nsaspook/wbz451matter/BOM/02-00307-R7_BOM.xls

Sheet: BOM Report
Bill of Materials |  | WBZ451 CURIOSITY BOARD
Document Number: | 02-00307 |  |  |  |  | M
PCB Number: | 04-11423
Part Number: | EV96B94A
Revision: | 7.0
Engineer: | RINU CLEETUS
Drawn By: | BALAJI NARAYANA
Creation Date: | 9/27/2022
Creation Time: | 3:30 PM
Quantity | Designator | Description_ | Manufacturer 1 | Manufacturer Part Number 1 | Supplier 1 | Supplier Part Number 1 | Supplier Unit Price 1 | Price / 1 Board | Populated | Quantity | Quantity Override | Status | MCHP-ID | BOM Notes
27 | C1, C2, C3, C4, C12, C13, C16, C17, C19, C20, C21, C22, C23, C24, C25, C27, C38, C39, C40, C52, C54, C57, C62, C72, C73, C74, C77 | CAP CER 0.1µF 16V 10% X5R SMD 0201 | Murata Electronics North America | GRM033R61C104KE84D | Digi-Key | 490-9985-2-ND |  | $0.0000 | YES | 27 | 1 | MCL Design | CAP1559
0 | C5, C8, C28, C35, C50 | CAP CER 0.1uF 10V 10% X5R SMD 0402 | KEMET | C0402C104K8PACTU | Digi-Key | 399-3027-1-ND |  | $0.0000 | DNP | 0 | 1 | MCL Design | CAP0279
18 | C6, C10, C29, C30, C41, C42, C43, C44, C48, C49, C55, C58, C59, C61, C66, C67, C68, C75 | CAP CER 0.1uF 10V 10% X5R SMD 0402 | KEMET | C0402C104K8PACTU | Digi-Key | 399-3027-1-ND |  | $0.0000 | Yes | 18 | 1 | MCL Design | CAP0279
9 | C7, C14, C15, C26, C34, C37, C46, C53, C79 | CAP CER 4.7uF 10V 10% X5R SMD 0402 | TDK Corporation | C1005X5R1A475K050BC | Digi-Key | 445-13820-1-ND |  | $0.0000 | YES | 9 | 1 | MCL Design | CAP1684
2 | C9, C11 | CAP CER 18pF 50V 2% NP0 SMD 0402 | Murata | GRM1555C1H180GA01D | Digi-Key | 490-6204-6-ND |  | $0.0000 | YES | 2 | 1 | MCL Design | CAP1237
1 | C18 | CAP CER 10000pF 16V 10% X7R SMD 0402 | KEMET | C0402C103K4RACTU | Digi-Key | 399-1038-1-ND |  | $0.0000 | YES | 1 | 1 | MCL Design | CAP0278
2 | C31, C56 | CAP CER 10uF 25V 20% X5R SMD 0603 | TDK Corporation | C1608X5R1E106M080AC | Farnell | 2521968 |  | $0.0000 | YES | 2 | 1 | MCL Design | CAP1650
2 | C32, C33 | CAP CER 4.7uF 16V 10% X5R SMD 0603 | TDK Corporation | C1608X5R1C475K080AC | Digi-Key | 445-7478-1-ND |  | $0.0000 | YES | 2 | 1 | MCL Design | CAP1288
2 | C36, C65 | CAP CER 1000pF 50V 10% X7R SMD 0402 | Murata | GRM155R71H102KA01D | Digi-Key | 490-1303-2-ND |  | $0.0000 | Yes | 2 | 1 | MCL Design | CAP1035
0 | C45, C47, C51, C71 | CAP CER 0.01uF 50V 10% X7R SMD 0402 | TDK Corporation | CGA2B3X7R1H103K050BB | Digi-Key | 445-6893-1-ND |  | $0.0000 | DNP | 0 | 1 | MCL Design | CAP2026
3 | C60, C69, C70 | CAP CER 10000pF 50V 10% X7R SMD 0402 AEC-Q200 | Murata Electronics North America | GCM155R71H103KA55D | Digi-Key | 490-4762-1-ND |  | $0.0000 | YES | 3 | 1 | MCL Design | CAP2026
1 | C63 | CAP CER 10pF 25V 0.5pF C0G SMD 0201 | TDK Corporation | C0603C0G1E100D030BA | Digi-Key | 445-4651-2-ND |  | $0.0000 | YES | 1 | 1 | MCL Design | CAP1453
0 | C64 | CAP CER 10uF 10V X5R SMD 0402 | Samsung Electro-Mechanics | CL05A106MP8NUB8 | Digi-Key | 1276-6830-1-ND |  | $0.0000 | DNP | 0 | 1 | MCL Design | CAP2083
1 | C76 | CAP CER 22uF 16V 10% X5R SMD 0805 | TDK | C2012X5R1C226K125AC | Digi-Key | 445-6797-2-ND |  | $0.0000 | Yes | 1 | 1 | MCL Design | CAP0627
0 | C78 | CAP CER 0.1µF 16V 10% X5R SMD 0201 | Murata Electronics North America | GRM033R61C104KE84D | Digi-Key | 490-9985-2-ND |  | $0.0000 | DNP | 0 | 1 | MCL Design | CAP1559
1 | D1 | DIO LED GREEN 2V 30mA 35mcd Clear SMD 0603 | Lite-On Inc | LTST-C191KGKT | Digi-Key | 160-1446-1-ND |  | $0.0000 | YES | 1 | 1 | MCL Design | DIODE1155
1 | D2 | DIO LED YELLOW 2.1V 20mA 6mcd Clear SMD 0603 | Lite-On | LTST-C190YKT | Digi-Key | 160-1184-2-ND |  | $0.0000 | YES | 1 | 1 | MCL Design | LED1002
1 | D5 | DIO LED BLUE 2.85V 5mA 49.5mcd Diffuse SMD 470nm | OSRAM Opto Semiconductors Inc. | LB QH9G-N1OO-35-1 | Digi-Key | 475-3112-1-ND |  | $0.0000 | YES | 1 | 1 | MCL Design | DIODE1359
1 | D6 | DIO LED TRI 2.2V Red, 3.3V Green, 3.3V Blue 6-SMD | Lite-On Inc. | LTST-G563EGBW | Digi-Key | 160-2228-2-ND |  | $0.0000 | YES | 1 | 1 | MCL Design | LED1106
2 | FB1, FB2 | FERRITE 2A 600R SMD 0805 | TDK Corporation | MPZ2012S601AT000 | Digi-Key | 445-2206-1-ND |  | $0.0000 | YES | 2 | 1 | MCL Design | IND1162
1 | FB3 | FERRITE 2A 220R SMD 0805 | Murata Electronics North America | BLM21PG221SN1D | Digi-Key | 490-1054-1-ND |  | $0.0000 | YES | 1 | 1 | MCL Design | IND1092
0 | J2 | CON HDR-1.27 Male 1x2 Gold TH VERT | Digikey | 952-3598-ND | Digikey | 952-3598-ND |  | $0.0000 | DNP | 0 | 1 | MCL Design | CON1390
1 | J3 | CON HDR-2 Male 1x2 SHROUD 3.3MH TH R/A | JST Sales America Inc. | S2B-PH-K-S(LF)(SN) | Digi-Key | 455-1719-ND |  | $0.0000 | YES | 1 | 1 | MCL Design | CON1718
2 | J4 | SOCKET mikroBUS HOST DIP 16 TH | Sullins Connector Solutions | PPTC081LFBN-RC | Digi-Key | S7006-ND |  | $0.0000 | YES | 1 | 2 | MCL Design | SKT1042
2 | J5, J6 | CON HDR-2.54 Male 1x2 Gold 5.84MH TH VERT | FCI | 77311-118-02LF | Digi-Key | 609-4434-ND |  | $0.0000 | Yes | 2 | 1 | MCL Design | CON1108
1 | J7 | CON USB2.0 MICRO-B FEMALE TH/SMD R/A | FCI | 10118194-0001LF | Digi-Key | 609-4618-1-ND |  | $0.0000 | YES | 1 | 1 | MCL Design | CON1383
0 | J9 | CON STRIP Stacker Male 1x9 TH VERT | Samtec | DWM-09-59-S-S-415 | Samtec | DWM-09-59-S-S-415 |  | $0.0000 | DNP | 0 | 1 | MCL Design | CON0512
1 | J36 | CON HDR-1.27 Male 2x5 Gold 3.05MH TH VERT | Amphenol FCI | 20021111-00010T4LF | Digi-Key | 609-3712-ND |  | $0.0000 | YES | 1 | 1 | MCL Design | CON1497
1 | JP1 | MECH HW JUMPER 2.54mm 1x2 Handle Gold | TE Connectivity | 881545-2 | Digi-Key | A26242-ND |  | $0.0000 | MECH | 1 | 1 | MCL Design | HW1100
1 | LABEL1 | LABEL PCBA 18x6mm Datamatrix Assy# / Rev / Serial / Date | ACT Logimark AS | 505462 | ACT Logimark AS | 505462 |  | $0.0000 | YES | 1 | 1 | MCL Design | 08-10015
1 | LD1 | LED GREEN/RED BICOLOR 0606 | Lite-On Inc | LTST-C195KGJRKT | Digi-Key | 160-1452-1-ND |  | $0.0000 | YES | 1 | 1 | MCL Design | LED1047
2 | PAD1, PAD2 | MECH HW RUBBER PAD Cylindrical flat top D8H2.8 Black | 3M | SJ5076BLACK | Farnell | 1165061 |  | $0.0000 | MECH | 2 | 1 | MCL Design | MECH0087
1 | Q1 | TRANS FET P-CH IRLML6402 -20V -3.7A 1.3W SOT-23-3 | International Rectifier | IRLML6402TRPBF | Digi-Key | IRLML6402PBFTR-ND |  | $0.0000 | YES | 1 | 1 | MCL Design | TRA0048
2 | Q2, Q8 | MCHP ANALOG MOSFET N-CH TN2106 60V 280mA 360mW 2.5R SOT23-3 | Microchip Technology | TN2106K1-G | Microchip Technology | TN2106K1-G |  | $0.0000 | YES | 2 | 1 | MCL Design | MIC7420
0 | Q3 | MCHP ANALOG MOSFET N-CH TN2106 60V 280mA 360mW 2.5R SOT23-3 | Microchip Technology | TN2106K1-G | Microchip Technology | TN2106K1-G |  | $0.0000 | DNP | 0 | 1 | MCL Design | MIC7420
3 | Q4, Q5, Q6 | TRANS BJT NPN DUAL BC847BS,115 45V 100mA 300mW SOT-363 | Nexperia USA Inc. | BC847BS,115 | Digi-Key | 1727-2923-1-ND |  | $0.0000 | YES | 3 | 1 | MCL Design | TRA1377
0 | Q7 | TRANS FET P-CH IRLML6402 -20V -3.7A 1.3W SOT-23-3 | International Rectifier | IRLML6402TRPBF | Digi-Key | IRLML6402PBFTR-ND |  | $0.0000 | DNP | 0 | 1 | MCL Design | TRA0048
6 | R1, R2, R3, R4, R53, R62 | RES TKF 22R 1% 1/20W SMD 0402 | Panasonic Electronic Components | ERJ-2RKF22R0X | Digi-Key | P22.0LCT-ND |  | $0.0000 | YES | 6 | 1 | MCL Design | RES1474
33 | R5, R6, R10, R13, R14, R15, R17, R22, R26, R31, R56, R69, R91, R92, R93, R94, R95, R97, R99, R100, R101, R102, R103, R106, R111, R112, R114, R120, R121, R122, R123, R124, R125 | RES TKF 0R 1/16W SMD 0402 | Yageo | RC0402JR-070RL | Digi-Key | 311-0.0JRCT-ND |  | $0.0000 | Yes | 33 | 1 | MCL Design | RSMT1040
2 | R7, R8 | RES TKF 1.2k 5% 1/16W SMD 0402 | ROHM | MCR01MZPJ122 | Digi-Key | RHM1.2KJCT-ND |  | $0.0000 | Yes | 2 | 1 | MCL Design | RSMT0733
10 | R9, R18, R19, R30, R38, R71, R90, R98, R108, R110 | RES TKF 100k 5% 1/16W SMD 0402 | Yageo | RC0402JR-07100KL | Digi-Key | 311-100KJRCT-ND |  | $0.0000 | YES | 10 | 1 | MCL Design | RES2196
11 | R11, R12, R16, R46, R48, R50, R57, R96, R104, R105, R107 | RES TKF 33R 1% 1/16W SMD 0402 | Rohm Semiconductor | MCR01MRTF33R0 | Digi-Key | RHM33.0CDCT-ND |  | $0.0000 | YES | 11 | 1 | MCL Design | RES1478
4 | R20, R27, R42, R87 | RES TKF 1k 5% 1/16W SMD 0402 | Yageo | RC0402JR-071KL | Digi-Key | 311-1.0KJRTR-ND |  | $0.0000 | YES | 4 | 1 | MCL Design | RES2238
6 | R21, R41, R54, R58, R63, R64 | RES TKF 330R 1% 1/16W SMD 0402 | Yageo | RC0402FR-07330RL | Digi-Key | 311-330LRTR-ND |  | $0.0000 | YES | 6 | 1 | MCL Design | RSMT1100
4 | R23, R24, R39, R89 | RES TKF 4.7k 1% 1/16W SMD 0402 | Yageo | RC0402FR-074K7L | Digi-Key | 311-4.7KLRTR-ND |  | $0.0000 | YES | 4 | 1 | MCL Design | RES1813
0 | R25, R32 | RES TKF 0R 1/16W SMD 0402 | Yageo | RC0402JR-070RL | Digi-Key | 311-0.0JRCT-ND |  | $0.0000 | DNP | 0 | 1 | MCL Design | RSMT1040
12 | R28, R29, R35, R68, R76, R78, R84, R115, R116, R117, R118, R119 | RES TKF 10k 5% 1/16W SMD 0402 | Vishay | CRCW040210K0JNED | Digi-Key | 541-10KJCT-ND |  | $0.0000 | Yes | 12 | 1 | MCL Design | RSMT0439
1 | R33 | RES TKF 31.6k 1% 1/10W SMD 0402 | Panasonic | ERJ-2RKF3162X | Digi-Key | P31.6KLCT-ND |  | $0.0000 | Yes | 1 | 1 | MCL Design | RSMT1018
4 | R34, R60, R72, R74 | RES TKF 47k 5% 1/16W SMD 0402 | Yageo | RC0402JR-0747KL | Digi-Key | 311-47KJRCT-ND |  | $0.0000 | Yes | 4 | 1 | MCL Design | RSMT1039
0 | R36 | RES TKF 1R 1% 1/16W SMD 0402 | Yageo Yageo | RC0402FR-071RL | Digi-Key | 311-1.00LRCT-ND |  | $0.0000 | DNP | 0 | 1 | MCL Design | RES1659
1 | R37 | RES TKF 100R 1% 1/10W SMD 0603 | ROHM | MCR03EZPFX1000 | Digi-Key | RHM100HCT-ND |  | $0.0000 | Yes | 1 | 1 | MCL Design | RSMT0696
0 | R40 | RES TKF 22R 1% 1/20W SMD 0402 | Panasonic Electronic Components | ERJ-2RKF22R0X | Digi-Key | P22.0LCT-ND |  | $0.0000 | DNP | 0 | 1 | MCL Design | RES1474
3 | R43, R44, R45 | RES TKF 22k 5% 1/10W SMD 0402 | Panasonic | ERJ-2GEJ223X | Digi-Key | P22KJCT-ND |  | $0.0000 | Yes | 3 | 1 | MCL Design | RSMT0736
6 | R47, R49, R51, R52, R59, R65 | RES TKF 3.3k 1% 1/10W SMD 0402 | Panasonic - ECG | ERJ-2RKF3301X | Digi-Key | P3.30KLTR-ND |  | $0.0000 | YES | 6 | 1 | MCL Design | RES2130
0 | R55, R86 | RES TKF 10k 5% 1/20W SMD 0201 | Yageo | RC0201JR-0710KL | Digi-Key | 311-10KNCT-ND |  | $0.0000 | DNP | 0 | 1 | MCL Design | RES1767
0 | R61, R66 | RES TKF 4.7k 1% 1/16W SMD 0402 | Yageo | RC0402FR-074K7L | Digi-Key | 311-4.7KLRTR-ND |  | $0.0000 | DNP | 0 | 1 | MCL Design | RES1813
0 | R67 | RES TKF 31.6k 1% 1/10W SMD 0402 | Panasonic | ERJ-2RKF3162X | Digi-Key | P31.6KLCT-ND |  | $0.0000 | DNP | 0 | 1 | MCL Design | RSMT1018
0 | R70, R73 | RES TKF 47k 5% 1/16W SMD 0402 | Yageo | RC0402JR-0747KL | Digi-Key | 311-47KJRCT-ND |  | $0.0000 | DNP | 0 | 1 | MCL Design | RSMT1039
1 | R75 | RES TKF 12k 1% 1/16W SMD 0402 | Rohm Semiconductor | MCR01MZPF1202 | Digi-Key | RHM12.0KLCT-ND |  | $0.0000 | YES | 1 | 1 | MCL Design | RES1021
0 | R77 | RES TKF 10k 5% 1/16W SMD 0402 | Vishay | CRCW040210K0JNED | Digi-Key | 541-10KJCT-ND |  | $0.0000 | DNP | 0 | 1 | MCL Design | RSMT0439
1 | R79 | RES TKF 442k 1% 1/16W SMD 0402 | Samsung Electro-Mechanics America, Inc | RC1005F4423CS | Digi-Key | 1276-4257-2-ND |  | $0.0000 | YES | 1 | 1 | MCL Design | RES1506
1 | R80 | RES TKF 95.3k 1% 1/16W SMD 0402 | Rohm Semiconductor | MCR01MRTF9532 | Digi-Key | RHM95.3KCDCT-ND |  | $0.0000 | YES | 1 | 1 | MCL Design | RES1481
1 | R81 | RES TKF 24.3k 1% 1/16W SMD 0402 | Samsung | RC1005F2432CS | Digi-Key | 1276-4149-1-ND |  | $0.0000 | YES | 1 | 1 | MCL Design | RES1483
2 | R82, R85 | RES TKF 5.62k 1% 1/16W SMD 0402 | Vishay Dale | CRCW04025K62FKED | Digi-Key | 541-5.62KLTR-ND |  | $0.0000 | YES | 2 | 1 | MCL Design | RES1505
1 | R83 | RES TKF 270R 5% 1/10W SMD 0402 | Panasonic | ERJ-2GEJ271X | Digi-Key | P270JTR-ND |  | $0.0000 | YES | 1 | 1 | MCL Design | RES1027
1 | R88 | RES TKF 100R 1% 1/16W SMD 0402 | Yageo | RC0402FR-07100RL | Digi-Key | 311-100LRCT-ND |  | $0.0000 | YES | 1 | 1 | MCL Design | RES1587
0 | R109 | RES TKF 10k 5% 1/10W SMD 0402 | Panasonic | ERJ-2GEJ103X | Digi-Key | P10KJCT-ND |  | $0.0000 | DNP | 0 | 1 | MCL Design | RSMT0735
0 | R113 | RES TKF 100k 1% 1/20W SMD 0201 | Panasonic Electronic Components | ERJ-1GEF1003C | Digi-Key | P100KABCT-ND |  | $0.0000 | DNP | 0 | 1 | MCL Design | RES1582
1 | R126 | RES TKF 0R 1/8W SMD 0805 | Panasonic | ERJ-6GEY0R00V | Digi-Key | P0.0ACT-ND |  | $0.0000 | Yes | 1 | 1 | MCL Design | RES1218
2 | SW1, SW2 | SWITCH TACTILE SPST-NO 32V 0.05A KMR221GLFS | C&K | KMR221GLFS | Digi-Key | 401-1427-1-ND |  | $0.0000 | YES | 2 | 1 | MCL Design | SWITCH1176
7 | U1, U2, U4, U5, U14, U15, U16 | IC VOLTAGE TRANSLATOR BI-DIR 1 CIRCUIT 74LVC1T45FW4-7 X2-DFN1010-6 | Diodes Incorporated | 74LVC1T45FW4-7 | Digi-Key | 74LVC1T45FW4-7DICT-ND |  | $0.0000 | YES | 7 | 1 | MCL Design | IC1665
1 | U3 | MCHP ANALOG TEMPERATURE SENSOR -40C to +150C MCP9700AT-E/TT SOT-23-3 | Microchip | MCP9700AT-E/TT | Microchip | MCP9700AT-E/TT |  | $0.0000 | Yes | 1 | 1 | MCL Design | MIC3211
1 | U6 | MOD BLE/ZIGBEE WBZ451PE-I | Microchip Technology | WBZ451PE-I | Microchip Technology | WBZ451PE-I |  | $0.0000 | YES | 1 | 1 | MCL Design | MIC9365
1 | U7 | MCHP SERIAL FLASH SST26VF064B-104I/MF WDFN-8 | Microchip Technology | SST26VF064B-104I/MF | Digi-Key | SST26VF064B-104I/MF-ND |  | $0.0000 | YES | 1 | 1 | MCL Design | MIC8025
1 | U8 | MCHP MEMORY SERIAL EEPROM 256k I2C 24LC256T-E/ST TSSOP-8 | Microchip Technology | 24LC256T-E/ST | Microchip Technology | 24LC256T-E/ST |  | $0.0000 | Yes | 1 | 1 | MCL Design | MIC1360
0 | U9 | MCHP MEMORY SERIAL EEPROM CRYPTO AUTH I2C ATECC608A-MAHDA-T UDFN-8 | Microchip Technology | ATECC608A-MAHDA-T | Digi-Key | ATECC608A-MAHDA-TCT-ND |  | $0.0000 | DNP | 0 | 1 | MCL Design | MIC8128
1 | U10 | MCHP ANALOG LDO 3V MCP1727T-3002E/MF DFN-8 | Microchip | MCP1727T-3002E/MF | Microchip | MCP1727T-3002E/MF |  | $0.0000 | Yes | 1 | 1 | MCL Design | MIC2626
1 | U11 | IC FILTER EMI2124MTTAG COMMON MODE ESD WDFN-8 | ON Semiconductor | EMI2124MTTAG | Digi-Key | EMI2124MTTAGOSCT-ND |  | $0.0000 | YES | 1 | 1 | MCL Design | IC1879
1 | U12 | MCHP ANALOG BATTERY CHARGER MCP73871-2CCI/ML QFN-20 | Microchip | MCP73871-2CCI/ML | Microchip | MCP73871-2CCI/ML |  | $0.0000 | YES | 1 | 1 | MCL Design | MIC3190
1 | U13 | MCHP ANALOG LDO 3.3V MCP1727-3302E/MF | Microchip Technology | MCP1727-3302E/MF | Microchip Technology | MCP1727-3302E/MF |  | $0.0000 | YES | 1 | 1 | MCL Design | MIC6086
1 | U17 | MCHP INTERFACE USB 2.0 HUB CTRLR USB2512B-I/M2 SQFN-36 | Microchip Technology | USB2512B-I/M2 | Microchip Technology | USB2512B-I/M2 |  | $0.0000 | YES | 1 | 1 | MCL Design | MIC8828
1 | U18 | MCHP INTERFACE USB UART MCP2200-I/MQ QFN-20 | Microchip Technology | MCP2200-I/MQ | Digi-Key | MCP2200-I/MQ-ND |  | $0.0000 | YES | 1 | 1 | MCL Design | MIC6326
1 | U19 | MCHP ANALOG POWER SWITCH 5.5V 3A MIC2042-1YTS TSSOP-14 | Microchip Technology | MIC2042-1YTS | Microchip Technology | MIC2042-1YTS |  | $0.0000 | YES | 1 | 1 | MCL Design | MIC6637
1 | U20 | MCHP MCU 32-BIT 300MHz 2MB 384K x 8 ATSAME70N21B-CNT TFBGA-100 | Microchip Technology | ATSAME70N21B-CNT | Microchip Technology | ATSAME70N21B-CNT |  | $0.0000 | YES | 1 | 1 | MCL Design | MIC8829
1 | X1 | RESONATOR 12MHz 0.07% SMD CSTNE 3-SMD | Murata Electronics | CSTNE12M0GH5L000R0 | Digi-Key | 490-17947-1-ND |  | $0.0000 | YES | 1 | 1 | MCL Design | OSC1232
1 | Y1 | CRYSTAL 32.768kHz 12.5pF SMD ABS07 | Seiko | SC32S-12.5PF20PPM | Digi-Key | 728-1073-1-ND |  | $0.0000 | YES | 1 | 1 | MCL Design | OSC1038
1 | Y2 | MCHP CMOS OSCILLATOR 12MHz DSC6011HI1B-012.0000 SMD VFLGA-4 | Microchip Technology | DSC6011HI1B-012.0000 | Microchip Technology | DSC6011HI1B-012.0000 |  | $0.0000 | YES | 1 | 1 | MCL Design | MIC8831
1 | Y3 | MCHP CMOS OSCILLATOR 24MHz DSC6011HI1B-024.0000 SMD VFLGA-4 | Microchip Technology | DSC6011HI1B-024.0000 | Microchip Technology | DSC6011HI1B-024.0000 |  | $0.0000 | YES | 1 | 1 | MCL Design | MIC8830
Microchip Parts listed below
 |  |  |  |  |  |  |  | $0.0000
 |  |  |  |  |  |  |  | $0.0000
 |  |  |  |  |  |  |  | $0.0000
 |  |  |  |  |  |  |  | $0.0000
Mechanical Parts to be added in the package
 |  |  |  |  |  |  |  | $0.0000
PCB
1 | PCB1 | Printed Circuit Board |  | 04-11423-R4.0 |  |  |  | $0.0000 | PCB | 1 | 1 |  | 04-11423
 |  |  |  |  |  |  |  | $0.0000
Do Not Populate Parts listed below
 |  |  |  |  |  |  |  | $0.0000
Approved | Notes | Description

Sheet: Project Information
Project Full Path | D:\WSGA Global\PCB Layout\Chimera\Chimera_WBZ451_EVB\R7.0\DESIGN FILES\WBZ451 Curiosity Board-R7.PrjPcb
Project Filename | WBZ451 Curiosity Board-R7.PrjPcb
Variant Name | Production Variant
PCB Assy Number | 00307
PCB Number | 11423
Data-Source Filename | WBZ451 Curiosity Board-R7.PrjPcb
Data-Source Full Path | D:\WSGA Global\PCB Layout\Chimera\Chimera_WBZ451_EVB\R7.0\DESIGN FILES\WBZ451 Curiosity Board-R7.PrjPcb
Title | WBZ451 CURIOSITY BOARD
Total Quantity | 229
Report Time | 3:30 PM
Report Date | 9/27/2022
Report Date & Tine | 9/27/2022 3:30 PM
Output Name | Bill of Materials
Output Type | BomReport
Output Generator Name | BOM
Output Generator Description | Bill of Materials
PCB Label Number | <Parameter ProjectBoardLabel not found>
Part Number | EV96B94A
SCH Revision | 7.0
ART Revision | 4.0
ASM Revision | 6.0
FAB Revision | 4.0

Sheet: MCL Report
DesignItemId | Quantity | Designator | Populated | Fitted | Description_ | Value | Status | Library Name | PartType | Footprint | MCL Library Ref | MCL Footprint Ref | CurrentDate | Manufacturer 1 | Manufacturer 2 | Manufacturer 3 | Manufacturer 4 | Manufacturer 5 | Manufacturer 6 | Manufacturer 7 | Manufacturer 8 | Manufacturer 9 | #Column Name Error:' Manufacturer 10 | Manufacturer Part Number 1 | Manufacturer Part Number 2 | Manufacturer Part Number 3 | Manufacturer Part Number 4 | Manufacturer Part Number 5 | Manufacturer Part Number 6 | Manufacturer Part Number 7 | Manufacturer Part Number 8 | Manufacturer Part Number 9 | #Column Name Error:' Manufacturer Part Number 10 | Supplier 1 | Supplier 2 | Supplier 3 | Supplier 4 | Supplier 5 | Supplier 6 | Supplier 7 | Supplier 8 | Supplier 9 | #Column Name Error:' Supplier 10 | Supplier Part Number 1 | Supplier Part Number 2 | Supplier Part Number 3 | Supplier Part Number 4 | Supplier Part Number 5 | Supplier Part Number 6 | Supplier Part Number 7 | Supplier Part Number 8 | Supplier Part Number 9 | #Column Name Error:' Supplier Part Number 10 | Supplier Unit Price 1 | Supplier Unit Price 2 | Supplier Unit Price 3 | Supplier Unit Price 4 | Supplier Unit Price 5 | Supplier Unit Price 6
CAP1559 | 27 | C1, C2, C3, C4, C12, C13, C16, C17, C19, C20, C21, C22, C23, C24, C25, C27, C38, C39, C40, C52, C54, C57, C62, C72, C73, C74, C77 | YES | Fitted | CAP CER 0.1µF 16V 10% X5R SMD 0201 | 0.1uF | MCL Design | MCHP-CDB.DbLib | Capacitor NP | CAP_C_0201 |  |  | 9/27/2022 | Murata Electronics North America |  |  |  |  |  |  |  |  |  | GRM033R61C104KE84D |  |  |  |  |  |  |  |  |  | Digi-Key |  |  |  |  |  |  |  |  |  | 490-9985-2-ND
CAP0279 | 0 | C5, C8, C28, C35, C50 | DNP | Not Fitted | CAP CER 0.1uF 10V 10% X5R SMD 0402 | 0.1uF | MCL Design | MCHP-CDB.DbLib | Capacitor NP | CAP_C_0402 |  |  | 9/27/2022 | KEMET | Murata | KEMET |  |  |  |  |  |  |  | C0402C104K8PACTU | GRM155R61A104KA01D | C0402C104K8PAC |  |  |  |  |  |  |  | Digi-Key | Digi-Key | KEMET |  |  |  |  |  |  |  | 399-3027-1-ND | 490-1318-2-ND | C0402C104K8PAC
CAP0279 | 18 | C6, C10, C29, C30, C41, C42, C43, C44, C48, C49, C55, C58, C59, C61, C66, C67, C68, C75 | Yes | Fitted | CAP CER 0.1uF 10V 10% X5R SMD 0402 | 0.1uF | MCL Design | MCHP-CDB.DbLib | Capacitor NP | CAP_C_0402 |  |  | 9/27/2022 | KEMET | Murata | KEMET |  |  |  |  |  |  |  | C0402C104K8PACTU | GRM155R61A104KA01D | C0402C104K8PAC |  |  |  |  |  |  |  | Digi-Key | Digi-Key | KEMET |  |  |  |  |  |  |  | 399-3027-1-ND | 490-1318-2-ND | C0402C104K8PAC
CAP1684 | 9 | C7, C14, C15, C26, C34, C37, C46, C53, C79 | YES | Fitted | CAP CER 4.7uF 10V 10% X5R SMD 0402 | 4.7uF | MCL Design | MCHP-CDB.DbLib | Capacitor NP | CAP_C_0402 |  |  | 9/27/2022 | TDK Corporation |  |  |  |  |  |  |  |  |  | C1005X5R1A475K050BC |  |  |  |  |  |  |  |  |  | Digi-Key |  |  |  |  |  |  |  |  |  | 445-13820-1-ND
CAP1237 | 2 | C9, C11 | YES | Fitted | CAP CER 18pF 50V 2% NP0 SMD 0402 | 18pF | MCL Design | MCHP-CDB.DbLib | Capacitor NP | CAP_C_0402 |  |  | 9/27/2022 | Murata |  |  |  |  |  |  |  |  |  | GRM1555C1H180GA01D |  |  |  |  |  |  |  |  |  | Digi-Key |  |  |  |  |  |  |  |  |  | 490-6204-6-ND
CAP0278 | 1 | C18 | YES | Fitted | CAP CER 10000pF 16V 10% X7R SMD 0402 | 10000pF | MCL Design | MCHP-CDB.DbLib | Capacitor NP | CAP_C_0402 |  |  | 9/27/2022 | KEMET | KEMET |  |  |  |  |  |  |  |  | C0402C103K4RACTU | C0402C103K4RAC |  |  |  |  |  |  |  |  | Digi-Key | KEMET |  |  |  |  |  |  |  |  | 399-1038-1-ND | C0402C103K4RAC
CAP1650 | 2 | C31, C56 | YES | Fitted | CAP CER 10uF 25V 20% X5R SMD 0603 | 10uF | MCL Design | MCHP-CDB.DbLib | Capacitor NP | CAP_C_0603 |  |  | 9/27/2022 | TDK Corporation |  |  |  |  |  |  |  |  |  | C1608X5R1E106M080AC |  |  |  |  |  |  |  |  |  | Farnell |  |  |  |  |  |  |  |  |  | 2521968
CAP1288 | 2 | C32, C33 | YES | Fitted | CAP CER 4.7uF 16V 10% X5R SMD 0603 | 4.7uF | MCL Design | MCHP-CDB.DbLib | Capacitor NP | CAP_C_0603 |  |  | 9/27/2022 | TDK Corporation |  |  |  |  |  |  |  |  |  | C1608X5R1C475K080AC |  |  |  |  |  |  |  |  |  | Digi-Key |  |  |  |  |  |  |  |  |  | 445-7478-1-ND
CAP1035 | 2 | C36, C65 | Yes | Fitted | CAP CER 1000pF 50V 10% X7R SMD 0402 | 1000pF | MCL Design | MCHP-CDB.DbLib | Capacitor NP | CAP_C_0402 |  |  | 9/27/2022 | Murata |  |  |  |  |  |  |  |  |  | GRM155R71H102KA01D |  |  |  |  |  |  |  |  |  | Digi-Key |  |  |  |  |  |  |  |  |  | 490-1303-2-ND
CAP2026 | 0 | C45, C47, C51, C71 | DNP | Not Fitted | CAP CER 0.01uF 50V 10% X7R SMD 0402 | 0.01uF | MCL Design | MCHP-CDB.DbLib | Capacitor NP | CAP_C_0402 |  |  | 9/27/2022 | TDK Corporation |  |  |  |  |  |  |  |  |  | CGA2B3X7R1H103K050BB |  |  |  |  |  |  |  |  |  | Digi-Key |  |  |  |  |  |  |  |  |  | 445-6893-1-ND
CAP2026 | 3 | C60, C69, C70 | YES | Fitted | CAP CER 10000pF 50V 10% X7R SMD 0402 AEC-Q200 | 10000pF | MCL Design | MCHP-CDB.DbLib | Capacitor NP | CAP_C_0402 |  |  | 9/27/2022 | Murata Electronics North America | TDK Corporation |  |  |  |  |  |  |  |  | GCM155R71H103KA55D | CGA2B3X7R1H103K050BB |  |  |  |  |  |  |  |  | Digi-Key | Digi-Key |  |  |  |  |  |  |  |  | 490-4762-1-ND | 445-6893-1-ND
CAP1453 | 1 | C63 | YES | Fitted | CAP CER 10pF 25V 0.5pF C0G SMD 0201 | 10pF | MCL Design | MCHP-CDB.DbLib | Capacitor NP | CAP_C_0201 |  |  | 9/27/2022 | TDK Corporation |  |  |  |  |  |  |  |  |  | C0603C0G1E100D030BA |  |  |  |  |  |  |  |  |  | Digi-Key |  |  |  |  |  |  |  |  |  | 445-4651-2-ND
CAP2083 | 0 | C64 | DNP | Not Fitted | CAP CER 10uF 10V X5R SMD 0402 | 10uF | MCL Design | MCHP-CDB.DbLib | Capacitor NP | CAP_C_0402 |  |  | 9/27/2022 | Samsung Electro-Mechanics |  |  |  |  |  |  |  |  |  | CL05A106MP8NUB8 |  |  |  |  |  |  |  |  |  | Digi-Key |  |  |  |  |  |  |  |  |  | 1276-6830-1-ND
CAP0627 | 1 | C76 | Yes | Fitted | CAP CER 22uF 16V 10% X5R SMD 0805 | 22uF | MCL Design | MCHP-CDB.DbLib | Capacitor NP | CAP_C_0805 |  |  | 9/27/2022 | TDK |  |  |  |  |  |  |  |  |  | C2012X5R1C226K125AC |  |  |  |  |  |  |  |  |  | Digi-Key |  |  |  |  |  |  |  |  |  | 445-6797-2-ND
CAP1559 | 0 | C78 | DNP | Not Fitted | CAP CER 0.1µF 16V 10% X5R SMD 0201 | 0.1uF | MCL Design | MCHP-CDB.DbLib | Capacitor NP | CAP_C_0201 |  |  | 9/27/2022 | Murata Electronics North America |  |  |  |  |  |  |  |  |  | GRM033R61C104KE84D |  |  |  |  |  |  |  |  |  | Digi-Key |  |  |  |  |  |  |  |  |  | 490-9985-2-ND
DIODE1155 | 1 | D1 | YES | Fitted | DIO LED GREEN 2V 30mA 35mcd Clear SMD 0603 | GREEN | MCL Design | MCHP-CDB.DbLib | LED_green | LED_0603_GREEN |  |  | 9/27/2022 | Lite-On Inc | Ledtech |  |  |  |  |  |  |  |  | LTST-C191KGKT | LT8A23-54-SB96-T5 |  |  |  |  |  |  |  |  | Digi-Key | Raynen |  |  |  |  |  |  |  |  | 160-1446-1-ND | LEDD00036B01
LED1002 | 1 | D2 | YES | Fitted | DIO LED YELLOW 2.1V 20mA 6mcd Clear SMD 0603 | YELLOW | MCL Design | MCHP-CDB.DbLib | LED_yellow | LED_0603_Yellow |  |  | 9/27/2022 | Lite-On |  |  |  |  |  |  |  |  |  | LTST-C190YKT |  |  |  |  |  |  |  |  |  | Digi-Key |  |  |  |  |  |  |  |  |  | 160-1184-2-ND
DIODE1359 | 1 | D5 | YES | Fitted | DIO LED BLUE 2.85V 5mA 49.5mcd Diffuse SMD 470nm | Blue | MCL Design | MCHP-CDB.DbLib | LED_blue | LED_0402_Blue |  |  | 9/27/2022 | OSRAM Opto Semiconductors Inc. |  |  |  |  |  |  |  |  |  | LB QH9G-N1OO-35-1 |  |  |  |  |  |  |  |  |  | Digi-Key |  |  |  |  |  |  |  |  |  | 475-3112-1-ND
LED1106 | 1 | D6 | YES | Fitted | DIO LED TRI 2.2V Red, 3.3V Green, 3.3V Blue 6-SMD | LTST-G563EGBW | MCL Design | MCHP-CDB.DbLib | LED_TRI_LTST-G563EGBW | LED_Lite-On Inc_LTST-G563EGBW |  |  | 9/27/2022 | Lite-On Inc. |  |  |  |  |  |  |  |  |  | LTST-G563EGBW |  |  |  |  |  |  |  |  |  | Digi-Key |  |  |  |  |  |  |  |  |  | 160-2228-2-ND
IND1162 | 2 | FB1, FB2 | YES | Fitted | FERRITE 2A 600R SMD 0805 | 600R | MCL Design | MCHP-CDB.DbLib | Ferrite Bead | IND_C_0805 |  |  | 9/27/2022 | TDK Corporation |  |  |  |  |  |  |  |  |  | MPZ2012S601AT000 |  |  |  |  |  |  |  |  |  | Digi-Key |  |  |  |  |  |  |  |  |  | 445-2206-1-ND
IND1092 | 1 | FB3 | YES | Fitted | FERRITE 2A 220R SMD 0805 | 220R | MCL Design | MCHP-CDB.DbLib | Ferrite Bead | IND_C_0805 |  |  | 9/27/2022 | Murata Electronics North America |  |  |  |  |  |  |  |  |  | BLM21PG221SN1D |  |  |  |  |  |  |  |  |  | Digi-Key |  |  |  |  |  |  |  |  |  | 490-1054-1-ND
CON1390 | 0 | J2 | DNP | Not Fitted | CON HDR-1.27 Male 1x2 Gold TH VERT | HDR-1.27 Male 1x2 | MCL Design | MCHP-CDB.DbLib | Header 1x2 | HDR_M_1.27_1x2_TH_GRPB021VWVN-RC |  |  | 9/27/2022 | Digikey |  |  |  |  |  |  |  |  |  | 952-3598-ND |  |  |  |  |  |  |  |  |  | Digikey |  |  |  |  |  |  |  |  |  | 952-3598-ND
CON1718 | 1 | J3 | YES | Fitted | CON HDR-2 Male 1x2 SHROUD 3.3MH TH R/A | HDR-2 Male 1x2 | MCL Design | MCHP-CDB.DbLib | Header 1x2 | HDR_M_2_1X2_THT_RA_S2B-PH-K-S |  |  | 9/27/2022 | JST Sales America Inc. |  |  |  |  |  |  |  |  |  | S2B-PH-K-S(LF)(SN) |  |  |  |  |  |  |  |  |  | Digi-Key |  |  |  |  |  |  |  |  |  | 455-1719-ND
SKT1042 | 1 | J4 | YES | Fitted | SOCKET mikroBUS HOST DIP 16 TH | mikroBUS HOST | MCL Design | MCHP-CDB.DbLib | SOCKET mikroBUS HOST | SOCKET_mikroBUS_F_2.54_2x8_V_25.4x21 |  |  | 9/27/2022 | Sullins Connector Solutions | Nextron |  |  |  |  |  |  |  |  | PPTC081LFBN-RC | R-212-0810-0071-000 |  |  |  |  |  |  |  |  | Digi-Key | Raynen |  |  |  |  |  |  |  |  | S7006-ND | Nextron R-212-0810-0071-000
CON1108 | 2 | J5, J6 | Yes | Fitted | CON HDR-2.54 Male 1x2 Gold 5.84MH TH VERT | HDR-2.54 Male 1x2 | MCL Design | MCHP-CDB.DbLib | Header 1x2 | HDR_M_2.54_1x2 |  |  | 9/27/2022 | FCI | FCI | FCI | Samtec | Sullins | SPC Technology | Samtec | Nextron | Samtec |  | 77311-118-02LF | 68001-202HLF | 68000-202HLF | TSW-102-07-G-S | PBC02SAAN | SPC20481 | TSW-102-07-F-S | R-211-0211-0021-000 | TSW-102-07-S-S |  | Digi-Key | Digi-Key | Digi-Key | Digi-Key | Digi-Key | Newark | Newark | Raynen | Samtec |  | 609-4434-ND | 609-3469-ND | 609-3502-ND | SAM1029-02-ND | S1011E-02-ND | 93K5734 | 79P3146 | R-211-0211-0021-000 | TSW-102-07-S-S
CON1383 | 1 | J7 | YES | Fitted | CON USB2.0 MICRO-B FEMALE TH/SMD R/A | USB2.0 MICRO-B FEMALE | MCL Design | MCHP-CDB.DbLib | CON USB2.0 Mini_Micro | CON_USB_Micro-AB_SMD_TH_RA_FCI_10118194-0001LF |  |  | 9/27/2022 | FCI | YangMing |  |  |  |  |  |  |  |  | 10118194-0001LF | YM-02-363-N05F |  |  |  |  |  |  |  |  | Digi-Key | Raynen |  |  |  |  |  |  |  |  | 609-4618-1-ND | YangMing YM-02-363-N05F
CON0512 | 0 | J9 | DNP | Not Fitted | CON STRIP Stacker Male 1x9 TH VERT | Test Point Array 1x9 | MCL Design | MCHP-CDB.DbLib | Header 1x9 | HDR_M_1.27_1x9 |  |  | 9/27/2022 | Samtec |  |  |  |  |  |  |  |  |  | DWM-09-59-S-S-415 |  |  |  |  |  |  |  |  |  | Samtec |  |  |  |  |  |  |  |  |  | DWM-09-59-S-S-415
CON1497 | 1 | J36 | YES | Fitted | CON HDR-1.27 Male 2x5 Gold 3.05MH TH VERT | HDR-1.27 Male 2x5 | MCL Design | MCHP-CDB.DbLib | Header 2x5 | HDR_M_1.27_2x5_TH_V_FCI_20021111-00010T4LF |  |  | 9/27/2022 | Amphenol FCI |  |  |  |  |  |  |  |  |  | 20021111-00010T4LF |  |  |  |  |  |  |  |  |  | Digi-Key |  |  |  |  |  |  |  |  |  | 609-3712-ND
HW1100 | 1 | JP1 | MECH | Fitted | MECH HW JUMPER 2.54mm 1x2 Handle Gold | Shunt 2.54mm 1x2 Handle | MCL Design | MCHP-CDB.DbLib | Jumper Mechanical | Jumper_W_Handle_Mechanical |  |  | 9/27/2022 | TE Connectivity | WCON |  |  |  |  |  |  |  |  | 881545-2 | 3730-1301OS0B01 |  |  |  |  |  |  |  |  | Digi-Key | Raynen |  |  |  |  |  |  |  |  | A26242-ND | CONN00060D01M
08-10015 | 1 | LABEL1 | YES | Fitted | LABEL PCBA 18x6mm Datamatrix Assy# / Rev / Serial / Date | PCBA LABEL 18X6mm | MCL Design | MCHP-CDB.DbLib | 08-10015 | 08-10015 |  |  | 9/27/2022 | ACT Logimark AS | MicrochipTechnology Inc | Sunrise Paper (M) Sdn Bhd |  |  |  |  |  |  |  | 505462 | 01000-004967 | 037268-5 |  |  |  |  |  |  |  | ACT Logimark AS | MicrochipTechnology Inc | Sunrise Paper (M) Sdn Bhd |  |  |  |  |  |  |  | 505462 | 01000-004967 | 037268-5
LED1047 | 1 | LD1 | YES | Fitted | LED GREEN/RED BICOLOR 0606 | RED, GREEN | MCL Design | MCHP-CDB.DbLib | LED DUAL R_G 0606 | LED_0606_Green-Red_Bicolor |  |  | 9/27/2022 | Lite-On Inc |  |  |  |  |  |  |  |  |  | LTST-C195KGJRKT |  |  |  |  |  |  |  |  |  | Digi-Key |  |  |  |  |  |  |  |  |  | 160-1452-1-ND
MECH0087 | 2 | PAD1, PAD2 | MECH | Fitted | MECH HW RUBBER PAD Cylindrical flat top D8H2.8 Black | RUBBER PAD D8H2.8 | MCL Design | MCHP-CDB.DbLib | Rubber Pad Cylindrical Taper | BUMP_3M_SJ5076_CYLINDRICAL_BLACK_D8H2.8 |  |  | 9/27/2022 | 3M |  |  |  |  |  |  |  |  |  | SJ5076BLACK |  |  |  |  |  |  |  |  |  | Farnell | Newark |  |  |  |  |  |  |  |  | 1165061 | 23M7324
TRA0048 | 1 | Q1 | YES | Fitted | TRANS FET P-CH IRLML6402 -20V -3.7A 1.3W SOT-23-3 | IRLML6402 | MCL Design | MCHP-CDB.DbLib | Transistor MOS-P GSD | SOT-23-3 |  |  | 9/27/2022 | International Rectifier | International Rectifier |  |  |  |  |  |  |  |  | IRLML6402TRPBF | IRLML6402TR |  |  |  |  |  |  |  |  | Digi-Key | Digi-Key |  |  |  |  |  |  |  |  | IRLML6402PBFTR-ND | IRLML6402TR-ND
MIC7420 | 2 | Q2, Q8 | YES | Fitted | MCHP ANALOG MOSFET N-CH TN2106 60V 280mA 360mW 2.5R SOT23-3 | TN2106 | MCL Design | MCHP-CDB.DbLib | Transistor MOS-N GSD | SOT-23-3 |  |  | 9/27/2022 | Microchip Technology |  |  |  |  |  |  |  |  |  | TN2106K1-G |  |  |  |  |  |  |  |  |  | Microchip Technology |  |  |  |  |  |  |  |  |  | TN2106K1-G
MIC7420 | 0 | Q3 | DNP | Not Fitted | MCHP ANALOG MOSFET N-CH TN2106 60V 280mA 360mW 2.5R SOT23-3 | TN2106 | MCL Design | MCHP-CDB.DbLib | Transistor MOS-N GSD | SOT-23-3 |  |  | 9/27/2022 | Microchip Technology |  |  |  |  |  |  |  |  |  | TN2106K1-G |  |  |  |  |  |  |  |  |  | Microchip Technology |  |  |  |  |  |  |  |  |  | TN2106K1-G
TRA1377 | 3 | Q4, Q5, Q6 | YES | Fitted | TRANS BJT NPN DUAL BC847BS,115 45V 100mA 300mW SOT-363 | BC847BS,115 | MCL Design | MCHP-CDB.DbLib | Transistor Dual NPN | SOT-363 |  |  | 9/27/2022 | Nexperia USA Inc. |  |  |  |  |  |  |  |  |  | BC847BS,115 |  |  |  |  |  |  |  |  |  | Digi-Key |  |  |  |  |  |  |  |  |  | 1727-2923-1-ND
TRA0048 | 0 | Q7 | DNP | Not Fitted | TRANS FET P-CH IRLML6402 -20V -3.7A 1.3W SOT-23-3 | IRLML6402 | MCL Design | MCHP-CDB.DbLib | Transistor MOS-P GSD | SOT-23-3 |  |  | 9/27/2022 | International Rectifier | International Rectifier |  |  |  |  |  |  |  |  | IRLML6402TRPBF | IRLML6402TR |  |  |  |  |  |  |  |  | Digi-Key | Digi-Key |  |  |  |  |  |  |  |  | IRLML6402PBFTR-ND | IRLML6402TR-ND
RES1474 | 6 | R1, R2, R3, R4, R53, R62 | YES | Fitted | RES TKF 22R 1% 1/20W SMD 0402 | 22R | MCL Design | MCHP-CDB.DbLib | Resistor | RES_C_0402 |  |  | 9/27/2022 | Panasonic Electronic Components |  |  |  |  |  |  |  |  |  | ERJ-2RKF22R0X |  |  |  |  |  |  |  |  |  | Digi-Key |  |  |  |  |  |  |  |  |  | P22.0LCT-ND
RSMT1040 | 33 | R5, R6, R10, R13, R14, R15, R17, R22, R26, R31, R56, R69, R91, R92, R93, R94, R95, R97, R99, R100, R101, R102, R103, R106, R111, R112, R114, R120, R121, R122, R123, R124, R125 | Yes | Fitted | RES TKF 0R 1/16W SMD 0402 | 0R | MCL Design | MCHP-CDB.DbLib | Resistor | RES_C_0402 |  |  | 9/27/2022 | Yageo |  |  |  |  |  |  |  |  |  | RC0402JR-070RL |  |  |  |  |  |  |  |  |  | Digi-Key |  |  |  |  |  |  |  |  |  | 311-0.0JRCT-ND
RSMT0733 | 2 | R7, R8 | Yes | Fitted | RES TKF 1.2k 5% 1/16W SMD 0402 | 1.2k | MCL Design | MCHP-CDB.DbLib | Resistor | RES_C_0402 |  |  | 9/27/2022 | ROHM |  |  |  |  |  |  |  |  |  | MCR01MZPJ122 |  |  |  |  |  |  |  |  |  | Digi-Key |  |  |  |  |  |  |  |  |  | RHM1.2KJCT-ND
RES2196 | 10 | R9, R18, R19, R30, R38, R71, R90, R98, R108, R110 | YES | Fitted | RES TKF 100k 5% 1/16W SMD 0402 | 100k | MCL Design | MCHP-CDB.DbLib | Resistor | RES_C_0402 |  |  | 9/27/2022 | Yageo |  |  |  |  |  |  |  |  |  | RC0402JR-07100KL |  |  |  |  |  |  |  |  |  | Digi-Key |  |  |  |  |  |  |  |  |  | 311-100KJRCT-ND
RES1478 | 11 | R11, R12, R16, R46, R48, R50, R57, R96, R104, R105, R107 | YES | Fitted | RES TKF 33R 1% 1/16W SMD 0402 | 33R | MCL Design | MCHP-CDB.DbLib | Resistor | RES_C_0402 |  |  | 9/27/2022 | Rohm Semiconductor |  |  |  |  |  |  |  |  |  | MCR01MRTF33R0 |  |  |  |  |  |  |  |  |  | Digi-Key |  |  |  |  |  |  |  |  |  | RHM33.0CDCT-ND
RES2238 | 4 | R20, R27, R42, R87 | YES | Fitted | RES TKF 1k 5% 1/16W SMD 0402 | 1k | MCL Design | MCHP-CDB.DbLib | Resistor | RES_C_0402 |  |  | 9/27/2022 | Yageo |  |  |  |  |  |  |  |  |  | RC0402JR-071KL |  |  |  |  |  |  |  |  |  | Digi-Key |  |  |  |  |  |  |  |  |  | 311-1.0KJRTR-ND
RSMT1100 | 6 | R21, R41, R54, R58, R63, R64 | YES | Fitted | RES TKF 330R 1% 1/16W SMD 0402 | 330R | MCL Design | MCHP-CDB.DbLib | Resistor | RES_C_0402 |  |  | 9/27/2022 | Yageo | Yageo |  |  |  |  |  |  |  |  | RC0402FR-07330RL | RC0402FR-07330RL |  |  |  |  |  |  |  |  | Digi-Key | Digi-Key |  |  |  |  |  |  |  |  | 311-330LRTR-ND | 311-330LRCT-ND
RES1813 | 4 | R23, R24, R39, R89 | YES | Fitted | RES TKF 4.7k 1% 1/16W SMD 0402 | 4.7k | MCL Design | MCHP-CDB.DbLib | Resistor | RES_C_0402 |  |  | 9/27/2022 | Yageo |  |  |  |  |  |  |  |  |  | RC0402FR-074K7L |  |  |  |  |  |  |  |  |  | Digi-Key | Digi-Key |  |  |  |  |  |  |  |  | 311-4.7KLRTR-ND | 311-4.7KLRCT-ND
RSMT1040 | 0 | R25, R32 | DNP | Not Fitted | RES TKF 0R 1/16W SMD 0402 | 0R | MCL Design | MCHP-CDB.DbLib | Resistor | RES_C_0402 |  |  | 9/27/2022 | Yageo |  |  |  |  |  |  |  |  |  | RC0402JR-070RL |  |  |  |  |  |  |  |  |  | Digi-Key |  |  |  |  |  |  |  |  |  | 311-0.0JRCT-ND
RSMT0439 | 12 | R28, R29, R35, R68, R76, R78, R84, R115, R116, R117, R118, R119 | Yes | Fitted | RES TKF 10k 5% 1/16W SMD 0402 | 10k | MCL Design | MCHP-CDB.DbLib | Resistor | RES_C_0402 |  |  | 9/27/2022 | Vishay | Yageo |  |  |  |  |  |  |  |  | CRCW040210K0JNED | RC0402JR-0710KL |  |  |  |  |  |  |  |  | Digi-Key | Digi-Key |  |  |  |  |  |  |  |  | 541-10KJCT-ND | 311-10KJRCT-ND
RSMT1018 | 1 | R33 | Yes | Fitted | RES TKF 31.6k 1% 1/10W SMD 0402 | 31.6k | MCL Design | MCHP-CDB.DbLib | Resistor | RES_C_0402 |  |  | 9/27/2022 | Panasonic |  |  |  |  |  |  |  |  |  | ERJ-2RKF3162X |  |  |  |  |  |  |  |  |  | Digi-Key |  |  |  |  |  |  |  |  |  | P31.6KLCT-ND
RSMT1039 | 4 | R34, R60, R72, R74 | Yes | Fitted | RES TKF 47k 5% 1/16W SMD 0402 | 47k | MCL Design | MCHP-CDB.DbLib | Resistor | RES_C_0402 |  |  | 9/27/2022 | Yageo |  |  |  |  |  |  |  |  |  | RC0402JR-0747KL |  |  |  |  |  |  |  |  |  | Digi-Key |  |  |  |  |  |  |  |  |  | 311-47KJRCT-ND
RES1659 | 0 | R36 | DNP | Not Fitted | RES TKF 1R 1% 1/16W SMD 0402 | 1R | MCL Design | MCHP-CDB-Offline.DbLib | Resistor | RES_C_0402 |  |  | 9/27/2022 | Yageo Yageo |  |  |  |  |  |  |  |  |  | RC0402FR-071RL |  |  |  |  |  |  |  |  |  | Digi-Key |  |  |  |  |  |  |  |  |  | 311-1.00LRCT-ND
RSMT0696 | 1 | R37 | Yes | Fitted | RES TKF 100R 1% 1/10W SMD 0603 | 100R | MCL Design | MCHP-CDB.DbLib | Resistor | RES_C_0603 |  |  | 9/27/2022 | ROHM | Stackpole Electronics Inc |  |  |  |  |  |  |  |  | MCR03EZPFX1000 | RMCF0603FT100R |  |  |  |  |  |  |  |  | Digi-Key | Digi-Key |  |  |  |  |  |  |  |  | RHM100HCT-ND | RMCF1/16100FRCT-ND
RES1474 | 0 | R40 | DNP | Not Fitted | RES TKF 22R 1% 1/20W SMD 0402 | 22R | MCL Design | MCHP-CDB.DbLib | Resistor | RES_C_0402 |  |  | 9/27/2022 | Panasonic Electronic Components |  |  |  |  |  |  |  |  |  | ERJ-2RKF22R0X |  |  |  |  |  |  |  |  |  | Digi-Key |  |  |  |  |  |  |  |  |  | P22.0LCT-ND
RSMT0736 | 3 | R43, R44, R45 | Yes | Fitted | RES TKF 22k 5% 1/10W SMD 0402 | 22k | MCL Design | MCHP-CDB.DbLib | Resistor | RES_C_0402 |  |  | 9/27/2022 | Panasonic |  |  |  |  |  |  |  |  |  | ERJ-2GEJ223X |  |  |  |  |  |  |  |  |  | Digi-Key |  |  |  |  |  |  |  |  |  | P22KJCT-ND
RES2130 | 6 | R47, R49, R51, R52, R59, R65 | YES | Fitted | RES TKF 3.3k 1% 1/10W SMD 0402 | 3.3k | MCL Design | MCHP-CDB.DbLib | Resistor | RES_C_0402 |  |  | 9/27/2022 | Panasonic - ECG |  |  |  |  |  |  |  |  |  | ERJ-2RKF3301X |  |  |  |  |  |  |  |  |  | Digi-Key |  |  |  |  |  |  |  |  |  | P3.30KLTR-ND
RES1767 | 0 | R55, R86 | DNP | Not Fitted | RES TKF 10k 5% 1/20W SMD 0201 | 10k | MCL Design | MCHP-CDB.DbLib | Resistor | RES_C_0201 |  |  | 9/27/2022 | Yageo |  |  |  |  |  |  |  |  |  | RC0201JR-0710KL |  |  |  |  |  |  |  |  |  | Digi-Key |  |  |  |  |  |  |  |  |  | 311-10KNCT-ND
RES1813 | 0 | R61, R66 | DNP | Not Fitted | RES TKF 4.7k 1% 1/16W SMD 0402 | 4.7k | MCL Design | MCHP-CDB.DbLib | Resistor | RES_C_0402 |  |  | 9/27/2022 | Yageo |  |  |  |  |  |  |  |  |  | RC0402FR-074K7L |  |  |  |  |  |  |  |  |  | Digi-Key | Digi-Key |  |  |  |  |  |  |  |  | 311-4.7KLRTR-ND | 311-4.7KLRCT-ND
RSMT1018 | 0 | R67 | DNP | Not Fitted | RES TKF 31.6k 1% 1/10W SMD 0402 | 31.6k | MCL Design | MCHP-CDB.DbLib | Resistor | RES_C_0402 |  |  | 9/27/2022 | Panasonic |  |  |  |  |  |  |  |  |  | ERJ-2RKF3162X |  |  |  |  |  |  |  |  |  | Digi-Key |  |  |  |  |  |  |  |  |  | P31.6KLCT-ND
RSMT1039 | 0 | R70, R73 | DNP | Not Fitted | RES TKF 47k 5% 1/16W SMD 0402 | 47k | MCL Design | MCHP-CDB.DbLib | Resistor | RES_C_0402 |  |  | 9/27/2022 | Yageo |  |  |  |  |  |  |  |  |  | RC0402JR-0747KL |  |  |  |  |  |  |  |  |  | Digi-Key |  |  |  |  |  |  |  |  |  | 311-47KJRCT-ND
RES1021 | 1 | R75 | YES | Fitted | RES TKF 12k 1% 1/16W SMD 0402 | 12k | MCL Design | MCHP-CDB.DbLib | Resistor | RES_C_0402 |  |  | 9/27/2022 | Rohm Semiconductor |  |  |  |  |  |  |  |  |  | MCR01MZPF1202 |  |  |  |  |  |  |  |  |  | Digi-Key |  |  |  |  |  |  |  |  |  | RHM12.0KLCT-ND
RSMT0439 | 0 | R77 | DNP | Not Fitted | RES TKF 10k 5% 1/16W SMD 0402 | 10k | MCL Design | MCHP-CDB.DbLib | Resistor | RES_C_0402 |  |  | 9/27/2022 | Vishay | Yageo |  |  |  |  |  |  |  |  | CRCW040210K0JNED | RC0402JR-0710KL |  |  |  |  |  |  |  |  | Digi-Key | Digi-Key |  |  |  |  |  |  |  |  | 541-10KJCT-ND | 311-10KJRCT-ND
RES1506 | 1 | R79 | YES | Fitted | RES TKF 442k 1% 1/16W SMD 0402 | 442k | MCL Design | MCHP-CDB.DbLib | Resistor | RES_C_0402 |  |  | 9/27/2022 | Samsung Electro-Mechanics America, Inc |  |  |  |  |  |  |  |  |  | RC1005F4423CS |  |  |  |  |  |  |  |  |  | Digi-Key |  |  |  |  |  |  |  |  |  | 1276-4257-2-ND
RES1481 | 1 | R80 | YES | Fitted | RES TKF 95.3k 1% 1/16W SMD 0402 | 95.3k | MCL Design | MCHP-CDB.DbLib | Resistor | RES_C_0402 |  |  | 9/27/2022 | Rohm Semiconductor |  |  |  |  |  |  |  |  |  | MCR01MRTF9532 |  |  |  |  |  |  |  |  |  | Digi-Key |  |  |  |  |  |  |  |  |  | RHM95.3KCDCT-ND
RES1483 | 1 | R81 | YES | Fitted | RES TKF 24.3k 1% 1/16W SMD 0402 | 24.3k | MCL Design | MCHP-CDB.DbLib | Resistor | RES_C_0402 |  |  | 9/27/2022 | Samsung |  |  |  |  |  |  |  |  |  | RC1005F2432CS |  |  |  |  |  |  |  |  |  | Digi-Key |  |  |  |  |  |  |  |  |  | 1276-4149-1-ND
RES1505 | 2 | R82, R85 | YES | Fitted | RES TKF 5.62k 1% 1/16W SMD 0402 | 5.62k | MCL Design | MCHP-CDB.DbLib | Resistor | RES_C_0402 |  |  | 9/27/2022 | Vishay Dale |  |  |  |  |  |  |  |  |  | CRCW04025K62FKED |  |  |  |  |  |  |  |  |  | Digi-Key |  |  |  |  |  |  |  |  |  | 541-5.62KLTR-ND
RES1027 | 1 | R83 | YES | Fitted | RES TKF 270R 5% 1/10W SMD 0402 | 270R | MCL Design | MCHP-CDB.DbLib | Resistor | RES_C_0402 |  |  | 9/27/2022 | Panasonic |  |  |  |  |  |  |  |  |  | ERJ-2GEJ271X |  |  |  |  |  |  |  |  |  | Digi-Key |  |  |  |  |  |  |  |  |  | P270JTR-ND
RES1587 | 1 | R88 | YES | Fitted | RES TKF 100R 1% 1/16W SMD 0402 | 100R | MCL Design | MCHP-CDB.DbLib | Resistor | RES_C_0402 |  |  | 9/27/2022 | Yageo |  |  |  |  |  |  |  |  |  | RC0402FR-07100RL |  |  |  |  |  |  |  |  |  | Digi-Key |  |  |  |  |  |  |  |  |  | 311-100LRCT-ND
RSMT0735 | 0 | R109 | DNP | Not Fitted | RES TKF 10k 5% 1/10W SMD 0402 | 10k | MCL Design | MCHP-CDB.DbLib | Resistor | RES_C_0402 |  |  | 9/27/2022 | Panasonic |  |  |  |  |  |  |  |  |  | ERJ-2GEJ103X |  |  |  |  |  |  |  |  |  | Digi-Key |  |  |  |  |  |  |  |  |  | P10KJCT-ND
RES1582 | 0 | R113 | DNP | Not Fitted | RES TKF 100k 1% 1/20W SMD 0201 | 100k | MCL Design | MCHP-CDB.DbLib | Resistor | RES_C_0201 |  |  | 9/27/2022 | Panasonic Electronic Components |  |  |  |  |  |  |  |  |  | ERJ-1GEF1003C |  |  |  |  |  |  |  |  |  | Digi-Key |  |  |  |  |  |  |  |  |  | P100KABCT-ND
RES1218 | 1 | R126 | Yes | Fitted | RES TKF 0R 1/8W SMD 0805 | 0R | MCL Design | MCHP-CDB.DbLib | Resistor | RES_C_0805 |  |  | 9/27/2022 | Panasonic |  |  |  |  |  |  |  |  |  | ERJ-6GEY0R00V |  |  |  |  |  |  |  |  |  | Digi-Key |  |  |  |  |  |  |  |  |  | P0.0ACT-ND
SWITCH1176 | 2 | SW1, SW2 | YES | Fitted | SWITCH TACTILE SPST-NO 32V 0.05A KMR221GLFS | Top Actuated Surface Mount | MCL Design | MCHP-CDB.DbLib | Rating: DC 12V 50mA Max 0.1 ohm contact resistance | SW_TACT_KMR2_4.6x2.8 |  |  | 9/27/2022 | C&K |  |  |  |  |  |  |  |  |  | KMR221GLFS |  |  |  |  |  |  |  |  |  | Digi-Key |  |  |  |  |  |  |  |  |  | 401-1427-1-ND
IC1665 | 7 | U1, U2, U4, U5, U14, U15, U16 | YES | Fitted | IC VOLTAGE TRANSLATOR BI-DIR 1 CIRCUIT 74LVC1T45FW4-7 X2-DFN1010-6 | 74LVC1T45FW4-7 | MCL Design | MCHP-CDB.DbLib | 74LVC(H)1T45 SOT-23-6_SC-70-6_SOT-6_SOT-363_DSBGA | X2-DFN1010-6 |  |  | 9/27/2022 | Diodes Incorporated |  |  |  |  |  |  |  |  |  | 74LVC1T45FW4-7 |  |  |  |  |  |  |  |  |  | Digi-Key |  |  |  |  |  |  |  |  |  | 74LVC1T45FW4-7DICT-ND
MIC3211 | 1 | U3 | Yes | Fitted | MCHP ANALOG TEMPERATURE SENSOR -40C to +150C MCP9700AT-E/TT SOT-23-3 | MCP9700A | MCL Design | MCHP-CDB.DbLib | MCP9700(A)_1(A) TO-92-3_SOT-23-3 | SOT-23-3 |  |  | 9/27/2022 | Microchip |  |  |  |  |  |  |  |  |  | MCP9700AT-E/TT |  |  |  |  |  |  |  |  |  | Microchip |  |  |  |  |  |  |  |  |  | MCP9700AT-E/TT
MIC9365 | 1 | U6 | YES | Fitted | MOD BLE/ZIGBEE WBZ451PE-I | WBZ451PE-I | MCL Design | MCHP-CDB.DbLib | WBZ451PE-I | MOD_WBZ451PE-I |  |  | 9/27/2022 | Microchip Technology |  |  |  |  |  |  |  |  |  | WBZ451PE-I |  |  |  |  |  |  |  |  |  | Microchip Technology |  |  |  |  |  |  |  |  |  | WBZ451PE-I
MIC8025 | 1 | U7 | YES | Fitted | MCHP SERIAL FLASH SST26VF064B-104I/MF WDFN-8 | SST26VF064B-104I/MF | MCL Design | MCHP-CDB.DbLib | SST26VF064B-104IMF | WSON-8_6x5_EP3.4X4.0 |  |  | 9/27/2022 | Microchip Technology |  |  |  |  |  |  |  |  |  | SST26VF064B-104I/MF |  |  |  |  |  |  |  |  |  | Digi-Key |  |  |  |  |  |  |  |  |  | SST26VF064B-104I/MF-ND
MIC1360 | 1 | U8 | Yes | Fitted | MCHP MEMORY SERIAL EEPROM 256k I2C 24LC256T-E/ST TSSOP-8 | 24LC256 | MCL Design | MCHP-CDB.DbLib | 24XX01_02_04_08_16_32_64_128_256_512_1025 SOIC-8_SOIJ-8_TSSOP-8_PDIP-8_MSOP-8 | TSSOP-8 |  |  | 9/27/2022 | Microchip Technology |  |  |  |  |  |  |  |  |  | 24LC256T-E/ST |  |  |  |  |  |  |  |  |  | Microchip Technology |  |  |  |  |  |  |  |  |  | 24LC256T-E/ST
MIC8128 | 0 | U9 | DNP | Not Fitted | MCHP MEMORY SERIAL EEPROM CRYPTO AUTH I2C ATECC608A-MAHDA-T UDFN-8 | ATECC608A-MAHDA-T | MCL Design | MCHP-CDB.DbLib | ATECC608A-MAHDA-T UDFN-8 | 8-UDFN |  |  | 9/27/2022 | Microchip Technology |  |  |  |  |  |  |  |  |  | ATECC608A-MAHDA-T |  |  |  |  |  |  |  |  |  | Digi-Key |  |  |  |  |  |  |  |  |  | ATECC608A-MAHDA-TCT-ND
MIC2626 | 1 | U10 | Yes | Fitted | MCHP ANALOG LDO 3V MCP1727T-3002E/MF DFN-8 | MCP1727/3V | MCL Design | MCHP-CDB.DbLib | MCP172X FIX DFN-8 | DFN-8_3x3 |  |  | 9/27/2022 | Microchip | Microchip |  |  |  |  |  |  |  |  | MCP1727T-3002E/MF | MCP1727-3002E/MF |  |  |  |  |  |  |  |  | Microchip | Microchip |  |  |  |  |  |  |  |  | MCP1727T-3002E/MF | MCP1727-3002E/MF
IC1879 | 1 | U11 | YES | Fitted | IC FILTER EMI2124MTTAG COMMON MODE ESD WDFN-8 | EMI2124MTTAG | MCL Design | MCHP-CDB.DbLib | EMI2124 WDF-8 | WDFN-8_EP |  |  | 9/27/2022 | ON Semiconductor |  |  |  |  |  |  |  |  |  | EMI2124MTTAG |  |  |  |  |  |  |  |  |  | Digi-Key |  |  |  |  |  |  |  |  |  | EMI2124MTTAGOSCT-ND
MIC3190 | 1 | U12 | YES | Fitted | MCHP ANALOG BATTERY CHARGER MCP73871-2CCI/ML QFN-20 | MCP73871 | MCL Design | MCHP-CDB.DbLib | MCP73871 QFN-20 | QFN-20_4X4 |  |  | 9/27/2022 | Microchip |  |  |  |  |  |  |  |  |  | MCP73871-2CCI/ML |  |  |  |  |  |  |  |  |  | Microchip |  |  |  |  |  |  |  |  |  | MCP73871-2CCI/ML
MIC6086 | 1 | U13 | YES | Fitted | MCHP ANALOG LDO 3.3V MCP1727-3302E/MF | MCP1727 3.3V | MCL Design | MCHP-CDB.DbLib | MCP172X FIX DFN-8 | DFN-8_3X3 |  |  | 9/27/2022 | Microchip Technology |  |  |  |  |  |  |  |  |  | MCP1727-3302E/MF |  |  |  |  |  |  |  |  |  | Microchip Technology |  |  |  |  |  |  |  |  |  | MCP1727-3302E/MF
MIC8828 | 1 | U17 | YES | Fitted | MCHP INTERFACE USB 2.0 HUB CTRLR USB2512B-I/M2 SQFN-36 | USB2512B-I/M2 | MCL Design | MCHP-CDB.DbLib | USB2512B-I/M2 | QFN-36_6x6_EP3.7x3.7 |  |  | 9/27/2022 | Microchip Technology |  |  |  |  |  |  |  |  |  | USB2512B-I/M2 |  |  |  |  |  |  |  |  |  | Microchip Technology |  |  |  |  |  |  |  |  |  | USB2512B-I/M2
MIC6326 | 1 | U18 | YES | Fitted | MCHP INTERFACE USB UART MCP2200-I/MQ QFN-20 | MCP2200-I/MQ | MCL Design | MCHP-CDB.DbLib | MCP2200 QFN-20 | QFN-20_5X5 |  |  | 9/27/2022 | Microchip Technology |  |  |  |  |  |  |  |  |  | MCP2200-I/MQ |  |  |  |  |  |  |  |  |  | Digi-Key |  |  |  |  |  |  |  |  |  | MCP2200-I/MQ-ND
MIC6637 | 1 | U19 | YES | Fitted | MCHP ANALOG POWER SWITCH 5.5V 3A MIC2042-1YTS TSSOP-14 | MIC2042 | MCL Design | MCHP-CDB.DbLib | MIC2042 | TSSOP-14 |  |  | 9/27/2022 | Microchip Technology |  |  |  |  |  |  |  |  |  | MIC2042-1YTS |  |  |  |  |  |  |  |  |  | Microchip Technology |  |  |  |  |  |  |  |  |  | MIC2042-1YTS
MIC8829 | 1 | U20 | YES | Fitted | MCHP MCU 32-BIT 300MHz 2MB 384K x 8 ATSAME70N21B-CNT TFBGA-100 | ATSAME70N21B-CNT | MCL Design | MCHP-CDB.DbLib | ATSAME70-TFBGA100 | TFBGA-100_P0.8_9x9x1.1 |  |  | 9/27/2022 | Microchip Technology |  |  |  |  |  |  |  |  |  | ATSAME70N21B-CNT |  |  |  |  |  |  |  |  |  | Microchip Technology |  |  |  |  |  |  |  |  |  | ATSAME70N21B-CNT
OSC1232 | 1 | X1 | YES | Fitted | RESONATOR 12MHz 0.07% SMD CSTNE 3-SMD | 12MHz | MCL Design | MCHP-CDB.DbLib | Resonator 3 Pins | RESONATOR_CSTCE-G_L3.2W1.3H0.8 |  |  | 9/27/2022 | Murata Electronics |  |  |  |  |  |  |  |  |  | CSTNE12M0GH5L000R0 |  |  |  |  |  |  |  |  |  | Digi-Key |  |  |  |  |  |  |  |  |  | 490-17947-1-ND
OSC1038 | 1 | Y1 | YES | Fitted | CRYSTAL 32.768kHz 12.5pF SMD ABS07 | 32.768kHz | MCL Design | MCHP-CDB.DbLib | Crystal 2 Pins | CRYSTAL_ABS07 |  |  | 9/27/2022 | Seiko | Abracon | JWT |  |  |  |  |  |  |  | SC32S-12.5PF20PPM | ABS07-32.768KHZ-T | SMD3215-32.768KHZ-1-T;32.768KHz |  |  |  |  |  |  |  | Digi-Key | Digi-Key | Raynen |  |  |  |  |  |  |  | 728-1073-1-ND | 535-9542-1-ND | JWT SMD3215-32.768KHZ-1-T;32.768KHz
MIC8831 | 1 | Y2 | YES | Fitted | MCHP CMOS OSCILLATOR 12MHz DSC6011HI1B-012.0000 SMD VFLGA-4 | 12MHz | MCL Design | MCHP-CDB.DbLib | DSC60xx DFN-4_LGA-4 | OSCILLATOR_DSCxxxxHxxx_L1.6W1.2H0.84 |  |  | 9/27/2022 | Microchip Technology |  |  |  |  |  |  |  |  |  | DSC6011HI1B-012.0000 |  |  |  |  |  |  |  |  |  | Microchip Technology |  |  |  |  |  |  |  |  |  | DSC6011HI1B-012.0000
MIC8830 | 1 | Y3 | YES | Fitted | MCHP CMOS OSCILLATOR 24MHz DSC6011HI1B-024.0000 SMD VFLGA-4 | 24MHz | MCL Design | MCHP-CDB.DbLib | DSC60xx DFN-4_LGA-4 | OSCILLATOR_DSCxxxxHxxx_L1.6W1.2H0.84 |  |  | 9/27/2022 | Microchip Technology |  |  |  |  |  |  |  |  |  | DSC6011HI1B-024.0000 |  |  |  |  |  |  |  |  |  | Microchip Technology |  |  |  |  |  |  |  |  |  | DSC6011HI1B-024.0000
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
