nsaspook/wbz451matter/SST26VF064B-104I_MF/3D/SST26VF064B-104I_MF.stp

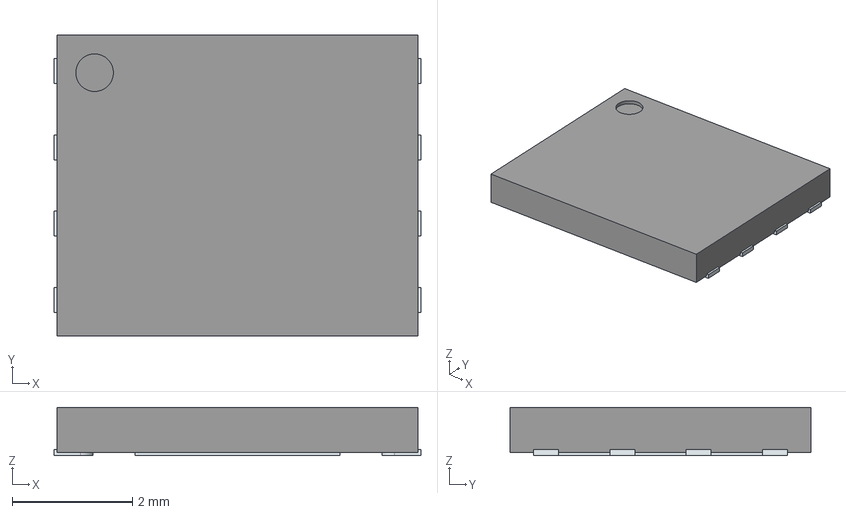
[picture p1: CAD file, 2024-05-31]
SST26VF064B-104I_MF/3D/SST26VF064B-104I_MF.stp
6.10 x 5.00 x 0.8 mm
ThermalPin
PinsArrayLR
