nsaspook/wbz451matter/(list of files, cad)

Other CAD files:
EHF-105-01-L-D-SM-LC/Allegro/ehf-105-01-xx-d-sm-lc.psm
EHF-105-01-L-D-SM-LC/DEHDL/ehf_105_01_l_d_sm_lc/chips/chips.prt
SST26VF064B-104I_MF/Allegro/son127p600x500x80-9n-d.psm
SST26VF064B-104I_MF/DEHDL/sst26vf064b_104i_mf/chips/chips.prt
