nsaspook/wbz451matter/Schematics/03-00307-R7.PDF

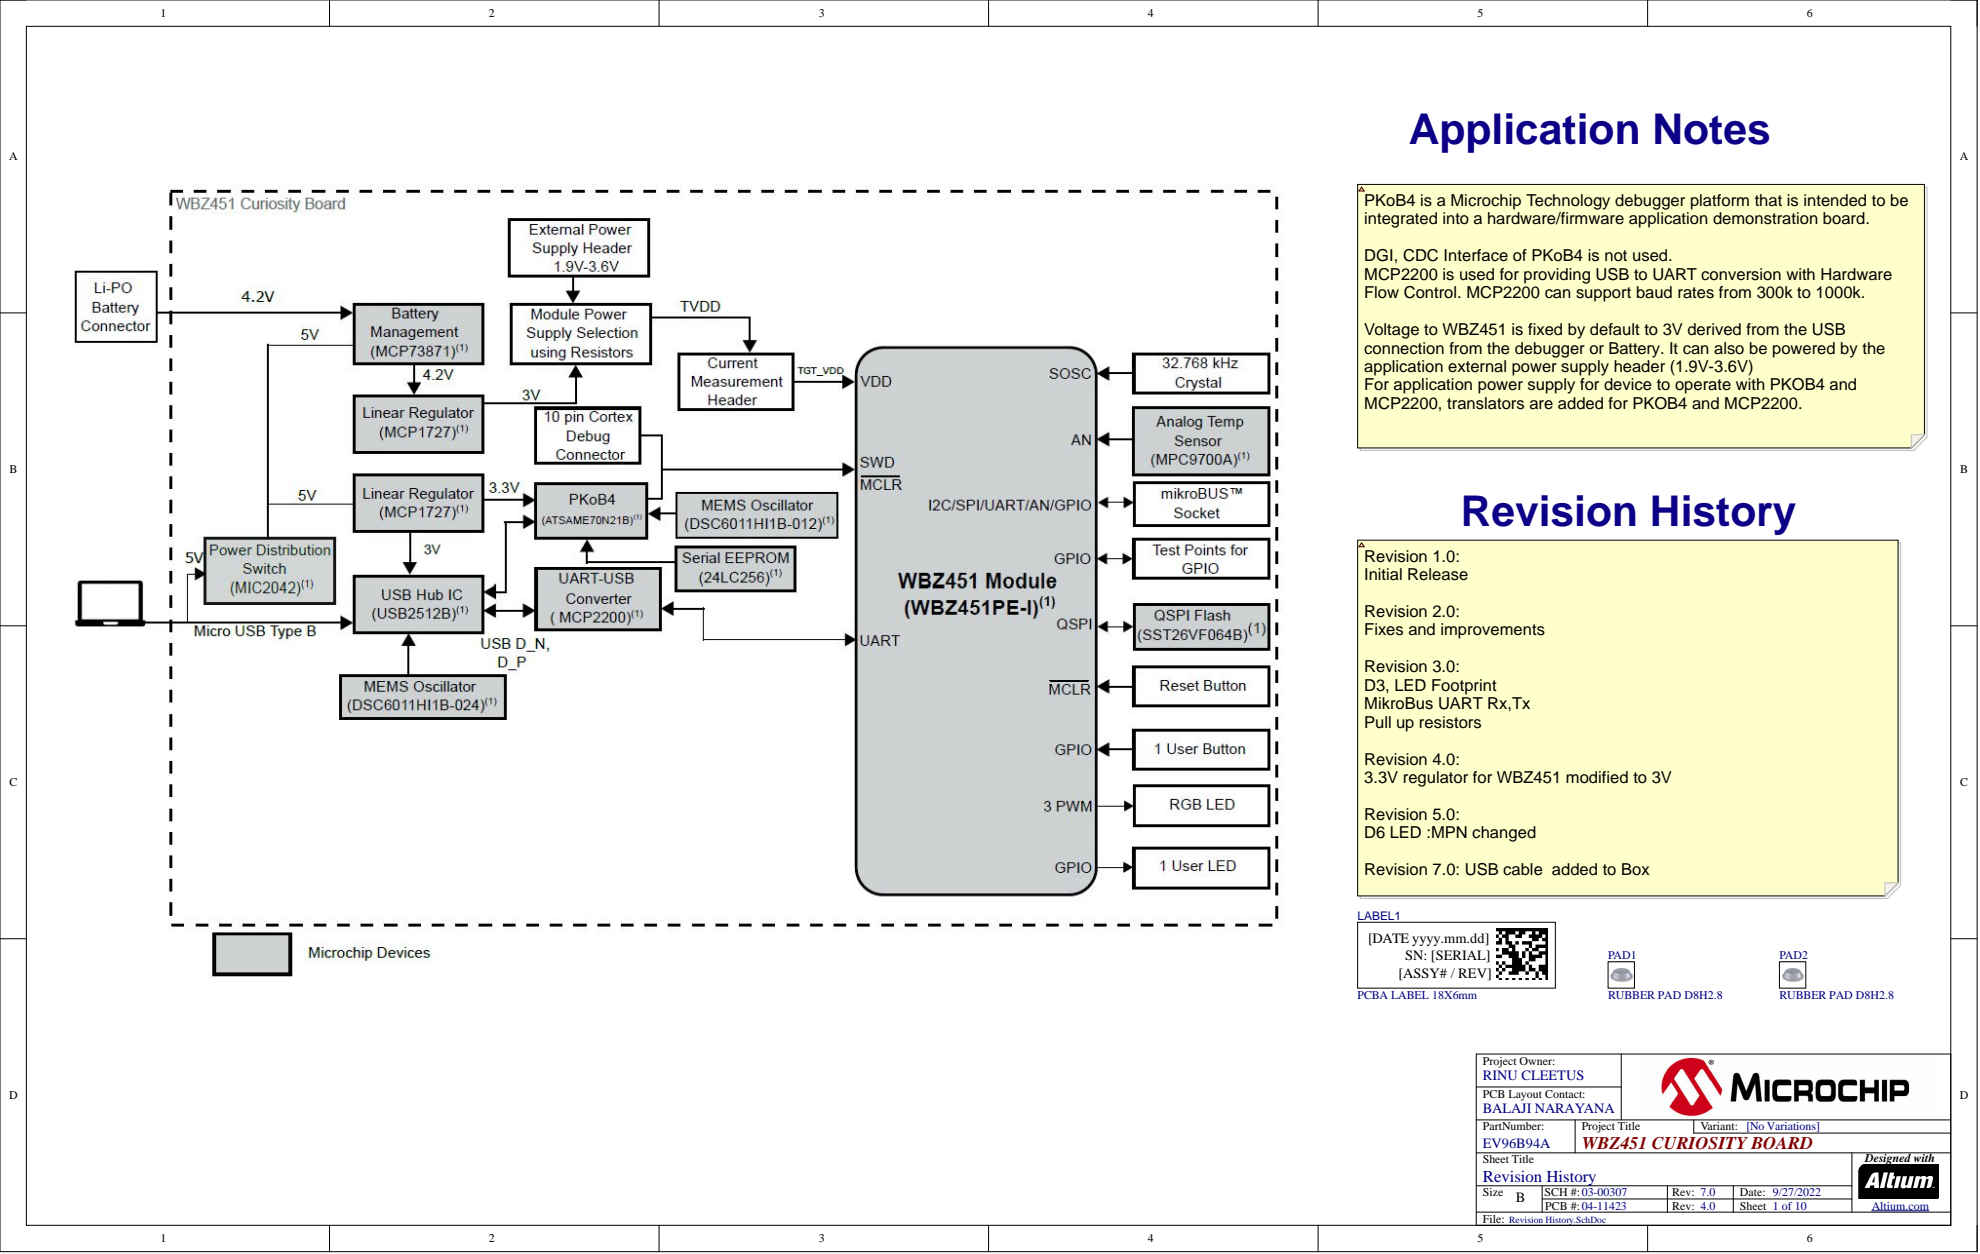
[picture p2: page 1]

PKoB4 is a Microchip
integrated into a hardware/firmware application demonstration board.

Technology debugger platform that is intended to be

DGI, CDC Interface of PKoB4 is not used.
MCP2200 is used for providing USB to UAR
Flow Control. MCP2200 can support baud rates from 300k to 1000k. Voltage to WBZ451 is fixed by default to 3V derived from the USB

connection from the debugger or Battery. It can also be powered by the
application external power supply header (1.9V-3.6V)
For application power supply for device to operate with PKOB4 and
MCP2200, translators are added for PKOB4 and MCP2200.

Revision 4.0:
3.3V regulator for WBZ451 modified to 3V

Revision 7.0: USB cable added to Box

LABEL
[DATE yyyy.mm.dd]
SN: [SERIAL]
[ASSY# / REV]

Sheet Title Revision History | Designed with Altium.com

Size B | SCH #: 03-00307 | Rev: 7.0 | Date: 9/27/2022

PCB #: 04-11423 | Rev: 4.0 | Sheet

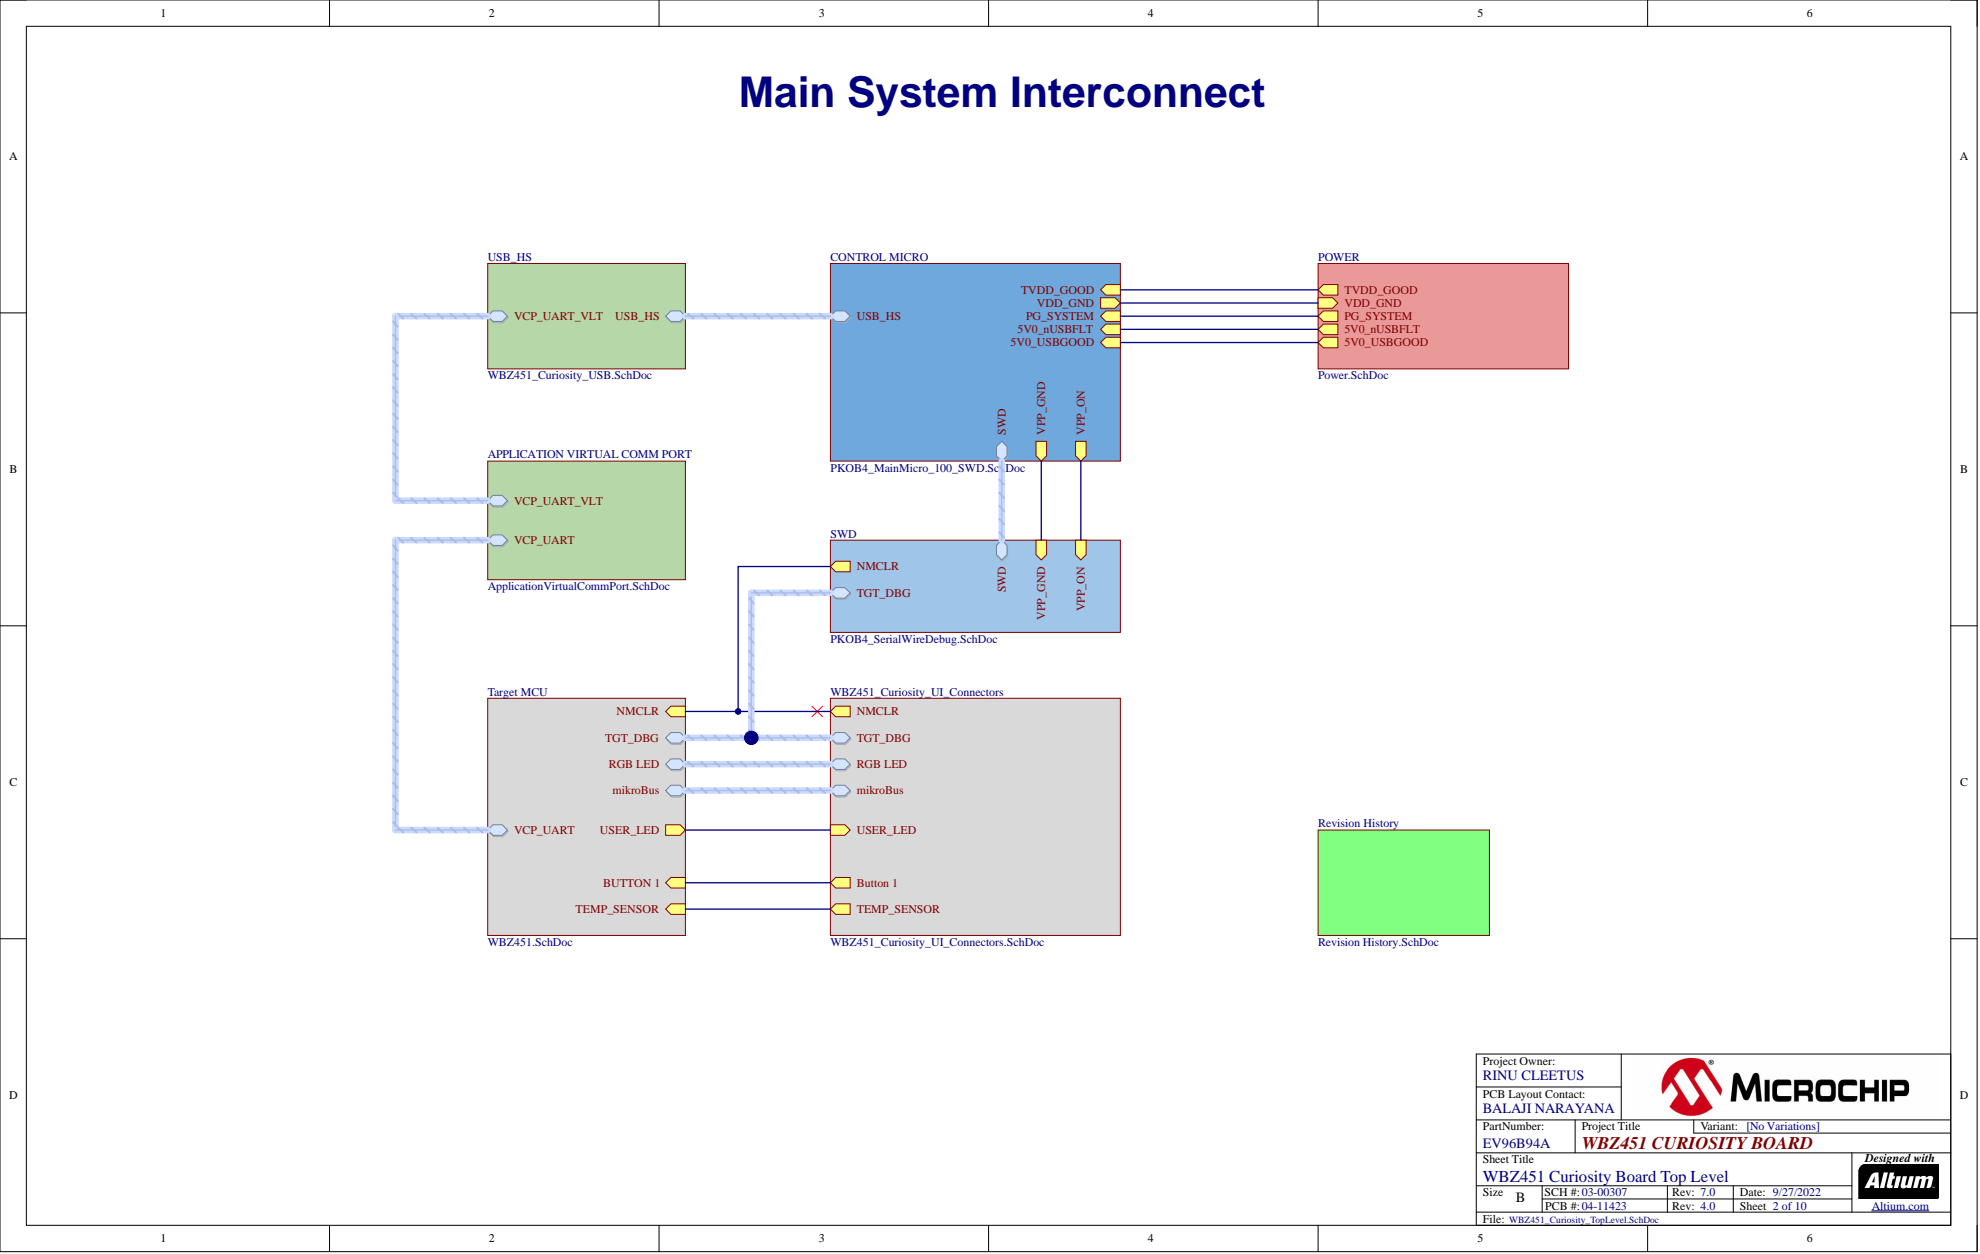
[picture p3: page 2]

APPLICATION VIRTUAL COMM PORT

WBZ451 Curiosity Board Top Level
Size B

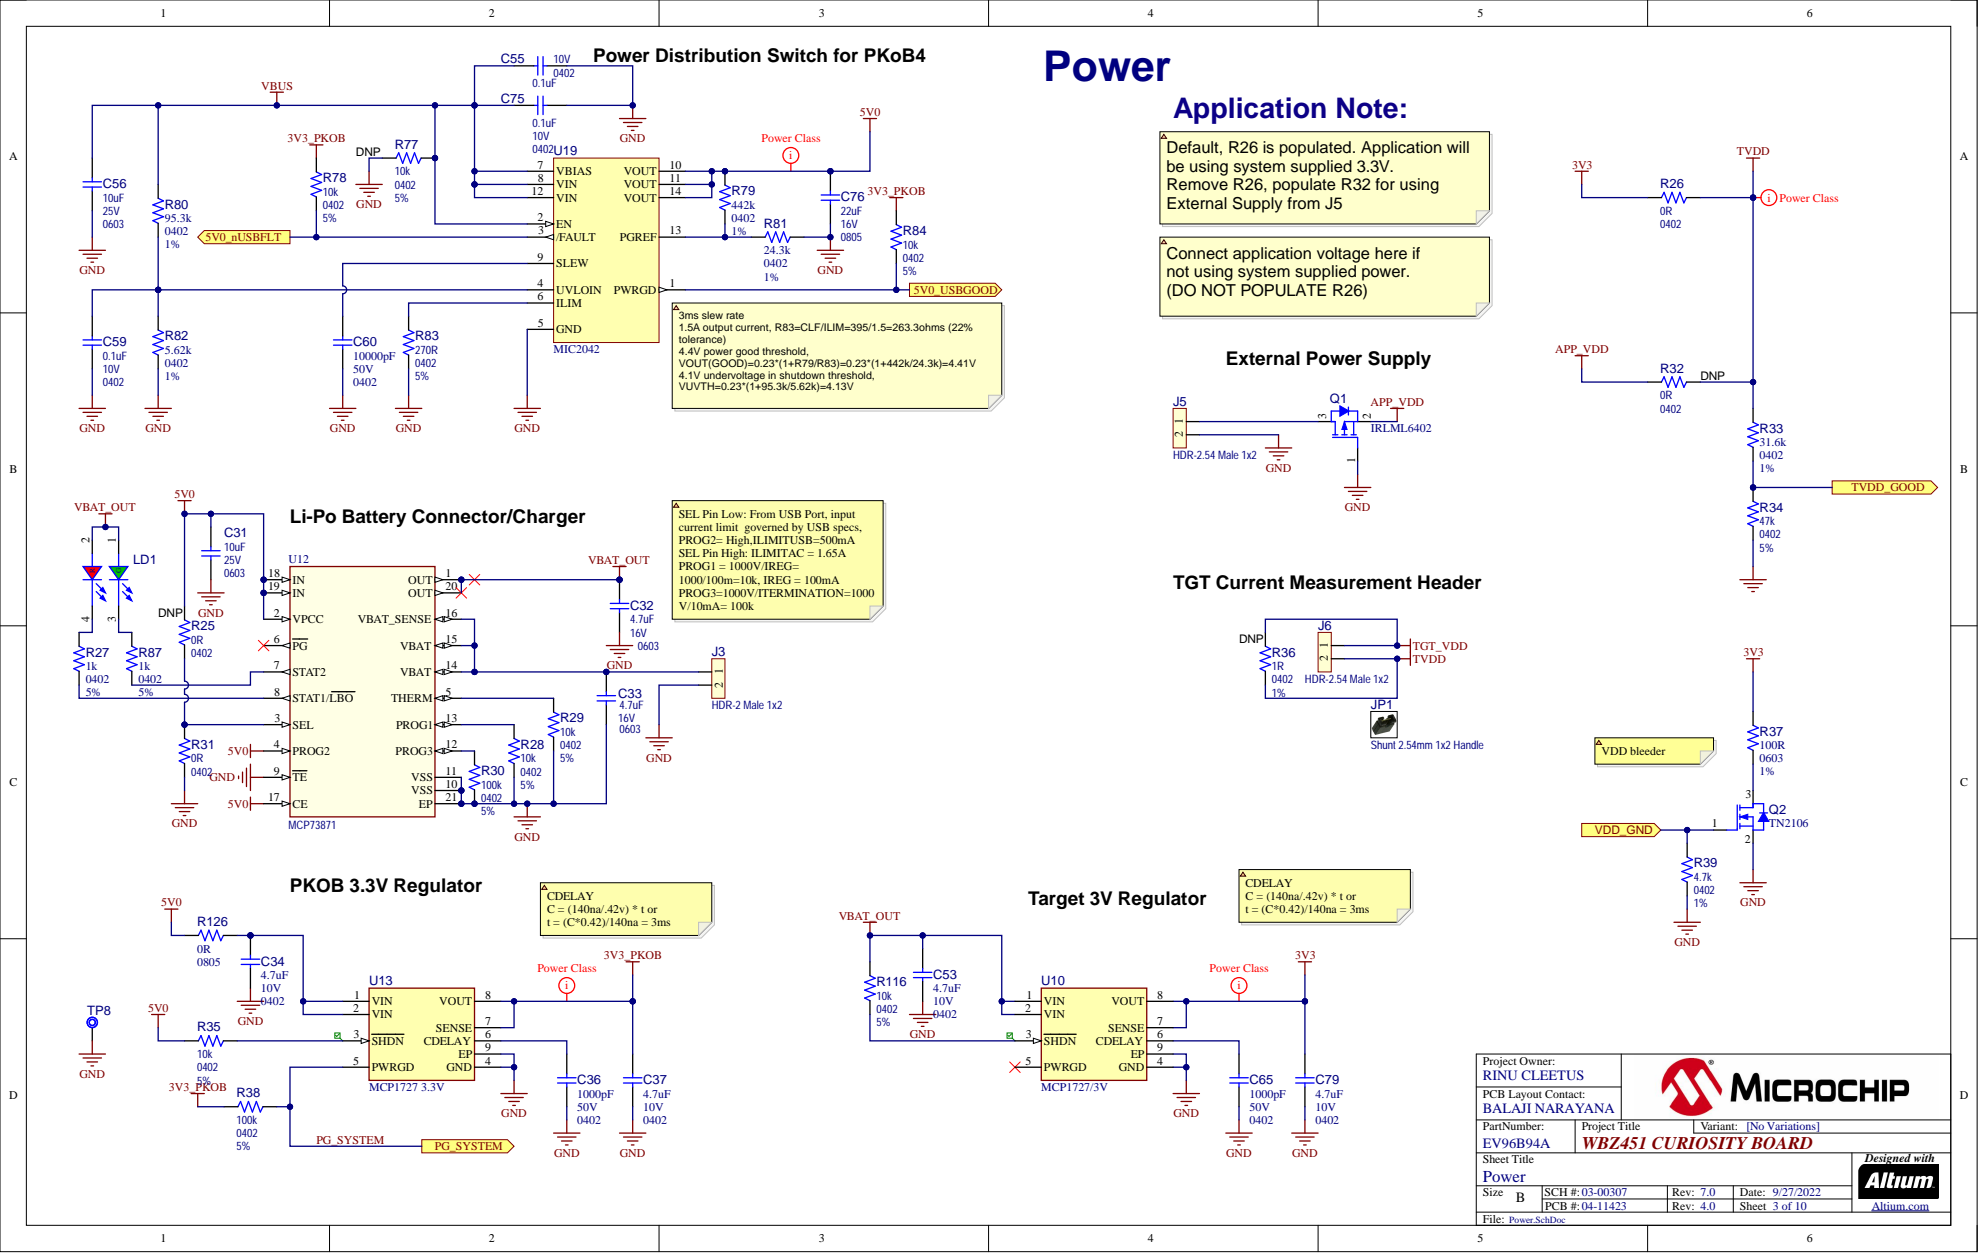
[picture p4: page 3]

Power Distribution Switch for PKoB4

Default, R26 is populated. Application will
be using system supplied 3.3V.
Remove R26, populate R32 for using
External Supply from J5

Connect application voltage here if
not using system supplied power.
(DO NOT POPULATE R26)

3ms slew rate
1.5A output current, R83=CLF/ILIM=395/1.5=263.3ohms (22%
tolerance)
4.4V power good threshold,
VOUT(GOOD)=0.23*(1+R79/R83)=0.23*(1+442k/24.3k)=4.41V
4.1V undervoltage in shutdown threshold,
VUVTH=0.23*(1+95.3k/5.62k)=4.13V

Li-Po Battery Connector/Charger

SEL Pin Low: From USB Port, input
current limit governed by USB specs,
PROG2= High,ILIMITUSB=500mA
SEL Pin High: ILIMITAC = 1.65A
PROG1 = 1000V/IREG=
1000/100m=10k, IREG = 100mA
PROG3=1000V/ITERMINATION=1000

TGT Current Measurement Header

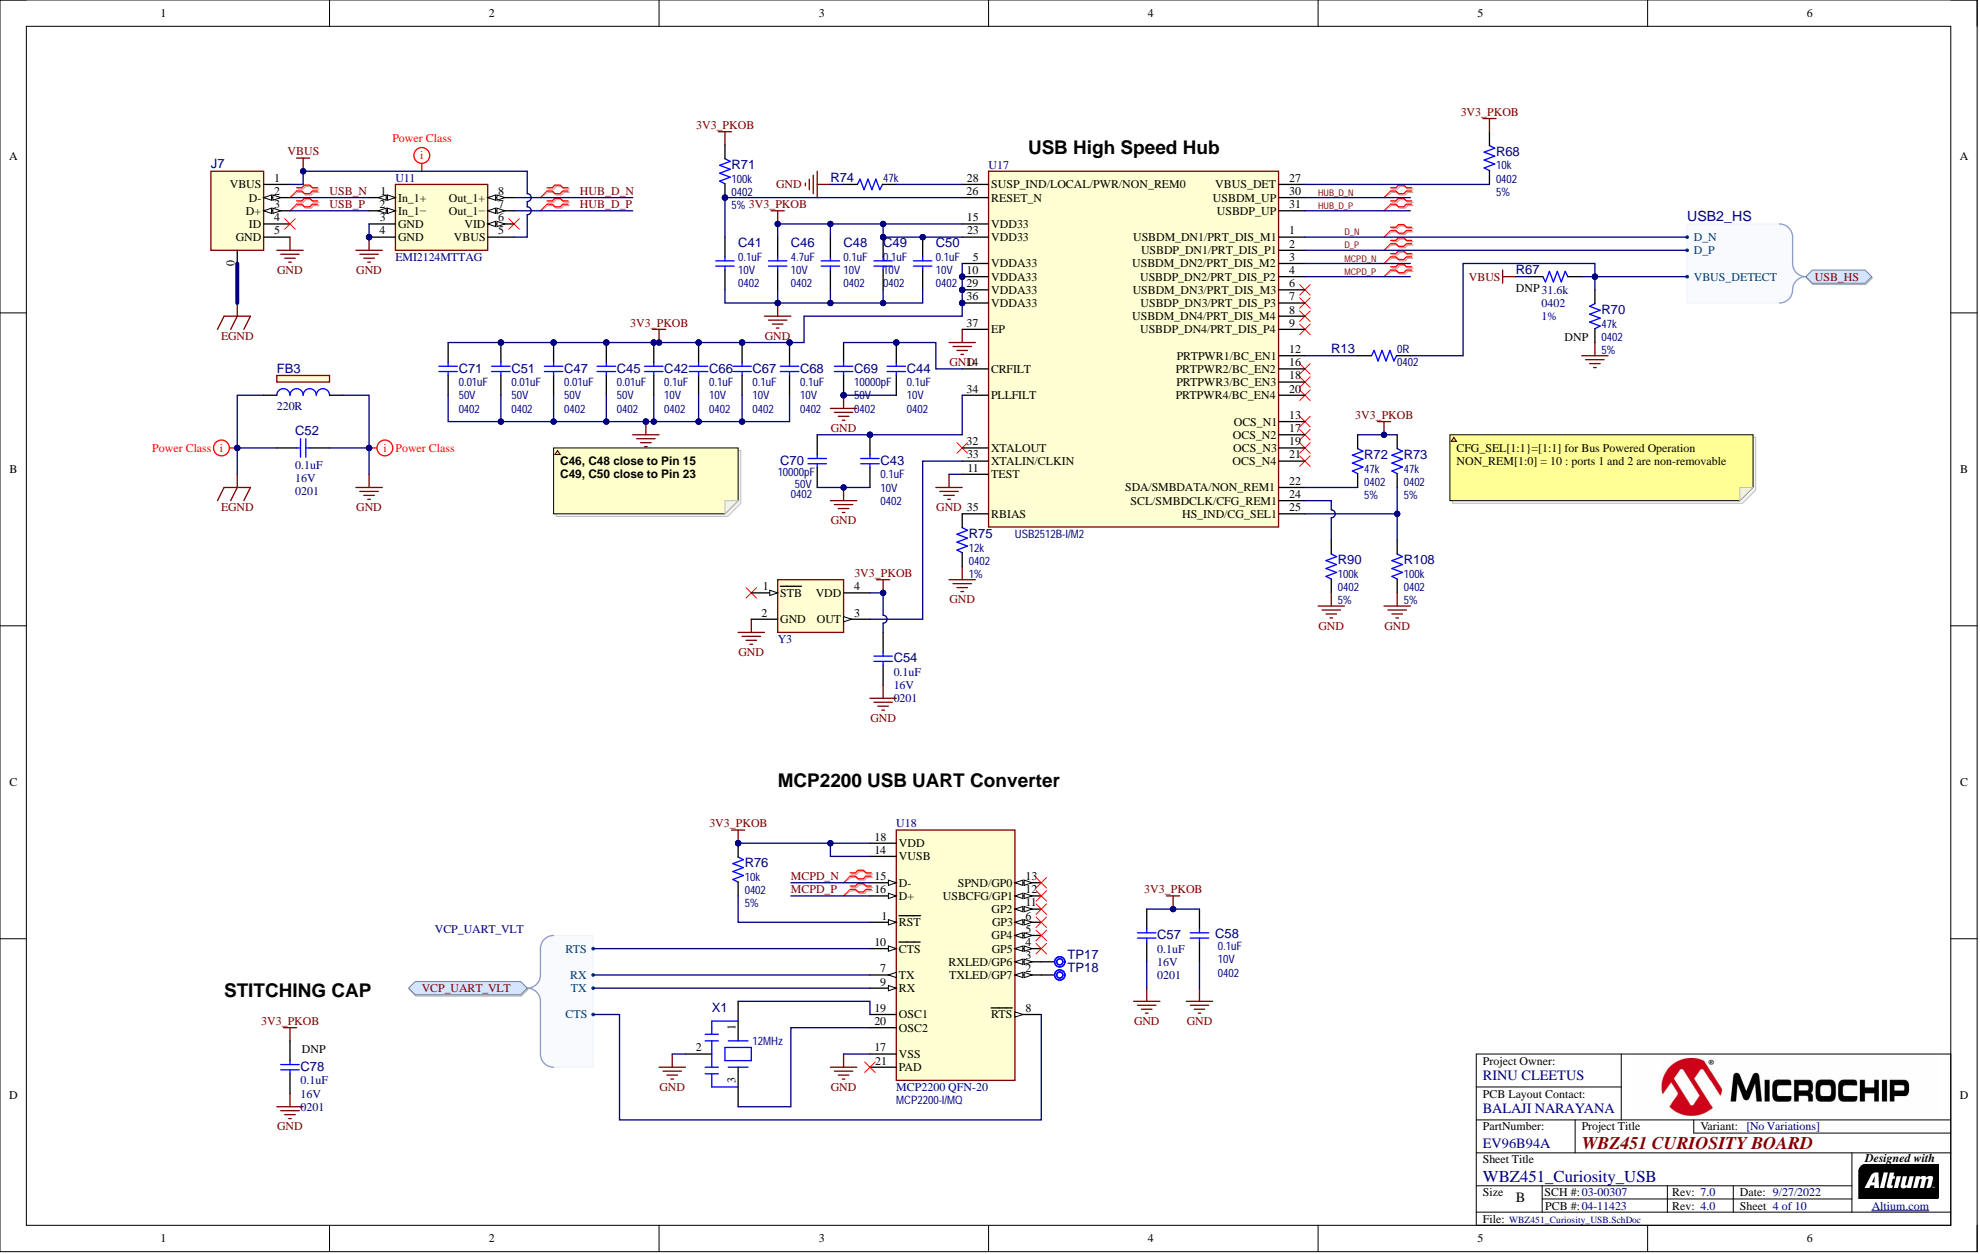
[picture p5: page 4]

USB High Speed Hub

CFG_SEL[1:1}=[1:1] for Bus Powered Operation
NON_REM[1:0] = 10 : ports 1 and 2 are non-removable

OSC1 19
OSC2 20

VSS 17

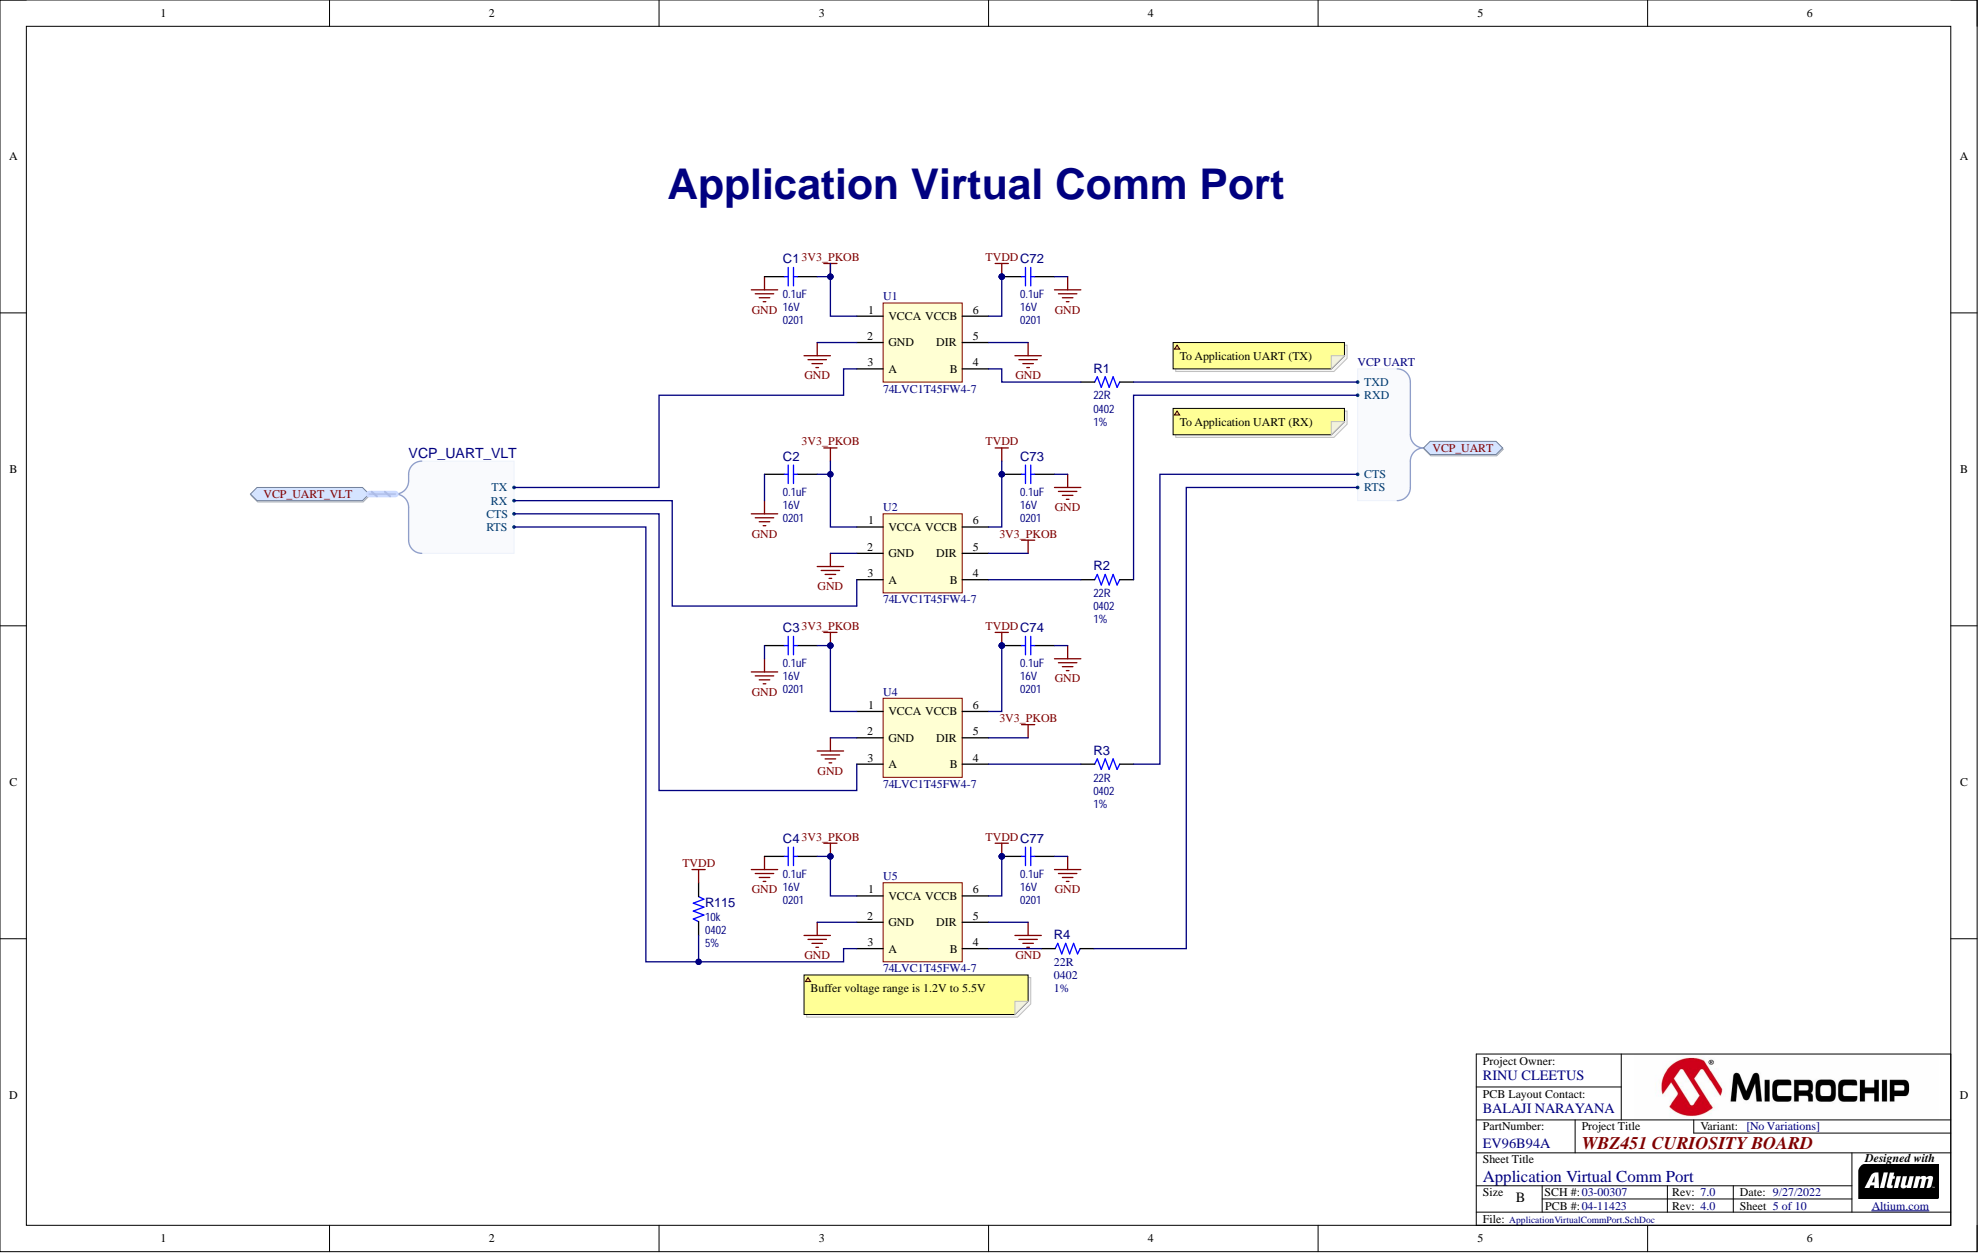
[picture p6: page 5]

Application Virtual Comm Port

To Application UART (TX)

To Application UART (RX)

Buffer voltage range is 1.2V to 5.5V

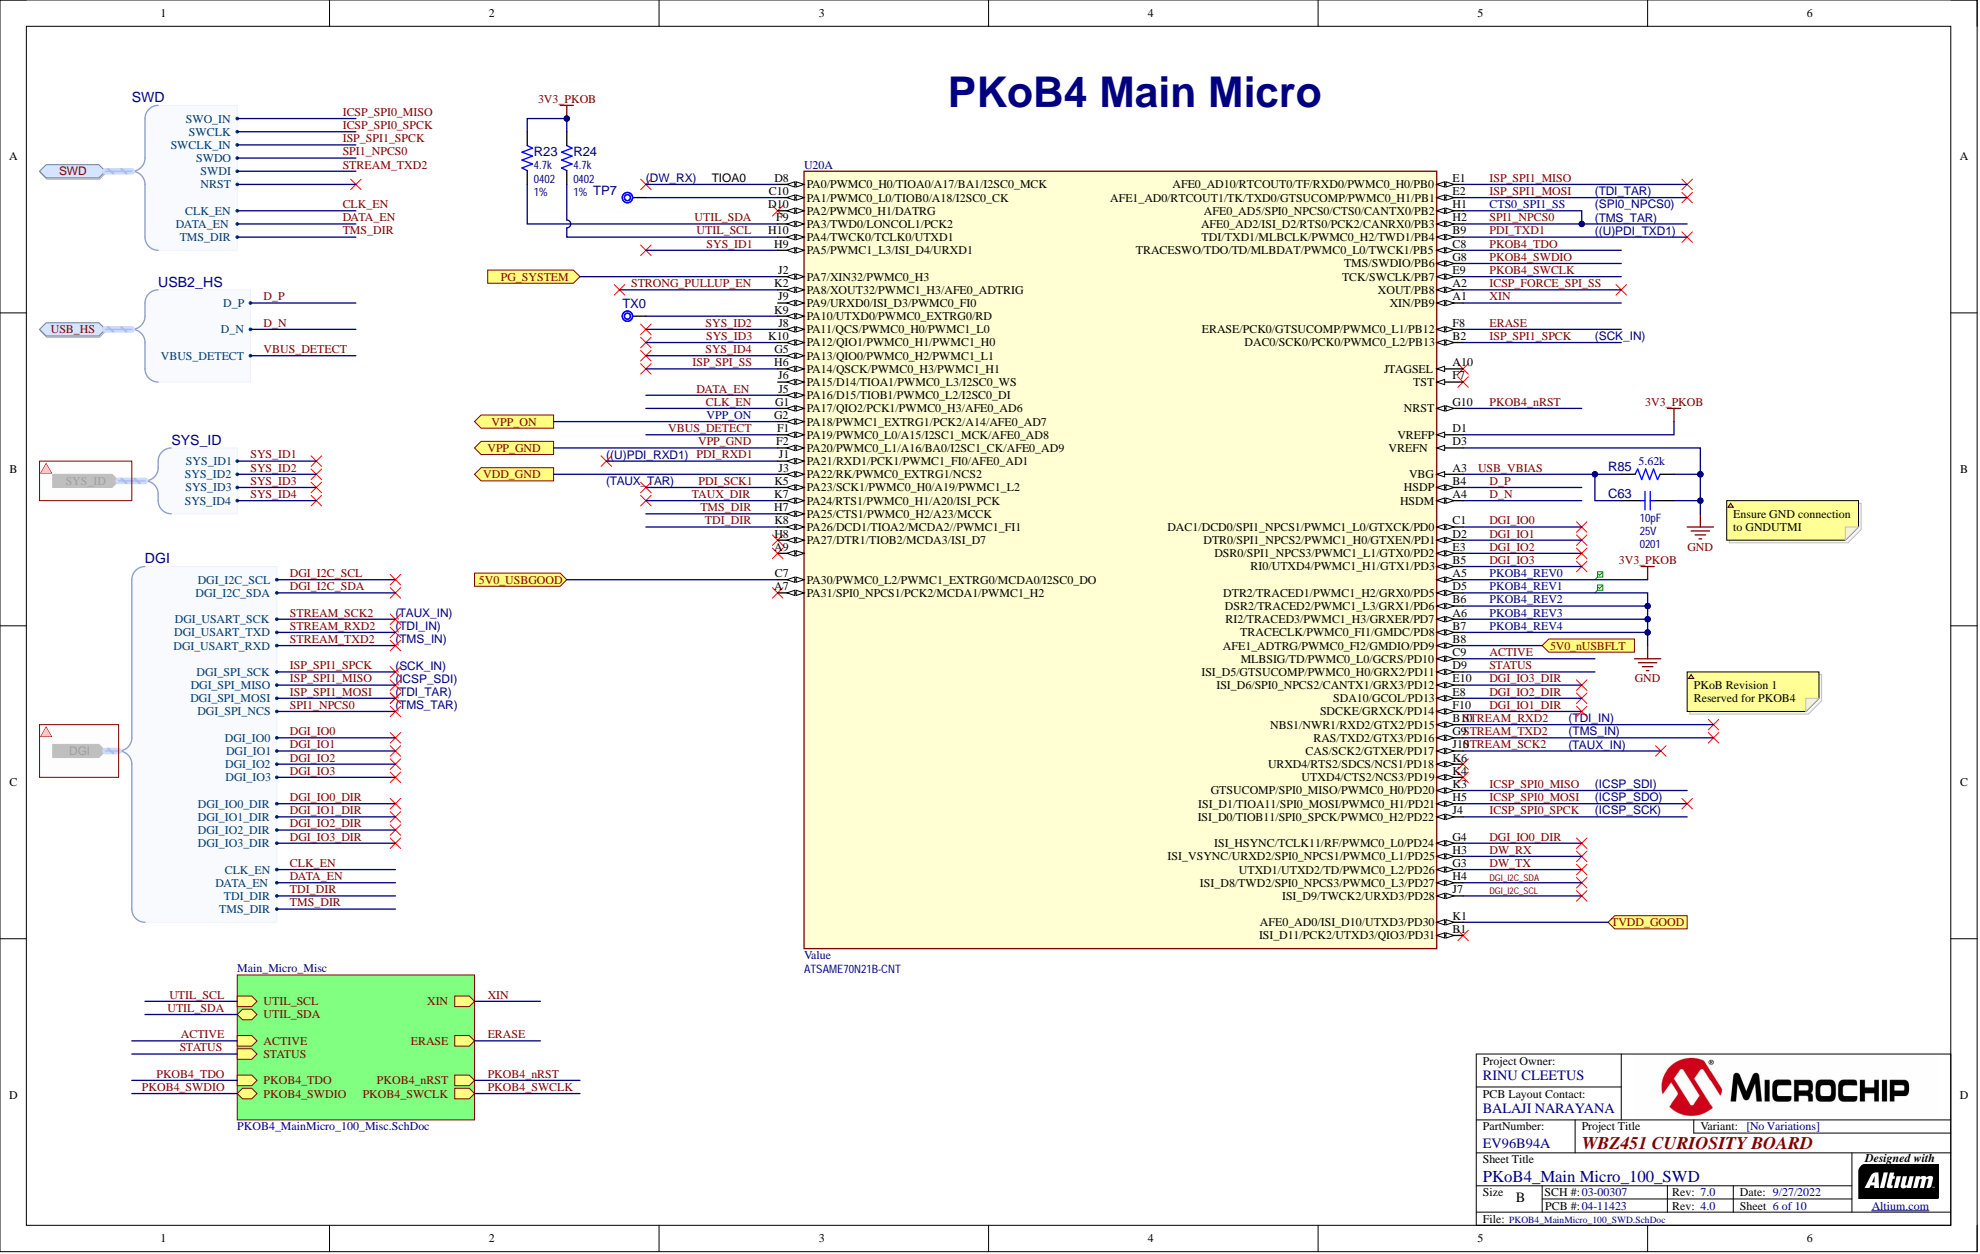
[picture p7: page 6]

5.62k R85 USB_VBIAS
D_P

PKOB4_REV2
PKOB4_REV3
PKOB4_REV4

PKoB4_Main Micro_100_SWD
Size B

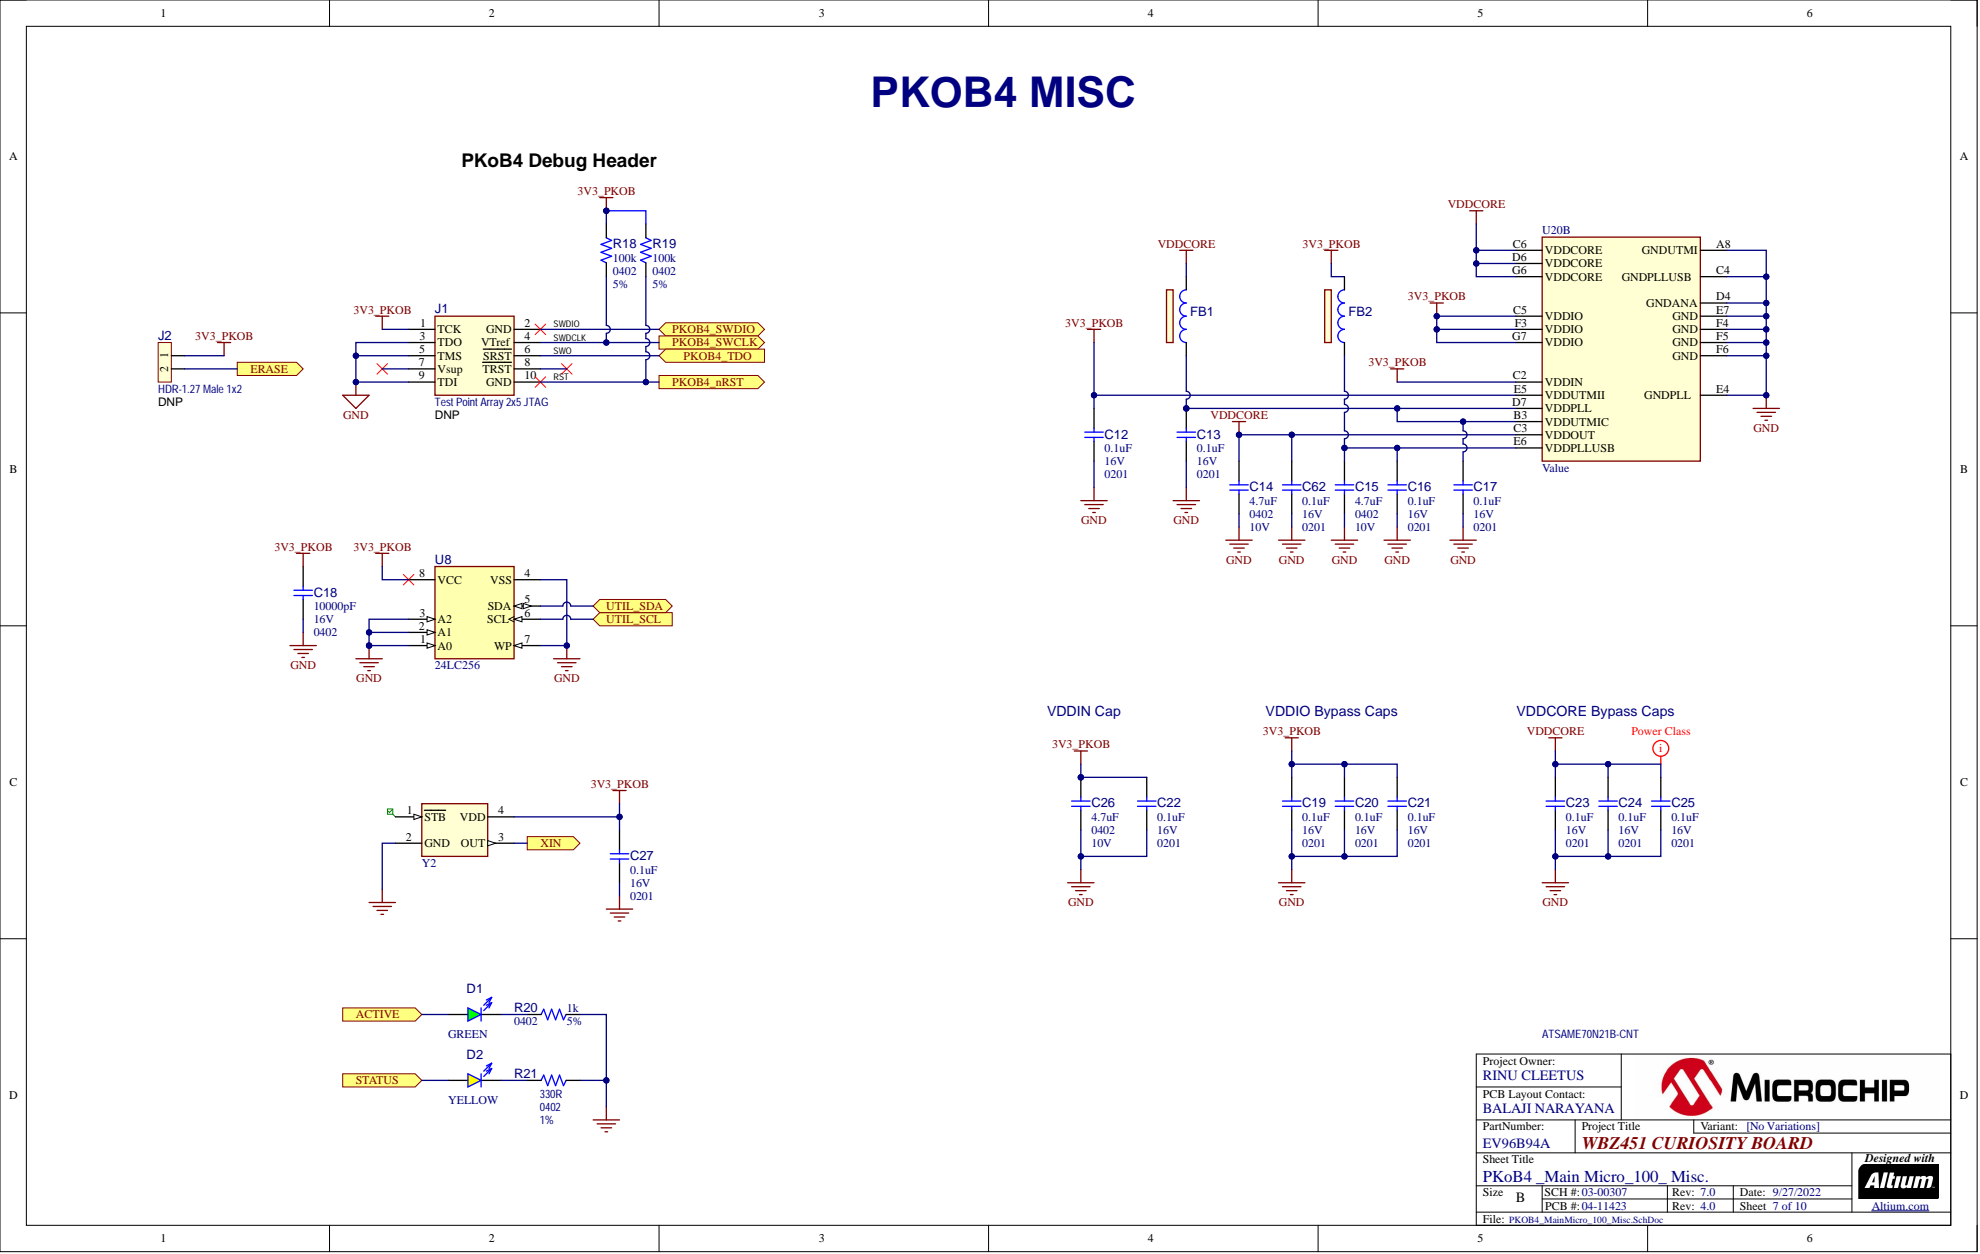
[picture p8: page 7]

Test Point Array 2x5 JTAG
DNP

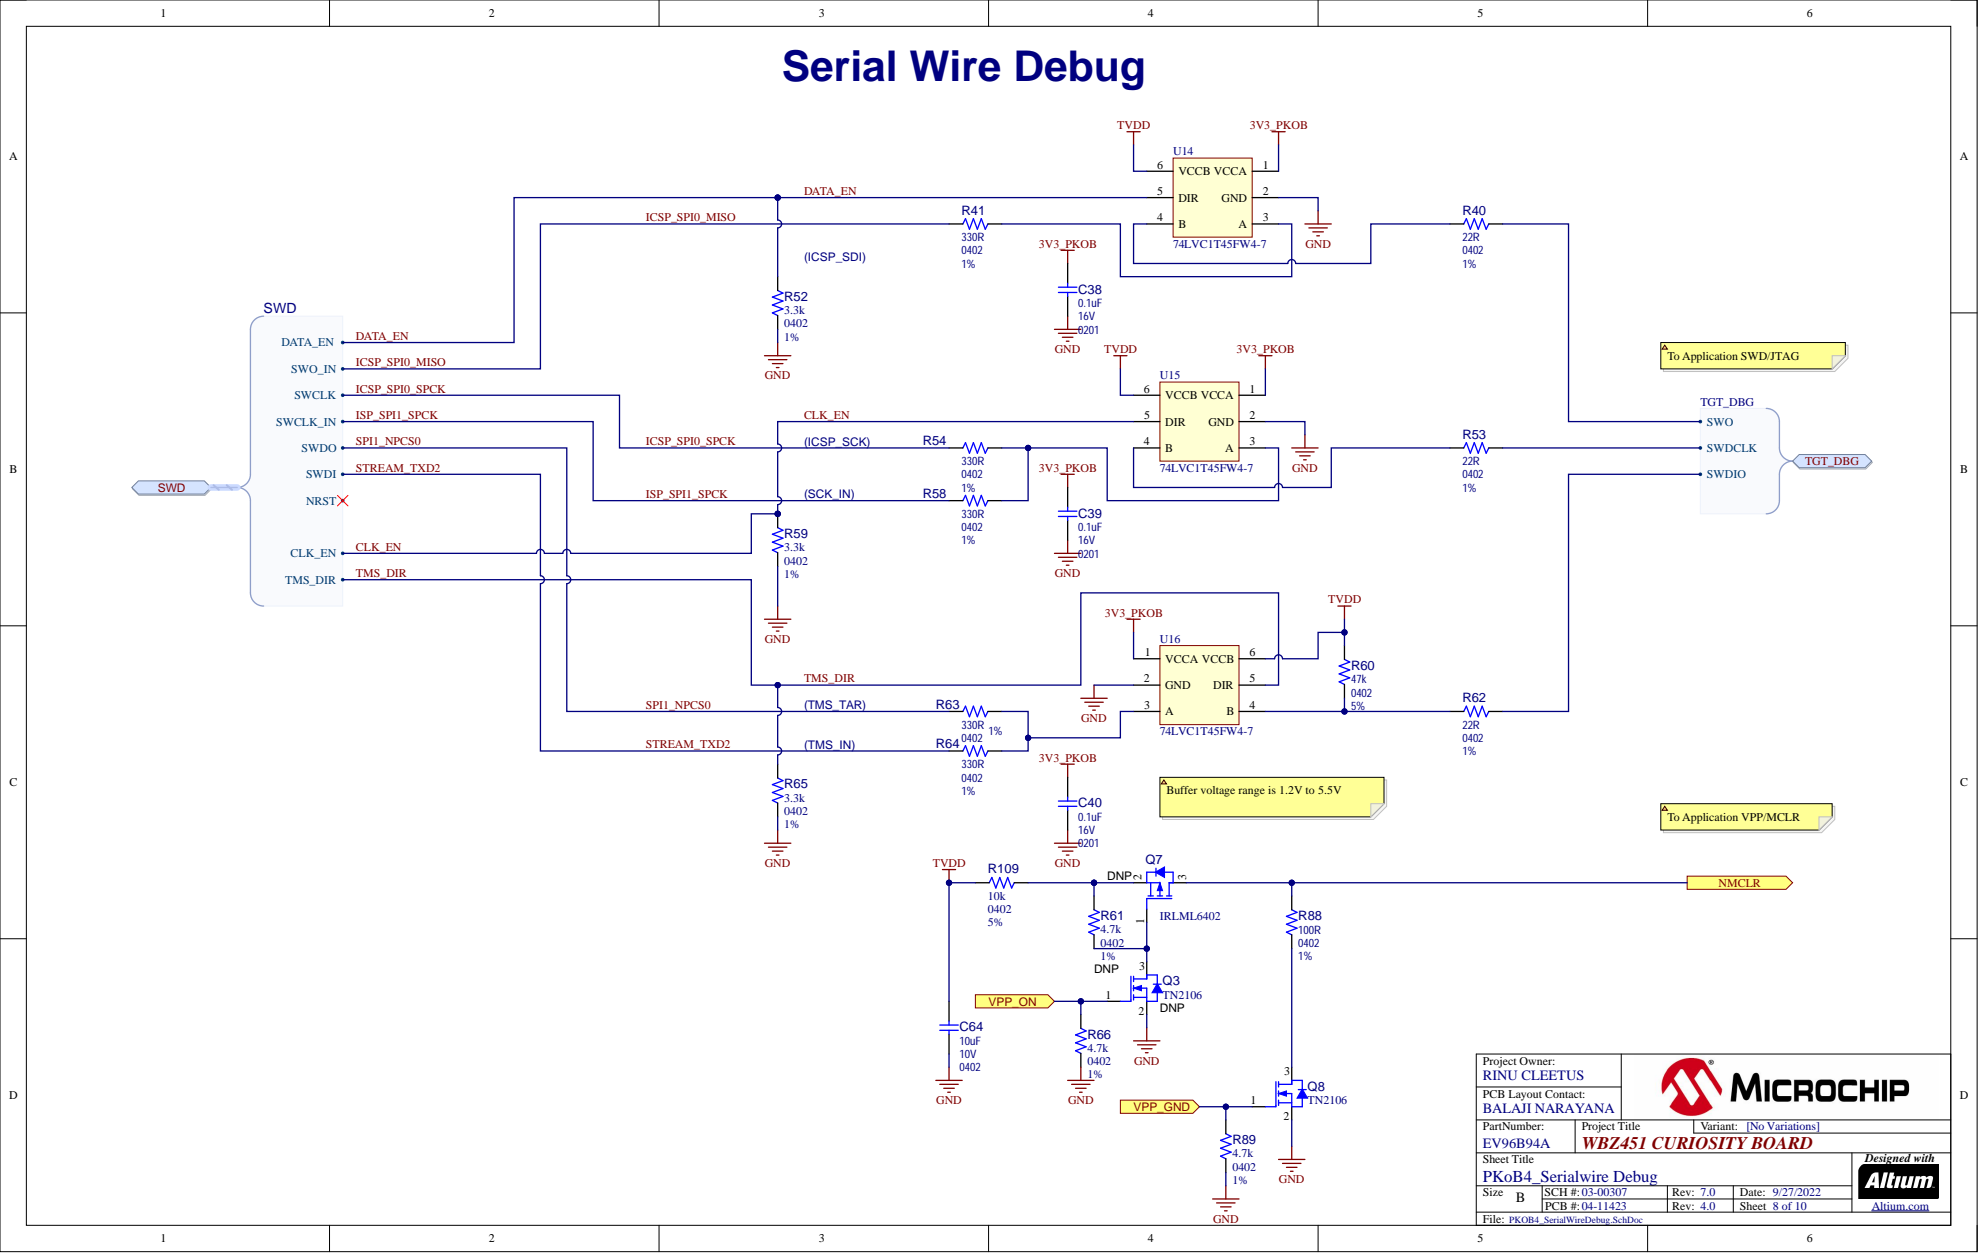
[picture p9: page 8]

To Application SWD/JTAG To Application VPP/MCLR

Buffer voltage range is 1.2V to 5.5V

PKoB4_Serialwire Debug
Size B

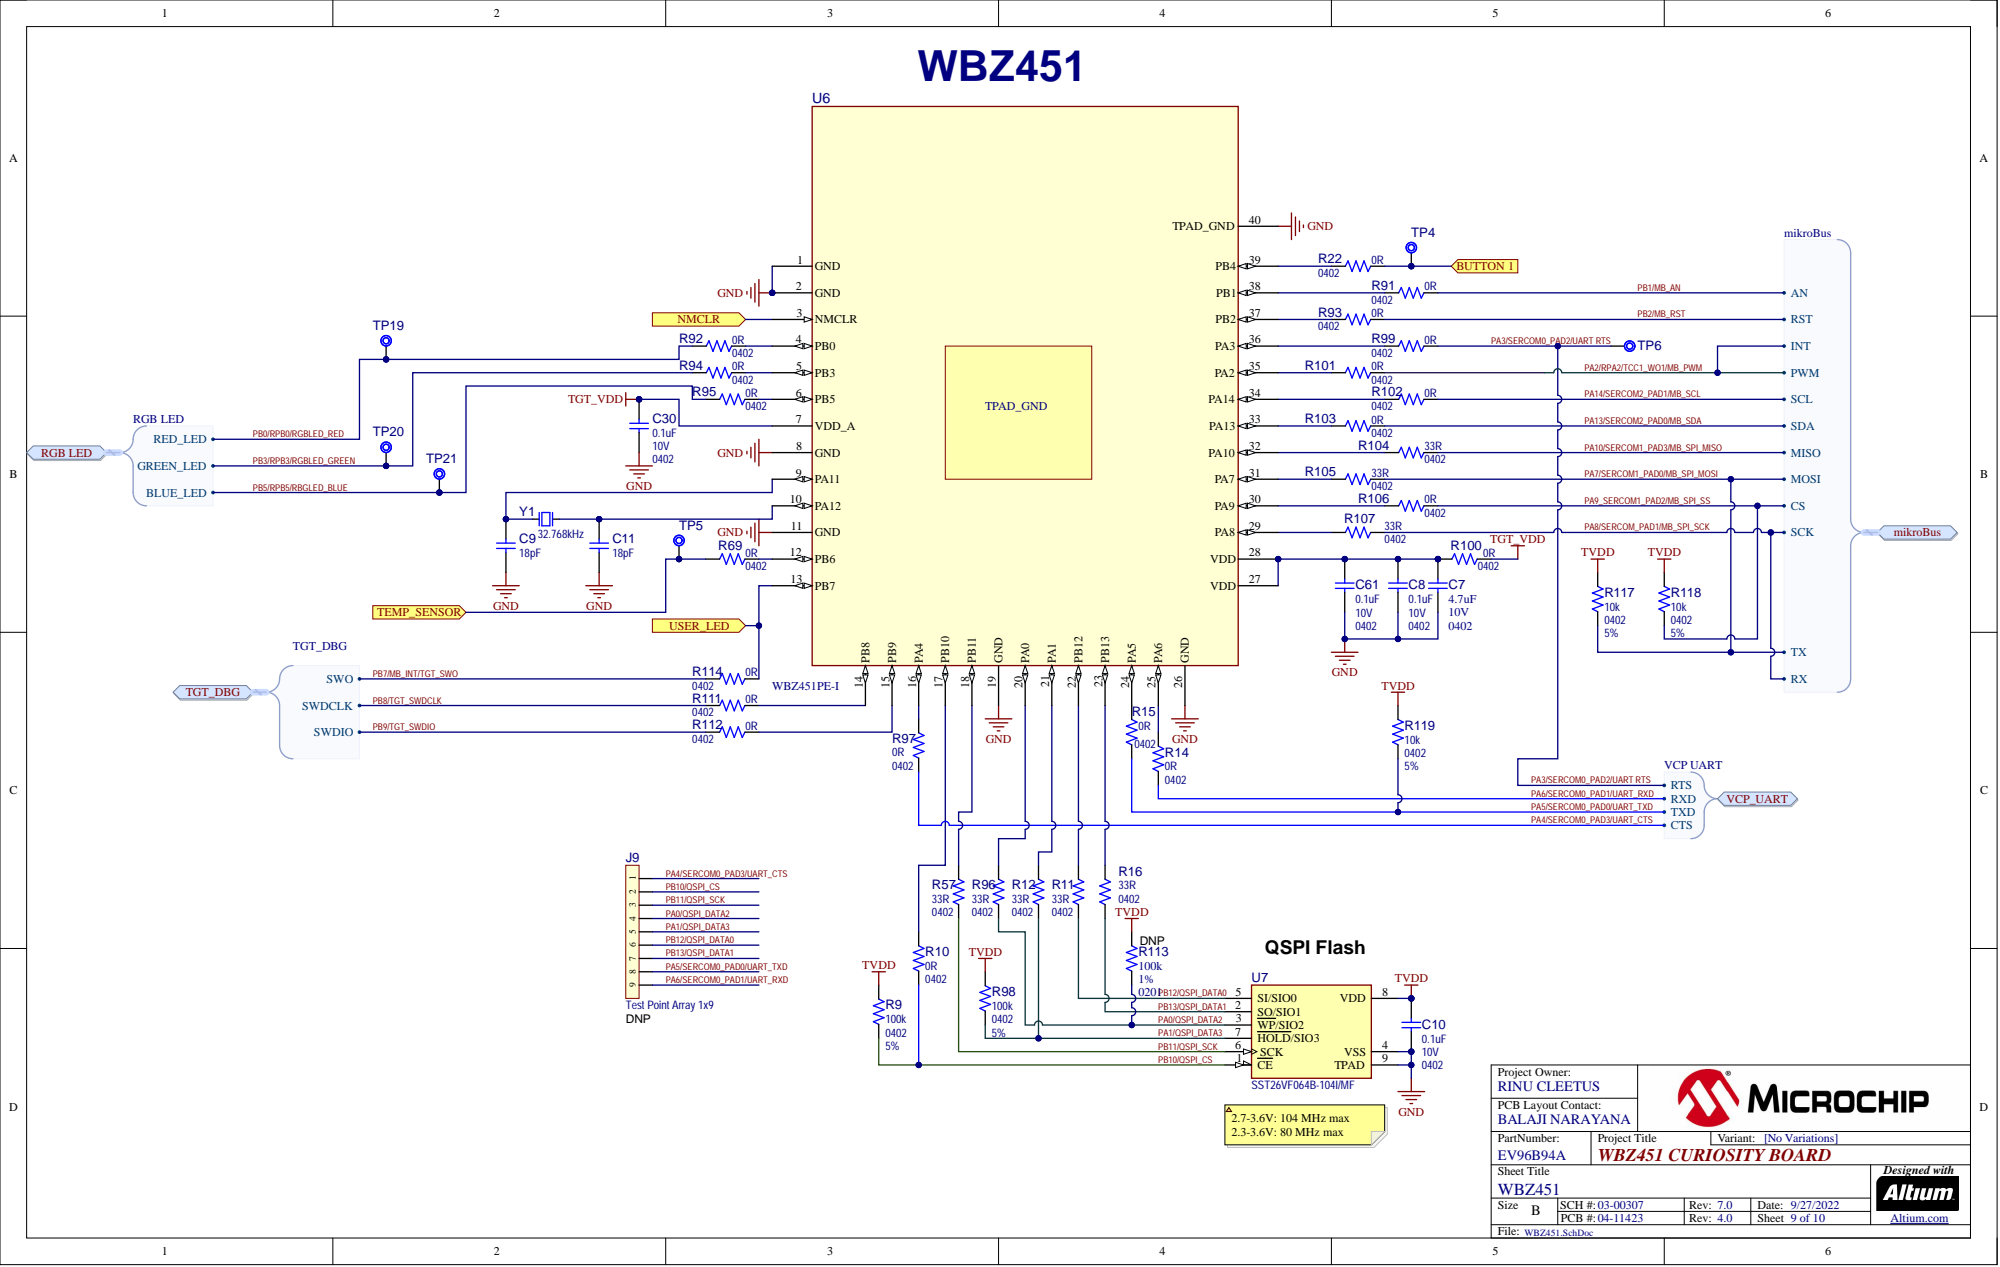
[picture p10: page 9]

GND 2 | 0402

NMCLR 3 | 0402 0R

GND | | PA12 10 | 0402 R106

GND 11 | R107 33R | PA8/SERCOM_PAD1/MB_SPI_SCK

PB6 12 | 0402 | TVDD TVDD R117 10k | R118 10k 0402

0R | 5% | PA3/SERCOM0_PAD2/UART RTS

PA6/SERCOM0_PAD1/UART_RXD

PB13/QSPI_DATA1 | | SO/SIO1 2
PA0/QSPI_DATA2 | | WP/SIO2 3

5% | PA1/QSPI_DATA3 | | HOLD/SIO3 7 SCK 6

5% | | PB11/QSPI_SCK

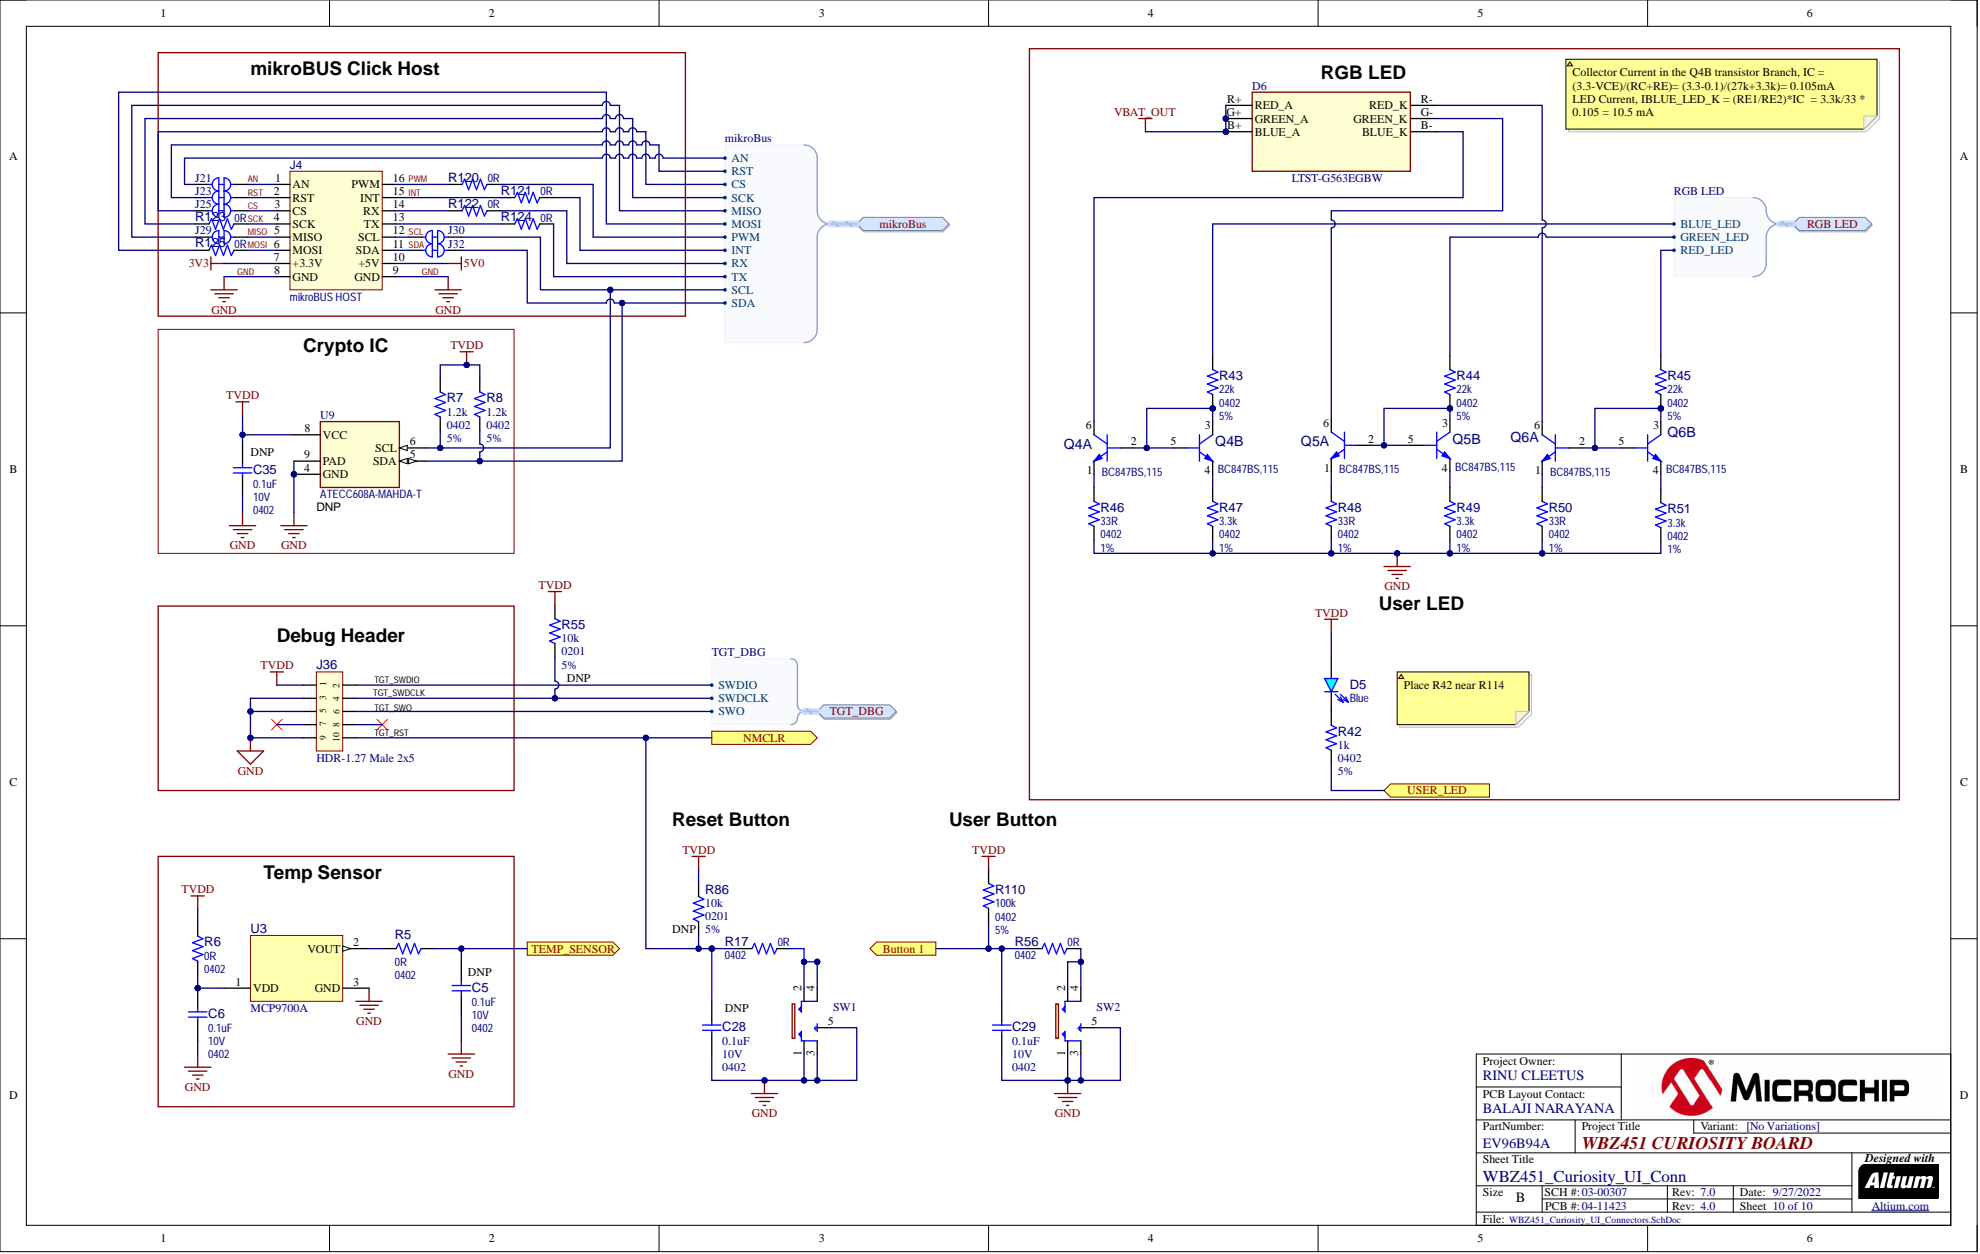
[picture p11: page 10]

Collector Current in the Q4B transistor Branch, IC =
(3.3-VCE)/(RC+RE)= (3.3-0.1)/(27k+3.3k)= 0.105mA
LED Current, IBLUE_LED_K = (RE1/RE2)*IC = 3.3k/33 *

R123 0R | SCK | SCK 4 TX | 13 | R124 0R

MISO 5
