nsaspook/wbz451matter/Gerber/04-11423-R4-D.PDF

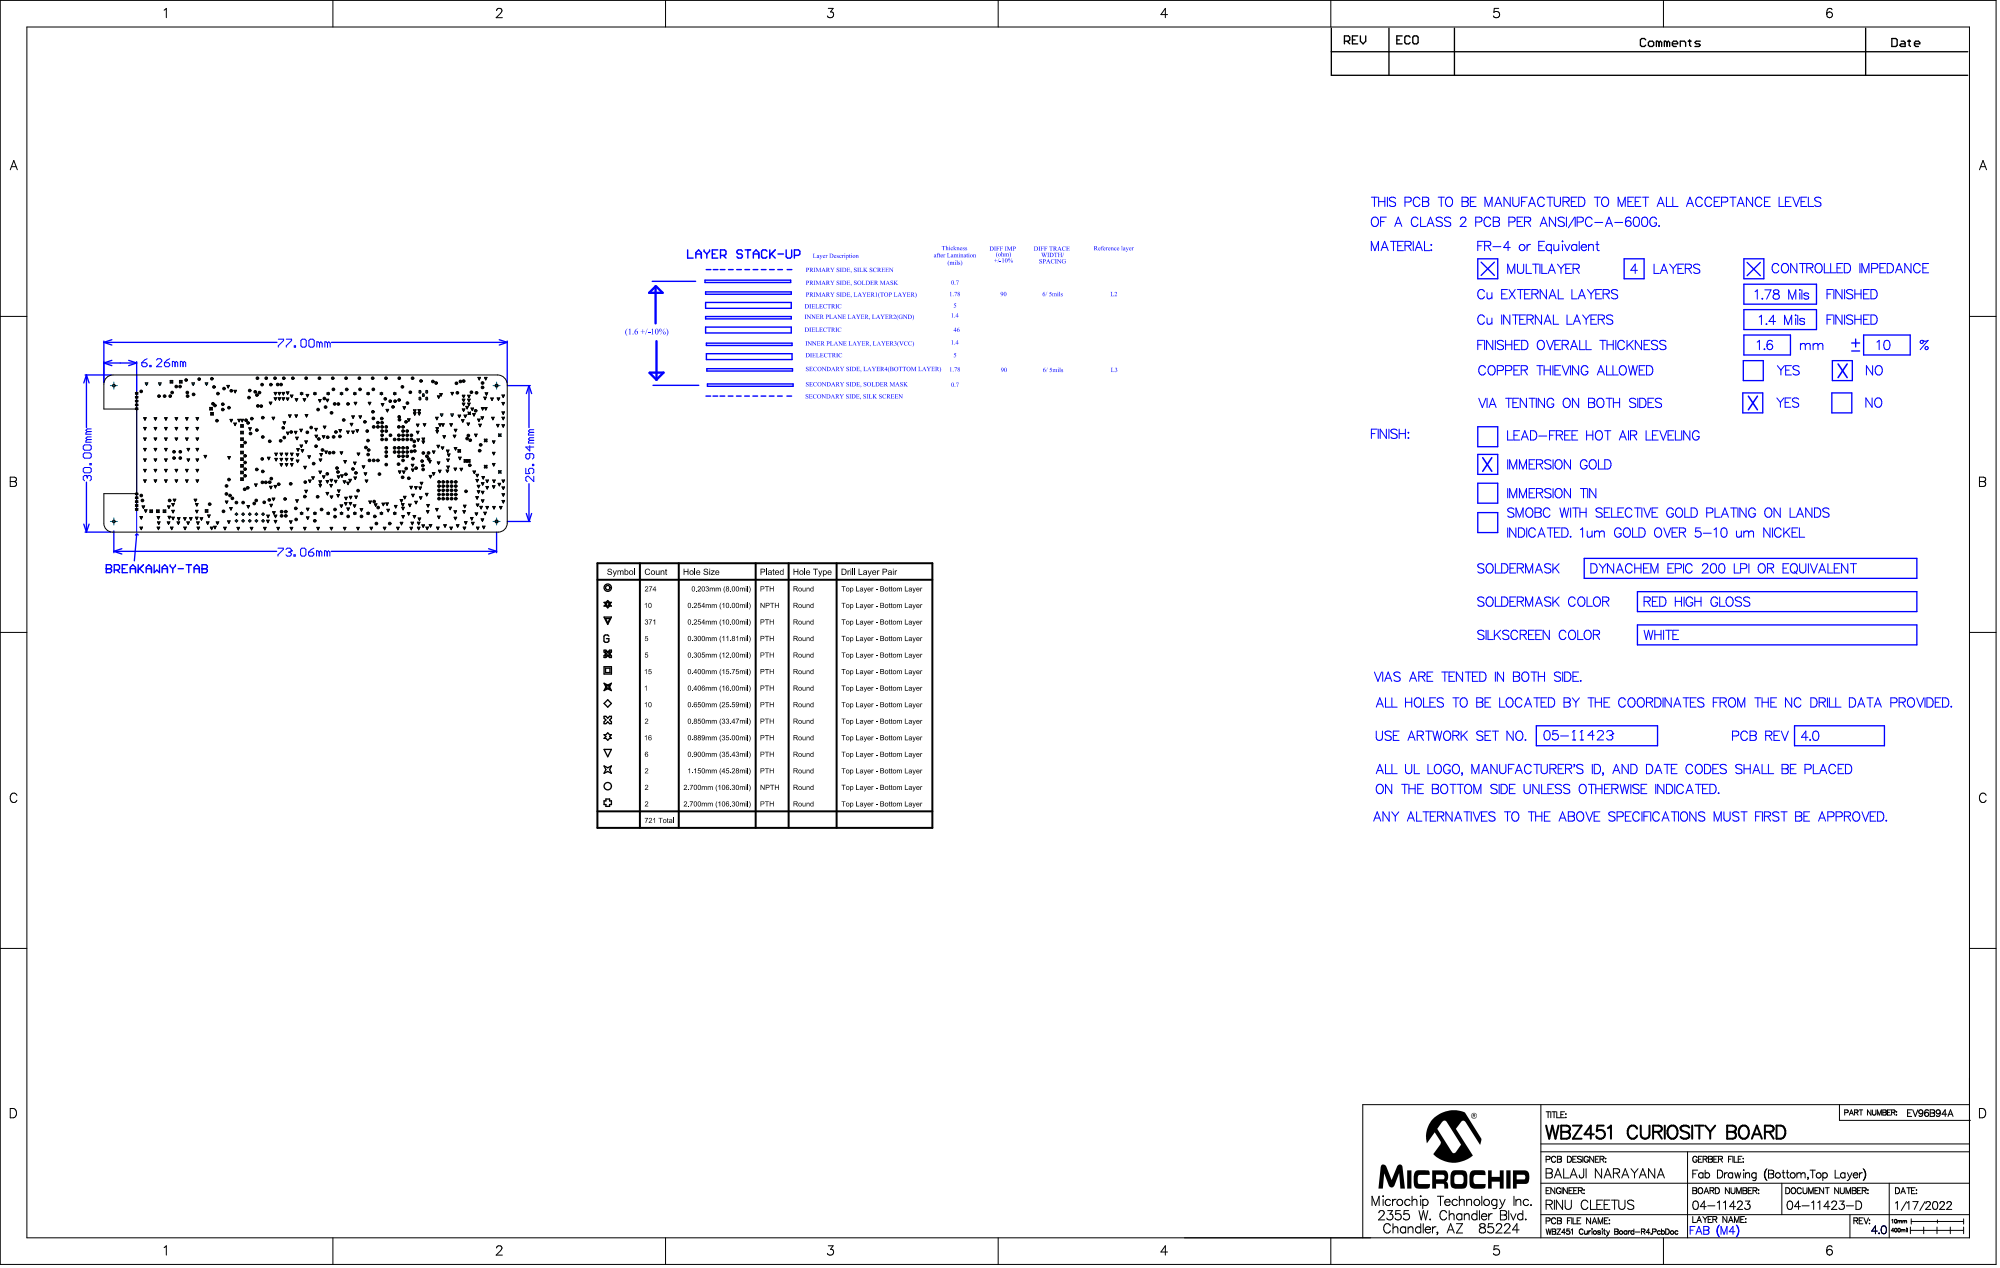
[picture p12: page 1]
