nsaspook/wbz451matter/Gerber/05-00307-R4.PDF

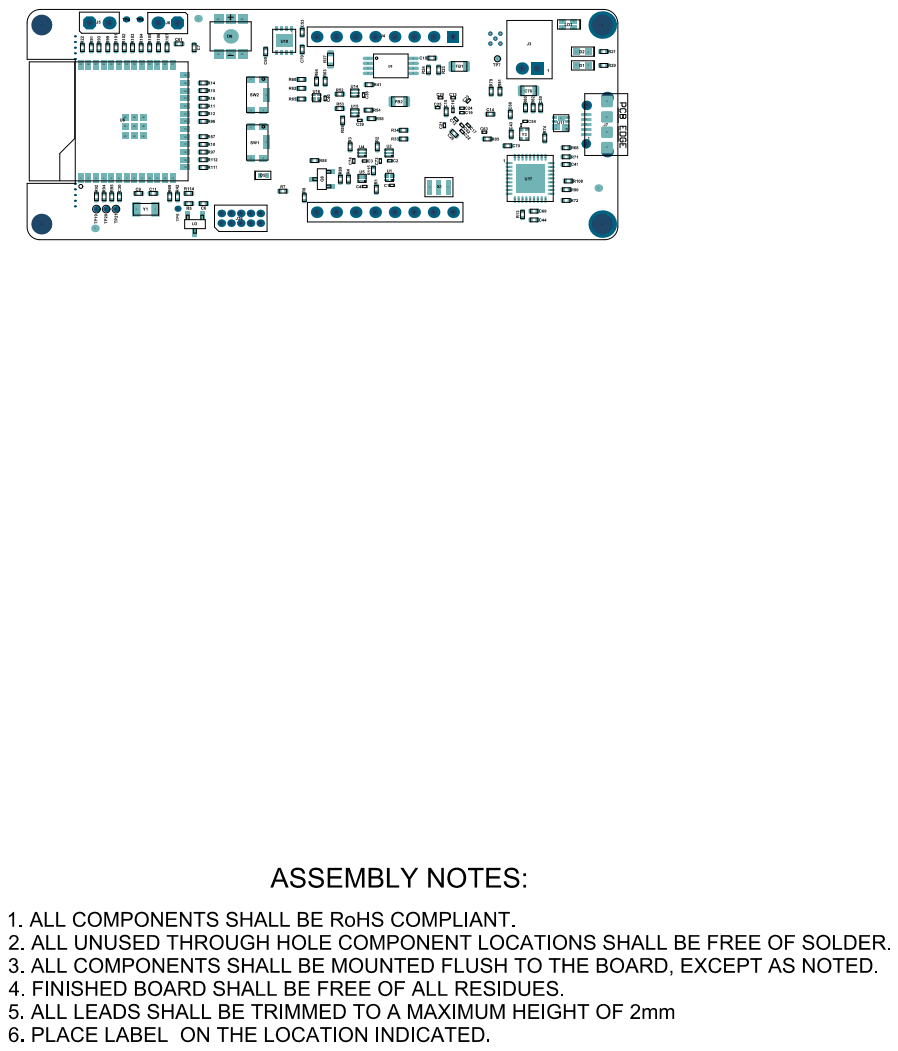
[picture p13: page 1]

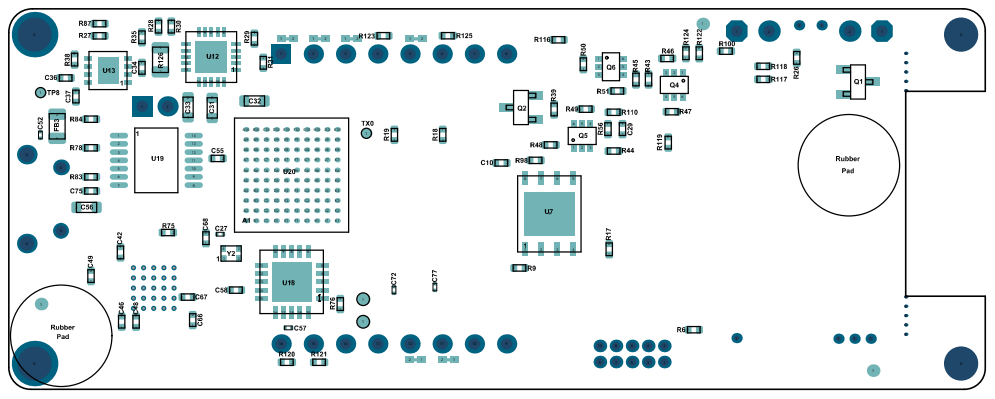
[picture p14: page 2]

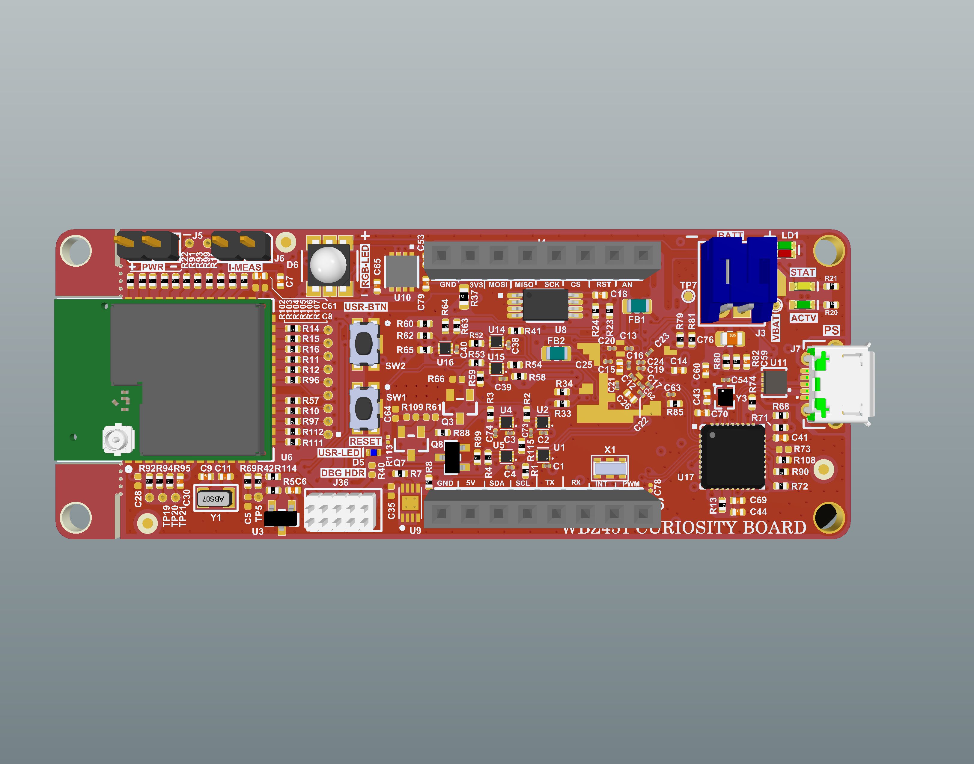
[picture p15: page 3]

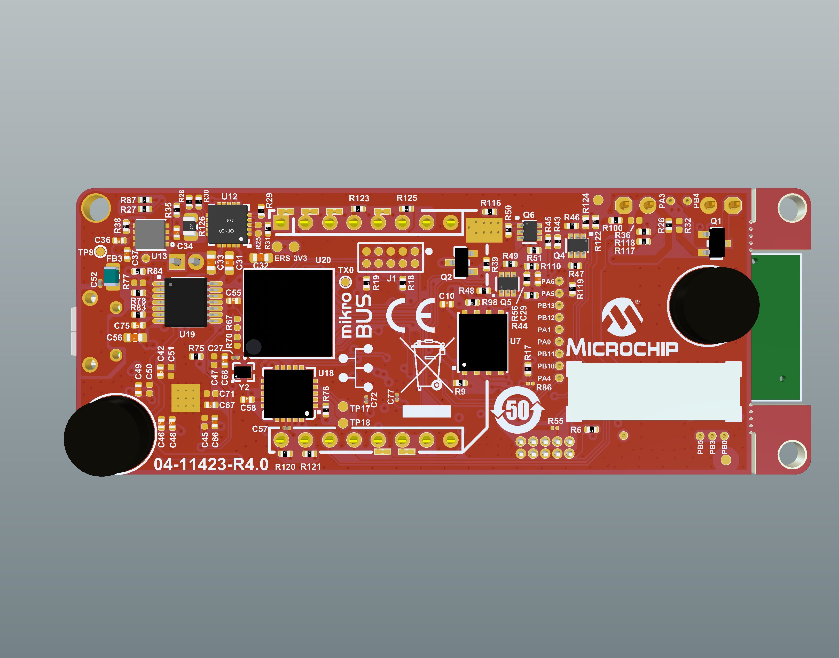
[picture p16: page 4]
