nsaspook/wbz451matter/wbz451pe.brd

## EAGLE design wbz451pe.brd (2024-05-31)

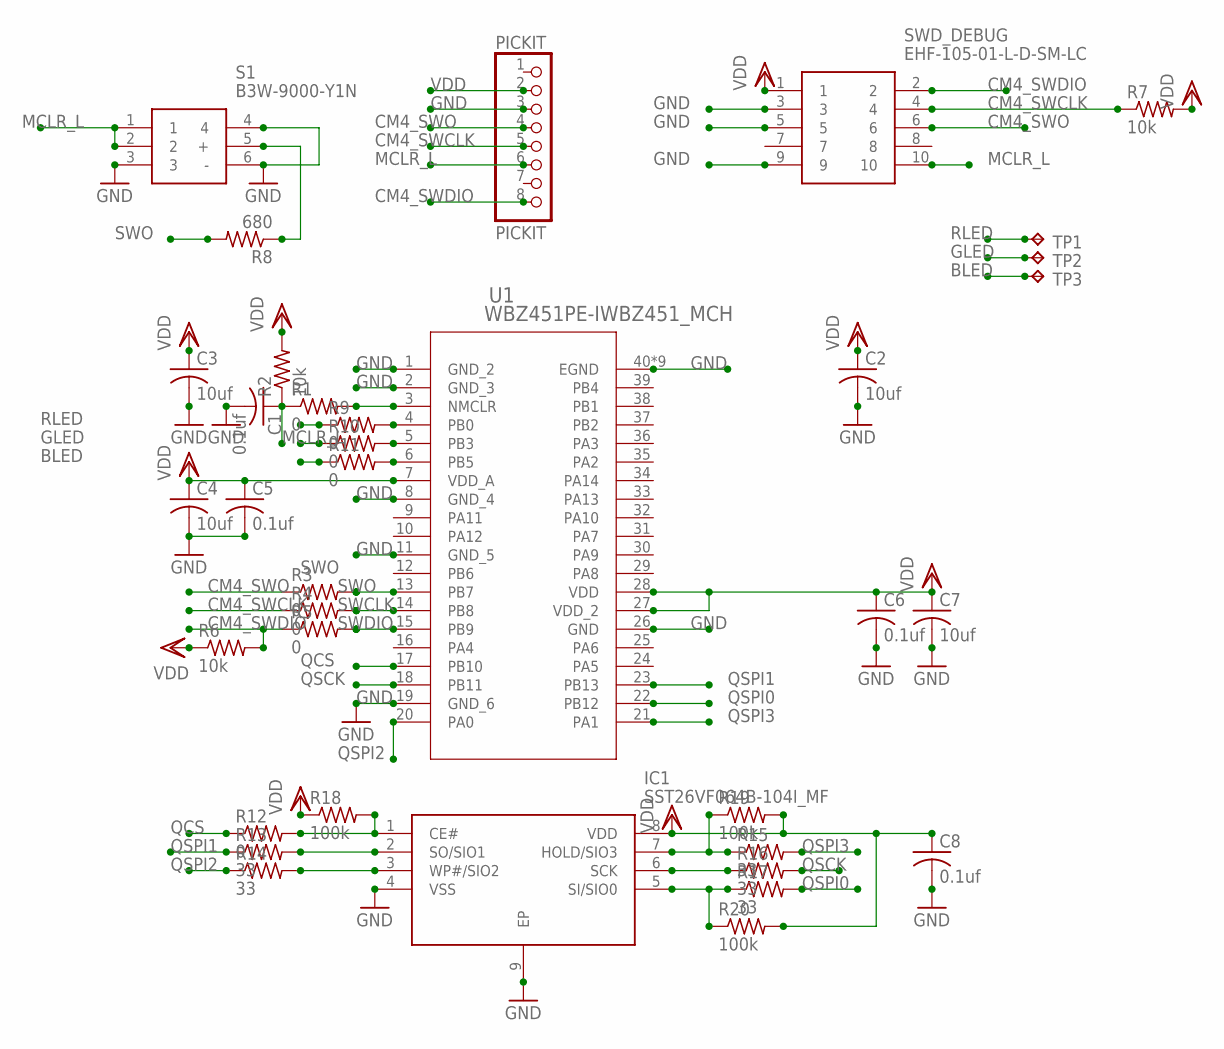
[picture p17: schematic wbz451pe.sch]

Parts:
C1, C5, C6, C8: 0.1uf; C0805
C2, C3, C4, C7: 10uf; C0805
IC1: SST26VF064B-104I_MF; SON127P600X500X80-9N
PICKIT: PICKIT; 1X08
R1, R3, R4, R5, R9, R10, R11: 0; M0805
R2, R6, R7: 10k; M0805
R8: 680; M0805
R12: 0; R0603
R13, R14, R15, R16, R17: 33; R0603
R18, R19, R20: 100k; R0603
S1: B3W-9000-Y1N; B3W-9_1-LED
SWD_DEBUG: EHF-105-01-L-D-SM-LC; EHF-105-01-XX-D-SM-LC
TP1, TP2, TP3: TPPAD1-13; P1-13
U1: WBZ451PE-IWBZ451_MCH; WBZ451_MCH

Connections:
BLED: R11.1, TP3.TP
CM4_SWCLK: PICKIT.5, R4.1, R7.1, SWD_DEBUG.4
CM4_SWDIO: PICKIT.8, R5.1, R6.2, SWD_DEBUG.2
CM4_SWO: PICKIT.4, R3.1, SWD_DEBUG.6
GLED: R10.1, TP2.TP
GND: C1.2, C2.2, C3.2, C4.2, C5.2, C6.2, C7.2, C8.2, IC1.4 (VSS), IC1.9 (EP), PICKIT.3, S1.3, S1.4, S1.6 (-), SWD_DEBUG.3, SWD_DEBUG.5, SWD_DEBUG.9, U1.1 (GND_2), U1.2 (GND_3), U1.8 (GND_4), U1.11 (GND_5), U1.19 (GND_6), U1.26 (GND), U1.40 (EGND), U1.41 (EGND), U1.42 (EGND), U1.43 (EGND), U1.44 (EGND), U1.45 (EGND), U1.46 (EGND), U1.47 (EGND), U1.48 (EGND)
MCLR_L: C1.1, PICKIT.6, R1.1, R2.1, S1.1, S1.2, SWD_DEBUG.10
unnamed: R1.2, U1.3 (NMCLR)
unnamed: R9.2, U1.4 (PB0)
unnamed: R8.1, S1.5 (+)
unnamed: R10.2, U1.5 (PB3)
unnamed: R11.2, U1.6 (PB5)
unnamed: IC1.1 (CE#), R12.2, R18.2
unnamed: IC1.2 (SO/SIO1), R13.2
unnamed: IC1.3 (WP#/SIO2), R14.2
unnamed: IC1.7 (HOLD/SIO3), R15.1, R19.1
unnamed: IC1.6 (SCK), R16.1
unnamed: IC1.5 (SI/SIO0), R17.1, R20.1
QCS: R12.1, U1.17 (PB10)
QSCK: R16.2, U1.18 (PB11)
QSPI0: R17.2, U1.22 (PB12)
QSPI1: R13.1, U1.23 (PB13)
QSPI2: R14.1, U1.20 (PA0)
QSPI3: R15.2, U1.21 (PA1)
RLED: R9.1, TP1.TP
SWCLK: R4.2, U1.14 (PB8)
SWDIO: R5.2, U1.15 (PB9)
SWO: R3.2, R8.2, U1.13 (PB7)
VDD: C2.1, C3.1, C4.1, C5.1, C6.1, C7.1, C8.1, IC1.8 (VDD), PICKIT.2, R2.2, R6.1, R7.2, R18.1, R19.2, R20.2, SWD_DEBUG.1, U1.7 (VDD_A), U1.27 (VDD_2), U1.28 (VDD)

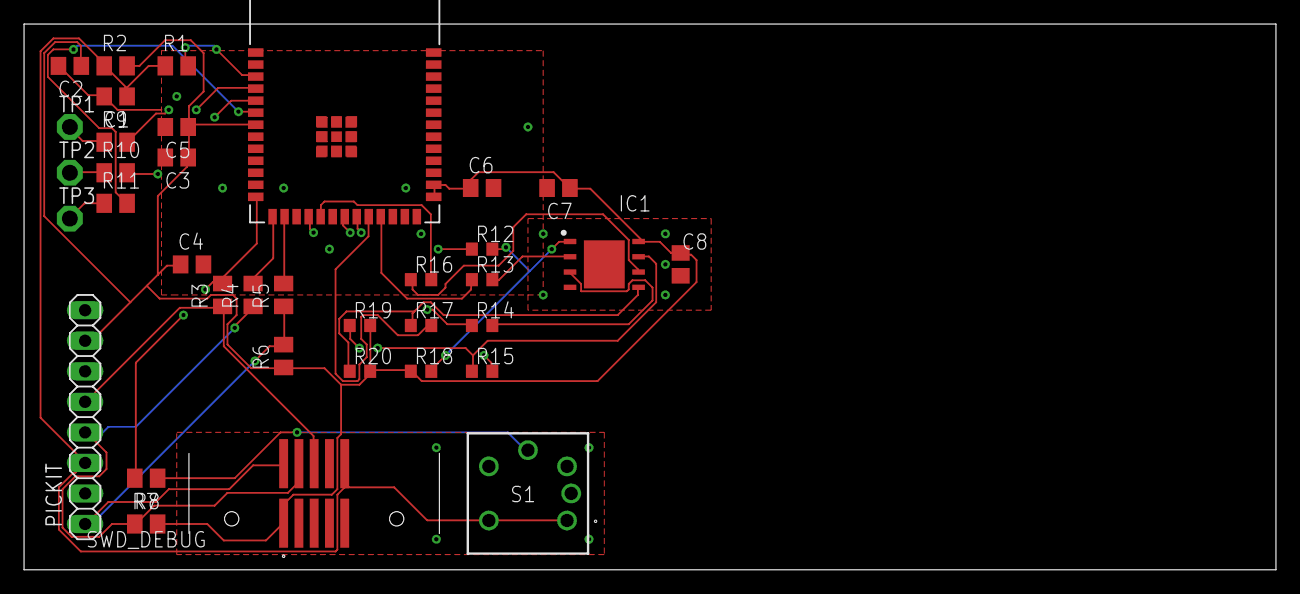
[picture p18: board wbz451pe.brd from above]

Board: 4 copper layers, 104.1 x 45.4 mm, 36 parts (0 on the bottom side), 29 nets.
