nsaspook/wbz451matter/src/packs/WBZ451_DFP/component/adchs.h

/*
 * Component description for ADCHS
 *
 * Copyright (c) 2023 Microchip Technology Inc. and its subsidiaries.
 *
 * Licensed under the Apache License, Version 2.0 (the "License");
 * you may not use this file except in compliance with the License.
 * You may obtain a copy of the License at
 *
 *   http://www.apache.org/licenses/LICENSE-2.0
 *
 * Unless required by applicable law or agreed to in writing, software
 * distributed under the License is distributed on an "AS IS" BASIS,
 * WITHOUT WARRANTIES OR CONDITIONS OF ANY KIND, either express or implied.
 * See the License for the specific language governing permissions and
 * limitations under the License.
 *
 */

/* file generated from device description file (ATDF) version 2023-10-17T09:04:59Z */
#ifndef _BZ45_ADCHS_COMPONENT_H_
#define _BZ45_ADCHS_COMPONENT_H_

/* ************************************************************************** */
/*   SOFTWARE API DEFINITION FOR ADCHS                                        */
/* ************************************************************************** */

/* -------- ADCHS_ADCCON1 : (ADCHS Offset: 0x00) (R/W 32)  -------- */
#define ADCHS_ADCCON1_RESETVALUE              _UINT32_(0x00)                                       /*  (ADCHS_ADCCON1)   Reset Value */

#define ADCHS_ADCCON1_DMABL_Pos               _UINT32_(0)                                          /* (ADCHS_ADCCON1) DMA to System RAM Buffer Length Size bits Position */
#define ADCHS_ADCCON1_DMABL_Msk               (_UINT32_(0x7) << ADCHS_ADCCON1_DMABL_Pos)           /* (ADCHS_ADCCON1) DMA to System RAM Buffer Length Size bits Mask */
#define ADCHS_ADCCON1_DMABL(value)            (ADCHS_ADCCON1_DMABL_Msk & (_UINT32_(value) << ADCHS_ADCCON1_DMABL_Pos)) /* Assigment of value for DMABL in the ADCHS_ADCCON1 register */
#define   ADCHS_ADCCON1_DMABL_128_DMABL_Val   _UINT32_(0x7)                                        /* (ADCHS_ADCCON1) Allocates 128 locations in system memory to each analog input  */
#define   ADCHS_ADCCON1_DMABL_64_DMABL_Val    _UINT32_(0x6)                                        /* (ADCHS_ADCCON1) Allocates 64 locations in system memory to each analog input  */
#define   ADCHS_ADCCON1_DMABL_32_DMABL_Val    _UINT32_(0x5)                                        /* (ADCHS_ADCCON1) Allocates 32 locations in system memory to each analog input  */
#define   ADCHS_ADCCON1_DMABL_16_DMABL_Val    _UINT32_(0x4)                                        /* (ADCHS_ADCCON1) Allocates 16 locations in system memory to each analog input  */
#define   ADCHS_ADCCON1_DMABL_8_DMABL_Val     _UINT32_(0x3)                                        /* (ADCHS_ADCCON1) Allocates 8 locations in system memory to each analog input  */
#define   ADCHS_ADCCON1_DMABL_4_DMABL_Val     _UINT32_(0x2)                                        /* (ADCHS_ADCCON1) Allocates 4 locations in system memory to each analog input  */
#define   ADCHS_ADCCON1_DMABL_2_DMABL_Val     _UINT32_(0x1)                                        /* (ADCHS_ADCCON1) Allocates 2 locations in system memory to each analog input  */
#define   ADCHS_ADCCON1_DMABL_1_DMABL_Val     _UINT32_(0x0)                                        /* (ADCHS_ADCCON1) Allocates 1 location in system memory to each analog input  */
#define ADCHS_ADCCON1_DMABL_128_DMABL         (ADCHS_ADCCON1_DMABL_128_DMABL_Val << ADCHS_ADCCON1_DMABL_Pos) /* (ADCHS_ADCCON1) Allocates 128 locations in system memory to each analog input Position  */
#define ADCHS_ADCCON1_DMABL_64_DMABL          (ADCHS_ADCCON1_DMABL_64_DMABL_Val << ADCHS_ADCCON1_DMABL_Pos) /* (ADCHS_ADCCON1) Allocates 64 locations in system memory to each analog input Position  */
#define ADCHS_ADCCON1_DMABL_32_DMABL          (ADCHS_ADCCON1_DMABL_32_DMABL_Val << ADCHS_ADCCON1_DMABL_Pos) /* (ADCHS_ADCCON1) Allocates 32 locations in system memory to each analog input Position  */
#define ADCHS_ADCCON1_DMABL_16_DMABL          (ADCHS_ADCCON1_DMABL_16_DMABL_Val << ADCHS_ADCCON1_DMABL_Pos) /* (ADCHS_ADCCON1) Allocates 16 locations in system memory to each analog input Position  */
#define ADCHS_ADCCON1_DMABL_8_DMABL           (ADCHS_ADCCON1_DMABL_8_DMABL_Val << ADCHS_ADCCON1_DMABL_Pos) /* (ADCHS_ADCCON1) Allocates 8 locations in system memory to each analog input Position  */
#define ADCHS_ADCCON1_DMABL_4_DMABL           (ADCHS_ADCCON1_DMABL_4_DMABL_Val << ADCHS_ADCCON1_DMABL_Pos) /* (ADCHS_ADCCON1) Allocates 4 locations in system memory to each analog input Position  */
#define ADCHS_ADCCON1_DMABL_2_DMABL           (ADCHS_ADCCON1_DMABL_2_DMABL_Val << ADCHS_ADCCON1_DMABL_Pos) /* (ADCHS_ADCCON1) Allocates 2 locations in system memory to each analog input Position  */
#define ADCHS_ADCCON1_DMABL_1_DMABL           (ADCHS_ADCCON1_DMABL_1_DMABL_Val << ADCHS_ADCCON1_DMABL_Pos) /* (ADCHS_ADCCON1) Allocates 1 location in system memory to each analog input Position  */
#define ADCHS_ADCCON1_STRGLVL_Pos             _UINT32_(3)                                          /* (ADCHS_ADCCON1) Scan Trigger High Level/Positive Edge Sensitivity bit Position */
#define ADCHS_ADCCON1_STRGLVL_Msk             (_UINT32_(0x1) << ADCHS_ADCCON1_STRGLVL_Pos)         /* (ADCHS_ADCCON1) Scan Trigger High Level/Positive Edge Sensitivity bit Mask */
#define ADCHS_ADCCON1_STRGLVL(value)          (ADCHS_ADCCON1_STRGLVL_Msk & (_UINT32_(value) << ADCHS_ADCCON1_STRGLVL_Pos)) /* Assigment of value for STRGLVL in the ADCHS_ADCCON1 register */
#define   ADCHS_ADCCON1_STRGLVL_SCTRIG_HIGH_Val _UINT32_(0x1)                                        /* (ADCHS_ADCCON1) Scan trigger is high level sensitive. Once STRIG mode is selected the scan trigger will continue for all selected analog inputs  */
#define   ADCHS_ADCCON1_STRGLVL_SCTRIG_POSEDGE_Val _UINT32_(0x0)                                        /* (ADCHS_ADCCON1) Scan trigger is positive edge sensitive. Once STRIG mode is selected only a single scan trigger will be generated which will complete the scan of all selected analog inputs. (TRGSRCx in the ADCTRGx register)  */
#define ADCHS_ADCCON1_STRGLVL_SCTRIG_HIGH     (ADCHS_ADCCON1_STRGLVL_SCTRIG_HIGH_Val << ADCHS_ADCCON1_STRGLVL_Pos) /* (ADCHS_ADCCON1) Scan trigger is high level sensitive. Once STRIG mode is selected the scan trigger will continue for all selected analog inputs Position  */
#define ADCHS_ADCCON1_STRGLVL_SCTRIG_POSEDGE  (ADCHS_ADCCON1_STRGLVL_SCTRIG_POSEDGE_Val << ADCHS_ADCCON1_STRGLVL_Pos) /* (ADCHS_ADCCON1) Scan trigger is positive edge sensitive. Once STRIG mode is selected only a single scan trigger will be generated which will complete the scan of all selected analog inputs. (TRGSRCx in the ADCTRGx register) Position  */
#define ADCHS_ADCCON1_IRQVS_Pos               _UINT32_(4)                                          /* (ADCHS_ADCCON1) Interrupt Vector Shift bits Position */
#define ADCHS_ADCCON1_IRQVS_Msk               (_UINT32_(0x7) << ADCHS_ADCCON1_IRQVS_Pos)           /* (ADCHS_ADCCON1) Interrupt Vector Shift bits Mask */
#define ADCHS_ADCCON1_IRQVS(value)            (ADCHS_ADCCON1_IRQVS_Msk & (_UINT32_(value) << ADCHS_ADCCON1_IRQVS_Pos)) /* Assigment of value for IRQVS in the ADCHS_ADCCON1 register */
#define   ADCHS_ADCCON1_IRQVS_SHL_7_Val       _UINT32_(0x7)                                        /* (ADCHS_ADCCON1) Shift x left 7 bit position  */
#define   ADCHS_ADCCON1_IRQVS_SHL_6_Val       _UINT32_(0x6)                                        /* (ADCHS_ADCCON1) Shift x left 6 bit position  */
#define   ADCHS_ADCCON1_IRQVS_SHL_5_Val       _UINT32_(0x5)                                        /* (ADCHS_ADCCON1) Shift x left 5 bit position  */
#define   ADCHS_ADCCON1_IRQVS_SHL_4_Val       _UINT32_(0x4)                                        /* (ADCHS_ADCCON1) Shift x left 4 bit position  */
#define   ADCHS_ADCCON1_IRQVS_SHL_3_Val       _UINT32_(0x3)                                        /* (ADCHS_ADCCON1) Shift x left 3 bit position  */
#define   ADCHS_ADCCON1_IRQVS_SHL_2_Val       _UINT32_(0x2)                                        /* (ADCHS_ADCCON1) Shift x left 2 bit position  */
#define   ADCHS_ADCCON1_IRQVS_SHL_1_Val       _UINT32_(0x1)                                        /* (ADCHS_ADCCON1) Shift x left 1 bit position  */
#define   ADCHS_ADCCON1_IRQVS_SHL_0_Val       _UINT32_(0x0)                                        /* (ADCHS_ADCCON1) Shift x left 0 bit position  */
#define ADCHS_ADCCON1_IRQVS_SHL_7             (ADCHS_ADCCON1_IRQVS_SHL_7_Val << ADCHS_ADCCON1_IRQVS_Pos) /* (ADCHS_ADCCON1) Shift x left 7 bit position Position  */
#define ADCHS_ADCCON1_IRQVS_SHL_6             (ADCHS_ADCCON1_IRQVS_SHL_6_Val << ADCHS_ADCCON1_IRQVS_Pos) /* (ADCHS_ADCCON1) Shift x left 6 bit position Position  */
#define ADCHS_ADCCON1_IRQVS_SHL_5             (ADCHS_ADCCON1_IRQVS_SHL_5_Val << ADCHS_ADCCON1_IRQVS_Pos) /* (ADCHS_ADCCON1) Shift x left 5 bit position Position  */
#define ADCHS_ADCCON1_IRQVS_SHL_4             (ADCHS_ADCCON1_IRQVS_SHL_4_Val << ADCHS_ADCCON1_IRQVS_Pos) /* (ADCHS_ADCCON1) Shift x left 4 bit position Position  */
#define ADCHS_ADCCON1_IRQVS_SHL_3             (ADCHS_ADCCON1_IRQVS_SHL_3_Val << ADCHS_ADCCON1_IRQVS_Pos) /* (ADCHS_ADCCON1) Shift x left 3 bit position Position  */
#define ADCHS_ADCCON1_IRQVS_SHL_2             (ADCHS_ADCCON1_IRQVS_SHL_2_Val << ADCHS_ADCCON1_IRQVS_Pos) /* (ADCHS_ADCCON1) Shift x left 2 bit position Position  */
#define ADCHS_ADCCON1_IRQVS_SHL_1             (ADCHS_ADCCON1_IRQVS_SHL_1_Val << ADCHS_ADCCON1_IRQVS_Pos) /* (ADCHS_ADCCON1) Shift x left 1 bit position Position  */
#define ADCHS_ADCCON1_IRQVS_SHL_0             (ADCHS_ADCCON1_IRQVS_SHL_0_Val << ADCHS_ADCCON1_IRQVS_Pos) /* (ADCHS_ADCCON1) Shift x left 0 bit position Position  */
#define ADCHS_ADCCON1_SCANEN_Pos              _UINT32_(8)                                          /* (ADCHS_ADCCON1)  Position */
#define ADCHS_ADCCON1_SCANEN_Msk              (_UINT32_(0x1) << ADCHS_ADCCON1_SCANEN_Pos)          /* (ADCHS_ADCCON1)  Mask */
#define ADCHS_ADCCON1_SCANEN(value)           (ADCHS_ADCCON1_SCANEN_Msk & (_UINT32_(value) << ADCHS_ADCCON1_SCANEN_Pos)) /* Assigment of value for SCANEN in the ADCHS_ADCCON1 register */
#define ADCHS_ADCCON1_FSYUPB_Pos              _UINT32_(9)                                          /* (ADCHS_ADCCON1)  Position */
#define ADCHS_ADCCON1_FSYUPB_Msk              (_UINT32_(0x1) << ADCHS_ADCCON1_FSYUPB_Pos)          /* (ADCHS_ADCCON1)  Mask */
#define ADCHS_ADCCON1_FSYUPB(value)           (ADCHS_ADCCON1_FSYUPB_Msk & (_UINT32_(value) << ADCHS_ADCCON1_FSYUPB_Pos)) /* Assigment of value for FSYUPB in the ADCHS_ADCCON1 register */
#define ADCHS_ADCCON1_FSYDMA_Pos              _UINT32_(10)                                         /* (ADCHS_ADCCON1)  Position */
#define ADCHS_ADCCON1_FSYDMA_Msk              (_UINT32_(0x1) << ADCHS_ADCCON1_FSYDMA_Pos)          /* (ADCHS_ADCCON1)  Mask */
#define ADCHS_ADCCON1_FSYDMA(value)           (ADCHS_ADCCON1_FSYDMA_Msk & (_UINT32_(value) << ADCHS_ADCCON1_FSYDMA_Pos)) /* Assigment of value for FSYDMA in the ADCHS_ADCCON1 register */
#define ADCHS_ADCCON1_SIDL_Pos                _UINT32_(13)                                         /* (ADCHS_ADCCON1) Stop in Idle Mode bit Position */
#define ADCHS_ADCCON1_SIDL_Msk                (_UINT32_(0x1) << ADCHS_ADCCON1_SIDL_Pos)            /* (ADCHS_ADCCON1) Stop in Idle Mode bit Mask */
#define ADCHS_ADCCON1_SIDL(value)             (ADCHS_ADCCON1_SIDL_Msk & (_UINT32_(value) << ADCHS_ADCCON1_SIDL_Pos)) /* Assigment of value for SIDL in the ADCHS_ADCCON1 register */
#define   ADCHS_ADCCON1_SIDL_DISCONTINUE_Val  _UINT32_(0x1)                                        /* (ADCHS_ADCCON1) Discontinue module operation when device enters Idle mode  */
#define   ADCHS_ADCCON1_SIDL_CONTINUE_Val     _UINT32_(0x0)                                        /* (ADCHS_ADCCON1) Continue module operation in Idle mode  */
#define ADCHS_ADCCON1_SIDL_DISCONTINUE        (ADCHS_ADCCON1_SIDL_DISCONTINUE_Val << ADCHS_ADCCON1_SIDL_Pos) /* (ADCHS_ADCCON1) Discontinue module operation when device enters Idle mode Position  */
#define ADCHS_ADCCON1_SIDL_CONTINUE           (ADCHS_ADCCON1_SIDL_CONTINUE_Val << ADCHS_ADCCON1_SIDL_Pos) /* (ADCHS_ADCCON1) Continue module operation in Idle mode Position  */
#define ADCHS_ADCCON1_FRZ_Pos                 _UINT32_(14)                                         /* (ADCHS_ADCCON1)  Position */
#define ADCHS_ADCCON1_FRZ_Msk                 (_UINT32_(0x1) << ADCHS_ADCCON1_FRZ_Pos)             /* (ADCHS_ADCCON1)  Mask */
#define ADCHS_ADCCON1_FRZ(value)              (ADCHS_ADCCON1_FRZ_Msk & (_UINT32_(value) << ADCHS_ADCCON1_FRZ_Pos)) /* Assigment of value for FRZ in the ADCHS_ADCCON1 register */
#define ADCHS_ADCCON1_ON_Pos                  _UINT32_(15)                                         /* (ADCHS_ADCCON1) ADC Module Enable bit Position */
#define ADCHS_ADCCON1_ON_Msk                  (_UINT32_(0x1) << ADCHS_ADCCON1_ON_Pos)              /* (ADCHS_ADCCON1) ADC Module Enable bit Mask */
#define ADCHS_ADCCON1_ON(value)               (ADCHS_ADCCON1_ON_Msk & (_UINT32_(value) << ADCHS_ADCCON1_ON_Pos)) /* Assigment of value for ON in the ADCHS_ADCCON1 register */
#define   ADCHS_ADCCON1_ON_ENABLED_Val        _UINT32_(0x1)                                        /* (ADCHS_ADCCON1) ADC module is enabled  */
#define   ADCHS_ADCCON1_ON_DISABLED_Val       _UINT32_(0x0)                                        /* (ADCHS_ADCCON1) ADC module is disabled  */
#define ADCHS_ADCCON1_ON_ENABLED              (ADCHS_ADCCON1_ON_ENABLED_Val << ADCHS_ADCCON1_ON_Pos) /* (ADCHS_ADCCON1) ADC module is enabled Position  */
#define ADCHS_ADCCON1_ON_DISABLED             (ADCHS_ADCCON1_ON_DISABLED_Val << ADCHS_ADCCON1_ON_Pos) /* (ADCHS_ADCCON1) ADC module is disabled Position  */
#define ADCHS_ADCCON1_STRGSRC_Pos             _UINT32_(16)                                         /* (ADCHS_ADCCON1) Scan Trigger Source Select bits Position */
#define ADCHS_ADCCON1_STRGSRC_Msk             (_UINT32_(0x1F) << ADCHS_ADCCON1_STRGSRC_Pos)        /* (ADCHS_ADCCON1) Scan Trigger Source Select bits Mask */
#define ADCHS_ADCCON1_STRGSRC(value)          (ADCHS_ADCCON1_STRGSRC_Msk & (_UINT32_(value) << ADCHS_ADCCON1_STRGSRC_Pos)) /* Assigment of value for STRGSRC in the ADCHS_ADCCON1 register */
#define   ADCHS_ADCCON1_STRGSRC_EXT_TRIG_VAL_Val _UINT32_(0x1F)                                       /* (ADCHS_ADCCON1) External trigger for validation  */
#define   ADCHS_ADCCON1_STRGSRC_EVSYS_47_Val  _UINT32_(0x10)                                       /* (ADCHS_ADCCON1) ADC_TRIG_16  */
#define   ADCHS_ADCCON1_STRGSRC_EVSYS_46_Val  _UINT32_(0xF)                                        /* (ADCHS_ADCCON1) ADC_TRIG_15  */
#define   ADCHS_ADCCON1_STRGSRC_EVSYS_45_Val  _UINT32_(0xE)                                        /* (ADCHS_ADCCON1) ADC_TRIG_14  */
#define   ADCHS_ADCCON1_STRGSRC_EVSYS_44_Val  _UINT32_(0xD)                                        /* (ADCHS_ADCCON1) ADC_TRIG_13  */
#define   ADCHS_ADCCON1_STRGSRC_EVSYS_43_Val  _UINT32_(0xC)                                        /* (ADCHS_ADCCON1) ADC_TRIG_12  */
#define   ADCHS_ADCCON1_STRGSRC_EVSYS_42_Val  _UINT32_(0xB)                                        /* (ADCHS_ADCCON1) ADC_TRIG_11  */
#define   ADCHS_ADCCON1_STRGSRC_EVSYS_41_Val  _UINT32_(0xA)                                        /* (ADCHS_ADCCON1) ADC_TRIG_10  */
#define   ADCHS_ADCCON1_STRGSRC_EVSYS_40_Val  _UINT32_(0x9)                                        /* (ADCHS_ADCCON1) ADC_TRIG_9  */
#define   ADCHS_ADCCON1_STRGSRC_EVSYS_39_Val  _UINT32_(0x8)                                        /* (ADCHS_ADCCON1) ADC_TRIG_8  */
#define   ADCHS_ADCCON1_STRGSRC_EVSYS_38_Val  _UINT32_(0x7)                                        /* (ADCHS_ADCCON1) ADC_TRIG_7  */
#define   ADCHS_ADCCON1_STRGSRC_EVSYS_37_Val  _UINT32_(0x6)                                        /* (ADCHS_ADCCON1) ADC_TRIG_6  */
#define   ADCHS_ADCCON1_STRGSRC_EVSYS_36_Val  _UINT32_(0x5)                                        /* (ADCHS_ADCCON1) ADC_TRIG_5  */
#define   ADCHS_ADCCON1_STRGSRC_INT0_Val      _UINT32_(0x4)                                        /* (ADCHS_ADCCON1) INT0  */
#define   ADCHS_ADCCON1_STRGSRC_RESERVED_Val  _UINT32_(0x3)                                        /* (ADCHS_ADCCON1) RESERVED  */
#define   ADCHS_ADCCON1_STRGSRC_SW_LVL_Val    _UINT32_(0x2)                                        /* (ADCHS_ADCCON1) Software level trigger  */
#define   ADCHS_ADCCON1_STRGSRC_SW_EDGE_Val   _UINT32_(0x1)                                        /* (ADCHS_ADCCON1) Software edge trigger  */
#define   ADCHS_ADCCON1_STRGSRC_NONE_Val      _UINT32_(0x0)                                        /* (ADCHS_ADCCON1) No Trigger  */
#define ADCHS_ADCCON1_STRGSRC_EXT_TRIG_VAL    (ADCHS_ADCCON1_STRGSRC_EXT_TRIG_VAL_Val << ADCHS_ADCCON1_STRGSRC_Pos) /* (ADCHS_ADCCON1) External trigger for validation Position  */
#define ADCHS_ADCCON1_STRGSRC_EVSYS_47        (ADCHS_ADCCON1_STRGSRC_EVSYS_47_Val << ADCHS_ADCCON1_STRGSRC_Pos) /* (ADCHS_ADCCON1) ADC_TRIG_16 Position  */
#define ADCHS_ADCCON1_STRGSRC_EVSYS_46        (ADCHS_ADCCON1_STRGSRC_EVSYS_46_Val << ADCHS_ADCCON1_STRGSRC_Pos) /* (ADCHS_ADCCON1) ADC_TRIG_15 Position  */
#define ADCHS_ADCCON1_STRGSRC_EVSYS_45        (ADCHS_ADCCON1_STRGSRC_EVSYS_45_Val << ADCHS_ADCCON1_STRGSRC_Pos) /* (ADCHS_ADCCON1) ADC_TRIG_14 Position  */
#define ADCHS_ADCCON1_STRGSRC_EVSYS_44        (ADCHS_ADCCON1_STRGSRC_EVSYS_44_Val << ADCHS_ADCCON1_STRGSRC_Pos) /* (ADCHS_ADCCON1) ADC_TRIG_13 Position  */
#define ADCHS_ADCCON1_STRGSRC_EVSYS_43        (ADCHS_ADCCON1_STRGSRC_EVSYS_43_Val << ADCHS_ADCCON1_STRGSRC_Pos) /* (ADCHS_ADCCON1) ADC_TRIG_12 Position  */
#define ADCHS_ADCCON1_STRGSRC_EVSYS_42        (ADCHS_ADCCON1_STRGSRC_EVSYS_42_Val << ADCHS_ADCCON1_STRGSRC_Pos) /* (ADCHS_ADCCON1) ADC_TRIG_11 Position  */
#define ADCHS_ADCCON1_STRGSRC_EVSYS_41        (ADCHS_ADCCON1_STRGSRC_EVSYS_41_Val << ADCHS_ADCCON1_STRGSRC_Pos) /* (ADCHS_ADCCON1) ADC_TRIG_10 Position  */
#define ADCHS_ADCCON1_STRGSRC_EVSYS_40        (ADCHS_ADCCON1_STRGSRC_EVSYS_40_Val << ADCHS_ADCCON1_STRGSRC_Pos) /* (ADCHS_ADCCON1) ADC_TRIG_9 Position  */
#define ADCHS_ADCCON1_STRGSRC_EVSYS_39        (ADCHS_ADCCON1_STRGSRC_EVSYS_39_Val << ADCHS_ADCCON1_STRGSRC_Pos) /* (ADCHS_ADCCON1) ADC_TRIG_8 Position  */
#define ADCHS_ADCCON1_STRGSRC_EVSYS_38        (ADCHS_ADCCON1_STRGSRC_EVSYS_38_Val << ADCHS_ADCCON1_STRGSRC_Pos) /* (ADCHS_ADCCON1) ADC_TRIG_7 Position  */
#define ADCHS_ADCCON1_STRGSRC_EVSYS_37        (ADCHS_ADCCON1_STRGSRC_EVSYS_37_Val << ADCHS_ADCCON1_STRGSRC_Pos) /* (ADCHS_ADCCON1) ADC_TRIG_6 Position  */
#define ADCHS_ADCCON1_STRGSRC_EVSYS_36        (ADCHS_ADCCON1_STRGSRC_EVSYS_36_Val << ADCHS_ADCCON1_STRGSRC_Pos) /* (ADCHS_ADCCON1) ADC_TRIG_5 Position  */
#define ADCHS_ADCCON1_STRGSRC_INT0            (ADCHS_ADCCON1_STRGSRC_INT0_Val << ADCHS_ADCCON1_STRGSRC_Pos) /* (ADCHS_ADCCON1) INT0 Position  */
#define ADCHS_ADCCON1_STRGSRC_RESERVED        (ADCHS_ADCCON1_STRGSRC_RESERVED_Val << ADCHS_ADCCON1_STRGSRC_Pos) /* (ADCHS_ADCCON1) RESERVED Position  */
#define ADCHS_ADCCON1_STRGSRC_SW_LVL          (ADCHS_ADCCON1_STRGSRC_SW_LVL_Val << ADCHS_ADCCON1_STRGSRC_Pos) /* (ADCHS_ADCCON1) Software level trigger Position  */
#define ADCHS_ADCCON1_STRGSRC_SW_EDGE         (ADCHS_ADCCON1_STRGSRC_SW_EDGE_Val << ADCHS_ADCCON1_STRGSRC_Pos) /* (ADCHS_ADCCON1) Software edge trigger Position  */
#define ADCHS_ADCCON1_STRGSRC_NONE            (ADCHS_ADCCON1_STRGSRC_NONE_Val << ADCHS_ADCCON1_STRGSRC_Pos) /* (ADCHS_ADCCON1) No Trigger Position  */
#define ADCHS_ADCCON1_SELRES_Pos              _UINT32_(21)                                         /* (ADCHS_ADCCON1) Shared ADC7 Resolution bits Position */
#define ADCHS_ADCCON1_SELRES_Msk              (_UINT32_(0x3) << ADCHS_ADCCON1_SELRES_Pos)          /* (ADCHS_ADCCON1) Shared ADC7 Resolution bits Mask */
#define ADCHS_ADCCON1_SELRES(value)           (ADCHS_ADCCON1_SELRES_Msk & (_UINT32_(value) << ADCHS_ADCCON1_SELRES_Pos)) /* Assigment of value for SELRES in the ADCHS_ADCCON1 register */
#define   ADCHS_ADCCON1_SELRES_12_BITS_Val    _UINT32_(0x3)                                        /* (ADCHS_ADCCON1) 12 bits (default)  */
#define   ADCHS_ADCCON1_SELRES_10_BITS_Val    _UINT32_(0x2)                                        /* (ADCHS_ADCCON1) 10 bits  */
#define   ADCHS_ADCCON1_SELRES_8_BITS_Val     _UINT32_(0x1)                                        /* (ADCHS_ADCCON1) 8 bits  */
#define   ADCHS_ADCCON1_SELRES_6_BITS_Val     _UINT32_(0x0)                                        /* (ADCHS_ADCCON1) 6 bits  */
#define ADCHS_ADCCON1_SELRES_12_BITS          (ADCHS_ADCCON1_SELRES_12_BITS_Val << ADCHS_ADCCON1_SELRES_Pos) /* (ADCHS_ADCCON1) 12 bits (default) Position  */
#define ADCHS_ADCCON1_SELRES_10_BITS          (ADCHS_ADCCON1_SELRES_10_BITS_Val << ADCHS_ADCCON1_SELRES_Pos) /* (ADCHS_ADCCON1) 10 bits Position  */
#define ADCHS_ADCCON1_SELRES_8_BITS           (ADCHS_ADCCON1_SELRES_8_BITS_Val << ADCHS_ADCCON1_SELRES_Pos) /* (ADCHS_ADCCON1) 8 bits Position  */
#define ADCHS_ADCCON1_SELRES_6_BITS           (ADCHS_ADCCON1_SELRES_6_BITS_Val << ADCHS_ADCCON1_SELRES_Pos) /* (ADCHS_ADCCON1) 6 bits Position  */
#define ADCHS_ADCCON1_FRACT_Pos               _UINT32_(23)                                         /* (ADCHS_ADCCON1) Fractional Data Output Format bit Position */
#define ADCHS_ADCCON1_FRACT_Msk               (_UINT32_(0x1) << ADCHS_ADCCON1_FRACT_Pos)           /* (ADCHS_ADCCON1) Fractional Data Output Format bit Mask */
#define ADCHS_ADCCON1_FRACT(value)            (ADCHS_ADCCON1_FRACT_Msk & (_UINT32_(value) << ADCHS_ADCCON1_FRACT_Pos)) /* Assigment of value for FRACT in the ADCHS_ADCCON1 register */
#define   ADCHS_ADCCON1_FRACT_FRAC_Val        _UINT32_(0x1)                                        /* (ADCHS_ADCCON1) Fractional  */
#define   ADCHS_ADCCON1_FRACT_INT_Val         _UINT32_(0x0)                                        /* (ADCHS_ADCCON1) Integer  */
#define ADCHS_ADCCON1_FRACT_FRAC              (ADCHS_ADCCON1_FRACT_FRAC_Val << ADCHS_ADCCON1_FRACT_Pos) /* (ADCHS_ADCCON1) Fractional Position  */
#define ADCHS_ADCCON1_FRACT_INT               (ADCHS_ADCCON1_FRACT_INT_Val << ADCHS_ADCCON1_FRACT_Pos) /* (ADCHS_ADCCON1) Integer Position  */
#define ADCHS_ADCCON1_Msk                     _UINT32_(0x00FFE77F)                                 /* (ADCHS_ADCCON1) Register Mask  */


/* -------- ADCHS_ADCCON1CLR : (ADCHS Offset: 0x04) (R/W 32) Bit clear register -------- */
#define ADCHS_ADCCON1CLR_RESETVALUE           _UINT32_(0x00)                                       /*  (ADCHS_ADCCON1CLR) Bit clear register  Reset Value */

#define ADCHS_ADCCON1CLR_Msk                  _UINT32_(0x00000000)                                 /* (ADCHS_ADCCON1CLR) Register Mask  */


/* -------- ADCHS_ADCCON1SET : (ADCHS Offset: 0x08) (R/W 32) Bit set register -------- */
#define ADCHS_ADCCON1SET_RESETVALUE           _UINT32_(0x00)                                       /*  (ADCHS_ADCCON1SET) Bit set register  Reset Value */

#define ADCHS_ADCCON1SET_Msk                  _UINT32_(0x00000000)                                 /* (ADCHS_ADCCON1SET) Register Mask  */


/* -------- ADCHS_ADCCON1INV : (ADCHS Offset: 0x0C) (R/W 32) Bit invert register -------- */
#define ADCHS_ADCCON1INV_RESETVALUE           _UINT32_(0x00)                                       /*  (ADCHS_ADCCON1INV) Bit invert register  Reset Value */

#define ADCHS_ADCCON1INV_Msk                  _UINT32_(0x00000000)                                 /* (ADCHS_ADCCON1INV) Register Mask  */


/* -------- ADCHS_ADCCON2 : (ADCHS Offset: 0x10) (R/W 32)  -------- */
#define ADCHS_ADCCON2_RESETVALUE              _UINT32_(0x00)                                       /*  (ADCHS_ADCCON2)   Reset Value */

#define ADCHS_ADCCON2_ADCDIV_Pos              _UINT32_(0)                                          /* (ADCHS_ADCCON2) Shared ADC Clock Divider bits Position */
#define ADCHS_ADCCON2_ADCDIV_Msk              (_UINT32_(0x7F) << ADCHS_ADCCON2_ADCDIV_Pos)         /* (ADCHS_ADCCON2) Shared ADC Clock Divider bits Mask */
#define ADCHS_ADCCON2_ADCDIV(value)           (ADCHS_ADCCON2_ADCDIV_Msk & (_UINT32_(value) << ADCHS_ADCCON2_ADCDIV_Pos)) /* Assigment of value for ADCDIV in the ADCHS_ADCCON2 register */
#define ADCHS_ADCCON2_ADCEIS_Pos              _UINT32_(8)                                          /* (ADCHS_ADCCON2) Shared ADC Early Interrupt Select bits Position */
#define ADCHS_ADCCON2_ADCEIS_Msk              (_UINT32_(0x7) << ADCHS_ADCCON2_ADCEIS_Pos)          /* (ADCHS_ADCCON2) Shared ADC Early Interrupt Select bits Mask */
#define ADCHS_ADCCON2_ADCEIS(value)           (ADCHS_ADCCON2_ADCEIS_Msk & (_UINT32_(value) << ADCHS_ADCCON2_ADCEIS_Pos)) /* Assigment of value for ADCEIS in the ADCHS_ADCCON2 register */
#define   ADCHS_ADCCON2_ADCEIS_8CLKS_EARLY_Val _UINT32_(0x7)                                        /* (ADCHS_ADCCON2) The data ready interrupt is generated 8 ADC clocks prior to end of conversion  */
#define   ADCHS_ADCCON2_ADCEIS_7CLKS_EARLY_Val _UINT32_(0x6)                                        /* (ADCHS_ADCCON2) The data ready interrupt is generated 7 ADC clocks prior to end of conversion  */
#define   ADCHS_ADCCON2_ADCEIS_6CLKS_EARLY_Val _UINT32_(0x5)                                        /* (ADCHS_ADCCON2) The data ready interrupt is generated 6 ADC clocks prior to end of conversion  */
#define   ADCHS_ADCCON2_ADCEIS_5CLKS_EARLY_Val _UINT32_(0x4)                                        /* (ADCHS_ADCCON2) The data ready interrupt is generated 5 ADC clocks prior to end of conversion  */
#define   ADCHS_ADCCON2_ADCEIS_4CLKS_EARLY_Val _UINT32_(0x3)                                        /* (ADCHS_ADCCON2) The data ready interrupt is generated 4 ADC clocks prior to end of conversion  */
#define   ADCHS_ADCCON2_ADCEIS_3CLKS_EARLY_Val _UINT32_(0x2)                                        /* (ADCHS_ADCCON2) The data ready interrupt is generated 3 ADC clocks prior to end of conversion  */
#define   ADCHS_ADCCON2_ADCEIS_2CLKS_EARLY_Val _UINT32_(0x1)                                        /* (ADCHS_ADCCON2) The data ready interrupt is generated 2 ADC module clocks prior to end of conversion  */
#define   ADCHS_ADCCON2_ADCEIS_1CLKS_EARLY_Val _UINT32_(0x0)                                        /* (ADCHS_ADCCON2) The data ready interrupt is generated 1 ADC module clock prior to end of conversion  */
#define ADCHS_ADCCON2_ADCEIS_8CLKS_EARLY      (ADCHS_ADCCON2_ADCEIS_8CLKS_EARLY_Val << ADCHS_ADCCON2_ADCEIS_Pos) /* (ADCHS_ADCCON2) The data ready interrupt is generated 8 ADC clocks prior to end of conversion Position  */
#define ADCHS_ADCCON2_ADCEIS_7CLKS_EARLY      (ADCHS_ADCCON2_ADCEIS_7CLKS_EARLY_Val << ADCHS_ADCCON2_ADCEIS_Pos) /* (ADCHS_ADCCON2) The data ready interrupt is generated 7 ADC clocks prior to end of conversion Position  */
#define ADCHS_ADCCON2_ADCEIS_6CLKS_EARLY      (ADCHS_ADCCON2_ADCEIS_6CLKS_EARLY_Val << ADCHS_ADCCON2_ADCEIS_Pos) /* (ADCHS_ADCCON2) The data ready interrupt is generated 6 ADC clocks prior to end of conversion Position  */
#define ADCHS_ADCCON2_ADCEIS_5CLKS_EARLY      (ADCHS_ADCCON2_ADCEIS_5CLKS_EARLY_Val << ADCHS_ADCCON2_ADCEIS_Pos) /* (ADCHS_ADCCON2) The data ready interrupt is generated 5 ADC clocks prior to end of conversion Position  */
#define ADCHS_ADCCON2_ADCEIS_4CLKS_EARLY      (ADCHS_ADCCON2_ADCEIS_4CLKS_EARLY_Val << ADCHS_ADCCON2_ADCEIS_Pos) /* (ADCHS_ADCCON2) The data ready interrupt is generated 4 ADC clocks prior to end of conversion Position  */
#define ADCHS_ADCCON2_ADCEIS_3CLKS_EARLY      (ADCHS_ADCCON2_ADCEIS_3CLKS_EARLY_Val << ADCHS_ADCCON2_ADCEIS_Pos) /* (ADCHS_ADCCON2) The data ready interrupt is generated 3 ADC clocks prior to end of conversion Position  */
#define ADCHS_ADCCON2_ADCEIS_2CLKS_EARLY      (ADCHS_ADCCON2_ADCEIS_2CLKS_EARLY_Val << ADCHS_ADCCON2_ADCEIS_Pos) /* (ADCHS_ADCCON2) The data ready interrupt is generated 2 ADC module clocks prior to end of conversion Position  */
#define ADCHS_ADCCON2_ADCEIS_1CLKS_EARLY      (ADCHS_ADCCON2_ADCEIS_1CLKS_EARLY_Val << ADCHS_ADCCON2_ADCEIS_Pos) /* (ADCHS_ADCCON2) The data ready interrupt is generated 1 ADC module clock prior to end of conversion Position  */
#define ADCHS_ADCCON2_ENXCNVRT_Pos            _UINT32_(11)                                         /* (ADCHS_ADCCON2)  Position */
#define ADCHS_ADCCON2_ENXCNVRT_Msk            (_UINT32_(0x1) << ADCHS_ADCCON2_ENXCNVRT_Pos)        /* (ADCHS_ADCCON2)  Mask */
#define ADCHS_ADCCON2_ENXCNVRT(value)         (ADCHS_ADCCON2_ENXCNVRT_Msk & (_UINT32_(value) << ADCHS_ADCCON2_ENXCNVRT_Pos)) /* Assigment of value for ENXCNVRT in the ADCHS_ADCCON2 register */
#define ADCHS_ADCCON2_EOSIEN_Pos              _UINT32_(13)                                         /* (ADCHS_ADCCON2) End of Scan Interrupt Enable bit Position */
#define ADCHS_ADCCON2_EOSIEN_Msk              (_UINT32_(0x1) << ADCHS_ADCCON2_EOSIEN_Pos)          /* (ADCHS_ADCCON2) End of Scan Interrupt Enable bit Mask */
#define ADCHS_ADCCON2_EOSIEN(value)           (ADCHS_ADCCON2_EOSIEN_Msk & (_UINT32_(value) << ADCHS_ADCCON2_EOSIEN_Pos)) /* Assigment of value for EOSIEN in the ADCHS_ADCCON2 register */
#define   ADCHS_ADCCON2_EOSIEN_EOSRDY_INT_Val _UINT32_(0x1)                                        /* (ADCHS_ADCCON2) Interrupt will be generated when EOSRDY bit is set  */
#define   ADCHS_ADCCON2_EOSIEN_NOEOSRDY_INT_Val _UINT32_(0x0)                                        /* (ADCHS_ADCCON2) No interrupt is generated when the EOSRDY bit is set  */
#define ADCHS_ADCCON2_EOSIEN_EOSRDY_INT       (ADCHS_ADCCON2_EOSIEN_EOSRDY_INT_Val << ADCHS_ADCCON2_EOSIEN_Pos) /* (ADCHS_ADCCON2) Interrupt will be generated when EOSRDY bit is set Position  */
#define ADCHS_ADCCON2_EOSIEN_NOEOSRDY_INT     (ADCHS_ADCCON2_EOSIEN_NOEOSRDY_INT_Val << ADCHS_ADCCON2_EOSIEN_Pos) /* (ADCHS_ADCCON2) No interrupt is generated when the EOSRDY bit is set Position  */
#define ADCHS_ADCCON2_REFFLTIEN_Pos           _UINT32_(14)                                         /* (ADCHS_ADCCON2) Band Gap/ Vref Voltage Fault Interrupt Enable bit Position */
#define ADCHS_ADCCON2_REFFLTIEN_Msk           (_UINT32_(0x1) << ADCHS_ADCCON2_REFFLTIEN_Pos)       /* (ADCHS_ADCCON2) Band Gap/ Vref Voltage Fault Interrupt Enable bit Mask */
#define ADCHS_ADCCON2_REFFLTIEN(value)        (ADCHS_ADCCON2_REFFLTIEN_Msk & (_UINT32_(value) << ADCHS_ADCCON2_REFFLTIEN_Pos)) /* Assigment of value for REFFLTIEN in the ADCHS_ADCCON2 register */
#define   ADCHS_ADCCON2_REFFLTIEN_REFFLT_INT_Val _UINT32_(0x1)                                        /* (ADCHS_ADCCON2) Interrupt will be generated when the REFFLT bit is set  */
#define   ADCHS_ADCCON2_REFFLTIEN_NOREFFLT_INT_Val _UINT32_(0x0)                                        /* (ADCHS_ADCCON2) No interrupt is generated when the REFFLT bit is set  */
#define ADCHS_ADCCON2_REFFLTIEN_REFFLT_INT    (ADCHS_ADCCON2_REFFLTIEN_REFFLT_INT_Val << ADCHS_ADCCON2_REFFLTIEN_Pos) /* (ADCHS_ADCCON2) Interrupt will be generated when the REFFLT bit is set Position  */
#define ADCHS_ADCCON2_REFFLTIEN_NOREFFLT_INT  (ADCHS_ADCCON2_REFFLTIEN_NOREFFLT_INT_Val << ADCHS_ADCCON2_REFFLTIEN_Pos) /* (ADCHS_ADCCON2) No interrupt is generated when the REFFLT bit is set Position  */
#define ADCHS_ADCCON2_BGVRIEN_Pos             _UINT32_(15)                                         /* (ADCHS_ADCCON2) Band Gap/ Vref Voltage Ready Interrupt Enable bit Position */
#define ADCHS_ADCCON2_BGVRIEN_Msk             (_UINT32_(0x1) << ADCHS_ADCCON2_BGVRIEN_Pos)         /* (ADCHS_ADCCON2) Band Gap/ Vref Voltage Ready Interrupt Enable bit Mask */
#define ADCHS_ADCCON2_BGVRIEN(value)          (ADCHS_ADCCON2_BGVRIEN_Msk & (_UINT32_(value) << ADCHS_ADCCON2_BGVRIEN_Pos)) /* Assigment of value for BGVRIEN in the ADCHS_ADCCON2 register */
#define   ADCHS_ADCCON2_BGVRIEN_BGVRDDY_INT_Val _UINT32_(0x1)                                        /* (ADCHS_ADCCON2) Interrupt will be generated when the BGVRDDY bit is set  */
#define   ADCHS_ADCCON2_BGVRIEN_NOBGVRDDY_INT_Val _UINT32_(0x0)                                        /* (ADCHS_ADCCON2) No interrupt is generated when the BGVRRDY bit is set  */
#define ADCHS_ADCCON2_BGVRIEN_BGVRDDY_INT     (ADCHS_ADCCON2_BGVRIEN_BGVRDDY_INT_Val << ADCHS_ADCCON2_BGVRIEN_Pos) /* (ADCHS_ADCCON2) Interrupt will be generated when the BGVRDDY bit is set Position  */
#define ADCHS_ADCCON2_BGVRIEN_NOBGVRDDY_INT   (ADCHS_ADCCON2_BGVRIEN_NOBGVRDDY_INT_Val << ADCHS_ADCCON2_BGVRIEN_Pos) /* (ADCHS_ADCCON2) No interrupt is generated when the BGVRRDY bit is set Position  */
#define ADCHS_ADCCON2_SAMC_Pos                _UINT32_(16)                                         /* (ADCHS_ADCCON2) Sample Time for the Shared ADC (ADC7) bits Position */
#define ADCHS_ADCCON2_SAMC_Msk                (_UINT32_(0x3FF) << ADCHS_ADCCON2_SAMC_Pos)          /* (ADCHS_ADCCON2) Sample Time for the Shared ADC (ADC7) bits Mask */
#define ADCHS_ADCCON2_SAMC(value)             (ADCHS_ADCCON2_SAMC_Msk & (_UINT32_(value) << ADCHS_ADCCON2_SAMC_Pos)) /* Assigment of value for SAMC in the ADCHS_ADCCON2 register */
#define ADCHS_ADCCON2_EOSRDY_Pos              _UINT32_(29)                                         /* (ADCHS_ADCCON2) End of Scan Interrupt Status bit Position */
#define ADCHS_ADCCON2_EOSRDY_Msk              (_UINT32_(0x1) << ADCHS_ADCCON2_EOSRDY_Pos)          /* (ADCHS_ADCCON2) End of Scan Interrupt Status bit Mask */
#define ADCHS_ADCCON2_EOSRDY(value)           (ADCHS_ADCCON2_EOSRDY_Msk & (_UINT32_(value) << ADCHS_ADCCON2_EOSRDY_Pos)) /* Assigment of value for EOSRDY in the ADCHS_ADCCON2 register */
#define   ADCHS_ADCCON2_EOSRDY_SCAN_COMPLETE_Val _UINT32_(0x1)                                        /* (ADCHS_ADCCON2) All analog inputs are considered for scanning through the scan trigger (all analog inputs specified in the ADCCSS1 and ADCCSS2 registers) have completed scanning  */
#define   ADCHS_ADCCON2_EOSRDY_SCAN_NOT_COMPLETE_Val _UINT32_(0x0)                                        /* (ADCHS_ADCCON2) Scanning has not completed  */
#define ADCHS_ADCCON2_EOSRDY_SCAN_COMPLETE    (ADCHS_ADCCON2_EOSRDY_SCAN_COMPLETE_Val << ADCHS_ADCCON2_EOSRDY_Pos) /* (ADCHS_ADCCON2) All analog inputs are considered for scanning through the scan trigger (all analog inputs specified in the ADCCSS1 and ADCCSS2 registers) have completed scanning Position  */
#define ADCHS_ADCCON2_EOSRDY_SCAN_NOT_COMPLETE (ADCHS_ADCCON2_EOSRDY_SCAN_NOT_COMPLETE_Val << ADCHS_ADCCON2_EOSRDY_Pos) /* (ADCHS_ADCCON2) Scanning has not completed Position  */
#define ADCHS_ADCCON2_REFFLT_Pos              _UINT32_(30)                                         /* (ADCHS_ADCCON2) Band Gap/ Vref / AVdd BOR Fault Status bit Position */
#define ADCHS_ADCCON2_REFFLT_Msk              (_UINT32_(0x1) << ADCHS_ADCCON2_REFFLT_Pos)          /* (ADCHS_ADCCON2) Band Gap/ Vref / AVdd BOR Fault Status bit Mask */
#define ADCHS_ADCCON2_REFFLT(value)           (ADCHS_ADCCON2_REFFLT_Msk & (_UINT32_(value) << ADCHS_ADCCON2_REFFLT_Pos)) /* Assigment of value for REFFLT in the ADCHS_ADCCON2 register */
#define   ADCHS_ADCCON2_REFFLT_BG_VREF_FLT_Val _UINT32_(0x1)                                        /* (ADCHS_ADCCON2) Fault in band gap or the Vref voltage while the ON bit (ADCCON1) was set. Most likely a band gap or Vref fault will be caused by a BOR of the analog Vdd supply.  */
#define   ADCHS_ADCCON2_REFFLT_BG_VREF_OK_Val _UINT32_(0x0)                                        /* (ADCHS_ADCCON2) Band gap and Vref voltage are working properly  */
#define ADCHS_ADCCON2_REFFLT_BG_VREF_FLT      (ADCHS_ADCCON2_REFFLT_BG_VREF_FLT_Val << ADCHS_ADCCON2_REFFLT_Pos) /* (ADCHS_ADCCON2) Fault in band gap or the Vref voltage while the ON bit (ADCCON1) was set. Most likely a band gap or Vref fault will be caused by a BOR of the analog Vdd supply. Position  */
#define ADCHS_ADCCON2_REFFLT_BG_VREF_OK       (ADCHS_ADCCON2_REFFLT_BG_VREF_OK_Val << ADCHS_ADCCON2_REFFLT_Pos) /* (ADCHS_ADCCON2) Band gap and Vref voltage are working properly Position  */
#define ADCHS_ADCCON2_BGVRRDY_Pos             _UINT32_(31)                                         /* (ADCHS_ADCCON2) Band Gap Voltage/ADC Reference Voltage Status bit Position */
#define ADCHS_ADCCON2_BGVRRDY_Msk             (_UINT32_(0x1) << ADCHS_ADCCON2_BGVRRDY_Pos)         /* (ADCHS_ADCCON2) Band Gap Voltage/ADC Reference Voltage Status bit Mask */
#define ADCHS_ADCCON2_BGVRRDY(value)          (ADCHS_ADCCON2_BGVRRDY_Msk & (_UINT32_(value) << ADCHS_ADCCON2_BGVRRDY_Pos)) /* Assigment of value for BGVRRDY in the ADCHS_ADCCON2 register */
#define   ADCHS_ADCCON2_BGVRRDY_VREF_RDY_Val  _UINT32_(0x1)                                        /* (ADCHS_ADCCON2) Both band gap voltage and ADC reference voltages (Vref) are ready  */
#define   ADCHS_ADCCON2_BGVRRDY_VREF_NOTRDY_Val _UINT32_(0x0)                                        /* (ADCHS_ADCCON2) Either or both band gap voltage and ADC reference voltages (Vref) are not ready  */
#define ADCHS_ADCCON2_BGVRRDY_VREF_RDY        (ADCHS_ADCCON2_BGVRRDY_VREF_RDY_Val << ADCHS_ADCCON2_BGVRRDY_Pos) /* (ADCHS_ADCCON2) Both band gap voltage and ADC reference voltages (Vref) are ready Position  */
#define ADCHS_ADCCON2_BGVRRDY_VREF_NOTRDY     (ADCHS_ADCCON2_BGVRRDY_VREF_NOTRDY_Val << ADCHS_ADCCON2_BGVRRDY_Pos) /* (ADCHS_ADCCON2) Either or both band gap voltage and ADC reference voltages (Vref) are not ready Position  */
#define ADCHS_ADCCON2_Msk                     _UINT32_(0xE3FFEF7F)                                 /* (ADCHS_ADCCON2) Register Mask  */


/* -------- ADCHS_ADCCON2CLR : (ADCHS Offset: 0x14) (R/W 32) Bit clear register -------- */
#define ADCHS_ADCCON2CLR_RESETVALUE           _UINT32_(0x00)                                       /*  (ADCHS_ADCCON2CLR) Bit clear register  Reset Value */

#define ADCHS_ADCCON2CLR_Msk                  _UINT32_(0x00000000)                                 /* (ADCHS_ADCCON2CLR) Register Mask  */


/* -------- ADCHS_ADCCON2SET : (ADCHS Offset: 0x18) (R/W 32) Bit set register -------- */
#define ADCHS_ADCCON2SET_RESETVALUE           _UINT32_(0x00)                                       /*  (ADCHS_ADCCON2SET) Bit set register  Reset Value */

#define ADCHS_ADCCON2SET_Msk                  _UINT32_(0x00000000)                                 /* (ADCHS_ADCCON2SET) Register Mask  */


/* -------- ADCHS_ADCCON2INV : (ADCHS Offset: 0x1C) (R/W 32) Bit invert register -------- */
#define ADCHS_ADCCON2INV_RESETVALUE           _UINT32_(0x00)                                       /*  (ADCHS_ADCCON2INV) Bit invert register  Reset Value */

#define ADCHS_ADCCON2INV_Msk                  _UINT32_(0x00000000)                                 /* (ADCHS_ADCCON2INV) Register Mask  */


/* -------- ADCHS_ADCCON3 : (ADCHS Offset: 0x20) (R/W 32)  -------- */
#define ADCHS_ADCCON3_RESETVALUE              _UINT32_(0x00)                                       /*  (ADCHS_ADCCON3)   Reset Value */

#define ADCHS_ADCCON3_ADINSEL_Pos             _UINT32_(0)                                          /* (ADCHS_ADCCON3) Analog Input Select bits Position */
#define ADCHS_ADCCON3_ADINSEL_Msk             (_UINT32_(0x3F) << ADCHS_ADCCON3_ADINSEL_Pos)        /* (ADCHS_ADCCON3) Analog Input Select bits Mask */
#define ADCHS_ADCCON3_ADINSEL(value)          (ADCHS_ADCCON3_ADINSEL_Msk & (_UINT32_(value) << ADCHS_ADCCON3_ADINSEL_Pos)) /* Assigment of value for ADINSEL in the ADCHS_ADCCON3 register */
#define   ADCHS_ADCCON3_ADINSEL_TMP_SENSE_Val _UINT32_(0xB)                                        /* (ADCHS_ADCCON3) CTMU Temperature Sensor (internal AN11)  */
#define   ADCHS_ADCCON3_ADINSEL_VBATDIV2_SENSE_Val _UINT32_(0xA)                                        /* (ADCHS_ADCCON3) VBAT/2 (internal AN10)  */
#define   ADCHS_ADCCON3_ADINSEL_1P2V_SENSE_Val _UINT32_(0x9)                                        /* (ADCHS_ADCCON3) IVref 1.2V (internal AN9)  */
#define   ADCHS_ADCCON3_ADINSEL_BGREF_Val     _UINT32_(0x8)                                        /* (ADCHS_ADCCON3) BandGap Reference (internal AN8)  */
#define   ADCHS_ADCCON3_ADINSEL_AN7_Val       _UINT32_(0x7)                                        /* (ADCHS_ADCCON3) AN7  */
#define   ADCHS_ADCCON3_ADINSEL_AN6_Val       _UINT32_(0x6)                                        /* (ADCHS_ADCCON3) AN6  */
#define   ADCHS_ADCCON3_ADINSEL_AN5_Val       _UINT32_(0x5)                                        /* (ADCHS_ADCCON3) AN5  */
#define   ADCHS_ADCCON3_ADINSEL_AN4_Val       _UINT32_(0x4)                                        /* (ADCHS_ADCCON3) AN4  */
#define   ADCHS_ADCCON3_ADINSEL_AN3_Val       _UINT32_(0x3)                                        /* (ADCHS_ADCCON3) AN3  */
#define   ADCHS_ADCCON3_ADINSEL_AN2_Val       _UINT32_(0x2)                                        /* (ADCHS_ADCCON3) AN2  */
#define   ADCHS_ADCCON3_ADINSEL_AN1_Val       _UINT32_(0x1)                                        /* (ADCHS_ADCCON3) AN1  */
#define   ADCHS_ADCCON3_ADINSEL_AN0_Val       _UINT32_(0x0)                                        /* (ADCHS_ADCCON3) AN0  */
#define ADCHS_ADCCON3_ADINSEL_TMP_SENSE       (ADCHS_ADCCON3_ADINSEL_TMP_SENSE_Val << ADCHS_ADCCON3_ADINSEL_Pos) /* (ADCHS_ADCCON3) CTMU Temperature Sensor (internal AN11) Position  */
#define ADCHS_ADCCON3_ADINSEL_VBATDIV2_SENSE  (ADCHS_ADCCON3_ADINSEL_VBATDIV2_SENSE_Val << ADCHS_ADCCON3_ADINSEL_Pos) /* (ADCHS_ADCCON3) VBAT/2 (internal AN10) Position  */
#define ADCHS_ADCCON3_ADINSEL_1P2V_SENSE      (ADCHS_ADCCON3_ADINSEL_1P2V_SENSE_Val << ADCHS_ADCCON3_ADINSEL_Pos) /* (ADCHS_ADCCON3) IVref 1.2V (internal AN9) Position  */
#define ADCHS_ADCCON3_ADINSEL_BGREF           (ADCHS_ADCCON3_ADINSEL_BGREF_Val << ADCHS_ADCCON3_ADINSEL_Pos) /* (ADCHS_ADCCON3) BandGap Reference (internal AN8) Position  */
#define ADCHS_ADCCON3_ADINSEL_AN7             (ADCHS_ADCCON3_ADINSEL_AN7_Val << ADCHS_ADCCON3_ADINSEL_Pos) /* (ADCHS_ADCCON3) AN7 Position  */
#define ADCHS_ADCCON3_ADINSEL_AN6             (ADCHS_ADCCON3_ADINSEL_AN6_Val << ADCHS_ADCCON3_ADINSEL_Pos) /* (ADCHS_ADCCON3) AN6 Position  */
#define ADCHS_ADCCON3_ADINSEL_AN5             (ADCHS_ADCCON3_ADINSEL_AN5_Val << ADCHS_ADCCON3_ADINSEL_Pos) /* (ADCHS_ADCCON3) AN5 Position  */
#define ADCHS_ADCCON3_ADINSEL_AN4             (ADCHS_ADCCON3_ADINSEL_AN4_Val << ADCHS_ADCCON3_ADINSEL_Pos) /* (ADCHS_ADCCON3) AN4 Position  */
#define ADCHS_ADCCON3_ADINSEL_AN3             (ADCHS_ADCCON3_ADINSEL_AN3_Val << ADCHS_ADCCON3_ADINSEL_Pos) /* (ADCHS_ADCCON3) AN3 Position  */
#define ADCHS_ADCCON3_ADINSEL_AN2             (ADCHS_ADCCON3_ADINSEL_AN2_Val << ADCHS_ADCCON3_ADINSEL_Pos) /* (ADCHS_ADCCON3) AN2 Position  */
#define ADCHS_ADCCON3_ADINSEL_AN1             (ADCHS_ADCCON3_ADINSEL_AN1_Val << ADCHS_ADCCON3_ADINSEL_Pos) /* (ADCHS_ADCCON3) AN1 Position  */
#define ADCHS_ADCCON3_ADINSEL_AN0             (ADCHS_ADCCON3_ADINSEL_AN0_Val << ADCHS_ADCCON3_ADINSEL_Pos) /* (ADCHS_ADCCON3) AN0 Position  */
#define ADCHS_ADCCON3_GSWTRG_Pos              _UINT32_(6)                                          /* (ADCHS_ADCCON3) Global Software Trigger bit Position */
#define ADCHS_ADCCON3_GSWTRG_Msk              (_UINT32_(0x1) << ADCHS_ADCCON3_GSWTRG_Pos)          /* (ADCHS_ADCCON3) Global Software Trigger bit Mask */
#define ADCHS_ADCCON3_GSWTRG(value)           (ADCHS_ADCCON3_GSWTRG_Msk & (_UINT32_(value) << ADCHS_ADCCON3_GSWTRG_Pos)) /* Assigment of value for GSWTRG in the ADCHS_ADCCON3 register */
#define   ADCHS_ADCCON3_GSWTRG_GSWTRG_Val     _UINT32_(0x1)                                        /* (ADCHS_ADCCON3) Trigger conversion for ADC inputs that have selected the GSWTRG bit as either through the associated TRGSRC bits in the ADCTRGx registers or through the STRGSRC<4:0> bits in the ADCCON1 register the trigger signal  */
#define   ADCHS_ADCCON3_GSWTRG_NO_GSWTRG_Val  _UINT32_(0x0)                                        /* (ADCHS_ADCCON3) Do not trigger an analog-to-digital conversion  */
#define ADCHS_ADCCON3_GSWTRG_GSWTRG           (ADCHS_ADCCON3_GSWTRG_GSWTRG_Val << ADCHS_ADCCON3_GSWTRG_Pos) /* (ADCHS_ADCCON3) Trigger conversion for ADC inputs that have selected the GSWTRG bit as either through the associated TRGSRC bits in the ADCTRGx registers or through the STRGSRC<4:0> bits in the ADCCON1 register the trigger signal Position  */
#define ADCHS_ADCCON3_GSWTRG_NO_GSWTRG        (ADCHS_ADCCON3_GSWTRG_NO_GSWTRG_Val << ADCHS_ADCCON3_GSWTRG_Pos) /* (ADCHS_ADCCON3) Do not trigger an analog-to-digital conversion Position  */
#define ADCHS_ADCCON3_GLSWTRG_Pos             _UINT32_(7)                                          /* (ADCHS_ADCCON3) Global Level Software Trigger bit Position */
#define ADCHS_ADCCON3_GLSWTRG_Msk             (_UINT32_(0x1) << ADCHS_ADCCON3_GLSWTRG_Pos)         /* (ADCHS_ADCCON3) Global Level Software Trigger bit Mask */
#define ADCHS_ADCCON3_GLSWTRG(value)          (ADCHS_ADCCON3_GLSWTRG_Msk & (_UINT32_(value) << ADCHS_ADCCON3_GLSWTRG_Pos)) /* Assigment of value for GLSWTRG in the ADCHS_ADCCON3 register */
#define   ADCHS_ADCCON3_GLSWTRG_GLSWTRG_Val   _UINT32_(0x1)                                        /* (ADCHS_ADCCON3) Trigger conversion for ADC inputs that have selected the GLSWTRG bit as the trigger signal  */
#define   ADCHS_ADCCON3_GLSWTRG_NO_GLSWTRG_Val _UINT32_(0x0)                                        /* (ADCHS_ADCCON3) Do not trigger an analog-to-digital conversion  */
#define ADCHS_ADCCON3_GLSWTRG_GLSWTRG         (ADCHS_ADCCON3_GLSWTRG_GLSWTRG_Val << ADCHS_ADCCON3_GLSWTRG_Pos) /* (ADCHS_ADCCON3) Trigger conversion for ADC inputs that have selected the GLSWTRG bit as the trigger signal Position  */
#define ADCHS_ADCCON3_GLSWTRG_NO_GLSWTRG      (ADCHS_ADCCON3_GLSWTRG_NO_GLSWTRG_Val << ADCHS_ADCCON3_GLSWTRG_Pos) /* (ADCHS_ADCCON3) Do not trigger an analog-to-digital conversion Position  */
#define ADCHS_ADCCON3_RQCNVRT_Pos             _UINT32_(8)                                          /* (ADCHS_ADCCON3) Individual ADC Input Conversion Request bit Position */
#define ADCHS_ADCCON3_RQCNVRT_Msk             (_UINT32_(0x1) << ADCHS_ADCCON3_RQCNVRT_Pos)         /* (ADCHS_ADCCON3) Individual ADC Input Conversion Request bit Mask */
#define ADCHS_ADCCON3_RQCNVRT(value)          (ADCHS_ADCCON3_RQCNVRT_Msk & (_UINT32_(value) << ADCHS_ADCCON3_RQCNVRT_Pos)) /* Assigment of value for RQCNVRT in the ADCHS_ADCCON3 register */
#define   ADCHS_ADCCON3_RQCNVRT_IND_TRIGGER_Val _UINT32_(0x1)                                        /* (ADCHS_ADCCON3) Trigger the conversion of the selected ADC input as specified by the ADINSEL bits  */
#define   ADCHS_ADCCON3_RQCNVRT_NO_TRIGGER_Val _UINT32_(0x0)                                        /* (ADCHS_ADCCON3) Do not trigger the conversion  */
#define ADCHS_ADCCON3_RQCNVRT_IND_TRIGGER     (ADCHS_ADCCON3_RQCNVRT_IND_TRIGGER_Val << ADCHS_ADCCON3_RQCNVRT_Pos) /* (ADCHS_ADCCON3) Trigger the conversion of the selected ADC input as specified by the ADINSEL bits Position  */
#define ADCHS_ADCCON3_RQCNVRT_NO_TRIGGER      (ADCHS_ADCCON3_RQCNVRT_NO_TRIGGER_Val << ADCHS_ADCCON3_RQCNVRT_Pos) /* (ADCHS_ADCCON3) Do not trigger the conversion Position  */
#define ADCHS_ADCCON3_SAMP_Pos                _UINT32_(9)                                          /* (ADCHS_ADCCON3) Shared ADC7 Analog Input Sampling Enable bit  Position */
#define ADCHS_ADCCON3_SAMP_Msk                (_UINT32_(0x1) << ADCHS_ADCCON3_SAMP_Pos)            /* (ADCHS_ADCCON3) Shared ADC7 Analog Input Sampling Enable bit  Mask */
#define ADCHS_ADCCON3_SAMP(value)             (ADCHS_ADCCON3_SAMP_Msk & (_UINT32_(value) << ADCHS_ADCCON3_SAMP_Pos)) /* Assigment of value for SAMP in the ADCHS_ADCCON3 register */
#define   ADCHS_ADCCON3_SAMP_SAMPLE_Val       _UINT32_(0x1)                                        /* (ADCHS_ADCCON3) The ADC S&H amplifier is sampling  */
#define   ADCHS_ADCCON3_SAMP_HOLD_Val         _UINT32_(0x0)                                        /* (ADCHS_ADCCON3) The ADC S&H amplifier is holding  */
#define ADCHS_ADCCON3_SAMP_SAMPLE             (ADCHS_ADCCON3_SAMP_SAMPLE_Val << ADCHS_ADCCON3_SAMP_Pos) /* (ADCHS_ADCCON3) The ADC S&H amplifier is sampling Position  */
#define ADCHS_ADCCON3_SAMP_HOLD               (ADCHS_ADCCON3_SAMP_HOLD_Val << ADCHS_ADCCON3_SAMP_Pos) /* (ADCHS_ADCCON3) The ADC S&H amplifier is holding Position  */
#define ADCHS_ADCCON3_UPDRDY_Pos              _UINT32_(10)                                         /* (ADCHS_ADCCON3) ADC Update Ready Status bit Position */
#define ADCHS_ADCCON3_UPDRDY_Msk              (_UINT32_(0x1) << ADCHS_ADCCON3_UPDRDY_Pos)          /* (ADCHS_ADCCON3) ADC Update Ready Status bit Mask */
#define ADCHS_ADCCON3_UPDRDY(value)           (ADCHS_ADCCON3_UPDRDY_Msk & (_UINT32_(value) << ADCHS_ADCCON3_UPDRDY_Pos)) /* Assigment of value for UPDRDY in the ADCHS_ADCCON3 register */
#define   ADCHS_ADCCON3_UPDRDY_UPDATE_RDY_Val _UINT32_(0x1)                                        /* (ADCHS_ADCCON3) ADC SFRs can be updated  */
#define   ADCHS_ADCCON3_UPDRDY_UPDATE_NOT_RDY_Val _UINT32_(0x0)                                        /* (ADCHS_ADCCON3) ADC SFRs cannot be updated  */
#define ADCHS_ADCCON3_UPDRDY_UPDATE_RDY       (ADCHS_ADCCON3_UPDRDY_UPDATE_RDY_Val << ADCHS_ADCCON3_UPDRDY_Pos) /* (ADCHS_ADCCON3) ADC SFRs can be updated Position  */
#define ADCHS_ADCCON3_UPDRDY_UPDATE_NOT_RDY   (ADCHS_ADCCON3_UPDRDY_UPDATE_NOT_RDY_Val << ADCHS_ADCCON3_UPDRDY_Pos) /* (ADCHS_ADCCON3) ADC SFRs cannot be updated Position  */
#define ADCHS_ADCCON3_UPDIEN_Pos              _UINT32_(11)                                         /* (ADCHS_ADCCON3) Update Ready Interrupt Enable bit Position */
#define ADCHS_ADCCON3_UPDIEN_Msk              (_UINT32_(0x1) << ADCHS_ADCCON3_UPDIEN_Pos)          /* (ADCHS_ADCCON3) Update Ready Interrupt Enable bit Mask */
#define ADCHS_ADCCON3_UPDIEN(value)           (ADCHS_ADCCON3_UPDIEN_Msk & (_UINT32_(value) << ADCHS_ADCCON3_UPDIEN_Pos)) /* Assigment of value for UPDIEN in the ADCHS_ADCCON3 register */
#define   ADCHS_ADCCON3_UPDIEN_INT_ON_UPDATE_RDY_Val _UINT32_(0x1)                                        /* (ADCHS_ADCCON3) Interrupt will be generated when the UPDRDY bit is set by hardware  */
#define   ADCHS_ADCCON3_UPDIEN_NO_INT_ON_UPDATE_RDY_Val _UINT32_(0x0)                                        /* (ADCHS_ADCCON3) No interrupt is generated  */
#define ADCHS_ADCCON3_UPDIEN_INT_ON_UPDATE_RDY (ADCHS_ADCCON3_UPDIEN_INT_ON_UPDATE_RDY_Val << ADCHS_ADCCON3_UPDIEN_Pos) /* (ADCHS_ADCCON3) Interrupt will be generated when the UPDRDY bit is set by hardware Position  */
#define ADCHS_ADCCON3_UPDIEN_NO_INT_ON_UPDATE_RDY (ADCHS_ADCCON3_UPDIEN_NO_INT_ON_UPDATE_RDY_Val << ADCHS_ADCCON3_UPDIEN_Pos) /* (ADCHS_ADCCON3) No interrupt is generated Position  */
#define ADCHS_ADCCON3_TRGSUSP_Pos             _UINT32_(12)                                         /* (ADCHS_ADCCON3) Trigger Suspend bit Position */
#define ADCHS_ADCCON3_TRGSUSP_Msk             (_UINT32_(0x1) << ADCHS_ADCCON3_TRGSUSP_Pos)         /* (ADCHS_ADCCON3) Trigger Suspend bit Mask */
#define ADCHS_ADCCON3_TRGSUSP(value)          (ADCHS_ADCCON3_TRGSUSP_Msk & (_UINT32_(value) << ADCHS_ADCCON3_TRGSUSP_Pos)) /* Assigment of value for TRGSUSP in the ADCHS_ADCCON3 register */
#define   ADCHS_ADCCON3_TRGSUSP_TRIG_BLOCKED_Val _UINT32_(0x1)                                        /* (ADCHS_ADCCON3) Triggers are blocked from starting a new analog-to-digital conversion  */
#define   ADCHS_ADCCON3_TRGSUSP_TRIG_NOT_BLOCKED_Val _UINT32_(0x0)                                        /* (ADCHS_ADCCON3) Triggers are not blocked  */
#define ADCHS_ADCCON3_TRGSUSP_TRIG_BLOCKED    (ADCHS_ADCCON3_TRGSUSP_TRIG_BLOCKED_Val << ADCHS_ADCCON3_TRGSUSP_Pos) /* (ADCHS_ADCCON3) Triggers are blocked from starting a new analog-to-digital conversion Position  */
#define ADCHS_ADCCON3_TRGSUSP_TRIG_NOT_BLOCKED (ADCHS_ADCCON3_TRGSUSP_TRIG_NOT_BLOCKED_Val << ADCHS_ADCCON3_TRGSUSP_Pos) /* (ADCHS_ADCCON3) Triggers are not blocked Position  */
#define ADCHS_ADCCON3_VREFSEL_Pos             _UINT32_(13)                                         /* (ADCHS_ADCCON3) Voltage Reference Input Selection bits Position */
#define ADCHS_ADCCON3_VREFSEL_Msk             (_UINT32_(0x7) << ADCHS_ADCCON3_VREFSEL_Pos)         /* (ADCHS_ADCCON3) Voltage Reference Input Selection bits Mask */
#define ADCHS_ADCCON3_VREFSEL(value)          (ADCHS_ADCCON3_VREFSEL_Msk & (_UINT32_(value) << ADCHS_ADCCON3_VREFSEL_Pos)) /* Assigment of value for VREFSEL in the ADCHS_ADCCON3 register */
#define   ADCHS_ADCCON3_VREFSEL_AVDD_AVSS_Val _UINT32_(0x0)                                        /* (ADCHS_ADCCON3) ADC VREFH is AVDD, ADC VREFL is AVSS  */
#define ADCHS_ADCCON3_VREFSEL_AVDD_AVSS       (ADCHS_ADCCON3_VREFSEL_AVDD_AVSS_Val << ADCHS_ADCCON3_VREFSEL_Pos) /* (ADCHS_ADCCON3) ADC VREFH is AVDD, ADC VREFL is AVSS Position  */
#define ADCHS_ADCCON3_DIGEN7_Pos              _UINT32_(23)                                         /* (ADCHS_ADCCON3) Shared ADC (ADC7) Digital Enable bit Position */
#define ADCHS_ADCCON3_DIGEN7_Msk              (_UINT32_(0x1) << ADCHS_ADCCON3_DIGEN7_Pos)          /* (ADCHS_ADCCON3) Shared ADC (ADC7) Digital Enable bit Mask */
#define ADCHS_ADCCON3_DIGEN7(value)           (ADCHS_ADCCON3_DIGEN7_Msk & (_UINT32_(value) << ADCHS_ADCCON3_DIGEN7_Pos)) /* Assigment of value for DIGEN7 in the ADCHS_ADCCON3 register */
#define ADCHS_ADCCON3_CONCLKDIV_Pos           _UINT32_(24)                                         /* (ADCHS_ADCCON3) Analog-to-Digital Control Clock Divider bits Position */
#define ADCHS_ADCCON3_CONCLKDIV_Msk           (_UINT32_(0x3F) << ADCHS_ADCCON3_CONCLKDIV_Pos)      /* (ADCHS_ADCCON3) Analog-to-Digital Control Clock Divider bits Mask */
#define ADCHS_ADCCON3_CONCLKDIV(value)        (ADCHS_ADCCON3_CONCLKDIV_Msk & (_UINT32_(value) << ADCHS_ADCCON3_CONCLKDIV_Pos)) /* Assigment of value for CONCLKDIV in the ADCHS_ADCCON3 register */
#define ADCHS_ADCCON3_ADCSEL_Pos              _UINT32_(30)                                         /* (ADCHS_ADCCON3) Analog-to-Digital Clock Source bits Position */
#define ADCHS_ADCCON3_ADCSEL_Msk              (_UINT32_(0x3) << ADCHS_ADCCON3_ADCSEL_Pos)          /* (ADCHS_ADCCON3) Analog-to-Digital Clock Source bits Mask */
#define ADCHS_ADCCON3_ADCSEL(value)           (ADCHS_ADCCON3_ADCSEL_Msk & (_UINT32_(value) << ADCHS_ADCCON3_ADCSEL_Pos)) /* Assigment of value for ADCSEL in the ADCHS_ADCCON3 register */
#define   ADCHS_ADCCON3_ADCSEL_SYSCLK_Val     _UINT32_(0x3)                                        /* (ADCHS_ADCCON3) SYSCLK  */
#define   ADCHS_ADCCON3_ADCSEL_REFCLK3_Val    _UINT32_(0x2)                                        /* (ADCHS_ADCCON3) REFCLK3  */
#define   ADCHS_ADCCON3_ADCSEL_FRC_Val        _UINT32_(0x1)                                        /* (ADCHS_ADCCON3) FRC  */
#define   ADCHS_ADCCON3_ADCSEL_PBCLK1_Val     _UINT32_(0x0)                                        /* (ADCHS_ADCCON3) PBCLK1  */
#define ADCHS_ADCCON3_ADCSEL_SYSCLK           (ADCHS_ADCCON3_ADCSEL_SYSCLK_Val << ADCHS_ADCCON3_ADCSEL_Pos) /* (ADCHS_ADCCON3) SYSCLK Position  */
#define ADCHS_ADCCON3_ADCSEL_REFCLK3          (ADCHS_ADCCON3_ADCSEL_REFCLK3_Val << ADCHS_ADCCON3_ADCSEL_Pos) /* (ADCHS_ADCCON3) REFCLK3 Position  */
#define ADCHS_ADCCON3_ADCSEL_FRC              (ADCHS_ADCCON3_ADCSEL_FRC_Val << ADCHS_ADCCON3_ADCSEL_Pos) /* (ADCHS_ADCCON3) FRC Position  */
#define ADCHS_ADCCON3_ADCSEL_PBCLK1           (ADCHS_ADCCON3_ADCSEL_PBCLK1_Val << ADCHS_ADCCON3_ADCSEL_Pos) /* (ADCHS_ADCCON3) PBCLK1 Position  */
#define ADCHS_ADCCON3_Msk                     _UINT32_(0xFF80FFFF)                                 /* (ADCHS_ADCCON3) Register Mask  */

#define ADCHS_ADCCON3_DIGEN_Pos               _UINT32_(23)                                         /* (ADCHS_ADCCON3 Position) Shared ADC (ADC7) Digital Enable bit */
#define ADCHS_ADCCON3_DIGEN_Msk               (_UINT32_(0x1) << ADCHS_ADCCON3_DIGEN_Pos)           /* (ADCHS_ADCCON3 Mask) DIGEN */
#define ADCHS_ADCCON3_DIGEN(value)            (ADCHS_ADCCON3_DIGEN_Msk & (_UINT32_(value) << ADCHS_ADCCON3_DIGEN_Pos)) 

/* -------- ADCHS_ADCCON3CLR : (ADCHS Offset: 0x24) (R/W 32) Bit clear register -------- */
#define ADCHS_ADCCON3CLR_RESETVALUE           _UINT32_(0x00)                                       /*  (ADCHS_ADCCON3CLR) Bit clear register  Reset Value */

#define ADCHS_ADCCON3CLR_Msk                  _UINT32_(0x00000000)                                 /* (ADCHS_ADCCON3CLR) Register Mask  */


/* -------- ADCHS_ADCCON3SET : (ADCHS Offset: 0x28) (R/W 32) Bit set register -------- */
#define ADCHS_ADCCON3SET_RESETVALUE           _UINT32_(0x00)                                       /*  (ADCHS_ADCCON3SET) Bit set register  Reset Value */

#define ADCHS_ADCCON3SET_Msk                  _UINT32_(0x00000000)                                 /* (ADCHS_ADCCON3SET) Register Mask  */


/* -------- ADCHS_ADCCON3INV : (ADCHS Offset: 0x2C) (R/W 32) Bit invert register -------- */
#define ADCHS_ADCCON3INV_RESETVALUE           _UINT32_(0x00)                                       /*  (ADCHS_ADCCON3INV) Bit invert register  Reset Value */

#define ADCHS_ADCCON3INV_Msk                  _UINT32_(0x00000000)                                 /* (ADCHS_ADCCON3INV) Register Mask  */


/* -------- ADCHS_ADCIMCON1 : (ADCHS Offset: 0x40) (R/W 32)  -------- */
#define ADCHS_ADCIMCON1_RESETVALUE            _UINT32_(0x00)                                       /*  (ADCHS_ADCIMCON1)   Reset Value */

#define ADCHS_ADCIMCON1_SIGN0_Pos             _UINT32_(0)                                          /* (ADCHS_ADCIMCON1) AN0 Signed Data Mode bit Position */
#define ADCHS_ADCIMCON1_SIGN0_Msk             (_UINT32_(0x1) << ADCHS_ADCIMCON1_SIGN0_Pos)         /* (ADCHS_ADCIMCON1) AN0 Signed Data Mode bit Mask */
#define ADCHS_ADCIMCON1_SIGN0(value)          (ADCHS_ADCIMCON1_SIGN0_Msk & (_UINT32_(value) << ADCHS_ADCIMCON1_SIGN0_Pos)) /* Assigment of value for SIGN0 in the ADCHS_ADCIMCON1 register */
#define   ADCHS_ADCIMCON1_SIGN0_SIGNED_Val    _UINT32_(0x1)                                        /* (ADCHS_ADCIMCON1) AN0 is using Signed Data mode  */
#define   ADCHS_ADCIMCON1_SIGN0_UNSIGNED_Val  _UINT32_(0x0)                                        /* (ADCHS_ADCIMCON1) AN0 is using Unsigned Data mode  */
#define ADCHS_ADCIMCON1_SIGN0_SIGNED          (ADCHS_ADCIMCON1_SIGN0_SIGNED_Val << ADCHS_ADCIMCON1_SIGN0_Pos) /* (ADCHS_ADCIMCON1) AN0 is using Signed Data mode Position  */
#define ADCHS_ADCIMCON1_SIGN0_UNSIGNED        (ADCHS_ADCIMCON1_SIGN0_UNSIGNED_Val << ADCHS_ADCIMCON1_SIGN0_Pos) /* (ADCHS_ADCIMCON1) AN0 is using Unsigned Data mode Position  */
#define ADCHS_ADCIMCON1_DIFF0_Pos             _UINT32_(1)                                          /* (ADCHS_ADCIMCON1) AN0 Mode bit Position */
#define ADCHS_ADCIMCON1_DIFF0_Msk             (_UINT32_(0x1) << ADCHS_ADCIMCON1_DIFF0_Pos)         /* (ADCHS_ADCIMCON1) AN0 Mode bit Mask */
#define ADCHS_ADCIMCON1_DIFF0(value)          (ADCHS_ADCIMCON1_DIFF0_Msk & (_UINT32_(value) << ADCHS_ADCIMCON1_DIFF0_Pos)) /* Assigment of value for DIFF0 in the ADCHS_ADCIMCON1 register */
#define   ADCHS_ADCIMCON1_DIFF0_DIFF_Val      _UINT32_(0x1)                                        /* (ADCHS_ADCIMCON1) Selects AN0 differential input pair as AN0+ and ANN0-  */
#define   ADCHS_ADCIMCON1_DIFF0_SINGLE_Val    _UINT32_(0x0)                                        /* (ADCHS_ADCIMCON1) AN0 is using Single-ended mode  */
#define ADCHS_ADCIMCON1_DIFF0_DIFF            (ADCHS_ADCIMCON1_DIFF0_DIFF_Val << ADCHS_ADCIMCON1_DIFF0_Pos) /* (ADCHS_ADCIMCON1) Selects AN0 differential input pair as AN0+ and ANN0- Position  */
#define ADCHS_ADCIMCON1_DIFF0_SINGLE          (ADCHS_ADCIMCON1_DIFF0_SINGLE_Val << ADCHS_ADCIMCON1_DIFF0_Pos) /* (ADCHS_ADCIMCON1) AN0 is using Single-ended mode Position  */
#define ADCHS_ADCIMCON1_SIGN1_Pos             _UINT32_(2)                                          /* (ADCHS_ADCIMCON1) AN1 Signed Data Mode bit Position */
#define ADCHS_ADCIMCON1_SIGN1_Msk             (_UINT32_(0x1) << ADCHS_ADCIMCON1_SIGN1_Pos)         /* (ADCHS_ADCIMCON1) AN1 Signed Data Mode bit Mask */
#define ADCHS_ADCIMCON1_SIGN1(value)          (ADCHS_ADCIMCON1_SIGN1_Msk & (_UINT32_(value) << ADCHS_ADCIMCON1_SIGN1_Pos)) /* Assigment of value for SIGN1 in the ADCHS_ADCIMCON1 register */
#define   ADCHS_ADCIMCON1_SIGN1_SIGNED_Val    _UINT32_(0x1)                                        /* (ADCHS_ADCIMCON1) AN1 is using Signed Data mode  */
#define   ADCHS_ADCIMCON1_SIGN1_UNSIGNED_Val  _UINT32_(0x0)                                        /* (ADCHS_ADCIMCON1) AN1 is using Unsigned Data mode  */
#define ADCHS_ADCIMCON1_SIGN1_SIGNED          (ADCHS_ADCIMCON1_SIGN1_SIGNED_Val << ADCHS_ADCIMCON1_SIGN1_Pos) /* (ADCHS_ADCIMCON1) AN1 is using Signed Data mode Position  */
#define ADCHS_ADCIMCON1_SIGN1_UNSIGNED        (ADCHS_ADCIMCON1_SIGN1_UNSIGNED_Val << ADCHS_ADCIMCON1_SIGN1_Pos) /* (ADCHS_ADCIMCON1) AN1 is using Unsigned Data mode Position  */
#define ADCHS_ADCIMCON1_DIFF1_Pos             _UINT32_(3)                                          /* (ADCHS_ADCIMCON1) AN1 Mode bit Position */
#define ADCHS_ADCIMCON1_DIFF1_Msk             (_UINT32_(0x1) << ADCHS_ADCIMCON1_DIFF1_Pos)         /* (ADCHS_ADCIMCON1) AN1 Mode bit Mask */
#define ADCHS_ADCIMCON1_DIFF1(value)          (ADCHS_ADCIMCON1_DIFF1_Msk & (_UINT32_(value) << ADCHS_ADCIMCON1_DIFF1_Pos)) /* Assigment of value for DIFF1 in the ADCHS_ADCIMCON1 register */
#define   ADCHS_ADCIMCON1_DIFF1_DIFF_Val      _UINT32_(0x1)                                        /* (ADCHS_ADCIMCON1) Selects AN1 differential input pair as AN1+ and ANN0-  */
#define   ADCHS_ADCIMCON1_DIFF1_SINGLE_Val    _UINT32_(0x0)                                        /* (ADCHS_ADCIMCON1) AN1 is using Single-ended mode  */
#define ADCHS_ADCIMCON1_DIFF1_DIFF            (ADCHS_ADCIMCON1_DIFF1_DIFF_Val << ADCHS_ADCIMCON1_DIFF1_Pos) /* (ADCHS_ADCIMCON1) Selects AN1 differential input pair as AN1+ and ANN0- Position  */
#define ADCHS_ADCIMCON1_DIFF1_SINGLE          (ADCHS_ADCIMCON1_DIFF1_SINGLE_Val << ADCHS_ADCIMCON1_DIFF1_Pos) /* (ADCHS_ADCIMCON1) AN1 is using Single-ended mode Position  */
#define ADCHS_ADCIMCON1_SIGN2_Pos             _UINT32_(4)                                          /* (ADCHS_ADCIMCON1) AN2 Signed Data Mode bit Position */
#define ADCHS_ADCIMCON1_SIGN2_Msk             (_UINT32_(0x1) << ADCHS_ADCIMCON1_SIGN2_Pos)         /* (ADCHS_ADCIMCON1) AN2 Signed Data Mode bit Mask */
#define ADCHS_ADCIMCON1_SIGN2(value)          (ADCHS_ADCIMCON1_SIGN2_Msk & (_UINT32_(value) << ADCHS_ADCIMCON1_SIGN2_Pos)) /* Assigment of value for SIGN2 in the ADCHS_ADCIMCON1 register */
#define   ADCHS_ADCIMCON1_SIGN2_SIGNED_Val    _UINT32_(0x1)                                        /* (ADCHS_ADCIMCON1) AN2 is using Signed Data mode  */
#define   ADCHS_ADCIMCON1_SIGN2_UNSIGNED_Val  _UINT32_(0x0)                                        /* (ADCHS_ADCIMCON1) AN2 is using Unsigned Data mode  */
#define ADCHS_ADCIMCON1_SIGN2_SIGNED          (ADCHS_ADCIMCON1_SIGN2_SIGNED_Val << ADCHS_ADCIMCON1_SIGN2_Pos) /* (ADCHS_ADCIMCON1) AN2 is using Signed Data mode Position  */
#define ADCHS_ADCIMCON1_SIGN2_UNSIGNED        (ADCHS_ADCIMCON1_SIGN2_UNSIGNED_Val << ADCHS_ADCIMCON1_SIGN2_Pos) /* (ADCHS_ADCIMCON1) AN2 is using Unsigned Data mode Position  */
#define ADCHS_ADCIMCON1_DIFF2_Pos             _UINT32_(5)                                          /* (ADCHS_ADCIMCON1) AN2 Mode bit Position */
#define ADCHS_ADCIMCON1_DIFF2_Msk             (_UINT32_(0x1) << ADCHS_ADCIMCON1_DIFF2_Pos)         /* (ADCHS_ADCIMCON1) AN2 Mode bit Mask */
#define ADCHS_ADCIMCON1_DIFF2(value)          (ADCHS_ADCIMCON1_DIFF2_Msk & (_UINT32_(value) << ADCHS_ADCIMCON1_DIFF2_Pos)) /* Assigment of value for DIFF2 in the ADCHS_ADCIMCON1 register */
#define   ADCHS_ADCIMCON1_DIFF2_DIFF_Val      _UINT32_(0x1)                                        /* (ADCHS_ADCIMCON1) Selects AN2 differential input pair as AN2+ and ANN0-  */
#define   ADCHS_ADCIMCON1_DIFF2_SINGLE_Val    _UINT32_(0x0)                                        /* (ADCHS_ADCIMCON1) AN2 is using Single-ended mode  */
#define ADCHS_ADCIMCON1_DIFF2_DIFF            (ADCHS_ADCIMCON1_DIFF2_DIFF_Val << ADCHS_ADCIMCON1_DIFF2_Pos) /* (ADCHS_ADCIMCON1) Selects AN2 differential input pair as AN2+ and ANN0- Position  */
#define ADCHS_ADCIMCON1_DIFF2_SINGLE          (ADCHS_ADCIMCON1_DIFF2_SINGLE_Val << ADCHS_ADCIMCON1_DIFF2_Pos) /* (ADCHS_ADCIMCON1) AN2 is using Single-ended mode Position  */
#define ADCHS_ADCIMCON1_SIGN3_Pos             _UINT32_(6)                                          /* (ADCHS_ADCIMCON1) AN3 Signed Data Mode bit Position */
#define ADCHS_ADCIMCON1_SIGN3_Msk             (_UINT32_(0x1) << ADCHS_ADCIMCON1_SIGN3_Pos)         /* (ADCHS_ADCIMCON1) AN3 Signed Data Mode bit Mask */
#define ADCHS_ADCIMCON1_SIGN3(value)          (ADCHS_ADCIMCON1_SIGN3_Msk & (_UINT32_(value) << ADCHS_ADCIMCON1_SIGN3_Pos)) /* Assigment of value for SIGN3 in the ADCHS_ADCIMCON1 register */
#define   ADCHS_ADCIMCON1_SIGN3_SIGNED_Val    _UINT32_(0x1)                                        /* (ADCHS_ADCIMCON1) AN3 is using Signed Data mode  */
#define   ADCHS_ADCIMCON1_SIGN3_UNSIGNED_Val  _UINT32_(0x0)                                        /* (ADCHS_ADCIMCON1) AN3 is using Unsigned Data mode  */
#define ADCHS_ADCIMCON1_SIGN3_SIGNED          (ADCHS_ADCIMCON1_SIGN3_SIGNED_Val << ADCHS_ADCIMCON1_SIGN3_Pos) /* (ADCHS_ADCIMCON1) AN3 is using Signed Data mode Position  */
#define ADCHS_ADCIMCON1_SIGN3_UNSIGNED        (ADCHS_ADCIMCON1_SIGN3_UNSIGNED_Val << ADCHS_ADCIMCON1_SIGN3_Pos) /* (ADCHS_ADCIMCON1) AN3 is using Unsigned Data mode Position  */
#define ADCHS_ADCIMCON1_DIFF3_Pos             _UINT32_(7)                                          /* (ADCHS_ADCIMCON1) AN3 Mode bit Position */
#define ADCHS_ADCIMCON1_DIFF3_Msk             (_UINT32_(0x1) << ADCHS_ADCIMCON1_DIFF3_Pos)         /* (ADCHS_ADCIMCON1) AN3 Mode bit Mask */
#define ADCHS_ADCIMCON1_DIFF3(value)          (ADCHS_ADCIMCON1_DIFF3_Msk & (_UINT32_(value) << ADCHS_ADCIMCON1_DIFF3_Pos)) /* Assigment of value for DIFF3 in the ADCHS_ADCIMCON1 register */
#define   ADCHS_ADCIMCON1_DIFF3_DIFF_Val      _UINT32_(0x1)                                        /* (ADCHS_ADCIMCON1) Selects AN3 differential input pair as AN3+ and ANN0-  */
#define   ADCHS_ADCIMCON1_DIFF3_SINGLE_Val    _UINT32_(0x0)                                        /* (ADCHS_ADCIMCON1) AN3 is using Single-ended mode  */
#define ADCHS_ADCIMCON1_DIFF3_DIFF            (ADCHS_ADCIMCON1_DIFF3_DIFF_Val << ADCHS_ADCIMCON1_DIFF3_Pos) /* (ADCHS_ADCIMCON1) Selects AN3 differential input pair as AN3+ and ANN0- Position  */
#define ADCHS_ADCIMCON1_DIFF3_SINGLE          (ADCHS_ADCIMCON1_DIFF3_SINGLE_Val << ADCHS_ADCIMCON1_DIFF3_Pos) /* (ADCHS_ADCIMCON1) AN3 is using Single-ended mode Position  */
#define ADCHS_ADCIMCON1_SIGN4_Pos             _UINT32_(8)                                          /* (ADCHS_ADCIMCON1) AN4 Signed Data Mode bit Position */
#define ADCHS_ADCIMCON1_SIGN4_Msk             (_UINT32_(0x1) << ADCHS_ADCIMCON1_SIGN4_Pos)         /* (ADCHS_ADCIMCON1) AN4 Signed Data Mode bit Mask */
#define ADCHS_ADCIMCON1_SIGN4(value)          (ADCHS_ADCIMCON1_SIGN4_Msk & (_UINT32_(value) << ADCHS_ADCIMCON1_SIGN4_Pos)) /* Assigment of value for SIGN4 in the ADCHS_ADCIMCON1 register */
#define   ADCHS_ADCIMCON1_SIGN4_SIGNED_Val    _UINT32_(0x1)                                        /* (ADCHS_ADCIMCON1) AN4 is using Signed Data mode  */
#define   ADCHS_ADCIMCON1_SIGN4_UNSIGNED_Val  _UINT32_(0x0)                                        /* (ADCHS_ADCIMCON1) AN4 is using Unsigned Data mode  */
#define ADCHS_ADCIMCON1_SIGN4_SIGNED          (ADCHS_ADCIMCON1_SIGN4_SIGNED_Val << ADCHS_ADCIMCON1_SIGN4_Pos) /* (ADCHS_ADCIMCON1) AN4 is using Signed Data mode Position  */
#define ADCHS_ADCIMCON1_SIGN4_UNSIGNED        (ADCHS_ADCIMCON1_SIGN4_UNSIGNED_Val << ADCHS_ADCIMCON1_SIGN4_Pos) /* (ADCHS_ADCIMCON1) AN4 is using Unsigned Data mode Position  */
#define ADCHS_ADCIMCON1_DIFF4_Pos             _UINT32_(9)                                          /* (ADCHS_ADCIMCON1) AN4 Mode bit Position */
#define ADCHS_ADCIMCON1_DIFF4_Msk             (_UINT32_(0x1) << ADCHS_ADCIMCON1_DIFF4_Pos)         /* (ADCHS_ADCIMCON1) AN4 Mode bit Mask */
#define ADCHS_ADCIMCON1_DIFF4(value)          (ADCHS_ADCIMCON1_DIFF4_Msk & (_UINT32_(value) << ADCHS_ADCIMCON1_DIFF4_Pos)) /* Assigment of value for DIFF4 in the ADCHS_ADCIMCON1 register */
#define   ADCHS_ADCIMCON1_DIFF4_DIFF_Val      _UINT32_(0x1)                                        /* (ADCHS_ADCIMCON1) Selects AN4 differential input pair as AN4+ and ANN0-  */
#define   ADCHS_ADCIMCON1_DIFF4_SINGLE_Val    _UINT32_(0x0)                                        /* (ADCHS_ADCIMCON1) AN4 is using Single-ended mode  */
#define ADCHS_ADCIMCON1_DIFF4_DIFF            (ADCHS_ADCIMCON1_DIFF4_DIFF_Val << ADCHS_ADCIMCON1_DIFF4_Pos) /* (ADCHS_ADCIMCON1) Selects AN4 differential input pair as AN4+ and ANN0- Position  */
#define ADCHS_ADCIMCON1_DIFF4_SINGLE          (ADCHS_ADCIMCON1_DIFF4_SINGLE_Val << ADCHS_ADCIMCON1_DIFF4_Pos) /* (ADCHS_ADCIMCON1) AN4 is using Single-ended mode Position  */
#define ADCHS_ADCIMCON1_SIGN5_Pos             _UINT32_(10)                                         /* (ADCHS_ADCIMCON1) AN5 Signed Data Mode bit Position */
#define ADCHS_ADCIMCON1_SIGN5_Msk             (_UINT32_(0x1) << ADCHS_ADCIMCON1_SIGN5_Pos)         /* (ADCHS_ADCIMCON1) AN5 Signed Data Mode bit Mask */
#define ADCHS_ADCIMCON1_SIGN5(value)          (ADCHS_ADCIMCON1_SIGN5_Msk & (_UINT32_(value) << ADCHS_ADCIMCON1_SIGN5_Pos)) /* Assigment of value for SIGN5 in the ADCHS_ADCIMCON1 register */
#define   ADCHS_ADCIMCON1_SIGN5_SIGNED_Val    _UINT32_(0x1)                                        /* (ADCHS_ADCIMCON1) AN5 is using Signed Data mode  */
#define   ADCHS_ADCIMCON1_SIGN5_UNSIGNED_Val  _UINT32_(0x0)                                        /* (ADCHS_ADCIMCON1) AN5 is using Unsigned Data mode  */
#define ADCHS_ADCIMCON1_SIGN5_SIGNED          (ADCHS_ADCIMCON1_SIGN5_SIGNED_Val << ADCHS_ADCIMCON1_SIGN5_Pos) /* (ADCHS_ADCIMCON1) AN5 is using Signed Data mode Position  */
#define ADCHS_ADCIMCON1_SIGN5_UNSIGNED        (ADCHS_ADCIMCON1_SIGN5_UNSIGNED_Val << ADCHS_ADCIMCON1_SIGN5_Pos) /* (ADCHS_ADCIMCON1) AN5 is using Unsigned Data mode Position  */
#define ADCHS_ADCIMCON1_DIFF5_Pos             _UINT32_(11)                                         /* (ADCHS_ADCIMCON1) AN5 Mode bit Position */
#define ADCHS_ADCIMCON1_DIFF5_Msk             (_UINT32_(0x1) << ADCHS_ADCIMCON1_DIFF5_Pos)         /* (ADCHS_ADCIMCON1) AN5 Mode bit Mask */
#define ADCHS_ADCIMCON1_DIFF5(value)          (ADCHS_ADCIMCON1_DIFF5_Msk & (_UINT32_(value) << ADCHS_ADCIMCON1_DIFF5_Pos)) /* Assigment of value for DIFF5 in the ADCHS_ADCIMCON1 register */
#define   ADCHS_ADCIMCON1_DIFF5_DIFF_Val      _UINT32_(0x1)                                        /* (ADCHS_ADCIMCON1) Selects AN5 differential input pair as AN5+ and ANN0-  */
#define   ADCHS_ADCIMCON1_DIFF5_SINGLE_Val    _UINT32_(0x0)                                        /* (ADCHS_ADCIMCON1) AN5 is using Single-ended mode  */
#define ADCHS_ADCIMCON1_DIFF5_DIFF            (ADCHS_ADCIMCON1_DIFF5_DIFF_Val << ADCHS_ADCIMCON1_DIFF5_Pos) /* (ADCHS_ADCIMCON1) Selects AN5 differential input pair as AN5+ and ANN0- Position  */
#define ADCHS_ADCIMCON1_DIFF5_SINGLE          (ADCHS_ADCIMCON1_DIFF5_SINGLE_Val << ADCHS_ADCIMCON1_DIFF5_Pos) /* (ADCHS_ADCIMCON1) AN5 is using Single-ended mode Position  */
#define ADCHS_ADCIMCON1_SIGN6_Pos             _UINT32_(12)                                         /* (ADCHS_ADCIMCON1) AN6 Signed Data Mode bit Position */
#define ADCHS_ADCIMCON1_SIGN6_Msk             (_UINT32_(0x1) << ADCHS_ADCIMCON1_SIGN6_Pos)         /* (ADCHS_ADCIMCON1) AN6 Signed Data Mode bit Mask */
#define ADCHS_ADCIMCON1_SIGN6(value)          (ADCHS_ADCIMCON1_SIGN6_Msk & (_UINT32_(value) << ADCHS_ADCIMCON1_SIGN6_Pos)) /* Assigment of value for SIGN6 in the ADCHS_ADCIMCON1 register */
#define   ADCHS_ADCIMCON1_SIGN6_SIGNED_Val    _UINT32_(0x1)                                        /* (ADCHS_ADCIMCON1) AN6 is using Signed Data mode  */
#define   ADCHS_ADCIMCON1_SIGN6_UNSIGNED_Val  _UINT32_(0x0)                                        /* (ADCHS_ADCIMCON1) AN6 is using Unsigned Data mode  */
#define ADCHS_ADCIMCON1_SIGN6_SIGNED          (ADCHS_ADCIMCON1_SIGN6_SIGNED_Val << ADCHS_ADCIMCON1_SIGN6_Pos) /* (ADCHS_ADCIMCON1) AN6 is using Signed Data mode Position  */
#define ADCHS_ADCIMCON1_SIGN6_UNSIGNED        (ADCHS_ADCIMCON1_SIGN6_UNSIGNED_Val << ADCHS_ADCIMCON1_SIGN6_Pos) /* (ADCHS_ADCIMCON1) AN6 is using Unsigned Data mode Position  */
#define ADCHS_ADCIMCON1_DIFF6_Pos             _UINT32_(13)                                         /* (ADCHS_ADCIMCON1) AN6 Mode bit Position */
#define ADCHS_ADCIMCON1_DIFF6_Msk             (_UINT32_(0x1) << ADCHS_ADCIMCON1_DIFF6_Pos)         /* (ADCHS_ADCIMCON1) AN6 Mode bit Mask */
#define ADCHS_ADCIMCON1_DIFF6(value)          (ADCHS_ADCIMCON1_DIFF6_Msk & (_UINT32_(value) << ADCHS_ADCIMCON1_DIFF6_Pos)) /* Assigment of value for DIFF6 in the ADCHS_ADCIMCON1 register */
#define   ADCHS_ADCIMCON1_DIFF6_DIFF_Val      _UINT32_(0x1)                                        /* (ADCHS_ADCIMCON1) Selects AN6 differential input pair as AN6+ and ANN0-  */
#define   ADCHS_ADCIMCON1_DIFF6_SINGLE_Val    _UINT32_(0x0)                                        /* (ADCHS_ADCIMCON1) AN6 is using Single-ended mode  */
#define ADCHS_ADCIMCON1_DIFF6_DIFF            (ADCHS_ADCIMCON1_DIFF6_DIFF_Val << ADCHS_ADCIMCON1_DIFF6_Pos) /* (ADCHS_ADCIMCON1) Selects AN6 differential input pair as AN6+ and ANN0- Position  */
#define ADCHS_ADCIMCON1_DIFF6_SINGLE          (ADCHS_ADCIMCON1_DIFF6_SINGLE_Val << ADCHS_ADCIMCON1_DIFF6_Pos) /* (ADCHS_ADCIMCON1) AN6 is using Single-ended mode Position  */
#define ADCHS_ADCIMCON1_SIGN7_Pos             _UINT32_(14)                                         /* (ADCHS_ADCIMCON1) AN7 Signed Data Mode bit Position */
#define ADCHS_ADCIMCON1_SIGN7_Msk             (_UINT32_(0x1) << ADCHS_ADCIMCON1_SIGN7_Pos)         /* (ADCHS_ADCIMCON1) AN7 Signed Data Mode bit Mask */
#define ADCHS_ADCIMCON1_SIGN7(value)          (ADCHS_ADCIMCON1_SIGN7_Msk & (_UINT32_(value) << ADCHS_ADCIMCON1_SIGN7_Pos)) /* Assigment of value for SIGN7 in the ADCHS_ADCIMCON1 register */
#define   ADCHS_ADCIMCON1_SIGN7_SIGNED_Val    _UINT32_(0x1)                                        /* (ADCHS_ADCIMCON1) AN7 is using Signed Data mode  */
#define   ADCHS_ADCIMCON1_SIGN7_UNSIGNED_Val  _UINT32_(0x0)                                        /* (ADCHS_ADCIMCON1) AN7 is using Unsigned Data mode  */
#define ADCHS_ADCIMCON1_SIGN7_SIGNED          (ADCHS_ADCIMCON1_SIGN7_SIGNED_Val << ADCHS_ADCIMCON1_SIGN7_Pos) /* (ADCHS_ADCIMCON1) AN7 is using Signed Data mode Position  */
#define ADCHS_ADCIMCON1_SIGN7_UNSIGNED        (ADCHS_ADCIMCON1_SIGN7_UNSIGNED_Val << ADCHS_ADCIMCON1_SIGN7_Pos) /* (ADCHS_ADCIMCON1) AN7 is using Unsigned Data mode Position  */
#define ADCHS_ADCIMCON1_DIFF7_Pos             _UINT32_(15)                                         /* (ADCHS_ADCIMCON1) AN7 Mode bit Position */
#define ADCHS_ADCIMCON1_DIFF7_Msk             (_UINT32_(0x1) << ADCHS_ADCIMCON1_DIFF7_Pos)         /* (ADCHS_ADCIMCON1) AN7 Mode bit Mask */
#define ADCHS_ADCIMCON1_DIFF7(value)          (ADCHS_ADCIMCON1_DIFF7_Msk & (_UINT32_(value) << ADCHS_ADCIMCON1_DIFF7_Pos)) /* Assigment of value for DIFF7 in the ADCHS_ADCIMCON1 register */
#define   ADCHS_ADCIMCON1_DIFF7_DIFF_Val      _UINT32_(0x1)                                        /* (ADCHS_ADCIMCON1) Selects AN7 differential input pair as AN7+ and ANN0-  */
#define   ADCHS_ADCIMCON1_DIFF7_SINGLE_Val    _UINT32_(0x0)                                        /* (ADCHS_ADCIMCON1) AN7 is using Single-ended mode  */
#define ADCHS_ADCIMCON1_DIFF7_DIFF            (ADCHS_ADCIMCON1_DIFF7_DIFF_Val << ADCHS_ADCIMCON1_DIFF7_Pos) /* (ADCHS_ADCIMCON1) Selects AN7 differential input pair as AN7+ and ANN0- Position  */
#define ADCHS_ADCIMCON1_DIFF7_SINGLE          (ADCHS_ADCIMCON1_DIFF7_SINGLE_Val << ADCHS_ADCIMCON1_DIFF7_Pos) /* (ADCHS_ADCIMCON1) AN7 is using Single-ended mode Position  */
#define ADCHS_ADCIMCON1_SIGN8_Pos             _UINT32_(16)                                         /* (ADCHS_ADCIMCON1) AN8 Signed Data Mode bit Position */
#define ADCHS_ADCIMCON1_SIGN8_Msk             (_UINT32_(0x1) << ADCHS_ADCIMCON1_SIGN8_Pos)         /* (ADCHS_ADCIMCON1) AN8 Signed Data Mode bit Mask */
#define ADCHS_ADCIMCON1_SIGN8(value)          (ADCHS_ADCIMCON1_SIGN8_Msk & (_UINT32_(value) << ADCHS_ADCIMCON1_SIGN8_Pos)) /* Assigment of value for SIGN8 in the ADCHS_ADCIMCON1 register */
#define   ADCHS_ADCIMCON1_SIGN8_SIGNED_Val    _UINT32_(0x1)                                        /* (ADCHS_ADCIMCON1) AN8 is using Signed Data mode  */
#define   ADCHS_ADCIMCON1_SIGN8_UNSIGNED_Val  _UINT32_(0x0)                                        /* (ADCHS_ADCIMCON1) AN8 is using Unsigned Data mode  */
#define ADCHS_ADCIMCON1_SIGN8_SIGNED          (ADCHS_ADCIMCON1_SIGN8_SIGNED_Val << ADCHS_ADCIMCON1_SIGN8_Pos) /* (ADCHS_ADCIMCON1) AN8 is using Signed Data mode Position  */
#define ADCHS_ADCIMCON1_SIGN8_UNSIGNED        (ADCHS_ADCIMCON1_SIGN8_UNSIGNED_Val << ADCHS_ADCIMCON1_SIGN8_Pos) /* (ADCHS_ADCIMCON1) AN8 is using Unsigned Data mode Position  */
#define ADCHS_ADCIMCON1_DIFF8_Pos             _UINT32_(17)                                         /* (ADCHS_ADCIMCON1) AN 8 Mode bit Position */
#define ADCHS_ADCIMCON1_DIFF8_Msk             (_UINT32_(0x1) << ADCHS_ADCIMCON1_DIFF8_Pos)         /* (ADCHS_ADCIMCON1) AN 8 Mode bit Mask */
#define ADCHS_ADCIMCON1_DIFF8(value)          (ADCHS_ADCIMCON1_DIFF8_Msk & (_UINT32_(value) << ADCHS_ADCIMCON1_DIFF8_Pos)) /* Assigment of value for DIFF8 in the ADCHS_ADCIMCON1 register */
#define   ADCHS_ADCIMCON1_DIFF8_DIFF_Val      _UINT32_(0x1)                                        /* (ADCHS_ADCIMCON1) Selects AN8 differential input pair as AN8+ and ANN0-  */
#define   ADCHS_ADCIMCON1_DIFF8_SINGLE_Val    _UINT32_(0x0)                                        /* (ADCHS_ADCIMCON1) AN8 is using Single-ended mode  */
#define ADCHS_ADCIMCON1_DIFF8_DIFF            (ADCHS_ADCIMCON1_DIFF8_DIFF_Val << ADCHS_ADCIMCON1_DIFF8_Pos) /* (ADCHS_ADCIMCON1) Selects AN8 differential input pair as AN8+ and ANN0- Position  */
#define ADCHS_ADCIMCON1_DIFF8_SINGLE          (ADCHS_ADCIMCON1_DIFF8_SINGLE_Val << ADCHS_ADCIMCON1_DIFF8_Pos) /* (ADCHS_ADCIMCON1) AN8 is using Single-ended mode Position  */
#define ADCHS_ADCIMCON1_SIGN9_Pos             _UINT32_(18)                                         /* (ADCHS_ADCIMCON1) AN9 Signed Data Mode bit Position */
#define ADCHS_ADCIMCON1_SIGN9_Msk             (_UINT32_(0x1) << ADCHS_ADCIMCON1_SIGN9_Pos)         /* (ADCHS_ADCIMCON1) AN9 Signed Data Mode bit Mask */
#define ADCHS_ADCIMCON1_SIGN9(value)          (ADCHS_ADCIMCON1_SIGN9_Msk & (_UINT32_(value) << ADCHS_ADCIMCON1_SIGN9_Pos)) /* Assigment of value for SIGN9 in the ADCHS_ADCIMCON1 register */
#define   ADCHS_ADCIMCON1_SIGN9_SIGNED_Val    _UINT32_(0x1)                                        /* (ADCHS_ADCIMCON1) AN9 is using Signed Data mode  */
#define   ADCHS_ADCIMCON1_SIGN9_UNSIGNED_Val  _UINT32_(0x0)                                        /* (ADCHS_ADCIMCON1) AN9 is using Unsigned Data mode  */
#define ADCHS_ADCIMCON1_SIGN9_SIGNED          (ADCHS_ADCIMCON1_SIGN9_SIGNED_Val << ADCHS_ADCIMCON1_SIGN9_Pos) /* (ADCHS_ADCIMCON1) AN9 is using Signed Data mode Position  */
#define ADCHS_ADCIMCON1_SIGN9_UNSIGNED        (ADCHS_ADCIMCON1_SIGN9_UNSIGNED_Val << ADCHS_ADCIMCON1_SIGN9_Pos) /* (ADCHS_ADCIMCON1) AN9 is using Unsigned Data mode Position  */
#define ADCHS_ADCIMCON1_DIFF9_Pos             _UINT32_(19)                                         /* (ADCHS_ADCIMCON1) AN9 Mode bit Position */
#define ADCHS_ADCIMCON1_DIFF9_Msk             (_UINT32_(0x1) << ADCHS_ADCIMCON1_DIFF9_Pos)         /* (ADCHS_ADCIMCON1) AN9 Mode bit Mask */
#define ADCHS_ADCIMCON1_DIFF9(value)          (ADCHS_ADCIMCON1_DIFF9_Msk & (_UINT32_(value) << ADCHS_ADCIMCON1_DIFF9_Pos)) /* Assigment of value for DIFF9 in the ADCHS_ADCIMCON1 register */
#define   ADCHS_ADCIMCON1_DIFF9_DIFF_Val      _UINT32_(0x1)                                        /* (ADCHS_ADCIMCON1) Selects AN9 differential input pair as AN9+ and ANN0-  */
#define   ADCHS_ADCIMCON1_DIFF9_SINGLE_Val    _UINT32_(0x0)                                        /* (ADCHS_ADCIMCON1) AN9 is using Single-ended mode  */
#define ADCHS_ADCIMCON1_DIFF9_DIFF            (ADCHS_ADCIMCON1_DIFF9_DIFF_Val << ADCHS_ADCIMCON1_DIFF9_Pos) /* (ADCHS_ADCIMCON1) Selects AN9 differential input pair as AN9+ and ANN0- Position  */
#define ADCHS_ADCIMCON1_DIFF9_SINGLE          (ADCHS_ADCIMCON1_DIFF9_SINGLE_Val << ADCHS_ADCIMCON1_DIFF9_Pos) /* (ADCHS_ADCIMCON1) AN9 is using Single-ended mode Position  */
#define ADCHS_ADCIMCON1_SIGN10_Pos            _UINT32_(20)                                         /* (ADCHS_ADCIMCON1) AN10 Signed Data Mode bit Position */
#define ADCHS_ADCIMCON1_SIGN10_Msk            (_UINT32_(0x1) << ADCHS_ADCIMCON1_SIGN10_Pos)        /* (ADCHS_ADCIMCON1) AN10 Signed Data Mode bit Mask */
#define ADCHS_ADCIMCON1_SIGN10(value)         (ADCHS_ADCIMCON1_SIGN10_Msk & (_UINT32_(value) << ADCHS_ADCIMCON1_SIGN10_Pos)) /* Assigment of value for SIGN10 in the ADCHS_ADCIMCON1 register */
#define   ADCHS_ADCIMCON1_SIGN10_SIGNED_Val   _UINT32_(0x1)                                        /* (ADCHS_ADCIMCON1) AN10 is using Signed Data mode  */
#define   ADCHS_ADCIMCON1_SIGN10_UNSIGNED_Val _UINT32_(0x0)                                        /* (ADCHS_ADCIMCON1) AN10 is using Unsigned Data mode  */
#define ADCHS_ADCIMCON1_SIGN10_SIGNED         (ADCHS_ADCIMCON1_SIGN10_SIGNED_Val << ADCHS_ADCIMCON1_SIGN10_Pos) /* (ADCHS_ADCIMCON1) AN10 is using Signed Data mode Position  */
#define ADCHS_ADCIMCON1_SIGN10_UNSIGNED       (ADCHS_ADCIMCON1_SIGN10_UNSIGNED_Val << ADCHS_ADCIMCON1_SIGN10_Pos) /* (ADCHS_ADCIMCON1) AN10 is using Unsigned Data mode Position  */
#define ADCHS_ADCIMCON1_DIFF10_Pos            _UINT32_(21)                                         /* (ADCHS_ADCIMCON1) AN10 Mode bit Position */
#define ADCHS_ADCIMCON1_DIFF10_Msk            (_UINT32_(0x1) << ADCHS_ADCIMCON1_DIFF10_Pos)        /* (ADCHS_ADCIMCON1) AN10 Mode bit Mask */
#define ADCHS_ADCIMCON1_DIFF10(value)         (ADCHS_ADCIMCON1_DIFF10_Msk & (_UINT32_(value) << ADCHS_ADCIMCON1_DIFF10_Pos)) /* Assigment of value for DIFF10 in the ADCHS_ADCIMCON1 register */
#define   ADCHS_ADCIMCON1_DIFF10_DIFF_Val     _UINT32_(0x1)                                        /* (ADCHS_ADCIMCON1) Selects AN10 differential input pair as AN10+ and ANN0-  */
#define   ADCHS_ADCIMCON1_DIFF10_SINGLE_Val   _UINT32_(0x0)                                        /* (ADCHS_ADCIMCON1) AN10 is using Single-ended mode  */
#define ADCHS_ADCIMCON1_DIFF10_DIFF           (ADCHS_ADCIMCON1_DIFF10_DIFF_Val << ADCHS_ADCIMCON1_DIFF10_Pos) /* (ADCHS_ADCIMCON1) Selects AN10 differential input pair as AN10+ and ANN0- Position  */
#define ADCHS_ADCIMCON1_DIFF10_SINGLE         (ADCHS_ADCIMCON1_DIFF10_SINGLE_Val << ADCHS_ADCIMCON1_DIFF10_Pos) /* (ADCHS_ADCIMCON1) AN10 is using Single-ended mode Position  */
#define ADCHS_ADCIMCON1_SIGN11_Pos            _UINT32_(22)                                         /* (ADCHS_ADCIMCON1) AN11 Signed Data Mode bit Position */
#define ADCHS_ADCIMCON1_SIGN11_Msk            (_UINT32_(0x1) << ADCHS_ADCIMCON1_SIGN11_Pos)        /* (ADCHS_ADCIMCON1) AN11 Signed Data Mode bit Mask */
#define ADCHS_ADCIMCON1_SIGN11(value)         (ADCHS_ADCIMCON1_SIGN11_Msk & (_UINT32_(value) << ADCHS_ADCIMCON1_SIGN11_Pos)) /* Assigment of value for SIGN11 in the ADCHS_ADCIMCON1 register */
#define   ADCHS_ADCIMCON1_SIGN11_SIGNED_Val   _UINT32_(0x1)                                        /* (ADCHS_ADCIMCON1) AN11 is using Signed Data mode  */
#define   ADCHS_ADCIMCON1_SIGN11_UNSIGNED_Val _UINT32_(0x0)                                        /* (ADCHS_ADCIMCON1) AN11 is using Unsigned Data mode  */
#define ADCHS_ADCIMCON1_SIGN11_SIGNED         (ADCHS_ADCIMCON1_SIGN11_SIGNED_Val << ADCHS_ADCIMCON1_SIGN11_Pos) /* (ADCHS_ADCIMCON1) AN11 is using Signed Data mode Position  */
#define ADCHS_ADCIMCON1_SIGN11_UNSIGNED       (ADCHS_ADCIMCON1_SIGN11_UNSIGNED_Val << ADCHS_ADCIMCON1_SIGN11_Pos) /* (ADCHS_ADCIMCON1) AN11 is using Unsigned Data mode Position  */
#define ADCHS_ADCIMCON1_DIFF11_Pos            _UINT32_(23)                                         /* (ADCHS_ADCIMCON1) AN11 Mode bit Position */
#define ADCHS_ADCIMCON1_DIFF11_Msk            (_UINT32_(0x1) << ADCHS_ADCIMCON1_DIFF11_Pos)        /* (ADCHS_ADCIMCON1) AN11 Mode bit Mask */
#define ADCHS_ADCIMCON1_DIFF11(value)         (ADCHS_ADCIMCON1_DIFF11_Msk & (_UINT32_(value) << ADCHS_ADCIMCON1_DIFF11_Pos)) /* Assigment of value for DIFF11 in the ADCHS_ADCIMCON1 register */
#define   ADCHS_ADCIMCON1_DIFF11_DIFF_Val     _UINT32_(0x1)                                        /* (ADCHS_ADCIMCON1) Selects AN11 differential input pair as AN11+ and ANN0-  */
#define   ADCHS_ADCIMCON1_DIFF11_SINGLE_Val   _UINT32_(0x0)                                        /* (ADCHS_ADCIMCON1) AN11 is using Single-ended mode  */
#define ADCHS_ADCIMCON1_DIFF11_DIFF           (ADCHS_ADCIMCON1_DIFF11_DIFF_Val << ADCHS_ADCIMCON1_DIFF11_Pos) /* (ADCHS_ADCIMCON1) Selects AN11 differential input pair as AN11+ and ANN0- Position  */
#define ADCHS_ADCIMCON1_DIFF11_SINGLE         (ADCHS_ADCIMCON1_DIFF11_SINGLE_Val << ADCHS_ADCIMCON1_DIFF11_Pos) /* (ADCHS_ADCIMCON1) AN11 is using Single-ended mode Position  */
#define ADCHS_ADCIMCON1_Msk                   _UINT32_(0x00FFFFFF)                                 /* (ADCHS_ADCIMCON1) Register Mask  */


/* -------- ADCHS_ADCIMOD1CLR : (ADCHS Offset: 0x44) (R/W 32) Bit clear register -------- */
#define ADCHS_ADCIMOD1CLR_RESETVALUE          _UINT32_(0x00)                                       /*  (ADCHS_ADCIMOD1CLR) Bit clear register  Reset Value */

#define ADCHS_ADCIMOD1CLR_Msk                 _UINT32_(0x00000000)                                 /* (ADCHS_ADCIMOD1CLR) Register Mask  */


/* -------- ADCHS_ADCIMOD1SET : (ADCHS Offset: 0x48) (R/W 32) Bit set register -------- */
#define ADCHS_ADCIMOD1SET_RESETVALUE          _UINT32_(0x00)                                       /*  (ADCHS_ADCIMOD1SET) Bit set register  Reset Value */

#define ADCHS_ADCIMOD1SET_Msk                 _UINT32_(0x00000000)                                 /* (ADCHS_ADCIMOD1SET) Register Mask  */


/* -------- ADCHS_ADCIMOD1INV : (ADCHS Offset: 0x4C) (R/W 32) Bit invert register -------- */
#define ADCHS_ADCIMOD1INV_RESETVALUE          _UINT32_(0x00)                                       /*  (ADCHS_ADCIMOD1INV) Bit invert register  Reset Value */

#define ADCHS_ADCIMOD1INV_Msk                 _UINT32_(0x00000000)                                 /* (ADCHS_ADCIMOD1INV) Register Mask  */


/* -------- ADCHS_ADCGIRQEN1 : (ADCHS Offset: 0x80) (R/W 32)  -------- */
#define ADCHS_ADCGIRQEN1_RESETVALUE           _UINT32_(0x00)                                       /*  (ADCHS_ADCGIRQEN1)   Reset Value */

#define ADCHS_ADCGIRQEN1_AGIEN0_Pos           _UINT32_(0)                                          /* (ADCHS_ADCGIRQEN1) ADC Global Interrupt Enable bit Position */
#define ADCHS_ADCGIRQEN1_AGIEN0_Msk           (_UINT32_(0x1) << ADCHS_ADCGIRQEN1_AGIEN0_Pos)       /* (ADCHS_ADCGIRQEN1) ADC Global Interrupt Enable bit Mask */
#define ADCHS_ADCGIRQEN1_AGIEN0(value)        (ADCHS_ADCGIRQEN1_AGIEN0_Msk & (_UINT32_(value) << ADCHS_ADCGIRQEN1_AGIEN0_Pos)) /* Assigment of value for AGIEN0 in the ADCHS_ADCGIRQEN1 register */
#define   ADCHS_ADCGIRQEN1_AGIEN0_ENABLED_Val _UINT32_(0x1)                                        /* (ADCHS_ADCGIRQEN1) Interrupts are enabled for the selected analog input. The interrupt is generated after the converted data is ready (indicated by the AIRDYx bit of the ADCDSTAT1 register)  */
#define   ADCHS_ADCGIRQEN1_AGIEN0_DISABLED_Val _UINT32_(0x0)                                        /* (ADCHS_ADCGIRQEN1) Interrupts are disabled  */
#define ADCHS_ADCGIRQEN1_AGIEN0_ENABLED       (ADCHS_ADCGIRQEN1_AGIEN0_ENABLED_Val << ADCHS_ADCGIRQEN1_AGIEN0_Pos) /* (ADCHS_ADCGIRQEN1) Interrupts are enabled for the selected analog input. The interrupt is generated after the converted data is ready (indicated by the AIRDYx bit of the ADCDSTAT1 register) Position  */
#define ADCHS_ADCGIRQEN1_AGIEN0_DISABLED      (ADCHS_ADCGIRQEN1_AGIEN0_DISABLED_Val << ADCHS_ADCGIRQEN1_AGIEN0_Pos) /* (ADCHS_ADCGIRQEN1) Interrupts are disabled Position  */
#define ADCHS_ADCGIRQEN1_AGIEN1_Pos           _UINT32_(1)                                          /* (ADCHS_ADCGIRQEN1) ADC Global Interrupt Enable bit Position */
#define ADCHS_ADCGIRQEN1_AGIEN1_Msk           (_UINT32_(0x1) << ADCHS_ADCGIRQEN1_AGIEN1_Pos)       /* (ADCHS_ADCGIRQEN1) ADC Global Interrupt Enable bit Mask */
#define ADCHS_ADCGIRQEN1_AGIEN1(value)        (ADCHS_ADCGIRQEN1_AGIEN1_Msk & (_UINT32_(value) << ADCHS_ADCGIRQEN1_AGIEN1_Pos)) /* Assigment of value for AGIEN1 in the ADCHS_ADCGIRQEN1 register */
#define   ADCHS_ADCGIRQEN1_AGIEN1_ENABLED_Val _UINT32_(0x1)                                        /* (ADCHS_ADCGIRQEN1) Interrupts are enabled for the selected analog input. The interrupt is generated after the converted data is ready (indicated by the AIRDYx bit of the ADCDSTAT1 register)  */
#define   ADCHS_ADCGIRQEN1_AGIEN1_DISABLED_Val _UINT32_(0x0)                                        /* (ADCHS_ADCGIRQEN1) Interrupts are disabled  */
#define ADCHS_ADCGIRQEN1_AGIEN1_ENABLED       (ADCHS_ADCGIRQEN1_AGIEN1_ENABLED_Val << ADCHS_ADCGIRQEN1_AGIEN1_Pos) /* (ADCHS_ADCGIRQEN1) Interrupts are enabled for the selected analog input. The interrupt is generated after the converted data is ready (indicated by the AIRDYx bit of the ADCDSTAT1 register) Position  */
#define ADCHS_ADCGIRQEN1_AGIEN1_DISABLED      (ADCHS_ADCGIRQEN1_AGIEN1_DISABLED_Val << ADCHS_ADCGIRQEN1_AGIEN1_Pos) /* (ADCHS_ADCGIRQEN1) Interrupts are disabled Position  */
#define ADCHS_ADCGIRQEN1_AGIEN2_Pos           _UINT32_(2)                                          /* (ADCHS_ADCGIRQEN1) ADC Global Interrupt Enable bit Position */
#define ADCHS_ADCGIRQEN1_AGIEN2_Msk           (_UINT32_(0x1) << ADCHS_ADCGIRQEN1_AGIEN2_Pos)       /* (ADCHS_ADCGIRQEN1) ADC Global Interrupt Enable bit Mask */
#define ADCHS_ADCGIRQEN1_AGIEN2(value)        (ADCHS_ADCGIRQEN1_AGIEN2_Msk & (_UINT32_(value) << ADCHS_ADCGIRQEN1_AGIEN2_Pos)) /* Assigment of value for AGIEN2 in the ADCHS_ADCGIRQEN1 register */
#define   ADCHS_ADCGIRQEN1_AGIEN2_ENABLED_Val _UINT32_(0x1)                                        /* (ADCHS_ADCGIRQEN1) Interrupts are enabled for the selected analog input. The interrupt is generated after the converted data is ready (indicated by the AIRDYx bit of the ADCDSTAT1 register)  */
#define   ADCHS_ADCGIRQEN1_AGIEN2_DISABLED_Val _UINT32_(0x0)                                        /* (ADCHS_ADCGIRQEN1) Interrupts are disabled  */
#define ADCHS_ADCGIRQEN1_AGIEN2_ENABLED       (ADCHS_ADCGIRQEN1_AGIEN2_ENABLED_Val << ADCHS_ADCGIRQEN1_AGIEN2_Pos) /* (ADCHS_ADCGIRQEN1) Interrupts are enabled for the selected analog input. The interrupt is generated after the converted data is ready (indicated by the AIRDYx bit of the ADCDSTAT1 register) Position  */
#define ADCHS_ADCGIRQEN1_AGIEN2_DISABLED      (ADCHS_ADCGIRQEN1_AGIEN2_DISABLED_Val << ADCHS_ADCGIRQEN1_AGIEN2_Pos) /* (ADCHS_ADCGIRQEN1) Interrupts are disabled Position  */
#define ADCHS_ADCGIRQEN1_AGIEN3_Pos           _UINT32_(3)                                          /* (ADCHS_ADCGIRQEN1) ADC Global Interrupt Enable bit Position */
#define ADCHS_ADCGIRQEN1_AGIEN3_Msk           (_UINT32_(0x1) << ADCHS_ADCGIRQEN1_AGIEN3_Pos)       /* (ADCHS_ADCGIRQEN1) ADC Global Interrupt Enable bit Mask */
#define ADCHS_ADCGIRQEN1_AGIEN3(value)        (ADCHS_ADCGIRQEN1_AGIEN3_Msk & (_UINT32_(value) << ADCHS_ADCGIRQEN1_AGIEN3_Pos)) /* Assigment of value for AGIEN3 in the ADCHS_ADCGIRQEN1 register */
#define   ADCHS_ADCGIRQEN1_AGIEN3_ENABLED_Val _UINT32_(0x1)                                        /* (ADCHS_ADCGIRQEN1) Interrupts are enabled for the selected analog input. The interrupt is generated after the converted data is ready (indicated by the AIRDYx bit of the ADCDSTAT1 register)  */
#define   ADCHS_ADCGIRQEN1_AGIEN3_DISABLED_Val _UINT32_(0x0)                                        /* (ADCHS_ADCGIRQEN1) Interrupts are disabled  */
#define ADCHS_ADCGIRQEN1_AGIEN3_ENABLED       (ADCHS_ADCGIRQEN1_AGIEN3_ENABLED_Val << ADCHS_ADCGIRQEN1_AGIEN3_Pos) /* (ADCHS_ADCGIRQEN1) Interrupts are enabled for the selected analog input. The interrupt is generated after the converted data is ready (indicated by the AIRDYx bit of the ADCDSTAT1 register) Position  */
#define ADCHS_ADCGIRQEN1_AGIEN3_DISABLED      (ADCHS_ADCGIRQEN1_AGIEN3_DISABLED_Val << ADCHS_ADCGIRQEN1_AGIEN3_Pos) /* (ADCHS_ADCGIRQEN1) Interrupts are disabled Position  */
#define ADCHS_ADCGIRQEN1_AGIEN4_Pos           _UINT32_(4)                                          /* (ADCHS_ADCGIRQEN1) ADC Global Interrupt Enable bit Position */
#define ADCHS_ADCGIRQEN1_AGIEN4_Msk           (_UINT32_(0x1) << ADCHS_ADCGIRQEN1_AGIEN4_Pos)       /* (ADCHS_ADCGIRQEN1) ADC Global Interrupt Enable bit Mask */
#define ADCHS_ADCGIRQEN1_AGIEN4(value)        (ADCHS_ADCGIRQEN1_AGIEN4_Msk & (_UINT32_(value) << ADCHS_ADCGIRQEN1_AGIEN4_Pos)) /* Assigment of value for AGIEN4 in the ADCHS_ADCGIRQEN1 register */
#define   ADCHS_ADCGIRQEN1_AGIEN4_ENABLED_Val _UINT32_(0x1)                                        /* (ADCHS_ADCGIRQEN1) Interrupts are enabled for the selected analog input. The interrupt is generated after the converted data is ready (indicated by the AIRDYx bit of the ADCDSTAT1 register)  */
#define   ADCHS_ADCGIRQEN1_AGIEN4_DISABLED_Val _UINT32_(0x0)                                        /* (ADCHS_ADCGIRQEN1) Interrupts are disabled  */
#define ADCHS_ADCGIRQEN1_AGIEN4_ENABLED       (ADCHS_ADCGIRQEN1_AGIEN4_ENABLED_Val << ADCHS_ADCGIRQEN1_AGIEN4_Pos) /* (ADCHS_ADCGIRQEN1) Interrupts are enabled for the selected analog input. The interrupt is generated after the converted data is ready (indicated by the AIRDYx bit of the ADCDSTAT1 register) Position  */
#define ADCHS_ADCGIRQEN1_AGIEN4_DISABLED      (ADCHS_ADCGIRQEN1_AGIEN4_DISABLED_Val << ADCHS_ADCGIRQEN1_AGIEN4_Pos) /* (ADCHS_ADCGIRQEN1) Interrupts are disabled Position  */
#define ADCHS_ADCGIRQEN1_AGIEN5_Pos           _UINT32_(5)                                          /* (ADCHS_ADCGIRQEN1) ADC Global Interrupt Enable bit Position */
#define ADCHS_ADCGIRQEN1_AGIEN5_Msk           (_UINT32_(0x1) << ADCHS_ADCGIRQEN1_AGIEN5_Pos)       /* (ADCHS_ADCGIRQEN1) ADC Global Interrupt Enable bit Mask */
#define ADCHS_ADCGIRQEN1_AGIEN5(value)        (ADCHS_ADCGIRQEN1_AGIEN5_Msk & (_UINT32_(value) << ADCHS_ADCGIRQEN1_AGIEN5_Pos)) /* Assigment of value for AGIEN5 in the ADCHS_ADCGIRQEN1 register */
#define   ADCHS_ADCGIRQEN1_AGIEN5_ENABLED_Val _UINT32_(0x1)                                        /* (ADCHS_ADCGIRQEN1) Interrupts are enabled for the selected analog input. The interrupt is generated after the converted data is ready (indicated by the AIRDYx bit of the ADCDSTAT1 register)  */
#define   ADCHS_ADCGIRQEN1_AGIEN5_DISABLED_Val _UINT32_(0x0)                                        /* (ADCHS_ADCGIRQEN1) Interrupts are disabled  */
#define ADCHS_ADCGIRQEN1_AGIEN5_ENABLED       (ADCHS_ADCGIRQEN1_AGIEN5_ENABLED_Val << ADCHS_ADCGIRQEN1_AGIEN5_Pos) /* (ADCHS_ADCGIRQEN1) Interrupts are enabled for the selected analog input. The interrupt is generated after the converted data is ready (indicated by the AIRDYx bit of the ADCDSTAT1 register) Position  */
#define ADCHS_ADCGIRQEN1_AGIEN5_DISABLED      (ADCHS_ADCGIRQEN1_AGIEN5_DISABLED_Val << ADCHS_ADCGIRQEN1_AGIEN5_Pos) /* (ADCHS_ADCGIRQEN1) Interrupts are disabled Position  */
#define ADCHS_ADCGIRQEN1_AGIEN6_Pos           _UINT32_(6)                                          /* (ADCHS_ADCGIRQEN1) ADC Global Interrupt Enable bit Position */
#define ADCHS_ADCGIRQEN1_AGIEN6_Msk           (_UINT32_(0x1) << ADCHS_ADCGIRQEN1_AGIEN6_Pos)       /* (ADCHS_ADCGIRQEN1) ADC Global Interrupt Enable bit Mask */
#define ADCHS_ADCGIRQEN1_AGIEN6(value)        (ADCHS_ADCGIRQEN1_AGIEN6_Msk & (_UINT32_(value) << ADCHS_ADCGIRQEN1_AGIEN6_Pos)) /* Assigment of value for AGIEN6 in the ADCHS_ADCGIRQEN1 register */
#define   ADCHS_ADCGIRQEN1_AGIEN6_ENABLED_Val _UINT32_(0x1)                                        /* (ADCHS_ADCGIRQEN1) Interrupts are enabled for the selected analog input. The interrupt is generated after the converted data is ready (indicated by the AIRDYx bit of the ADCDSTAT1 register)  */
#define   ADCHS_ADCGIRQEN1_AGIEN6_DISABLED_Val _UINT32_(0x0)                                        /* (ADCHS_ADCGIRQEN1) Interrupts are disabled  */
#define ADCHS_ADCGIRQEN1_AGIEN6_ENABLED       (ADCHS_ADCGIRQEN1_AGIEN6_ENABLED_Val << ADCHS_ADCGIRQEN1_AGIEN6_Pos) /* (ADCHS_ADCGIRQEN1) Interrupts are enabled for the selected analog input. The interrupt is generated after the converted data is ready (indicated by the AIRDYx bit of the ADCDSTAT1 register) Position  */
#define ADCHS_ADCGIRQEN1_AGIEN6_DISABLED      (ADCHS_ADCGIRQEN1_AGIEN6_DISABLED_Val << ADCHS_ADCGIRQEN1_AGIEN6_Pos) /* (ADCHS_ADCGIRQEN1) Interrupts are disabled Position  */
#define ADCHS_ADCGIRQEN1_AGIEN7_Pos           _UINT32_(7)                                          /* (ADCHS_ADCGIRQEN1) ADC Global Interrupt Enable bit Position */
#define ADCHS_ADCGIRQEN1_AGIEN7_Msk           (_UINT32_(0x1) << ADCHS_ADCGIRQEN1_AGIEN7_Pos)       /* (ADCHS_ADCGIRQEN1) ADC Global Interrupt Enable bit Mask */
#define ADCHS_ADCGIRQEN1_AGIEN7(value)        (ADCHS_ADCGIRQEN1_AGIEN7_Msk & (_UINT32_(value) << ADCHS_ADCGIRQEN1_AGIEN7_Pos)) /* Assigment of value for AGIEN7 in the ADCHS_ADCGIRQEN1 register */
#define   ADCHS_ADCGIRQEN1_AGIEN7_ENABLED_Val _UINT32_(0x1)                                        /* (ADCHS_ADCGIRQEN1) Interrupts are enabled for the selected analog input. The interrupt is generated after the converted data is ready (indicated by the AIRDYx bit of the ADCDSTAT1 register)  */
#define   ADCHS_ADCGIRQEN1_AGIEN7_DISABLED_Val _UINT32_(0x0)                                        /* (ADCHS_ADCGIRQEN1) Interrupts are disabled  */
#define ADCHS_ADCGIRQEN1_AGIEN7_ENABLED       (ADCHS_ADCGIRQEN1_AGIEN7_ENABLED_Val << ADCHS_ADCGIRQEN1_AGIEN7_Pos) /* (ADCHS_ADCGIRQEN1) Interrupts are enabled for the selected analog input. The interrupt is generated after the converted data is ready (indicated by the AIRDYx bit of the ADCDSTAT1 register) Position  */
#define ADCHS_ADCGIRQEN1_AGIEN7_DISABLED      (ADCHS_ADCGIRQEN1_AGIEN7_DISABLED_Val << ADCHS_ADCGIRQEN1_AGIEN7_Pos) /* (ADCHS_ADCGIRQEN1) Interrupts are disabled Position  */
#define ADCHS_ADCGIRQEN1_AGIEN8_Pos           _UINT32_(8)                                          /* (ADCHS_ADCGIRQEN1) ADC Global Interrupt Enable bit Position */
#define ADCHS_ADCGIRQEN1_AGIEN8_Msk           (_UINT32_(0x1) << ADCHS_ADCGIRQEN1_AGIEN8_Pos)       /* (ADCHS_ADCGIRQEN1) ADC Global Interrupt Enable bit Mask */
#define ADCHS_ADCGIRQEN1_AGIEN8(value)        (ADCHS_ADCGIRQEN1_AGIEN8_Msk & (_UINT32_(value) << ADCHS_ADCGIRQEN1_AGIEN8_Pos)) /* Assigment of value for AGIEN8 in the ADCHS_ADCGIRQEN1 register */
#define   ADCHS_ADCGIRQEN1_AGIEN8_ENABLED_Val _UINT32_(0x1)                                        /* (ADCHS_ADCGIRQEN1) Interrupts are enabled for the selected analog input. The interrupt is generated after the converted data is ready (indicated by the AIRDYx bit of the ADCDSTAT1 register)  */
#define   ADCHS_ADCGIRQEN1_AGIEN8_DISABLED_Val _UINT32_(0x0)                                        /* (ADCHS_ADCGIRQEN1) Interrupts are disabled  */
#define ADCHS_ADCGIRQEN1_AGIEN8_ENABLED       (ADCHS_ADCGIRQEN1_AGIEN8_ENABLED_Val << ADCHS_ADCGIRQEN1_AGIEN8_Pos) /* (ADCHS_ADCGIRQEN1) Interrupts are enabled for the selected analog input. The interrupt is generated after the converted data is ready (indicated by the AIRDYx bit of the ADCDSTAT1 register) Position  */
#define ADCHS_ADCGIRQEN1_AGIEN8_DISABLED      (ADCHS_ADCGIRQEN1_AGIEN8_DISABLED_Val << ADCHS_ADCGIRQEN1_AGIEN8_Pos) /* (ADCHS_ADCGIRQEN1) Interrupts are disabled Position  */
#define ADCHS_ADCGIRQEN1_AGIEN9_Pos           _UINT32_(9)                                          /* (ADCHS_ADCGIRQEN1) ADC Global Interrupt Enable bit Position */
#define ADCHS_ADCGIRQEN1_AGIEN9_Msk           (_UINT32_(0x1) << ADCHS_ADCGIRQEN1_AGIEN9_Pos)       /* (ADCHS_ADCGIRQEN1) ADC Global Interrupt Enable bit Mask */
#define ADCHS_ADCGIRQEN1_AGIEN9(value)        (ADCHS_ADCGIRQEN1_AGIEN9_Msk & (_UINT32_(value) << ADCHS_ADCGIRQEN1_AGIEN9_Pos)) /* Assigment of value for AGIEN9 in the ADCHS_ADCGIRQEN1 register */
#define   ADCHS_ADCGIRQEN1_AGIEN9_ENABLED_Val _UINT32_(0x1)                                        /* (ADCHS_ADCGIRQEN1) Interrupts are enabled for the selected analog input. The interrupt is generated after the converted data is ready (indicated by the AIRDYx bit of the ADCDSTAT1 register)  */
#define   ADCHS_ADCGIRQEN1_AGIEN9_DISABLED_Val _UINT32_(0x0)                                        /* (ADCHS_ADCGIRQEN1) Interrupts are disabled  */
#define ADCHS_ADCGIRQEN1_AGIEN9_ENABLED       (ADCHS_ADCGIRQEN1_AGIEN9_ENABLED_Val << ADCHS_ADCGIRQEN1_AGIEN9_Pos) /* (ADCHS_ADCGIRQEN1) Interrupts are enabled for the selected analog input. The interrupt is generated after the converted data is ready (indicated by the AIRDYx bit of the ADCDSTAT1 register) Position  */
#define ADCHS_ADCGIRQEN1_AGIEN9_DISABLED      (ADCHS_ADCGIRQEN1_AGIEN9_DISABLED_Val << ADCHS_ADCGIRQEN1_AGIEN9_Pos) /* (ADCHS_ADCGIRQEN1) Interrupts are disabled Position  */
#define ADCHS_ADCGIRQEN1_AGIEN10_Pos          _UINT32_(10)                                         /* (ADCHS_ADCGIRQEN1) ADC Global Interrupt Enable bit Position */
#define ADCHS_ADCGIRQEN1_AGIEN10_Msk          (_UINT32_(0x1) << ADCHS_ADCGIRQEN1_AGIEN10_Pos)      /* (ADCHS_ADCGIRQEN1) ADC Global Interrupt Enable bit Mask */
#define ADCHS_ADCGIRQEN1_AGIEN10(value)       (ADCHS_ADCGIRQEN1_AGIEN10_Msk & (_UINT32_(value) << ADCHS_ADCGIRQEN1_AGIEN10_Pos)) /* Assigment of value for AGIEN10 in the ADCHS_ADCGIRQEN1 register */
#define   ADCHS_ADCGIRQEN1_AGIEN10_ENABLED_Val _UINT32_(0x1)                                        /* (ADCHS_ADCGIRQEN1) Interrupts are enabled for the selected analog input. The interrupt is generated after the converted data is ready (indicated by the AIRDYx bit of the ADCDSTAT1 register)  */
#define   ADCHS_ADCGIRQEN1_AGIEN10_DISABLED_Val _UINT32_(0x0)                                        /* (ADCHS_ADCGIRQEN1) Interrupts are disabled  */
#define ADCHS_ADCGIRQEN1_AGIEN10_ENABLED      (ADCHS_ADCGIRQEN1_AGIEN10_ENABLED_Val << ADCHS_ADCGIRQEN1_AGIEN10_Pos) /* (ADCHS_ADCGIRQEN1) Interrupts are enabled for the selected analog input. The interrupt is generated after the converted data is ready (indicated by the AIRDYx bit of the ADCDSTAT1 register) Position  */
#define ADCHS_ADCGIRQEN1_AGIEN10_DISABLED     (ADCHS_ADCGIRQEN1_AGIEN10_DISABLED_Val << ADCHS_ADCGIRQEN1_AGIEN10_Pos) /* (ADCHS_ADCGIRQEN1) Interrupts are disabled Position  */
#define ADCHS_ADCGIRQEN1_AGIEN11_Pos          _UINT32_(11)                                         /* (ADCHS_ADCGIRQEN1) ADC Global Interrupt Enable bit Position */
#define ADCHS_ADCGIRQEN1_AGIEN11_Msk          (_UINT32_(0x1) << ADCHS_ADCGIRQEN1_AGIEN11_Pos)      /* (ADCHS_ADCGIRQEN1) ADC Global Interrupt Enable bit Mask */
#define ADCHS_ADCGIRQEN1_AGIEN11(value)       (ADCHS_ADCGIRQEN1_AGIEN11_Msk & (_UINT32_(value) << ADCHS_ADCGIRQEN1_AGIEN11_Pos)) /* Assigment of value for AGIEN11 in the ADCHS_ADCGIRQEN1 register */
#define   ADCHS_ADCGIRQEN1_AGIEN11_ENABLED_Val _UINT32_(0x1)                                        /* (ADCHS_ADCGIRQEN1) Interrupts are enabled for the selected analog input. The interrupt is generated after the converted data is ready (indicated by the AIRDYx bit of the ADCDSTAT1 register)  */
#define   ADCHS_ADCGIRQEN1_AGIEN11_DISABLED_Val _UINT32_(0x0)                                        /* (ADCHS_ADCGIRQEN1) Interrupts are disabled  */
#define ADCHS_ADCGIRQEN1_AGIEN11_ENABLED      (ADCHS_ADCGIRQEN1_AGIEN11_ENABLED_Val << ADCHS_ADCGIRQEN1_AGIEN11_Pos) /* (ADCHS_ADCGIRQEN1) Interrupts are enabled for the selected analog input. The interrupt is generated after the converted data is ready (indicated by the AIRDYx bit of the ADCDSTAT1 register) Position  */
#define ADCHS_ADCGIRQEN1_AGIEN11_DISABLED     (ADCHS_ADCGIRQEN1_AGIEN11_DISABLED_Val << ADCHS_ADCGIRQEN1_AGIEN11_Pos) /* (ADCHS_ADCGIRQEN1) Interrupts are disabled Position  */
#define ADCHS_ADCGIRQEN1_Msk                  _UINT32_(0x00000FFF)                                 /* (ADCHS_ADCGIRQEN1) Register Mask  */

#define ADCHS_ADCGIRQEN1_AGIEN_Pos            _UINT32_(0)                                          /* (ADCHS_ADCGIRQEN1 Position) ADC Global Interrupt Enable bit */
#define ADCHS_ADCGIRQEN1_AGIEN_Msk            (_UINT32_(0xFFF) << ADCHS_ADCGIRQEN1_AGIEN_Pos)      /* (ADCHS_ADCGIRQEN1 Mask) AGIEN */
#define ADCHS_ADCGIRQEN1_AGIEN(value)         (ADCHS_ADCGIRQEN1_AGIEN_Msk & (_UINT32_(value) << ADCHS_ADCGIRQEN1_AGIEN_Pos)) 

/* -------- ADCHS_ADCGIRQEN1CLR : (ADCHS Offset: 0x84) (R/W 32) Bit clear register -------- */
#define ADCHS_ADCGIRQEN1CLR_RESETVALUE        _UINT32_(0x00)                                       /*  (ADCHS_ADCGIRQEN1CLR) Bit clear register  Reset Value */

#define ADCHS_ADCGIRQEN1CLR_Msk               _UINT32_(0x00000000)                                 /* (ADCHS_ADCGIRQEN1CLR) Register Mask  */


/* -------- ADCHS_ADCGIRQEN1SET : (ADCHS Offset: 0x88) (R/W 32) Bit set register -------- */
#define ADCHS_ADCGIRQEN1SET_RESETVALUE        _UINT32_(0x00)                                       /*  (ADCHS_ADCGIRQEN1SET) Bit set register  Reset Value */

#define ADCHS_ADCGIRQEN1SET_Msk               _UINT32_(0x00000000)                                 /* (ADCHS_ADCGIRQEN1SET) Register Mask  */


/* -------- ADCHS_ADCGIRQEN1INV : (ADCHS Offset: 0x8C) (R/W 32) Bit invert register -------- */
#define ADCHS_ADCGIRQEN1INV_RESETVALUE        _UINT32_(0x00)                                       /*  (ADCHS_ADCGIRQEN1INV) Bit invert register  Reset Value */

#define ADCHS_ADCGIRQEN1INV_Msk               _UINT32_(0x00000000)                                 /* (ADCHS_ADCGIRQEN1INV) Register Mask  */


/* -------- ADCHS_ADCCSS1 : (ADCHS Offset: 0xA0) (R/W 32)  -------- */
#define ADCHS_ADCCSS1_RESETVALUE              _UINT32_(0x00)                                       /*  (ADCHS_ADCCSS1)   Reset Value */
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
