nsaspook/wbz451matter/src/packs/WBZ451_DFP/component/cfg.h

/*
 * Component description for CFG
 *
 * Copyright (c) 2023 Microchip Technology Inc. and its subsidiaries.
 *
 * Licensed under the Apache License, Version 2.0 (the "License");
 * you may not use this file except in compliance with the License.
 * You may obtain a copy of the License at
 *
 *   http://www.apache.org/licenses/LICENSE-2.0
 *
 * Unless required by applicable law or agreed to in writing, software
 * distributed under the License is distributed on an "AS IS" BASIS,
 * WITHOUT WARRANTIES OR CONDITIONS OF ANY KIND, either express or implied.
 * See the License for the specific language governing permissions and
 * limitations under the License.
 *
 */

/* file generated from device description file (ATDF) version 2023-10-17T09:04:59Z */
#ifndef _BZ45_CFG_COMPONENT_H_
#define _BZ45_CFG_COMPONENT_H_

/* ************************************************************************** */
/*   SOFTWARE API DEFINITION FOR CFG                                          */
/* ************************************************************************** */

/* -------- CFG_CFGCON0 : (CFG Offset: 0x00) (R/W 32)  -------- */
#define CFG_CFGCON0_RESETVALUE                _UINT32_(0x7100000B)                                 /*  (CFG_CFGCON0)   Reset Value */

#define CFG_CFGCON0_TDOEN_Pos                 _UINT32_(0)                                          /* (CFG_CFGCON0) TDO enable for 2-wire JTAG Position */
#define CFG_CFGCON0_TDOEN_Msk                 (_UINT32_(0x1) << CFG_CFGCON0_TDOEN_Pos)             /* (CFG_CFGCON0) TDO enable for 2-wire JTAG Mask */
#define CFG_CFGCON0_TDOEN(value)              (CFG_CFGCON0_TDOEN_Msk & (_UINT32_(value) << CFG_CFGCON0_TDOEN_Pos)) /* Assigment of value for TDOEN in the CFG_CFGCON0 register */
#define CFG_CFGCON0_SWOEN_Pos                 _UINT32_(1)                                          /* (CFG_CFGCON0) SWO enable on 2-wire debug interface Position */
#define CFG_CFGCON0_SWOEN_Msk                 (_UINT32_(0x1) << CFG_CFGCON0_SWOEN_Pos)             /* (CFG_CFGCON0) SWO enable on 2-wire debug interface Mask */
#define CFG_CFGCON0_SWOEN(value)              (CFG_CFGCON0_SWOEN_Msk & (_UINT32_(value) << CFG_CFGCON0_SWOEN_Pos)) /* Assigment of value for SWOEN in the CFG_CFGCON0 register */
#define CFG_CFGCON0_TROEN_Pos                 _UINT32_(2)                                          /* (CFG_CFGCON0) Trace Output Enable Position */
#define CFG_CFGCON0_TROEN_Msk                 (_UINT32_(0x1) << CFG_CFGCON0_TROEN_Pos)             /* (CFG_CFGCON0) Trace Output Enable Mask */
#define CFG_CFGCON0_TROEN(value)              (CFG_CFGCON0_TROEN_Msk & (_UINT32_(value) << CFG_CFGCON0_TROEN_Pos)) /* Assigment of value for TROEN in the CFG_CFGCON0 register */
#define CFG_CFGCON0_JTAGEN_Pos                _UINT32_(3)                                          /* (CFG_CFGCON0) JTAG Enable Position */
#define CFG_CFGCON0_JTAGEN_Msk                (_UINT32_(0x1) << CFG_CFGCON0_JTAGEN_Pos)            /* (CFG_CFGCON0) JTAG Enable Mask */
#define CFG_CFGCON0_JTAGEN(value)             (CFG_CFGCON0_JTAGEN_Msk & (_UINT32_(value) << CFG_CFGCON0_JTAGEN_Pos)) /* Assigment of value for JTAGEN in the CFG_CFGCON0 register */
#define CFG_CFGCON0_ADCPOVR_Pos               _UINT32_(4)                                          /* (CFG_CFGCON0) ADC Charge Pump Override Position */
#define CFG_CFGCON0_ADCPOVR_Msk               (_UINT32_(0x1) << CFG_CFGCON0_ADCPOVR_Pos)           /* (CFG_CFGCON0) ADC Charge Pump Override Mask */
#define CFG_CFGCON0_ADCPOVR(value)            (CFG_CFGCON0_ADCPOVR_Msk & (_UINT32_(value) << CFG_CFGCON0_ADCPOVR_Pos)) /* Assigment of value for ADCPOVR in the CFG_CFGCON0 register */
#define CFG_CFGCON0_ACCMP1_ALTEN_Pos          _UINT32_(6)                                          /* (CFG_CFGCON0) AC CMP1 Alternate Enable Position */
#define CFG_CFGCON0_ACCMP1_ALTEN_Msk          (_UINT32_(0x1) << CFG_CFGCON0_ACCMP1_ALTEN_Pos)      /* (CFG_CFGCON0) AC CMP1 Alternate Enable Mask */
#define CFG_CFGCON0_ACCMP1_ALTEN(value)       (CFG_CFGCON0_ACCMP1_ALTEN_Msk & (_UINT32_(value) << CFG_CFGCON0_ACCMP1_ALTEN_Pos)) /* Assigment of value for ACCMP1_ALTEN in the CFG_CFGCON0 register */
#define CFG_CFGCON0_CPENFILT_Pos              _UINT32_(7)                                          /* (CFG_CFGCON0) ADC CP Filter Enable Position */
#define CFG_CFGCON0_CPENFILT_Msk              (_UINT32_(0x1) << CFG_CFGCON0_CPENFILT_Pos)          /* (CFG_CFGCON0) ADC CP Filter Enable Mask */
#define CFG_CFGCON0_CPENFILT(value)           (CFG_CFGCON0_CPENFILT_Msk & (_UINT32_(value) << CFG_CFGCON0_CPENFILT_Pos)) /* Assigment of value for CPENFILT in the CFG_CFGCON0 register */
#define CFG_CFGCON0_RTCIN0_ALTEN_Pos          _UINT32_(8)                                          /* (CFG_CFGCON0) RTCIN0 Alternate Enable Position */
#define CFG_CFGCON0_RTCIN0_ALTEN_Msk          (_UINT32_(0x1) << CFG_CFGCON0_RTCIN0_ALTEN_Pos)      /* (CFG_CFGCON0) RTCIN0 Alternate Enable Mask */
#define CFG_CFGCON0_RTCIN0_ALTEN(value)       (CFG_CFGCON0_RTCIN0_ALTEN_Msk & (_UINT32_(value) << CFG_CFGCON0_RTCIN0_ALTEN_Pos)) /* Assigment of value for RTCIN0_ALTEN in the CFG_CFGCON0 register */
#define CFG_CFGCON0_RTCOUT_ALTEN_Pos          _UINT32_(9)                                          /* (CFG_CFGCON0) RTCOUT Alternate Enable Position */
#define CFG_CFGCON0_RTCOUT_ALTEN_Msk          (_UINT32_(0x1) << CFG_CFGCON0_RTCOUT_ALTEN_Pos)      /* (CFG_CFGCON0) RTCOUT Alternate Enable Mask */
#define CFG_CFGCON0_RTCOUT_ALTEN(value)       (CFG_CFGCON0_RTCOUT_ALTEN_Msk & (_UINT32_(value) << CFG_CFGCON0_RTCOUT_ALTEN_Pos)) /* Assigment of value for RTCOUT_ALTEN in the CFG_CFGCON0 register */
#define CFG_CFGCON0_PMULOCK_Pos               _UINT32_(10)                                         /* (CFG_CFGCON0) PMU Controller Register LOCK Position */
#define CFG_CFGCON0_PMULOCK_Msk               (_UINT32_(0x1) << CFG_CFGCON0_PMULOCK_Pos)           /* (CFG_CFGCON0) PMU Controller Register LOCK Mask */
#define CFG_CFGCON0_PMULOCK(value)            (CFG_CFGCON0_PMULOCK_Msk & (_UINT32_(value) << CFG_CFGCON0_PMULOCK_Pos)) /* Assigment of value for PMULOCK in the CFG_CFGCON0 register */
#define CFG_CFGCON0_PGLCOK_Pos                _UINT32_(11)                                         /* (CFG_CFGCON0) Permission Group LOCK Position */
#define CFG_CFGCON0_PGLCOK_Msk                (_UINT32_(0x1) << CFG_CFGCON0_PGLCOK_Pos)            /* (CFG_CFGCON0) Permission Group LOCK Mask */
#define CFG_CFGCON0_PGLCOK(value)             (CFG_CFGCON0_PGLCOK_Msk & (_UINT32_(value) << CFG_CFGCON0_PGLCOK_Pos)) /* Assigment of value for PGLCOK in the CFG_CFGCON0 register */
#define CFG_CFGCON0_PMDLOCK_Pos               _UINT32_(12)                                         /* (CFG_CFGCON0) Peripheral Module Disable (PMD) LOCK Position */
#define CFG_CFGCON0_PMDLOCK_Msk               (_UINT32_(0x1) << CFG_CFGCON0_PMDLOCK_Pos)           /* (CFG_CFGCON0) Peripheral Module Disable (PMD) LOCK Mask */
#define CFG_CFGCON0_PMDLOCK(value)            (CFG_CFGCON0_PMDLOCK_Msk & (_UINT32_(value) << CFG_CFGCON0_PMDLOCK_Pos)) /* Assigment of value for PMDLOCK in the CFG_CFGCON0 register */
#define CFG_CFGCON0_IOLOCK_Pos                _UINT32_(13)                                         /* (CFG_CFGCON0) IO LOCK Position */
#define CFG_CFGCON0_IOLOCK_Msk                (_UINT32_(0x1) << CFG_CFGCON0_IOLOCK_Pos)            /* (CFG_CFGCON0) IO LOCK Mask */
#define CFG_CFGCON0_IOLOCK(value)             (CFG_CFGCON0_IOLOCK_Msk & (_UINT32_(value) << CFG_CFGCON0_IOLOCK_Pos)) /* Assigment of value for IOLOCK in the CFG_CFGCON0 register */
#define CFG_CFGCON0_CFGCLOCK_Pos              _UINT32_(14)                                         /* (CFG_CFGCON0) Configuration Register Lock Position */
#define CFG_CFGCON0_CFGCLOCK_Msk              (_UINT32_(0x3) << CFG_CFGCON0_CFGCLOCK_Pos)          /* (CFG_CFGCON0) Configuration Register Lock Mask */
#define CFG_CFGCON0_CFGCLOCK(value)           (CFG_CFGCON0_CFGCLOCK_Msk & (_UINT32_(value) << CFG_CFGCON0_CFGCLOCK_Pos)) /* Assigment of value for CFGCLOCK in the CFG_CFGCON0 register */
#define CFG_CFGCON0_VBCMODE_Pos               _UINT32_(16)                                         /* (CFG_CFGCON0) VBC Operating Mode Position */
#define CFG_CFGCON0_VBCMODE_Msk               (_UINT32_(0x1) << CFG_CFGCON0_VBCMODE_Pos)           /* (CFG_CFGCON0) VBC Operating Mode Mask */
#define CFG_CFGCON0_VBCMODE(value)            (CFG_CFGCON0_VBCMODE_Msk & (_UINT32_(value) << CFG_CFGCON0_VBCMODE_Pos)) /* Assigment of value for VBCMODE in the CFG_CFGCON0 register */
#define CFG_CFGCON0_SMBUSEN0_Pos              _UINT32_(17)                                         /* (CFG_CFGCON0) SMBus Enable for SERCOM0 Position */
#define CFG_CFGCON0_SMBUSEN0_Msk              (_UINT32_(0x1) << CFG_CFGCON0_SMBUSEN0_Pos)          /* (CFG_CFGCON0) SMBus Enable for SERCOM0 Mask */
#define CFG_CFGCON0_SMBUSEN0(value)           (CFG_CFGCON0_SMBUSEN0_Msk & (_UINT32_(value) << CFG_CFGCON0_SMBUSEN0_Pos)) /* Assigment of value for SMBUSEN0 in the CFG_CFGCON0 register */
#define CFG_CFGCON0_SMBUSEN1_Pos              _UINT32_(18)                                         /* (CFG_CFGCON0) SMBus Enable for SERCOM1 Position */
#define CFG_CFGCON0_SMBUSEN1_Msk              (_UINT32_(0x1) << CFG_CFGCON0_SMBUSEN1_Pos)          /* (CFG_CFGCON0) SMBus Enable for SERCOM1 Mask */
#define CFG_CFGCON0_SMBUSEN1(value)           (CFG_CFGCON0_SMBUSEN1_Msk & (_UINT32_(value) << CFG_CFGCON0_SMBUSEN1_Pos)) /* Assigment of value for SMBUSEN1 in the CFG_CFGCON0 register */
#define CFG_CFGCON0_SMBUSEN2_Pos              _UINT32_(19)                                         /* (CFG_CFGCON0) SMBus Enable for SERCOM2 Position */
#define CFG_CFGCON0_SMBUSEN2_Msk              (_UINT32_(0x1) << CFG_CFGCON0_SMBUSEN2_Pos)          /* (CFG_CFGCON0) SMBus Enable for SERCOM2 Mask */
#define CFG_CFGCON0_SMBUSEN2(value)           (CFG_CFGCON0_SMBUSEN2_Msk & (_UINT32_(value) << CFG_CFGCON0_SMBUSEN2_Pos)) /* Assigment of value for SMBUSEN2 in the CFG_CFGCON0 register */
#define CFG_CFGCON0_HPLUGDIS_Pos              _UINT32_(20)                                         /* (CFG_CFGCON0) Hot Plugging Disable Position */
#define CFG_CFGCON0_HPLUGDIS_Msk              (_UINT32_(0x1) << CFG_CFGCON0_HPLUGDIS_Pos)          /* (CFG_CFGCON0) Hot Plugging Disable Mask */
#define CFG_CFGCON0_HPLUGDIS(value)           (CFG_CFGCON0_HPLUGDIS_Msk & (_UINT32_(value) << CFG_CFGCON0_HPLUGDIS_Pos)) /* Assigment of value for HPLUGDIS in the CFG_CFGCON0 register */
#define CFG_CFGCON0_SLRTEN0_Pos               _UINT32_(21)                                         /* (CFG_CFGCON0) SLRT Enable for SERCOM0 Position */
#define CFG_CFGCON0_SLRTEN0_Msk               (_UINT32_(0x1) << CFG_CFGCON0_SLRTEN0_Pos)           /* (CFG_CFGCON0) SLRT Enable for SERCOM0 Mask */
#define CFG_CFGCON0_SLRTEN0(value)            (CFG_CFGCON0_SLRTEN0_Msk & (_UINT32_(value) << CFG_CFGCON0_SLRTEN0_Pos)) /* Assigment of value for SLRTEN0 in the CFG_CFGCON0 register */
#define CFG_CFGCON0_SLRTEN1_Pos               _UINT32_(22)                                         /* (CFG_CFGCON0) SLRT Enable for SERCOM1 Position */
#define CFG_CFGCON0_SLRTEN1_Msk               (_UINT32_(0x1) << CFG_CFGCON0_SLRTEN1_Pos)           /* (CFG_CFGCON0) SLRT Enable for SERCOM1 Mask */
#define CFG_CFGCON0_SLRTEN1(value)            (CFG_CFGCON0_SLRTEN1_Msk & (_UINT32_(value) << CFG_CFGCON0_SLRTEN1_Pos)) /* Assigment of value for SLRTEN1 in the CFG_CFGCON0 register */
#define CFG_CFGCON0_SLRTEN2_Pos               _UINT32_(23)                                         /* (CFG_CFGCON0) SLRT Enable for SERCOM2 Position */
#define CFG_CFGCON0_SLRTEN2_Msk               (_UINT32_(0x1) << CFG_CFGCON0_SLRTEN2_Pos)           /* (CFG_CFGCON0) SLRT Enable for SERCOM2 Mask */
#define CFG_CFGCON0_SLRTEN2(value)            (CFG_CFGCON0_SLRTEN2_Msk & (_UINT32_(value) << CFG_CFGCON0_SLRTEN2_Pos)) /* Assigment of value for SLRTEN2 in the CFG_CFGCON0 register */
#define CFG_CFGCON0_PCM_Pos                   _UINT32_(24)                                         /* (CFG_CFGCON0) PCHE I/D Cacheable Mode Position */
#define CFG_CFGCON0_PCM_Msk                   (_UINT32_(0x1) << CFG_CFGCON0_PCM_Pos)               /* (CFG_CFGCON0) PCHE I/D Cacheable Mode Mask */
#define CFG_CFGCON0_PCM(value)                (CFG_CFGCON0_PCM_Msk & (_UINT32_(value) << CFG_CFGCON0_PCM_Pos)) /* Assigment of value for PCM in the CFG_CFGCON0 register */
#define CFG_CFGCON0_INT0E_Pos                 _UINT32_(25)                                         /* (CFG_CFGCON0) INT0 Enable Position */
#define CFG_CFGCON0_INT0E_Msk                 (_UINT32_(0x1) << CFG_CFGCON0_INT0E_Pos)             /* (CFG_CFGCON0) INT0 Enable Mask */
#define CFG_CFGCON0_INT0E(value)              (CFG_CFGCON0_INT0E_Msk & (_UINT32_(value) << CFG_CFGCON0_INT0E_Pos)) /* Assigment of value for INT0E in the CFG_CFGCON0 register */
#define CFG_CFGCON0_INT0P_Pos                 _UINT32_(26)                                         /* (CFG_CFGCON0) INT0P Polarity Position */
#define CFG_CFGCON0_INT0P_Msk                 (_UINT32_(0x1) << CFG_CFGCON0_INT0P_Pos)             /* (CFG_CFGCON0) INT0P Polarity Mask */
#define CFG_CFGCON0_INT0P(value)              (CFG_CFGCON0_INT0P_Msk & (_UINT32_(value) << CFG_CFGCON0_INT0P_Pos)) /* Assigment of value for INT0P in the CFG_CFGCON0 register */
#define CFG_CFGCON0_FECCCON_Pos               _UINT32_(28)                                         /* (CFG_CFGCON0) Flash ECC Control Position */
#define CFG_CFGCON0_FECCCON_Msk               (_UINT32_(0x3) << CFG_CFGCON0_FECCCON_Pos)           /* (CFG_CFGCON0) Flash ECC Control Mask */
#define CFG_CFGCON0_FECCCON(value)            (CFG_CFGCON0_FECCCON_Msk & (_UINT32_(value) << CFG_CFGCON0_FECCCON_Pos)) /* Assigment of value for FECCCON in the CFG_CFGCON0 register */
#define CFG_CFGCON0_FRECCDIS_Pos              _UINT32_(30)                                         /* (CFG_CFGCON0) Flex RAM ECC Control Position */
#define CFG_CFGCON0_FRECCDIS_Msk              (_UINT32_(0x1) << CFG_CFGCON0_FRECCDIS_Pos)          /* (CFG_CFGCON0) Flex RAM ECC Control Mask */
#define CFG_CFGCON0_FRECCDIS(value)           (CFG_CFGCON0_FRECCDIS_Msk & (_UINT32_(value) << CFG_CFGCON0_FRECCDIS_Pos)) /* Assigment of value for FRECCDIS in the CFG_CFGCON0 register */
#define CFG_CFGCON0_Msk                       _UINT32_(0x77FFFFDF)                                 /* (CFG_CFGCON0) Register Mask  */

#define CFG_CFGCON0_SMBUSEN_Pos               _UINT32_(17)                                         /* (CFG_CFGCON0 Position) SMBus Enable for SERCOMx */
#define CFG_CFGCON0_SMBUSEN_Msk               (_UINT32_(0x7) << CFG_CFGCON0_SMBUSEN_Pos)           /* (CFG_CFGCON0 Mask) SMBUSEN */
#define CFG_CFGCON0_SMBUSEN(value)            (CFG_CFGCON0_SMBUSEN_Msk & (_UINT32_(value) << CFG_CFGCON0_SMBUSEN_Pos)) 
#define CFG_CFGCON0_SLRTEN_Pos                _UINT32_(21)                                         /* (CFG_CFGCON0 Position) SLRT Enable for SERCOMx */
#define CFG_CFGCON0_SLRTEN_Msk                (_UINT32_(0x7) << CFG_CFGCON0_SLRTEN_Pos)            /* (CFG_CFGCON0 Mask) SLRTEN */
#define CFG_CFGCON0_SLRTEN(value)             (CFG_CFGCON0_SLRTEN_Msk & (_UINT32_(value) << CFG_CFGCON0_SLRTEN_Pos)) 

/* -------- CFG_CFGCON0CLR : (CFG Offset: 0x04) (R/W 32) Bit clear register -------- */
#define CFG_CFGCON0CLR_RESETVALUE             _UINT32_(0x00)                                       /*  (CFG_CFGCON0CLR) Bit clear register  Reset Value */

#define CFG_CFGCON0CLR_Msk                    _UINT32_(0x00000000)                                 /* (CFG_CFGCON0CLR) Register Mask  */


/* -------- CFG_CFGCON0SET : (CFG Offset: 0x08) (R/W 32) Bit set register -------- */
#define CFG_CFGCON0SET_RESETVALUE             _UINT32_(0x00)                                       /*  (CFG_CFGCON0SET) Bit set register  Reset Value */

#define CFG_CFGCON0SET_Msk                    _UINT32_(0x00000000)                                 /* (CFG_CFGCON0SET) Register Mask  */


/* -------- CFG_CFGCON0INV : (CFG Offset: 0x0C) (R/W 32) Bit invert register -------- */
#define CFG_CFGCON0INV_RESETVALUE             _UINT32_(0x00)                                       /*  (CFG_CFGCON0INV) Bit invert register  Reset Value */

#define CFG_CFGCON0INV_Msk                    _UINT32_(0x00000000)                                 /* (CFG_CFGCON0INV) Register Mask  */


/* -------- CFG_CFGCON1 : (CFG Offset: 0x10) (R/W 32)  -------- */
#define CFG_CFGCON1_RESETVALUE                _UINT32_(0x1F00443B)                                 /*  (CFG_CFGCON1)   Reset Value */

#define CFG_CFGCON1_DEBUG_Pos                 _UINT32_(0)                                          /* (CFG_CFGCON1) Background Debugger Access Selection Position */
#define CFG_CFGCON1_DEBUG_Msk                 (_UINT32_(0x3) << CFG_CFGCON1_DEBUG_Pos)             /* (CFG_CFGCON1) Background Debugger Access Selection Mask */
#define CFG_CFGCON1_DEBUG(value)              (CFG_CFGCON1_DEBUG_Msk & (_UINT32_(value) << CFG_CFGCON1_DEBUG_Pos)) /* Assigment of value for DEBUG in the CFG_CFGCON1 register */
#define CFG_CFGCON1_ICESEL_Pos                _UINT32_(3)                                          /* (CFG_CFGCON1) EMUC/EMUD Communication Channel Select Position */
#define CFG_CFGCON1_ICESEL_Msk                (_UINT32_(0x3) << CFG_CFGCON1_ICESEL_Pos)            /* (CFG_CFGCON1) EMUC/EMUD Communication Channel Select Mask */
#define CFG_CFGCON1_ICESEL(value)             (CFG_CFGCON1_ICESEL_Msk & (_UINT32_(value) << CFG_CFGCON1_ICESEL_Pos)) /* Assigment of value for ICESEL in the CFG_CFGCON1 register */
#define CFG_CFGCON1_TRCEN_Pos                 _UINT32_(5)                                          /* (CFG_CFGCON1) Trace Enable Position */
#define CFG_CFGCON1_TRCEN_Msk                 (_UINT32_(0x1) << CFG_CFGCON1_TRCEN_Pos)             /* (CFG_CFGCON1) Trace Enable Mask */
#define CFG_CFGCON1_TRCEN(value)              (CFG_CFGCON1_TRCEN_Msk & (_UINT32_(value) << CFG_CFGCON1_TRCEN_Pos)) /* Assigment of value for TRCEN in the CFG_CFGCON1 register */
#define CFG_CFGCON1_ZBTWKSYS_Pos              _UINT32_(7)                                          /* (CFG_CFGCON1) ZBT Subsystem External Wake-up source Position */
#define CFG_CFGCON1_ZBTWKSYS_Msk              (_UINT32_(0x1) << CFG_CFGCON1_ZBTWKSYS_Pos)          /* (CFG_CFGCON1) ZBT Subsystem External Wake-up source Mask */
#define CFG_CFGCON1_ZBTWKSYS(value)           (CFG_CFGCON1_ZBTWKSYS_Msk & (_UINT32_(value) << CFG_CFGCON1_ZBTWKSYS_Pos)) /* Assigment of value for ZBTWKSYS in the CFG_CFGCON1 register */
#define CFG_CFGCON1_CMP0_OE_Pos               _UINT32_(8)                                          /* (CFG_CFGCON1) Analog Comparator-0 Output Enable Position */
#define CFG_CFGCON1_CMP0_OE_Msk               (_UINT32_(0x1) << CFG_CFGCON1_CMP0_OE_Pos)           /* (CFG_CFGCON1) Analog Comparator-0 Output Enable Mask */
#define CFG_CFGCON1_CMP0_OE(value)            (CFG_CFGCON1_CMP0_OE_Msk & (_UINT32_(value) << CFG_CFGCON1_CMP0_OE_Pos)) /* Assigment of value for CMP0_OE in the CFG_CFGCON1 register */
#define CFG_CFGCON1_CMP1_OE_Pos               _UINT32_(9)                                          /* (CFG_CFGCON1) Analog Comparator-1 Output Enable Position */
#define CFG_CFGCON1_CMP1_OE_Msk               (_UINT32_(0x1) << CFG_CFGCON1_CMP1_OE_Pos)           /* (CFG_CFGCON1) Analog Comparator-1 Output Enable Mask */
#define CFG_CFGCON1_CMP1_OE(value)            (CFG_CFGCON1_CMP1_OE_Msk & (_UINT32_(value) << CFG_CFGCON1_CMP1_OE_Pos)) /* Assigment of value for CMP1_OE in the CFG_CFGCON1 register */
#define CFG_CFGCON1_CLASSBDIS_Pos             _UINT32_(10)                                         /* (CFG_CFGCON1) Disable CLASSB Device Functionality Position */
#define CFG_CFGCON1_CLASSBDIS_Msk             (_UINT32_(0x1) << CFG_CFGCON1_CLASSBDIS_Pos)         /* (CFG_CFGCON1) Disable CLASSB Device Functionality Mask */
#define CFG_CFGCON1_CLASSBDIS(value)          (CFG_CFGCON1_CLASSBDIS_Msk & (_UINT32_(value) << CFG_CFGCON1_CLASSBDIS_Pos)) /* Assigment of value for CLASSBDIS in the CFG_CFGCON1 register */
#define CFG_CFGCON1_SLRCTRL0_Pos              _UINT32_(11)                                         /* (CFG_CFGCON1) I2C Slew Rate Control for SERCOM0 Position */
#define CFG_CFGCON1_SLRCTRL0_Msk              (_UINT32_(0x1) << CFG_CFGCON1_SLRCTRL0_Pos)          /* (CFG_CFGCON1) I2C Slew Rate Control for SERCOM0 Mask */
#define CFG_CFGCON1_SLRCTRL0(value)           (CFG_CFGCON1_SLRCTRL0_Msk & (_UINT32_(value) << CFG_CFGCON1_SLRCTRL0_Pos)) /* Assigment of value for SLRCTRL0 in the CFG_CFGCON1 register */
#define CFG_CFGCON1_SLRCTRL1_Pos              _UINT32_(12)                                         /* (CFG_CFGCON1) I2C Slew Rate Control for SERCOM1 Position */
#define CFG_CFGCON1_SLRCTRL1_Msk              (_UINT32_(0x1) << CFG_CFGCON1_SLRCTRL1_Pos)          /* (CFG_CFGCON1) I2C Slew Rate Control for SERCOM1 Mask */
#define CFG_CFGCON1_SLRCTRL1(value)           (CFG_CFGCON1_SLRCTRL1_Msk & (_UINT32_(value) << CFG_CFGCON1_SLRCTRL1_Pos)) /* Assigment of value for SLRCTRL1 in the CFG_CFGCON1 register */
#define CFG_CFGCON1_SLRCTRL2_Pos              _UINT32_(13)                                         /* (CFG_CFGCON1) I2C Slew Rate Control for SERCOM2 Position */
#define CFG_CFGCON1_SLRCTRL2_Msk              (_UINT32_(0x1) << CFG_CFGCON1_SLRCTRL2_Pos)          /* (CFG_CFGCON1) I2C Slew Rate Control for SERCOM2 Mask */
#define CFG_CFGCON1_SLRCTRL2(value)           (CFG_CFGCON1_SLRCTRL2_Msk & (_UINT32_(value) << CFG_CFGCON1_SLRCTRL2_Pos)) /* Assigment of value for SLRCTRL2 in the CFG_CFGCON1 register */
#define CFG_CFGCON1_SMCLR_Pos                 _UINT32_(14)                                         /* (CFG_CFGCON1) Selects CRU handling of MCLR Control Position */
#define CFG_CFGCON1_SMCLR_Msk                 (_UINT32_(0x1) << CFG_CFGCON1_SMCLR_Pos)             /* (CFG_CFGCON1) Selects CRU handling of MCLR Control Mask */
#define CFG_CFGCON1_SMCLR(value)              (CFG_CFGCON1_SMCLR_Msk & (_UINT32_(value) << CFG_CFGCON1_SMCLR_Pos)) /* Assigment of value for SMCLR in the CFG_CFGCON1 register */
#define CFG_CFGCON1_QSCHE_EN_Pos              _UINT32_(15)                                         /* (CFG_CFGCON1) QSPI Address Space Cache Attribute Position */
#define CFG_CFGCON1_QSCHE_EN_Msk              (_UINT32_(0x1) << CFG_CFGCON1_QSCHE_EN_Pos)          /* (CFG_CFGCON1) QSPI Address Space Cache Attribute Mask */
#define CFG_CFGCON1_QSCHE_EN(value)           (CFG_CFGCON1_QSCHE_EN_Msk & (_UINT32_(value) << CFG_CFGCON1_QSCHE_EN_Pos)) /* Assigment of value for QSCHE_EN in the CFG_CFGCON1 register */
#define CFG_CFGCON1_QSPI_HSEN_Pos             _UINT32_(16)                                         /* (CFG_CFGCON1) QSPI (Direct) Enable Position */
#define CFG_CFGCON1_QSPI_HSEN_Msk             (_UINT32_(0x1) << CFG_CFGCON1_QSPI_HSEN_Pos)         /* (CFG_CFGCON1) QSPI (Direct) Enable Mask */
#define CFG_CFGCON1_QSPI_HSEN(value)          (CFG_CFGCON1_QSPI_HSEN_Msk & (_UINT32_(value) << CFG_CFGCON1_QSPI_HSEN_Pos)) /* Assigment of value for QSPI_HSEN in the CFG_CFGCON1 register */
#define CFG_CFGCON1_SCOM0_HSEN_Pos            _UINT32_(17)                                         /* (CFG_CFGCON1) SERCOM0 (Direct)High Speed Pin Enable Position */
#define CFG_CFGCON1_SCOM0_HSEN_Msk            (_UINT32_(0x1) << CFG_CFGCON1_SCOM0_HSEN_Pos)        /* (CFG_CFGCON1) SERCOM0 (Direct)High Speed Pin Enable Mask */
#define CFG_CFGCON1_SCOM0_HSEN(value)         (CFG_CFGCON1_SCOM0_HSEN_Msk & (_UINT32_(value) << CFG_CFGCON1_SCOM0_HSEN_Pos)) /* Assigment of value for SCOM0_HSEN in the CFG_CFGCON1 register */
#define CFG_CFGCON1_SCOM1_HSEN_Pos            _UINT32_(18)                                         /* (CFG_CFGCON1) SERCOM1 (Direct)High Speed Pin Enable Position */
#define CFG_CFGCON1_SCOM1_HSEN_Msk            (_UINT32_(0x1) << CFG_CFGCON1_SCOM1_HSEN_Pos)        /* (CFG_CFGCON1) SERCOM1 (Direct)High Speed Pin Enable Mask */
#define CFG_CFGCON1_SCOM1_HSEN(value)         (CFG_CFGCON1_SCOM1_HSEN_Msk & (_UINT32_(value) << CFG_CFGCON1_SCOM1_HSEN_Pos)) /* Assigment of value for SCOM1_HSEN in the CFG_CFGCON1 register */
#define CFG_CFGCON1_SCOM2_HSEN_Pos            _UINT32_(19)                                         /* (CFG_CFGCON1) SERCOM2 (Direct)High Speed Pin Enable Position */
#define CFG_CFGCON1_SCOM2_HSEN_Msk            (_UINT32_(0x1) << CFG_CFGCON1_SCOM2_HSEN_Pos)        /* (CFG_CFGCON1) SERCOM2 (Direct)High Speed Pin Enable Mask */
#define CFG_CFGCON1_SCOM2_HSEN(value)         (CFG_CFGCON1_SCOM2_HSEN_Msk & (_UINT32_(value) << CFG_CFGCON1_SCOM2_HSEN_Pos)) /* Assigment of value for SCOM2_HSEN in the CFG_CFGCON1 register */
#define CFG_CFGCON1_CCL_OE_Pos                _UINT32_(20)                                         /* (CFG_CFGCON1) CCL Pads (via PPS) Output Enable Position */
#define CFG_CFGCON1_CCL_OE_Msk                (_UINT32_(0x1) << CFG_CFGCON1_CCL_OE_Pos)            /* (CFG_CFGCON1) CCL Pads (via PPS) Output Enable Mask */
#define CFG_CFGCON1_CCL_OE(value)             (CFG_CFGCON1_CCL_OE_Msk & (_UINT32_(value) << CFG_CFGCON1_CCL_OE_Pos)) /* Assigment of value for CCL_OE in the CFG_CFGCON1 register */
#define CFG_CFGCON1_I2CDSEL0_Pos              _UINT32_(21)                                         /* (CFG_CFGCON1) I2C Delay Select for SERCOM0 Position */
#define CFG_CFGCON1_I2CDSEL0_Msk              (_UINT32_(0x1) << CFG_CFGCON1_I2CDSEL0_Pos)          /* (CFG_CFGCON1) I2C Delay Select for SERCOM0 Mask */
#define CFG_CFGCON1_I2CDSEL0(value)           (CFG_CFGCON1_I2CDSEL0_Msk & (_UINT32_(value) << CFG_CFGCON1_I2CDSEL0_Pos)) /* Assigment of value for I2CDSEL0 in the CFG_CFGCON1 register */
#define CFG_CFGCON1_I2CDSEL1_Pos              _UINT32_(22)                                         /* (CFG_CFGCON1) I2C Delay Select for SERCOM1 Position */
#define CFG_CFGCON1_I2CDSEL1_Msk              (_UINT32_(0x1) << CFG_CFGCON1_I2CDSEL1_Pos)          /* (CFG_CFGCON1) I2C Delay Select for SERCOM1 Mask */
#define CFG_CFGCON1_I2CDSEL1(value)           (CFG_CFGCON1_I2CDSEL1_Msk & (_UINT32_(value) << CFG_CFGCON1_I2CDSEL1_Pos)) /* Assigment of value for I2CDSEL1 in the CFG_CFGCON1 register */
#define CFG_CFGCON1_I2CDSEL2_Pos              _UINT32_(23)                                         /* (CFG_CFGCON1) I2C Delay Select for SERCOM2 Position */
#define CFG_CFGCON1_I2CDSEL2_Msk              (_UINT32_(0x1) << CFG_CFGCON1_I2CDSEL2_Pos)          /* (CFG_CFGCON1) I2C Delay Select for SERCOM2 Mask */
#define CFG_CFGCON1_I2CDSEL2(value)           (CFG_CFGCON1_I2CDSEL2_Msk & (_UINT32_(value) << CFG_CFGCON1_I2CDSEL2_Pos)) /* Assigment of value for I2CDSEL2 in the CFG_CFGCON1 register */
#define CFG_CFGCON1_WDTPSS_Pos                _UINT32_(24)                                         /* (CFG_CFGCON1) Watchdog Timer Post-scale Select Sleep Position */
#define CFG_CFGCON1_WDTPSS_Msk                (_UINT32_(0x1F) << CFG_CFGCON1_WDTPSS_Pos)           /* (CFG_CFGCON1) Watchdog Timer Post-scale Select Sleep Mask */
#define CFG_CFGCON1_WDTPSS(value)             (CFG_CFGCON1_WDTPSS_Msk & (_UINT32_(value) << CFG_CFGCON1_WDTPSS_Pos)) /* Assigment of value for WDTPSS in the CFG_CFGCON1 register */
#define CFG_CFGCON1_QSPIDDRM_Pos              _UINT32_(29)                                         /* (CFG_CFGCON1) QSPI DDR Mode Clock Enable Position */
#define CFG_CFGCON1_QSPIDDRM_Msk              (_UINT32_(0x1) << CFG_CFGCON1_QSPIDDRM_Pos)          /* (CFG_CFGCON1) QSPI DDR Mode Clock Enable Mask */
#define CFG_CFGCON1_QSPIDDRM(value)           (CFG_CFGCON1_QSPIDDRM_Msk & (_UINT32_(value) << CFG_CFGCON1_QSPIDDRM_Pos)) /* Assigment of value for QSPIDDRM in the CFG_CFGCON1 register */
#define CFG_CFGCON1_CLKZBREF_Pos              _UINT32_(30)                                         /* (CFG_CFGCON1) External Reference Clock ZB Enable Position */
#define CFG_CFGCON1_CLKZBREF_Msk              (_UINT32_(0x1) << CFG_CFGCON1_CLKZBREF_Pos)          /* (CFG_CFGCON1) External Reference Clock ZB Enable Mask */
#define CFG_CFGCON1_CLKZBREF(value)           (CFG_CFGCON1_CLKZBREF_Msk & (_UINT32_(value) << CFG_CFGCON1_CLKZBREF_Pos)) /* Assigment of value for CLKZBREF in the CFG_CFGCON1 register */
#define CFG_CFGCON1_Msk                       _UINT32_(0x7FFFFFBB)                                 /* (CFG_CFGCON1) Register Mask  */

#define CFG_CFGCON1_SLRCTRL_Pos               _UINT32_(11)                                         /* (CFG_CFGCON1 Position) I2C Slew Rate Control for SERCOMx */
#define CFG_CFGCON1_SLRCTRL_Msk               (_UINT32_(0x7) << CFG_CFGCON1_SLRCTRL_Pos)           /* (CFG_CFGCON1 Mask) SLRCTRL */
#define CFG_CFGCON1_SLRCTRL(value)            (CFG_CFGCON1_SLRCTRL_Msk & (_UINT32_(value) << CFG_CFGCON1_SLRCTRL_Pos)) 
#define CFG_CFGCON1_I2CDSEL_Pos               _UINT32_(21)                                         /* (CFG_CFGCON1 Position) I2C Delay Select for SERCOMx */
#define CFG_CFGCON1_I2CDSEL_Msk               (_UINT32_(0x7) << CFG_CFGCON1_I2CDSEL_Pos)           /* (CFG_CFGCON1 Mask) I2CDSEL */
#define CFG_CFGCON1_I2CDSEL(value)            (CFG_CFGCON1_I2CDSEL_Msk & (_UINT32_(value) << CFG_CFGCON1_I2CDSEL_Pos)) 

/* -------- CFG_CFGCON1CLR : (CFG Offset: 0x14) (R/W 32) Bit clear register -------- */
#define CFG_CFGCON1CLR_RESETVALUE             _UINT32_(0x00)                                       /*  (CFG_CFGCON1CLR) Bit clear register  Reset Value */

#define CFG_CFGCON1CLR_Msk                    _UINT32_(0x00000000)                                 /* (CFG_CFGCON1CLR) Register Mask  */


/* -------- CFG_CFGCON1SET : (CFG Offset: 0x18) (R/W 32) Bit set register -------- */
#define CFG_CFGCON1SET_RESETVALUE             _UINT32_(0x00)                                       /*  (CFG_CFGCON1SET) Bit set register  Reset Value */

#define CFG_CFGCON1SET_Msk                    _UINT32_(0x00000000)                                 /* (CFG_CFGCON1SET) Register Mask  */


/* -------- CFG_CFGCON1INV : (CFG Offset: 0x1C) (R/W 32) Bit invert register -------- */
#define CFG_CFGCON1INV_RESETVALUE             _UINT32_(0x00)                                       /*  (CFG_CFGCON1INV) Bit invert register  Reset Value */

#define CFG_CFGCON1INV_Msk                    _UINT32_(0x00000000)                                 /* (CFG_CFGCON1INV) Register Mask  */


/* -------- CFG_CFGCON2 : (CFG Offset: 0x20) (R/W 32)  -------- */
#define CFG_CFGCON2_RESETVALUE                _UINT32_(0x7F7FFF38)                                 /*  (CFG_CFGCON2)   Reset Value */

#define CFG_CFGCON2_ACMP_CYCLE_Pos            _UINT32_(0)                                          /* (CFG_CFGCON2) AC SIB Comparator Result Wait Cycles Position */
#define CFG_CFGCON2_ACMP_CYCLE_Msk            (_UINT32_(0x7) << CFG_CFGCON2_ACMP_CYCLE_Pos)        /* (CFG_CFGCON2) AC SIB Comparator Result Wait Cycles Mask */
#define CFG_CFGCON2_ACMP_CYCLE(value)         (CFG_CFGCON2_ACMP_CYCLE_Msk & (_UINT32_(value) << CFG_CFGCON2_ACMP_CYCLE_Pos)) /* Assigment of value for ACMP_CYCLE in the CFG_CFGCON2 register */
#define CFG_CFGCON2_DMTINTV_Pos               _UINT32_(3)                                          /* (CFG_CFGCON2) Dead Man Timer Count Window Interval Position */
#define CFG_CFGCON2_DMTINTV_Msk               (_UINT32_(0x7) << CFG_CFGCON2_DMTINTV_Pos)           /* (CFG_CFGCON2) Dead Man Timer Count Window Interval Mask */
#define CFG_CFGCON2_DMTINTV(value)            (CFG_CFGCON2_DMTINTV_Msk & (_UINT32_(value) << CFG_CFGCON2_DMTINTV_Pos)) /* Assigment of value for DMTINTV in the CFG_CFGCON2 register */
#define CFG_CFGCON2_PMUTEST_VDD_EN_Pos        _UINT32_(7)                                          /* (CFG_CFGCON2) PMU Test Output or VDD/2 Enable via ADC IE12 Position */
#define CFG_CFGCON2_PMUTEST_VDD_EN_Msk        (_UINT32_(0x1) << CFG_CFGCON2_PMUTEST_VDD_EN_Pos)    /* (CFG_CFGCON2) PMU Test Output or VDD/2 Enable via ADC IE12 Mask */
#define CFG_CFGCON2_PMUTEST_VDD_EN(value)     (CFG_CFGCON2_PMUTEST_VDD_EN_Msk & (_UINT32_(value) << CFG_CFGCON2_PMUTEST_VDD_EN_Pos)) /* Assigment of value for PMUTEST_VDD_EN in the CFG_CFGCON2 register */
#define CFG_CFGCON2_POSCMOD_Pos               _UINT32_(8)                                          /* (CFG_CFGCON2) Primary Oscillator Configuration Position */
#define CFG_CFGCON2_POSCMOD_Msk               (_UINT32_(0x3) << CFG_CFGCON2_POSCMOD_Pos)           /* (CFG_CFGCON2) Primary Oscillator Configuration Mask */
#define CFG_CFGCON2_POSCMOD(value)            (CFG_CFGCON2_POSCMOD_Msk & (_UINT32_(value) << CFG_CFGCON2_POSCMOD_Pos)) /* Assigment of value for POSCMOD in the CFG_CFGCON2 register */
#define CFG_CFGCON2_WDTRMCS_Pos               _UINT32_(10)                                         /* (CFG_CFGCON2) WDT RUN Mode Clock Select Position */
#define CFG_CFGCON2_WDTRMCS_Msk               (_UINT32_(0x3) << CFG_CFGCON2_WDTRMCS_Pos)           /* (CFG_CFGCON2) WDT RUN Mode Clock Select Mask */
#define CFG_CFGCON2_WDTRMCS(value)            (CFG_CFGCON2_WDTRMCS_Msk & (_UINT32_(value) << CFG_CFGCON2_WDTRMCS_Pos)) /* Assigment of value for WDTRMCS in the CFG_CFGCON2 register */
#define CFG_CFGCON2_SOSCSEL_Pos               _UINT32_(12)                                         /* (CFG_CFGCON2) SOSC Selection Configuration Position */
#define CFG_CFGCON2_SOSCSEL_Msk               (_UINT32_(0x1) << CFG_CFGCON2_SOSCSEL_Pos)           /* (CFG_CFGCON2) SOSC Selection Configuration Mask */
#define CFG_CFGCON2_SOSCSEL(value)            (CFG_CFGCON2_SOSCSEL_Msk & (_UINT32_(value) << CFG_CFGCON2_SOSCSEL_Pos)) /* Assigment of value for SOSCSEL in the CFG_CFGCON2 register */
#define CFG_CFGCON2_WAKE2SPD_Pos              _UINT32_(13)                                         /* (CFG_CFGCON2) 2-Speed startup enabled in Sleep mode Position */
#define CFG_CFGCON2_WAKE2SPD_Msk              (_UINT32_(0x1) << CFG_CFGCON2_WAKE2SPD_Pos)          /* (CFG_CFGCON2) 2-Speed startup enabled in Sleep mode Mask */
#define CFG_CFGCON2_WAKE2SPD(value)           (CFG_CFGCON2_WAKE2SPD_Msk & (_UINT32_(value) << CFG_CFGCON2_WAKE2SPD_Pos)) /* Assigment of value for WAKE2SPD in the CFG_CFGCON2 register */
#define CFG_CFGCON2_CKSWEN_Pos                _UINT32_(14)                                         /* (CFG_CFGCON2) Software Clock Switching Enable Position */
#define CFG_CFGCON2_CKSWEN_Msk                (_UINT32_(0x1) << CFG_CFGCON2_CKSWEN_Pos)            /* (CFG_CFGCON2) Software Clock Switching Enable Mask */
#define CFG_CFGCON2_CKSWEN(value)             (CFG_CFGCON2_CKSWEN_Msk & (_UINT32_(value) << CFG_CFGCON2_CKSWEN_Pos)) /* Assigment of value for CKSWEN in the CFG_CFGCON2 register */
#define CFG_CFGCON2_FSCMEN_Pos                _UINT32_(15)                                         /* (CFG_CFGCON2) Fail-Safe Clock Monitor Enable Position */
#define CFG_CFGCON2_FSCMEN_Msk                (_UINT32_(0x1) << CFG_CFGCON2_FSCMEN_Pos)            /* (CFG_CFGCON2) Fail-Safe Clock Monitor Enable Mask */
#define CFG_CFGCON2_FSCMEN(value)             (CFG_CFGCON2_FSCMEN_Msk & (_UINT32_(value) << CFG_CFGCON2_FSCMEN_Pos)) /* Assigment of value for FSCMEN in the CFG_CFGCON2 register */
#define CFG_CFGCON2_WDTPSR_Pos                _UINT32_(16)                                         /* (CFG_CFGCON2) Watchdog Timer Post-scale Select Run Position */
#define CFG_CFGCON2_WDTPSR_Msk                (_UINT32_(0x1F) << CFG_CFGCON2_WDTPSR_Pos)           /* (CFG_CFGCON2) Watchdog Timer Post-scale Select Run Mask */
#define CFG_CFGCON2_WDTPSR(value)             (CFG_CFGCON2_WDTPSR_Msk & (_UINT32_(value) << CFG_CFGCON2_WDTPSR_Pos)) /* Assigment of value for WDTPSR in the CFG_CFGCON2 register */
#define CFG_CFGCON2_WDTSPGM_Pos               _UINT32_(21)                                         /* (CFG_CFGCON2) Watchdog Timer Stop during Flash Programming Position */
#define CFG_CFGCON2_WDTSPGM_Msk               (_UINT32_(0x1) << CFG_CFGCON2_WDTSPGM_Pos)           /* (CFG_CFGCON2) Watchdog Timer Stop during Flash Programming Mask */
#define CFG_CFGCON2_WDTSPGM(value)            (CFG_CFGCON2_WDTSPGM_Msk & (_UINT32_(value) << CFG_CFGCON2_WDTSPGM_Pos)) /* Assigment of value for WDTSPGM in the CFG_CFGCON2 register */
#define CFG_CFGCON2_WINDIS_Pos                _UINT32_(22)                                         /* (CFG_CFGCON2) Windowed Watchdog Timer Disable Position */
#define CFG_CFGCON2_WINDIS_Msk                (_UINT32_(0x1) << CFG_CFGCON2_WINDIS_Pos)            /* (CFG_CFGCON2) Windowed Watchdog Timer Disable Mask */
#define CFG_CFGCON2_WINDIS(value)             (CFG_CFGCON2_WINDIS_Msk & (_UINT32_(value) << CFG_CFGCON2_WINDIS_Pos)) /* Assigment of value for WINDIS in the CFG_CFGCON2 register */
#define CFG_CFGCON2_WDTEN_Pos                 _UINT32_(23)                                         /* (CFG_CFGCON2) Watchdog Timer Enable Position */
#define CFG_CFGCON2_WDTEN_Msk                 (_UINT32_(0x1) << CFG_CFGCON2_WDTEN_Pos)             /* (CFG_CFGCON2) Watchdog Timer Enable Mask */
#define CFG_CFGCON2_WDTEN(value)              (CFG_CFGCON2_WDTEN_Msk & (_UINT32_(value) << CFG_CFGCON2_WDTEN_Pos)) /* Assigment of value for WDTEN in the CFG_CFGCON2 register */
#define CFG_CFGCON2_WDTWINSZ_Pos              _UINT32_(24)                                         /* (CFG_CFGCON2) Watchdog Timer Window Size Position */
#define CFG_CFGCON2_WDTWINSZ_Msk              (_UINT32_(0x3) << CFG_CFGCON2_WDTWINSZ_Pos)          /* (CFG_CFGCON2) Watchdog Timer Window Size Mask */
#define CFG_CFGCON2_WDTWINSZ(value)           (CFG_CFGCON2_WDTWINSZ_Msk & (_UINT32_(value) << CFG_CFGCON2_WDTWINSZ_Pos)) /* Assigment of value for WDTWINSZ in the CFG_CFGCON2 register */
#define CFG_CFGCON2_DMTCNT_Pos                _UINT32_(26)                                         /* (CFG_CFGCON2) Dead Man Timer Count Select Position */
#define CFG_CFGCON2_DMTCNT_Msk                (_UINT32_(0x1F) << CFG_CFGCON2_DMTCNT_Pos)           /* (CFG_CFGCON2) Dead Man Timer Count Select Mask */
#define CFG_CFGCON2_DMTCNT(value)             (CFG_CFGCON2_DMTCNT_Msk & (_UINT32_(value) << CFG_CFGCON2_DMTCNT_Pos)) /* Assigment of value for DMTCNT in the CFG_CFGCON2 register */
#define CFG_CFGCON2_DMTEN_Pos                 _UINT32_(31)                                         /* (CFG_CFGCON2) Dead Man Timer Enable Position */
#define CFG_CFGCON2_DMTEN_Msk                 (_UINT32_(0x1) << CFG_CFGCON2_DMTEN_Pos)             /* (CFG_CFGCON2) Dead Man Timer Enable Mask */
#define CFG_CFGCON2_DMTEN(value)              (CFG_CFGCON2_DMTEN_Msk & (_UINT32_(value) << CFG_CFGCON2_DMTEN_Pos)) /* Assigment of value for DMTEN in the CFG_CFGCON2 register */
#define CFG_CFGCON2_Msk                       _UINT32_(0xFFFFFFBF)                                 /* (CFG_CFGCON2) Register Mask  */


/* -------- CFG_CFGCON2CLR : (CFG Offset: 0x24) (R/W 32) Bit clear register -------- */
#define CFG_CFGCON2CLR_RESETVALUE             _UINT32_(0x00)                                       /*  (CFG_CFGCON2CLR) Bit clear register  Reset Value */

#define CFG_CFGCON2CLR_Msk                    _UINT32_(0x00000000)                                 /* (CFG_CFGCON2CLR) Register Mask  */


/* -------- CFG_CFGCON2SET : (CFG Offset: 0x28) (R/W 32) Bit set register -------- */
#define CFG_CFGCON2SET_RESETVALUE             _UINT32_(0x00)                                       /*  (CFG_CFGCON2SET) Bit set register  Reset Value */

#define CFG_CFGCON2SET_Msk                    _UINT32_(0x00000000)                                 /* (CFG_CFGCON2SET) Register Mask  */


/* -------- CFG_CFGCON2INV : (CFG Offset: 0x2C) (R/W 32) Bit invert register -------- */
#define CFG_CFGCON2INV_RESETVALUE             _UINT32_(0x00)                                       /*  (CFG_CFGCON2INV) Bit invert register  Reset Value */

#define CFG_CFGCON2INV_Msk                    _UINT32_(0x00000000)                                 /* (CFG_CFGCON2INV) Register Mask  */


/* -------- CFG_CFGCON4 : (CFG Offset: 0x40) (R/W 32)  -------- */
#define CFG_CFGCON4_RESETVALUE                _UINT32_(0x840E4000)                                 /*  (CFG_CFGCON4)   Reset Value */

#define CFG_CFGCON4_SOSCCFG_Pos               _UINT32_(0)                                          /* (CFG_CFGCON4) SOSC Configuration Position */
#define CFG_CFGCON4_SOSCCFG_Msk               (_UINT32_(0xFF) << CFG_CFGCON4_SOSCCFG_Pos)          /* (CFG_CFGCON4) SOSC Configuration Mask */
#define CFG_CFGCON4_SOSCCFG(value)            (CFG_CFGCON4_SOSCCFG_Msk & (_UINT32_(value) << CFG_CFGCON4_SOSCCFG_Pos)) /* Assigment of value for SOSCCFG in the CFG_CFGCON4 register */
#define CFG_CFGCON4_RTCEVENT_SEL_Pos          _UINT32_(8)                                          /* (CFG_CFGCON4) RTC Event Selection Position */
#define CFG_CFGCON4_RTCEVENT_SEL_Msk          (_UINT32_(0x3) << CFG_CFGCON4_RTCEVENT_SEL_Pos)      /* (CFG_CFGCON4) RTC Event Selection Mask */
#define CFG_CFGCON4_RTCEVENT_SEL(value)       (CFG_CFGCON4_RTCEVENT_SEL_Msk & (_UINT32_(value) << CFG_CFGCON4_RTCEVENT_SEL_Pos)) /* Assigment of value for RTCEVENT_SEL in the CFG_CFGCON4 register */
#define CFG_CFGCON4_RTCEVENT_EN_Pos           _UINT32_(10)                                         /* (CFG_CFGCON4) Pad Output Enable for MCHP legacy RTC event output Position */
#define CFG_CFGCON4_RTCEVENT_EN_Msk           (_UINT32_(0x1) << CFG_CFGCON4_RTCEVENT_EN_Pos)       /* (CFG_CFGCON4) Pad Output Enable for MCHP legacy RTC event output Mask */
#define CFG_CFGCON4_RTCEVENT_EN(value)        (CFG_CFGCON4_RTCEVENT_EN_Msk & (_UINT32_(value) << CFG_CFGCON4_RTCEVENT_EN_Pos)) /* Assigment of value for RTCEVENT_EN in the CFG_CFGCON4 register */
#define CFG_CFGCON4_VBKP_1KCSEL_Pos           _UINT32_(11)                                         /* (CFG_CFGCON4) VDDBUKPCORE LPCLK Clock Selection Position */
#define CFG_CFGCON4_VBKP_1KCSEL_Msk           (_UINT32_(0x1) << CFG_CFGCON4_VBKP_1KCSEL_Pos)       /* (CFG_CFGCON4) VDDBUKPCORE LPCLK Clock Selection Mask */
#define CFG_CFGCON4_VBKP_1KCSEL(value)        (CFG_CFGCON4_VBKP_1KCSEL_Msk & (_UINT32_(value) << CFG_CFGCON4_VBKP_1KCSEL_Pos)) /* Assigment of value for VBKP_1KCSEL in the CFG_CFGCON4 register */
#define CFG_CFGCON4_VBKP_32KCSEL_Pos          _UINT32_(12)                                         /* (CFG_CFGCON4) VDDBUKPCORE 32KHz clock source selection Position */
#define CFG_CFGCON4_VBKP_32KCSEL_Msk          (_UINT32_(0x3) << CFG_CFGCON4_VBKP_32KCSEL_Pos)      /* (CFG_CFGCON4) VDDBUKPCORE 32KHz clock source selection Mask */
#define CFG_CFGCON4_VBKP_32KCSEL(value)       (CFG_CFGCON4_VBKP_32KCSEL_Msk & (_UINT32_(value) << CFG_CFGCON4_VBKP_32KCSEL_Pos)) /* Assigment of value for VBKP_32KCSEL in the CFG_CFGCON4 register */
#define CFG_CFGCON4_VBKP_DIVSEL_Pos           _UINT32_(14)                                         /* (CFG_CFGCON4) VDDBUKPCORE LPCLK Clock Divider Selection Position */
#define CFG_CFGCON4_VBKP_DIVSEL_Msk           (_UINT32_(0x1) << CFG_CFGCON4_VBKP_DIVSEL_Pos)       /* (CFG_CFGCON4) VDDBUKPCORE LPCLK Clock Divider Selection Mask */
#define CFG_CFGCON4_VBKP_DIVSEL(value)        (CFG_CFGCON4_VBKP_DIVSEL_Msk & (_UINT32_(value) << CFG_CFGCON4_VBKP_DIVSEL_Pos)) /* Assigment of value for VBKP_DIVSEL in the CFG_CFGCON4 register */
#define CFG_CFGCON4_LPCLK_MOD_Pos             _UINT32_(15)                                         /* (CFG_CFGCON4) LPCLK modifier in counter/delay mode Position */
#define CFG_CFGCON4_LPCLK_MOD_Msk             (_UINT32_(0x1) << CFG_CFGCON4_LPCLK_MOD_Pos)         /* (CFG_CFGCON4) LPCLK modifier in counter/delay mode Mask */
#define CFG_CFGCON4_LPCLK_MOD(value)          (CFG_CFGCON4_LPCLK_MOD_Msk & (_UINT32_(value) << CFG_CFGCON4_LPCLK_MOD_Pos)) /* Assigment of value for LPCLK_MOD in the CFG_CFGCON4 register */
#define CFG_CFGCON4_RTCEFTYPE_Pos             _UINT32_(16)                                         /* (CFG_CFGCON4) RTC Event Type Position */
#define CFG_CFGCON4_RTCEFTYPE_Msk             (_UINT32_(0x1) << CFG_CFGCON4_RTCEFTYPE_Pos)         /* (CFG_CFGCON4) RTC Event Type Mask */
#define CFG_CFGCON4_RTCEFTYPE(value)          (CFG_CFGCON4_RTCEFTYPE_Msk & (_UINT32_(value) << CFG_CFGCON4_RTCEFTYPE_Pos)) /* Assigment of value for RTCEFTYPE in the CFG_CFGCON4 register */
#define CFG_CFGCON4_CPEN_DLY_Pos              _UINT32_(17)                                         /* (CFG_CFGCON4) Charge-pump ready digital delay Position */
#define CFG_CFGCON4_CPEN_DLY_Msk              (_UINT32_(0x7) << CFG_CFGCON4_CPEN_DLY_Pos)          /* (CFG_CFGCON4) Charge-pump ready digital delay Mask */
#define CFG_CFGCON4_CPEN_DLY(value)           (CFG_CFGCON4_CPEN_DLY_Msk & (_UINT32_(value) << CFG_CFGCON4_CPEN_DLY_Pos)) /* Assigment of value for CPEN_DLY in the CFG_CFGCON4 register */
#define CFG_CFGCON4_DSZPBOREN_Pos             _UINT32_(20)                                         /* (CFG_CFGCON4) Deep Sleep Zero-Power BOR Enable Position */
#define CFG_CFGCON4_DSZPBOREN_Msk             (_UINT32_(0x1) << CFG_CFGCON4_DSZPBOREN_Pos)         /* (CFG_CFGCON4) Deep Sleep Zero-Power BOR Enable Mask */
#define CFG_CFGCON4_DSZPBOREN(value)          (CFG_CFGCON4_DSZPBOREN_Msk & (_UINT32_(value) << CFG_CFGCON4_DSZPBOREN_Pos)) /* Assigment of value for DSZPBOREN in the CFG_CFGCON4 register */
#define CFG_CFGCON4_DSWDTPS_Pos               _UINT32_(21)                                         /* (CFG_CFGCON4) Deep Sleep Watchdog Timer Postscale Select Position */
#define CFG_CFGCON4_DSWDTPS_Msk               (_UINT32_(0x1F) << CFG_CFGCON4_DSWDTPS_Pos)          /* (CFG_CFGCON4) Deep Sleep Watchdog Timer Postscale Select Mask */
#define CFG_CFGCON4_DSWDTPS(value)            (CFG_CFGCON4_DSWDTPS_Msk & (_UINT32_(value) << CFG_CFGCON4_DSWDTPS_Pos)) /* Assigment of value for DSWDTPS in the CFG_CFGCON4 register */
#define CFG_CFGCON4_DSWDTOSC_Pos              _UINT32_(26)                                         /* (CFG_CFGCON4) Deep Sleep Watchdog Timer Reference Clock Select Position */
#define CFG_CFGCON4_DSWDTOSC_Msk              (_UINT32_(0x1) << CFG_CFGCON4_DSWDTOSC_Pos)          /* (CFG_CFGCON4) Deep Sleep Watchdog Timer Reference Clock Select Mask */
#define CFG_CFGCON4_DSWDTOSC(value)           (CFG_CFGCON4_DSWDTOSC_Msk & (_UINT32_(value) << CFG_CFGCON4_DSWDTOSC_Pos)) /* Assigment of value for DSWDTOSC in the CFG_CFGCON4 register */
#define CFG_CFGCON4_DSWDTEN_Pos               _UINT32_(27)                                         /* (CFG_CFGCON4) Deep Sleep Watchdog Timer Enable Position */
#define CFG_CFGCON4_DSWDTEN_Msk               (_UINT32_(0x1) << CFG_CFGCON4_DSWDTEN_Pos)           /* (CFG_CFGCON4) Deep Sleep Watchdog Timer Enable Mask */
#define CFG_CFGCON4_DSWDTEN(value)            (CFG_CFGCON4_DSWDTEN_Msk & (_UINT32_(value) << CFG_CFGCON4_DSWDTEN_Pos)) /* Assigment of value for DSWDTEN in the CFG_CFGCON4 register */
#define CFG_CFGCON4_DSEN_Pos                  _UINT32_(28)                                         /* (CFG_CFGCON4) Deep Sleep Bit Enable Position */
#define CFG_CFGCON4_DSEN_Msk                  (_UINT32_(0x1) << CFG_CFGCON4_DSEN_Pos)              /* (CFG_CFGCON4) Deep Sleep Bit Enable Mask */
#define CFG_CFGCON4_DSEN(value)               (CFG_CFGCON4_DSEN_Msk & (_UINT32_(value) << CFG_CFGCON4_DSEN_Pos)) /* Assigment of value for DSEN in the CFG_CFGCON4 register */
#define CFG_CFGCON4_UVREGROVR_Pos             _UINT32_(29)                                         /* (CFG_CFGCON4) ULPVREG Retention Mode Override Position */
#define CFG_CFGCON4_UVREGROVR_Msk             (_UINT32_(0x1) << CFG_CFGCON4_UVREGROVR_Pos)         /* (CFG_CFGCON4) ULPVREG Retention Mode Override Mask */
#define CFG_CFGCON4_UVREGROVR(value)          (CFG_CFGCON4_UVREGROVR_Msk & (_UINT32_(value) << CFG_CFGCON4_UVREGROVR_Pos)) /* Assigment of value for UVREGROVR in the CFG_CFGCON4 register */
#define CFG_CFGCON4_RTCNTM_CSEL_Pos           _UINT32_(31)                                         /* (CFG_CFGCON4) RTC Counter Mode Clock Select Position */
#define CFG_CFGCON4_RTCNTM_CSEL_Msk           (_UINT32_(0x1) << CFG_CFGCON4_RTCNTM_CSEL_Pos)       /* (CFG_CFGCON4) RTC Counter Mode Clock Select Mask */
#define CFG_CFGCON4_RTCNTM_CSEL(value)        (CFG_CFGCON4_RTCNTM_CSEL_Msk & (_UINT32_(value) << CFG_CFGCON4_RTCNTM_CSEL_Pos)) /* Assigment of value for RTCNTM_CSEL in the CFG_CFGCON4 register */
#define CFG_CFGCON4_Msk                       _UINT32_(0xBFFFFFFF)                                 /* (CFG_CFGCON4) Register Mask  */


/* -------- CFG_CFGCON4CLR : (CFG Offset: 0x44) (R/W 32) Bit clear register -------- */
#define CFG_CFGCON4CLR_RESETVALUE             _UINT32_(0x00)                                       /*  (CFG_CFGCON4CLR) Bit clear register  Reset Value */

#define CFG_CFGCON4CLR_Msk                    _UINT32_(0x00000000)                                 /* (CFG_CFGCON4CLR) Register Mask  */


/* -------- CFG_CFGCON4SET : (CFG Offset: 0x48) (R/W 32) Bit set register -------- */
#define CFG_CFGCON4SET_RESETVALUE             _UINT32_(0x00)                                       /*  (CFG_CFGCON4SET) Bit set register  Reset Value */

#define CFG_CFGCON4SET_Msk                    _UINT32_(0x00000000)                                 /* (CFG_CFGCON4SET) Register Mask  */


/* -------- CFG_CFGCON4INV : (CFG Offset: 0x4C) (R/W 32) Bit invert register -------- */
#define CFG_CFGCON4INV_RESETVALUE             _UINT32_(0x00)                                       /*  (CFG_CFGCON4INV) Bit invert register  Reset Value */

#define CFG_CFGCON4INV_Msk                    _UINT32_(0x00000000)                                 /* (CFG_CFGCON4INV) Register Mask  */


/* -------- CFG_CFGPGQOS : (CFG Offset: 0x50) (R/W 32)  -------- */
#define CFG_CFGPGQOS_RESETVALUE               _UINT32_(0xE040004C)                                 /*  (CFG_CFGPGQOS)   Reset Value */

#define CFG_CFGPGQOS_CPUPG_Pos                _UINT32_(0)                                          /* (CFG_CFGPGQOS) CPU (Code) Permission Group Position */
#define CFG_CFGPGQOS_CPUPG_Msk                (_UINT32_(0x3) << CFG_CFGPGQOS_CPUPG_Pos)            /* (CFG_CFGPGQOS) CPU (Code) Permission Group Mask */
#define CFG_CFGPGQOS_CPUPG(value)             (CFG_CFGPGQOS_CPUPG_Msk & (_UINT32_(value) << CFG_CFGPGQOS_CPUPG_Pos)) /* Assigment of value for CPUPG in the CFG_CFGPGQOS register */
#define CFG_CFGPGQOS_CPUQOS_Pos               _UINT32_(2)                                          /* (CFG_CFGPGQOS) CPU I/D and System Bus QOS Control Position */
#define CFG_CFGPGQOS_CPUQOS_Msk               (_UINT32_(0x3) << CFG_CFGPGQOS_CPUQOS_Pos)           /* (CFG_CFGPGQOS) CPU I/D and System Bus QOS Control Mask */
#define CFG_CFGPGQOS_CPUQOS(value)            (CFG_CFGPGQOS_CPUQOS_Msk & (_UINT32_(value) << CFG_CFGPGQOS_CPUQOS_Pos)) /* Assigment of value for CPUQOS in the CFG_CFGPGQOS register */
#define CFG_CFGPGQOS_ICDJPG_Pos               _UINT32_(4)                                          /* (CFG_CFGPGQOS) ICD-JTAG Permission Group Position */
#define CFG_CFGPGQOS_ICDJPG_Msk               (_UINT32_(0x3) << CFG_CFGPGQOS_ICDJPG_Pos)           /* (CFG_CFGPGQOS) ICD-JTAG Permission Group Mask */
#define CFG_CFGPGQOS_ICDJPG(value)            (CFG_CFGPGQOS_ICDJPG_Msk & (_UINT32_(value) << CFG_CFGPGQOS_ICDJPG_Pos)) /* Assigment of value for ICDJPG in the CFG_CFGPGQOS register */
#define CFG_CFGPGQOS_ICDJQOS_Pos              _UINT32_(6)                                          /* (CFG_CFGPGQOS) ICD-JTAG Bus QOS Control Position */
#define CFG_CFGPGQOS_ICDJQOS_Msk              (_UINT32_(0x3) << CFG_CFGPGQOS_ICDJQOS_Pos)          /* (CFG_CFGPGQOS) ICD-JTAG Bus QOS Control Mask */
#define CFG_CFGPGQOS_ICDJQOS(value)           (CFG_CFGPGQOS_ICDJQOS_Msk & (_UINT32_(value) << CFG_CFGPGQOS_ICDJQOS_Pos)) /* Assigment of value for ICDJQOS in the CFG_CFGPGQOS register */
#define CFG_CFGPGQOS_DMAPG_Pos                _UINT32_(8)                                          /* (CFG_CFGPGQOS) DMA (Rd/Wr) Permission Group Position */
#define CFG_CFGPGQOS_DMAPG_Msk                (_UINT32_(0x3) << CFG_CFGPGQOS_DMAPG_Pos)            /* (CFG_CFGPGQOS) DMA (Rd/Wr) Permission Group Mask */
#define CFG_CFGPGQOS_DMAPG(value)             (CFG_CFGPGQOS_DMAPG_Msk & (_UINT32_(value) << CFG_CFGPGQOS_DMAPG_Pos)) /* Assigment of value for DMAPG in the CFG_CFGPGQOS register */
#define CFG_CFGPGQOS_ADCPG_Pos                _UINT32_(16)                                         /* (CFG_CFGPGQOS) ADC Controller Permission Group Position */
#define CFG_CFGPGQOS_ADCPG_Msk                (_UINT32_(0x3) << CFG_CFGPGQOS_ADCPG_Pos)            /* (CFG_CFGPGQOS) ADC Controller Permission Group Mask */
#define CFG_CFGPGQOS_ADCPG(value)             (CFG_CFGPGQOS_ADCPG_Msk & (_UINT32_(value) << CFG_CFGPGQOS_ADCPG_Pos)) /* Assigment of value for ADCPG in the CFG_CFGPGQOS register */
#define CFG_CFGPGQOS_ADCQOS_Pos               _UINT32_(18)                                         /* (CFG_CFGPGQOS) ADC Controller QOS Control Position */
#define CFG_CFGPGQOS_ADCQOS_Msk               (_UINT32_(0x3) << CFG_CFGPGQOS_ADCQOS_Pos)           /* (CFG_CFGPGQOS) ADC Controller QOS Control Mask */
#define CFG_CFGPGQOS_ADCQOS(value)            (CFG_CFGPGQOS_ADCQOS_Msk & (_UINT32_(value) << CFG_CFGPGQOS_ADCQOS_Pos)) /* Assigment of value for ADCQOS in the CFG_CFGPGQOS register */
#define CFG_CFGPGQOS_ICMPG_Pos                _UINT32_(20)                                         /* (CFG_CFGPGQOS) ICM Permission Group Position */
#define CFG_CFGPGQOS_ICMPG_Msk                (_UINT32_(0x3) << CFG_CFGPGQOS_ICMPG_Pos)            /* (CFG_CFGPGQOS) ICM Permission Group Mask */
#define CFG_CFGPGQOS_ICMPG(value)             (CFG_CFGPGQOS_ICMPG_Msk & (_UINT32_(value) << CFG_CFGPGQOS_ICMPG_Pos)) /* Assigment of value for ICMPG in the CFG_CFGPGQOS register */
#define CFG_CFGPGQOS_ICMQOS_Pos               _UINT32_(22)                                         /* (CFG_CFGPGQOS) ICM QOS Control Position */
#define CFG_CFGPGQOS_ICMQOS_Msk               (_UINT32_(0x3) << CFG_CFGPGQOS_ICMQOS_Pos)           /* (CFG_CFGPGQOS) ICM QOS Control Mask */
#define CFG_CFGPGQOS_ICMQOS(value)            (CFG_CFGPGQOS_ICMQOS_Msk & (_UINT32_(value) << CFG_CFGPGQOS_ICMQOS_Pos)) /* Assigment of value for ICMQOS in the CFG_CFGPGQOS register */
#define CFG_CFGPGQOS_DSUPG_Pos                _UINT32_(24)                                         /* (CFG_CFGPGQOS) DSU Permission Group Position */
#define CFG_CFGPGQOS_DSUPG_Msk                (_UINT32_(0x3) << CFG_CFGPGQOS_DSUPG_Pos)            /* (CFG_CFGPGQOS) DSU Permission Group Mask */
#define CFG_CFGPGQOS_DSUPG(value)             (CFG_CFGPGQOS_DSUPG_Msk & (_UINT32_(value) << CFG_CFGPGQOS_DSUPG_Pos)) /* Assigment of value for DSUPG in the CFG_CFGPGQOS register */
#define CFG_CFGPGQOS_FCQOS_Pos                _UINT32_(28)                                         /* (CFG_CFGPGQOS) FC Controller QOS Control Position */
#define CFG_CFGPGQOS_FCQOS_Msk                (_UINT32_(0x3) << CFG_CFGPGQOS_FCQOS_Pos)            /* (CFG_CFGPGQOS) FC Controller QOS Control Mask */
#define CFG_CFGPGQOS_FCQOS(value)             (CFG_CFGPGQOS_FCQOS_Msk & (_UINT32_(value) << CFG_CFGPGQOS_FCQOS_Pos)) /* Assigment of value for FCQOS in the CFG_CFGPGQOS register */
#define CFG_CFGPGQOS_WISIBQOS_Pos             _UINT32_(30)                                         /* (CFG_CFGPGQOS) Wireless SIB QOS Control Position */
#define CFG_CFGPGQOS_WISIBQOS_Msk             (_UINT32_(0x3) << CFG_CFGPGQOS_WISIBQOS_Pos)         /* (CFG_CFGPGQOS) Wireless SIB QOS Control Mask */
#define CFG_CFGPGQOS_WISIBQOS(value)          (CFG_CFGPGQOS_WISIBQOS_Msk & (_UINT32_(value) << CFG_CFGPGQOS_WISIBQOS_Pos)) /* Assigment of value for WISIBQOS in the CFG_CFGPGQOS register */
#define CFG_CFGPGQOS_Msk                      _UINT32_(0xF3FF03FF)                                 /* (CFG_CFGPGQOS) Register Mask  */


/* -------- CFG_CFGPGQOSCLR : (CFG Offset: 0x54) (R/W 32) Bit clear register -------- */
#define CFG_CFGPGQOSCLR_RESETVALUE            _UINT32_(0x00)                                       /*  (CFG_CFGPGQOSCLR) Bit clear register  Reset Value */

#define CFG_CFGPGQOSCLR_Msk                   _UINT32_(0x00000000)                                 /* (CFG_CFGPGQOSCLR) Register Mask  */


/* -------- CFG_CFGPGQOSSET : (CFG Offset: 0x58) (R/W 32) Bit set register -------- */
#define CFG_CFGPGQOSSET_RESETVALUE            _UINT32_(0x00)                                       /*  (CFG_CFGPGQOSSET) Bit set register  Reset Value */

#define CFG_CFGPGQOSSET_Msk                   _UINT32_(0x00000000)                                 /* (CFG_CFGPGQOSSET) Register Mask  */


/* -------- CFG_CFGPGQOSINV : (CFG Offset: 0x5C) (R/W 32) Bit invert register -------- */
#define CFG_CFGPGQOSINV_RESETVALUE            _UINT32_(0x00)                                       /*  (CFG_CFGPGQOSINV) Bit invert register  Reset Value */

#define CFG_CFGPGQOSINV_Msk                   _UINT32_(0x00000000)                                 /* (CFG_CFGPGQOSINV) Register Mask  */


/* -------- CFG_CFGPCLKGEN1 : (CFG Offset: 0x60) (R/W 32)  -------- */
#define CFG_CFGPCLKGEN1_RESETVALUE            _UINT32_(0x00)                                       /*  (CFG_CFGPCLKGEN1)   Reset Value */

#define CFG_CFGPCLKGEN1_EICCSEL_Pos           _UINT32_(0)                                          /* (CFG_CFGPCLKGEN1) EIC Clock Selection Position */
#define CFG_CFGPCLKGEN1_EICCSEL_Msk           (_UINT32_(0x7) << CFG_CFGPCLKGEN1_EICCSEL_Pos)       /* (CFG_CFGPCLKGEN1) EIC Clock Selection Mask */
#define CFG_CFGPCLKGEN1_EICCSEL(value)        (CFG_CFGPCLKGEN1_EICCSEL_Msk & (_UINT32_(value) << CFG_CFGPCLKGEN1_EICCSEL_Pos)) /* Assigment of value for EICCSEL in the CFG_CFGPCLKGEN1 register */
#define   CFG_CFGPCLKGEN1_EICCSEL_NO_CLK_Val  _UINT32_(0x0)                                        /* (CFG_CFGPCLKGEN1) No Clock  */
#define   CFG_CFGPCLKGEN1_EICCSEL_REFO1_Val   _UINT32_(0x1)                                        /* (CFG_CFGPCLKGEN1) Reference Clock 1  */
#define   CFG_CFGPCLKGEN1_EICCSEL_REFO2_Val   _UINT32_(0x2)                                        /* (CFG_CFGPCLKGEN1) Reference Clock 2  */
#define   CFG_CFGPCLKGEN1_EICCSEL_REFO3_Val   _UINT32_(0x3)                                        /* (CFG_CFGPCLKGEN1) Reference Clock 3  */
#define   CFG_CFGPCLKGEN1_EICCSEL_REFO4_Val   _UINT32_(0x4)                                        /* (CFG_CFGPCLKGEN1) Reference Clock 4  */
#define   CFG_CFGPCLKGEN1_EICCSEL_REFO5_Val   _UINT32_(0x5)                                        /* (CFG_CFGPCLKGEN1) Reference Clock 5  */
#define   CFG_CFGPCLKGEN1_EICCSEL_REFO6_Val   _UINT32_(0x6)                                        /* (CFG_CFGPCLKGEN1) Reference Clock 6  */
#define   CFG_CFGPCLKGEN1_EICCSEL_LPCLK_Val   _UINT32_(0x7)                                        /* (CFG_CFGPCLKGEN1) 32 KHz Low Power Clock  */
#define CFG_CFGPCLKGEN1_EICCSEL_NO_CLK        (CFG_CFGPCLKGEN1_EICCSEL_NO_CLK_Val << CFG_CFGPCLKGEN1_EICCSEL_Pos) /* (CFG_CFGPCLKGEN1) No Clock Position  */
#define CFG_CFGPCLKGEN1_EICCSEL_REFO1         (CFG_CFGPCLKGEN1_EICCSEL_REFO1_Val << CFG_CFGPCLKGEN1_EICCSEL_Pos) /* (CFG_CFGPCLKGEN1) Reference Clock 1 Position  */
#define CFG_CFGPCLKGEN1_EICCSEL_REFO2         (CFG_CFGPCLKGEN1_EICCSEL_REFO2_Val << CFG_CFGPCLKGEN1_EICCSEL_Pos) /* (CFG_CFGPCLKGEN1) Reference Clock 2 Position  */
#define CFG_CFGPCLKGEN1_EICCSEL_REFO3         (CFG_CFGPCLKGEN1_EICCSEL_REFO3_Val << CFG_CFGPCLKGEN1_EICCSEL_Pos) /* (CFG_CFGPCLKGEN1) Reference Clock 3 Position  */
#define CFG_CFGPCLKGEN1_EICCSEL_REFO4         (CFG_CFGPCLKGEN1_EICCSEL_REFO4_Val << CFG_CFGPCLKGEN1_EICCSEL_Pos) /* (CFG_CFGPCLKGEN1) Reference Clock 4 Position  */
#define CFG_CFGPCLKGEN1_EICCSEL_REFO5         (CFG_CFGPCLKGEN1_EICCSEL_REFO5_Val << CFG_CFGPCLKGEN1_EICCSEL_Pos) /* (CFG_CFGPCLKGEN1) Reference Clock 5 Position  */
#define CFG_CFGPCLKGEN1_EICCSEL_REFO6         (CFG_CFGPCLKGEN1_EICCSEL_REFO6_Val << CFG_CFGPCLKGEN1_EICCSEL_Pos) /* (CFG_CFGPCLKGEN1) Reference Clock 6 Position  */
#define CFG_CFGPCLKGEN1_EICCSEL_LPCLK         (CFG_CFGPCLKGEN1_EICCSEL_LPCLK_Val << CFG_CFGPCLKGEN1_EICCSEL_Pos) /* (CFG_CFGPCLKGEN1) 32 KHz Low Power Clock Position  */
#define CFG_CFGPCLKGEN1_EICCD_Pos             _UINT32_(3)                                          /* (CFG_CFGPCLKGEN1) EIC Clock Disable Position */
#define CFG_CFGPCLKGEN1_EICCD_Msk             (_UINT32_(0x1) << CFG_CFGPCLKGEN1_EICCD_Pos)         /* (CFG_CFGPCLKGEN1) EIC Clock Disable Mask */
#define CFG_CFGPCLKGEN1_EICCD(value)          (CFG_CFGPCLKGEN1_EICCD_Msk & (_UINT32_(value) << CFG_CFGPCLKGEN1_EICCD_Pos)) /* Assigment of value for EICCD in the CFG_CFGPCLKGEN1 register */
#define   CFG_CFGPCLKGEN1_EICCD_ON_Val        _UINT32_(0x1)                                        /* (CFG_CFGPCLKGEN1) Enable PGCLK  */
#define   CFG_CFGPCLKGEN1_EICCD_OFF_Val       _UINT32_(0x0)                                        /* (CFG_CFGPCLKGEN1) Disable PGCLK  */
#define CFG_CFGPCLKGEN1_EICCD_ON              (CFG_CFGPCLKGEN1_EICCD_ON_Val << CFG_CFGPCLKGEN1_EICCD_Pos) /* (CFG_CFGPCLKGEN1) Enable PGCLK Position  */
#define CFG_CFGPCLKGEN1_EICCD_OFF             (CFG_CFGPCLKGEN1_EICCD_OFF_Val << CFG_CFGPCLKGEN1_EICCD_Pos) /* (CFG_CFGPCLKGEN1) Disable PGCLK Position  */
#define CFG_CFGPCLKGEN1_FREQMRCSEL_Pos        _UINT32_(4)                                          /* (CFG_CFGPCLKGEN1) FREQMRC Clock Selection Position */
#define CFG_CFGPCLKGEN1_FREQMRCSEL_Msk        (_UINT32_(0x7) << CFG_CFGPCLKGEN1_FREQMRCSEL_Pos)    /* (CFG_CFGPCLKGEN1) FREQMRC Clock Selection Mask */
#define CFG_CFGPCLKGEN1_FREQMRCSEL(value)     (CFG_CFGPCLKGEN1_FREQMRCSEL_Msk & (_UINT32_(value) << CFG_CFGPCLKGEN1_FREQMRCSEL_Pos)) /* Assigment of value for FREQMRCSEL in the CFG_CFGPCLKGEN1 register */
#define   CFG_CFGPCLKGEN1_FREQMRCSEL_NO_CLK_Val _UINT32_(0x0)                                        /* (CFG_CFGPCLKGEN1) No Clock  */
#define   CFG_CFGPCLKGEN1_FREQMRCSEL_REFO1_Val _UINT32_(0x1)                                        /* (CFG_CFGPCLKGEN1) Reference Clock 1  */
#define   CFG_CFGPCLKGEN1_FREQMRCSEL_REFO2_Val _UINT32_(0x2)                                        /* (CFG_CFGPCLKGEN1) Reference Clock 2  */
#define   CFG_CFGPCLKGEN1_FREQMRCSEL_REFO3_Val _UINT32_(0x3)                                        /* (CFG_CFGPCLKGEN1) Reference Clock 3  */
#define   CFG_CFGPCLKGEN1_FREQMRCSEL_REFO4_Val _UINT32_(0x4)                                        /* (CFG_CFGPCLKGEN1) Reference Clock 4  */
#define   CFG_CFGPCLKGEN1_FREQMRCSEL_REFO5_Val _UINT32_(0x5)                                        /* (CFG_CFGPCLKGEN1) Reference Clock 5  */
#define   CFG_CFGPCLKGEN1_FREQMRCSEL_REFO6_Val _UINT32_(0x6)                                        /* (CFG_CFGPCLKGEN1) Reference Clock 6  */
#define   CFG_CFGPCLKGEN1_FREQMRCSEL_LPCLK_Val _UINT32_(0x7)                                        /* (CFG_CFGPCLKGEN1) 32 KHz Low Power Clock  */
#define CFG_CFGPCLKGEN1_FREQMRCSEL_NO_CLK     (CFG_CFGPCLKGEN1_FREQMRCSEL_NO_CLK_Val << CFG_CFGPCLKGEN1_FREQMRCSEL_Pos) /* (CFG_CFGPCLKGEN1) No Clock Position  */
#define CFG_CFGPCLKGEN1_FREQMRCSEL_REFO1      (CFG_CFGPCLKGEN1_FREQMRCSEL_REFO1_Val << CFG_CFGPCLKGEN1_FREQMRCSEL_Pos) /* (CFG_CFGPCLKGEN1) Reference Clock 1 Position  */
#define CFG_CFGPCLKGEN1_FREQMRCSEL_REFO2      (CFG_CFGPCLKGEN1_FREQMRCSEL_REFO2_Val << CFG_CFGPCLKGEN1_FREQMRCSEL_Pos) /* (CFG_CFGPCLKGEN1) Reference Clock 2 Position  */
#define CFG_CFGPCLKGEN1_FREQMRCSEL_REFO3      (CFG_CFGPCLKGEN1_FREQMRCSEL_REFO3_Val << CFG_CFGPCLKGEN1_FREQMRCSEL_Pos) /* (CFG_CFGPCLKGEN1) Reference Clock 3 Position  */
#define CFG_CFGPCLKGEN1_FREQMRCSEL_REFO4      (CFG_CFGPCLKGEN1_FREQMRCSEL_REFO4_Val << CFG_CFGPCLKGEN1_FREQMRCSEL_Pos) /* (CFG_CFGPCLKGEN1) Reference Clock 4 Position  */
#define CFG_CFGPCLKGEN1_FREQMRCSEL_REFO5      (CFG_CFGPCLKGEN1_FREQMRCSEL_REFO5_Val << CFG_CFGPCLKGEN1_FREQMRCSEL_Pos) /* (CFG_CFGPCLKGEN1) Reference Clock 5 Position  */
#define CFG_CFGPCLKGEN1_FREQMRCSEL_REFO6      (CFG_CFGPCLKGEN1_FREQMRCSEL_REFO6_Val << CFG_CFGPCLKGEN1_FREQMRCSEL_Pos) /* (CFG_CFGPCLKGEN1) Reference Clock 6 Position  */
#define CFG_CFGPCLKGEN1_FREQMRCSEL_LPCLK      (CFG_CFGPCLKGEN1_FREQMRCSEL_LPCLK_Val << CFG_CFGPCLKGEN1_FREQMRCSEL_Pos) /* (CFG_CFGPCLKGEN1) 32 KHz Low Power Clock Position  */
#define CFG_CFGPCLKGEN1_RCD_Pos               _UINT32_(7)                                          /* (CFG_CFGPCLKGEN1) FREQMRC Clock Disable Position */
#define CFG_CFGPCLKGEN1_RCD_Msk               (_UINT32_(0x1) << CFG_CFGPCLKGEN1_RCD_Pos)           /* (CFG_CFGPCLKGEN1) FREQMRC Clock Disable Mask */
#define CFG_CFGPCLKGEN1_RCD(value)            (CFG_CFGPCLKGEN1_RCD_Msk & (_UINT32_(value) << CFG_CFGPCLKGEN1_RCD_Pos)) /* Assigment of value for RCD in the CFG_CFGPCLKGEN1 register */
#define   CFG_CFGPCLKGEN1_RCD_ON_Val          _UINT32_(0x1)                                        /* (CFG_CFGPCLKGEN1) Enable PGCLK  */
#define   CFG_CFGPCLKGEN1_RCD_OFF_Val         _UINT32_(0x0)                                        /* (CFG_CFGPCLKGEN1) Disable PGCLK  */
#define CFG_CFGPCLKGEN1_RCD_ON                (CFG_CFGPCLKGEN1_RCD_ON_Val << CFG_CFGPCLKGEN1_RCD_Pos) /* (CFG_CFGPCLKGEN1) Enable PGCLK Position  */
#define CFG_CFGPCLKGEN1_RCD_OFF               (CFG_CFGPCLKGEN1_RCD_OFF_Val << CFG_CFGPCLKGEN1_RCD_Pos) /* (CFG_CFGPCLKGEN1) Disable PGCLK Position  */
#define CFG_CFGPCLKGEN1_FREQMMCSEL_Pos        _UINT32_(8)                                          /* (CFG_CFGPCLKGEN1) FREQMMC Clock Selection Position */
#define CFG_CFGPCLKGEN1_FREQMMCSEL_Msk        (_UINT32_(0x7) << CFG_CFGPCLKGEN1_FREQMMCSEL_Pos)    /* (CFG_CFGPCLKGEN1) FREQMMC Clock Selection Mask */
#define CFG_CFGPCLKGEN1_FREQMMCSEL(value)     (CFG_CFGPCLKGEN1_FREQMMCSEL_Msk & (_UINT32_(value) << CFG_CFGPCLKGEN1_FREQMMCSEL_Pos)) /* Assigment of value for FREQMMCSEL in the CFG_CFGPCLKGEN1 register */
#define   CFG_CFGPCLKGEN1_FREQMMCSEL_NO_CLK_Val _UINT32_(0x0)                                        /* (CFG_CFGPCLKGEN1) No Clock  */
#define   CFG_CFGPCLKGEN1_FREQMMCSEL_REFO1_Val _UINT32_(0x1)                                        /* (CFG_CFGPCLKGEN1) Reference Clock 1  */
#define   CFG_CFGPCLKGEN1_FREQMMCSEL_REFO2_Val _UINT32_(0x2)                                        /* (CFG_CFGPCLKGEN1) Reference Clock 2  */
#define   CFG_CFGPCLKGEN1_FREQMMCSEL_REFO3_Val _UINT32_(0x3)                                        /* (CFG_CFGPCLKGEN1) Reference Clock 3  */
#define   CFG_CFGPCLKGEN1_FREQMMCSEL_REFO4_Val _UINT32_(0x4)                                        /* (CFG_CFGPCLKGEN1) Reference Clock 4  */
#define   CFG_CFGPCLKGEN1_FREQMMCSEL_REFO5_Val _UINT32_(0x5)                                        /* (CFG_CFGPCLKGEN1) Reference Clock 5  */
#define   CFG_CFGPCLKGEN1_FREQMMCSEL_REFO6_Val _UINT32_(0x6)                                        /* (CFG_CFGPCLKGEN1) Reference Clock 6  */
#define   CFG_CFGPCLKGEN1_FREQMMCSEL_LPCLK_Val _UINT32_(0x7)                                        /* (CFG_CFGPCLKGEN1) 32 KHz Low Power Clock  */
#define CFG_CFGPCLKGEN1_FREQMMCSEL_NO_CLK     (CFG_CFGPCLKGEN1_FREQMMCSEL_NO_CLK_Val << CFG_CFGPCLKGEN1_FREQMMCSEL_Pos) /* (CFG_CFGPCLKGEN1) No Clock Position  */
#define CFG_CFGPCLKGEN1_FREQMMCSEL_REFO1      (CFG_CFGPCLKGEN1_FREQMMCSEL_REFO1_Val << CFG_CFGPCLKGEN1_FREQMMCSEL_Pos) /* (CFG_CFGPCLKGEN1) Reference Clock 1 Position  */
#define CFG_CFGPCLKGEN1_FREQMMCSEL_REFO2      (CFG_CFGPCLKGEN1_FREQMMCSEL_REFO2_Val << CFG_CFGPCLKGEN1_FREQMMCSEL_Pos) /* (CFG_CFGPCLKGEN1) Reference Clock 2 Position  */
#define CFG_CFGPCLKGEN1_FREQMMCSEL_REFO3      (CFG_CFGPCLKGEN1_FREQMMCSEL_REFO3_Val << CFG_CFGPCLKGEN1_FREQMMCSEL_Pos) /* (CFG_CFGPCLKGEN1) Reference Clock 3 Position  */
#define CFG_CFGPCLKGEN1_FREQMMCSEL_REFO4      (CFG_CFGPCLKGEN1_FREQMMCSEL_REFO4_Val << CFG_CFGPCLKGEN1_FREQMMCSEL_Pos) /* (CFG_CFGPCLKGEN1) Reference Clock 4 Position  */
#define CFG_CFGPCLKGEN1_FREQMMCSEL_REFO5      (CFG_CFGPCLKGEN1_FREQMMCSEL_REFO5_Val << CFG_CFGPCLKGEN1_FREQMMCSEL_Pos) /* (CFG_CFGPCLKGEN1) Reference Clock 5 Position  */
#define CFG_CFGPCLKGEN1_FREQMMCSEL_REFO6      (CFG_CFGPCLKGEN1_FREQMMCSEL_REFO6_Val << CFG_CFGPCLKGEN1_FREQMMCSEL_Pos) /* (CFG_CFGPCLKGEN1) Reference Clock 6 Position  */
#define CFG_CFGPCLKGEN1_FREQMMCSEL_LPCLK      (CFG_CFGPCLKGEN1_FREQMMCSEL_LPCLK_Val << CFG_CFGPCLKGEN1_FREQMMCSEL_Pos) /* (CFG_CFGPCLKGEN1) 32 KHz Low Power Clock Position  */
#define CFG_CFGPCLKGEN1_MCD_Pos               _UINT32_(11)                                         /* (CFG_CFGPCLKGEN1) FREQMMC Clock Disable Position */
#define CFG_CFGPCLKGEN1_MCD_Msk               (_UINT32_(0x1) << CFG_CFGPCLKGEN1_MCD_Pos)           /* (CFG_CFGPCLKGEN1) FREQMMC Clock Disable Mask */
#define CFG_CFGPCLKGEN1_MCD(value)            (CFG_CFGPCLKGEN1_MCD_Msk & (_UINT32_(value) << CFG_CFGPCLKGEN1_MCD_Pos)) /* Assigment of value for MCD in the CFG_CFGPCLKGEN1 register */
#define   CFG_CFGPCLKGEN1_MCD_ON_Val          _UINT32_(0x1)                                        /* (CFG_CFGPCLKGEN1) Enable PGCLK  */
#define   CFG_CFGPCLKGEN1_MCD_OFF_Val         _UINT32_(0x0)                                        /* (CFG_CFGPCLKGEN1) Disable PGCLK  */
#define CFG_CFGPCLKGEN1_MCD_ON                (CFG_CFGPCLKGEN1_MCD_ON_Val << CFG_CFGPCLKGEN1_MCD_Pos) /* (CFG_CFGPCLKGEN1) Enable PGCLK Position  */
#define CFG_CFGPCLKGEN1_MCD_OFF               (CFG_CFGPCLKGEN1_MCD_OFF_Val << CFG_CFGPCLKGEN1_MCD_Pos) /* (CFG_CFGPCLKGEN1) Disable PGCLK Position  */
#define CFG_CFGPCLKGEN1_SERCOM01CSEL_Pos      _UINT32_(12)                                         /* (CFG_CFGPCLKGEN1) SERCOM0/1 Clock Selection Position */
#define CFG_CFGPCLKGEN1_SERCOM01CSEL_Msk      (_UINT32_(0x7) << CFG_CFGPCLKGEN1_SERCOM01CSEL_Pos)  /* (CFG_CFGPCLKGEN1) SERCOM0/1 Clock Selection Mask */
#define CFG_CFGPCLKGEN1_SERCOM01CSEL(value)   (CFG_CFGPCLKGEN1_SERCOM01CSEL_Msk & (_UINT32_(value) << CFG_CFGPCLKGEN1_SERCOM01CSEL_Pos)) /* Assigment of value for SERCOM01CSEL in the CFG_CFGPCLKGEN1 register */
#define   CFG_CFGPCLKGEN1_SERCOM01CSEL_NO_CLK_Val _UINT32_(0x0)                                        /* (CFG_CFGPCLKGEN1) No Clock  */
#define   CFG_CFGPCLKGEN1_SERCOM01CSEL_REFO1_Val _UINT32_(0x1)                                        /* (CFG_CFGPCLKGEN1) Reference Clock 1  */
#define   CFG_CFGPCLKGEN1_SERCOM01CSEL_REFO2_Val _UINT32_(0x2)                                        /* (CFG_CFGPCLKGEN1) Reference Clock 2  */
#define   CFG_CFGPCLKGEN1_SERCOM01CSEL_REFO3_Val _UINT32_(0x3)                                        /* (CFG_CFGPCLKGEN1) Reference Clock 3  */
#define   CFG_CFGPCLKGEN1_SERCOM01CSEL_REFO4_Val _UINT32_(0x4)                                        /* (CFG_CFGPCLKGEN1) Reference Clock 4  */
#define   CFG_CFGPCLKGEN1_SERCOM01CSEL_REFO5_Val _UINT32_(0x5)                                        /* (CFG_CFGPCLKGEN1) Reference Clock 5  */
#define   CFG_CFGPCLKGEN1_SERCOM01CSEL_REFO6_Val _UINT32_(0x6)                                        /* (CFG_CFGPCLKGEN1) Reference Clock 6  */
#define   CFG_CFGPCLKGEN1_SERCOM01CSEL_LPCLK_Val _UINT32_(0x7)                                        /* (CFG_CFGPCLKGEN1) 32 KHz Low Power Clock  */
#define CFG_CFGPCLKGEN1_SERCOM01CSEL_NO_CLK   (CFG_CFGPCLKGEN1_SERCOM01CSEL_NO_CLK_Val << CFG_CFGPCLKGEN1_SERCOM01CSEL_Pos) /* (CFG_CFGPCLKGEN1) No Clock Position  */
#define CFG_CFGPCLKGEN1_SERCOM01CSEL_REFO1    (CFG_CFGPCLKGEN1_SERCOM01CSEL_REFO1_Val << CFG_CFGPCLKGEN1_SERCOM01CSEL_Pos) /* (CFG_CFGPCLKGEN1) Reference Clock 1 Position  */
#define CFG_CFGPCLKGEN1_SERCOM01CSEL_REFO2    (CFG_CFGPCLKGEN1_SERCOM01CSEL_REFO2_Val << CFG_CFGPCLKGEN1_SERCOM01CSEL_Pos) /* (CFG_CFGPCLKGEN1) Reference Clock 2 Position  */
#define CFG_CFGPCLKGEN1_SERCOM01CSEL_REFO3    (CFG_CFGPCLKGEN1_SERCOM01CSEL_REFO3_Val << CFG_CFGPCLKGEN1_SERCOM01CSEL_Pos) /* (CFG_CFGPCLKGEN1) Reference Clock 3 Position  */
#define CFG_CFGPCLKGEN1_SERCOM01CSEL_REFO4    (CFG_CFGPCLKGEN1_SERCOM01CSEL_REFO4_Val << CFG_CFGPCLKGEN1_SERCOM01CSEL_Pos) /* (CFG_CFGPCLKGEN1) Reference Clock 4 Position  */
#define CFG_CFGPCLKGEN1_SERCOM01CSEL_REFO5    (CFG_CFGPCLKGEN1_SERCOM01CSEL_REFO5_Val << CFG_CFGPCLKGEN1_SERCOM01CSEL_Pos) /* (CFG_CFGPCLKGEN1) Reference Clock 5 Position  */
#define CFG_CFGPCLKGEN1_SERCOM01CSEL_REFO6    (CFG_CFGPCLKGEN1_SERCOM01CSEL_REFO6_Val << CFG_CFGPCLKGEN1_SERCOM01CSEL_Pos) /* (CFG_CFGPCLKGEN1) Reference Clock 6 Position  */
#define CFG_CFGPCLKGEN1_SERCOM01CSEL_LPCLK    (CFG_CFGPCLKGEN1_SERCOM01CSEL_LPCLK_Val << CFG_CFGPCLKGEN1_SERCOM01CSEL_Pos) /* (CFG_CFGPCLKGEN1) 32 KHz Low Power Clock Position  */
#define CFG_CFGPCLKGEN1_S01CD_Pos             _UINT32_(15)                                         /* (CFG_CFGPCLKGEN1) SERCOM0/1 Clock Disable Position */
#define CFG_CFGPCLKGEN1_S01CD_Msk             (_UINT32_(0x1) << CFG_CFGPCLKGEN1_S01CD_Pos)         /* (CFG_CFGPCLKGEN1) SERCOM0/1 Clock Disable Mask */
#define CFG_CFGPCLKGEN1_S01CD(value)          (CFG_CFGPCLKGEN1_S01CD_Msk & (_UINT32_(value) << CFG_CFGPCLKGEN1_S01CD_Pos)) /* Assigment of value for S01CD in the CFG_CFGPCLKGEN1 register */
#define   CFG_CFGPCLKGEN1_S01CD_ON_Val        _UINT32_(0x1)                                        /* (CFG_CFGPCLKGEN1) Enable PGCLK  */
#define   CFG_CFGPCLKGEN1_S01CD_OFF_Val       _UINT32_(0x0)                                        /* (CFG_CFGPCLKGEN1) Disable PGCLK  */
#define CFG_CFGPCLKGEN1_S01CD_ON              (CFG_CFGPCLKGEN1_S01CD_ON_Val << CFG_CFGPCLKGEN1_S01CD_Pos) /* (CFG_CFGPCLKGEN1) Enable PGCLK Position  */
#define CFG_CFGPCLKGEN1_S01CD_OFF             (CFG_CFGPCLKGEN1_S01CD_OFF_Val << CFG_CFGPCLKGEN1_S01CD_Pos) /* (CFG_CFGPCLKGEN1) Disable PGCLK Position  */
#define CFG_CFGPCLKGEN1_SERCOM23CSEL_Pos      _UINT32_(16)                                         /* (CFG_CFGPCLKGEN1) SERCOM2/3 Clock Selection Position */
#define CFG_CFGPCLKGEN1_SERCOM23CSEL_Msk      (_UINT32_(0x7) << CFG_CFGPCLKGEN1_SERCOM23CSEL_Pos)  /* (CFG_CFGPCLKGEN1) SERCOM2/3 Clock Selection Mask */
#define CFG_CFGPCLKGEN1_SERCOM23CSEL(value)   (CFG_CFGPCLKGEN1_SERCOM23CSEL_Msk & (_UINT32_(value) << CFG_CFGPCLKGEN1_SERCOM23CSEL_Pos)) /* Assigment of value for SERCOM23CSEL in the CFG_CFGPCLKGEN1 register */
#define   CFG_CFGPCLKGEN1_SERCOM23CSEL_NO_CLK_Val _UINT32_(0x0)                                        /* (CFG_CFGPCLKGEN1) No Clock  */
#define   CFG_CFGPCLKGEN1_SERCOM23CSEL_REFO1_Val _UINT32_(0x1)                                        /* (CFG_CFGPCLKGEN1) Reference Clock 1  */
#define   CFG_CFGPCLKGEN1_SERCOM23CSEL_REFO2_Val _UINT32_(0x2)                                        /* (CFG_CFGPCLKGEN1) Reference Clock 2  */
#define   CFG_CFGPCLKGEN1_SERCOM23CSEL_REFO3_Val _UINT32_(0x3)                                        /* (CFG_CFGPCLKGEN1) Reference Clock 3  */
#define   CFG_CFGPCLKGEN1_SERCOM23CSEL_REFO4_Val _UINT32_(0x4)                                        /* (CFG_CFGPCLKGEN1) Reference Clock 4  */
#define   CFG_CFGPCLKGEN1_SERCOM23CSEL_REFO5_Val _UINT32_(0x5)                                        /* (CFG_CFGPCLKGEN1) Reference Clock 5  */
#define   CFG_CFGPCLKGEN1_SERCOM23CSEL_REFO6_Val _UINT32_(0x6)                                        /* (CFG_CFGPCLKGEN1) Reference Clock 6  */
#define   CFG_CFGPCLKGEN1_SERCOM23CSEL_LPCLK_Val _UINT32_(0x7)                                        /* (CFG_CFGPCLKGEN1) 32 KHz Low Power Clock  */
#define CFG_CFGPCLKGEN1_SERCOM23CSEL_NO_CLK   (CFG_CFGPCLKGEN1_SERCOM23CSEL_NO_CLK_Val << CFG_CFGPCLKGEN1_SERCOM23CSEL_Pos) /* (CFG_CFGPCLKGEN1) No Clock Position  */
#define CFG_CFGPCLKGEN1_SERCOM23CSEL_REFO1    (CFG_CFGPCLKGEN1_SERCOM23CSEL_REFO1_Val << CFG_CFGPCLKGEN1_SERCOM23CSEL_Pos) /* (CFG_CFGPCLKGEN1) Reference Clock 1 Position  */
#define CFG_CFGPCLKGEN1_SERCOM23CSEL_REFO2    (CFG_CFGPCLKGEN1_SERCOM23CSEL_REFO2_Val << CFG_CFGPCLKGEN1_SERCOM23CSEL_Pos) /* (CFG_CFGPCLKGEN1) Reference Clock 2 Position  */
#define CFG_CFGPCLKGEN1_SERCOM23CSEL_REFO3    (CFG_CFGPCLKGEN1_SERCOM23CSEL_REFO3_Val << CFG_CFGPCLKGEN1_SERCOM23CSEL_Pos) /* (CFG_CFGPCLKGEN1) Reference Clock 3 Position  */
#define CFG_CFGPCLKGEN1_SERCOM23CSEL_REFO4    (CFG_CFGPCLKGEN1_SERCOM23CSEL_REFO4_Val << CFG_CFGPCLKGEN1_SERCOM23CSEL_Pos) /* (CFG_CFGPCLKGEN1) Reference Clock 4 Position  */
#define CFG_CFGPCLKGEN1_SERCOM23CSEL_REFO5    (CFG_CFGPCLKGEN1_SERCOM23CSEL_REFO5_Val << CFG_CFGPCLKGEN1_SERCOM23CSEL_Pos) /* (CFG_CFGPCLKGEN1) Reference Clock 5 Position  */
#define CFG_CFGPCLKGEN1_SERCOM23CSEL_REFO6    (CFG_CFGPCLKGEN1_SERCOM23CSEL_REFO6_Val << CFG_CFGPCLKGEN1_SERCOM23CSEL_Pos) /* (CFG_CFGPCLKGEN1) Reference Clock 6 Position  */
#define CFG_CFGPCLKGEN1_SERCOM23CSEL_LPCLK    (CFG_CFGPCLKGEN1_SERCOM23CSEL_LPCLK_Val << CFG_CFGPCLKGEN1_SERCOM23CSEL_Pos) /* (CFG_CFGPCLKGEN1) 32 KHz Low Power Clock Position  */
#define CFG_CFGPCLKGEN1_S23CD_Pos             _UINT32_(19)                                         /* (CFG_CFGPCLKGEN1) SERCOM2/3 Clock Disable Position */
#define CFG_CFGPCLKGEN1_S23CD_Msk             (_UINT32_(0x1) << CFG_CFGPCLKGEN1_S23CD_Pos)         /* (CFG_CFGPCLKGEN1) SERCOM2/3 Clock Disable Mask */
#define CFG_CFGPCLKGEN1_S23CD(value)          (CFG_CFGPCLKGEN1_S23CD_Msk & (_UINT32_(value) << CFG_CFGPCLKGEN1_S23CD_Pos)) /* Assigment of value for S23CD in the CFG_CFGPCLKGEN1 register */
#define   CFG_CFGPCLKGEN1_S23CD_ON_Val        _UINT32_(0x1)                                        /* (CFG_CFGPCLKGEN1) Enable PGCLK  */
#define   CFG_CFGPCLKGEN1_S23CD_OFF_Val       _UINT32_(0x0)                                        /* (CFG_CFGPCLKGEN1) Disable PGCLK  */
#define CFG_CFGPCLKGEN1_S23CD_ON              (CFG_CFGPCLKGEN1_S23CD_ON_Val << CFG_CFGPCLKGEN1_S23CD_Pos) /* (CFG_CFGPCLKGEN1) Enable PGCLK Position  */
#define CFG_CFGPCLKGEN1_S23CD_OFF             (CFG_CFGPCLKGEN1_S23CD_OFF_Val << CFG_CFGPCLKGEN1_S23CD_Pos) /* (CFG_CFGPCLKGEN1) Disable PGCLK Position  */
#define CFG_CFGPCLKGEN1_TCC12CSEL_Pos         _UINT32_(20)                                         /* (CFG_CFGPCLKGEN1) TCC1/2 Clock Selection Position */
#define CFG_CFGPCLKGEN1_TCC12CSEL_Msk         (_UINT32_(0x7) << CFG_CFGPCLKGEN1_TCC12CSEL_Pos)     /* (CFG_CFGPCLKGEN1) TCC1/2 Clock Selection Mask */
#define CFG_CFGPCLKGEN1_TCC12CSEL(value)      (CFG_CFGPCLKGEN1_TCC12CSEL_Msk & (_UINT32_(value) << CFG_CFGPCLKGEN1_TCC12CSEL_Pos)) /* Assigment of value for TCC12CSEL in the CFG_CFGPCLKGEN1 register */
#define   CFG_CFGPCLKGEN1_TCC12CSEL_NO_CLK_Val _UINT32_(0x0)                                        /* (CFG_CFGPCLKGEN1) No Clock  */
#define   CFG_CFGPCLKGEN1_TCC12CSEL_REFO1_Val _UINT32_(0x1)                                        /* (CFG_CFGPCLKGEN1) Reference Clock 1  */
#define   CFG_CFGPCLKGEN1_TCC12CSEL_REFO2_Val _UINT32_(0x2)                                        /* (CFG_CFGPCLKGEN1) Reference Clock 2  */
#define   CFG_CFGPCLKGEN1_TCC12CSEL_REFO3_Val _UINT32_(0x3)                                        /* (CFG_CFGPCLKGEN1) Reference Clock 3  */
#define   CFG_CFGPCLKGEN1_TCC12CSEL_REFO4_Val _UINT32_(0x4)                                        /* (CFG_CFGPCLKGEN1) Reference Clock 4  */
#define   CFG_CFGPCLKGEN1_TCC12CSEL_REFO5_Val _UINT32_(0x5)                                        /* (CFG_CFGPCLKGEN1) Reference Clock 5  */
#define   CFG_CFGPCLKGEN1_TCC12CSEL_REFO6_Val _UINT32_(0x6)                                        /* (CFG_CFGPCLKGEN1) Reference Clock 6  */
#define   CFG_CFGPCLKGEN1_TCC12CSEL_LPCLK_Val _UINT32_(0x7)                                        /* (CFG_CFGPCLKGEN1) 32 KHz Low Power Clock  */
#define CFG_CFGPCLKGEN1_TCC12CSEL_NO_CLK      (CFG_CFGPCLKGEN1_TCC12CSEL_NO_CLK_Val << CFG_CFGPCLKGEN1_TCC12CSEL_Pos) /* (CFG_CFGPCLKGEN1) No Clock Position  */
#define CFG_CFGPCLKGEN1_TCC12CSEL_REFO1       (CFG_CFGPCLKGEN1_TCC12CSEL_REFO1_Val << CFG_CFGPCLKGEN1_TCC12CSEL_Pos) /* (CFG_CFGPCLKGEN1) Reference Clock 1 Position  */
#define CFG_CFGPCLKGEN1_TCC12CSEL_REFO2       (CFG_CFGPCLKGEN1_TCC12CSEL_REFO2_Val << CFG_CFGPCLKGEN1_TCC12CSEL_Pos) /* (CFG_CFGPCLKGEN1) Reference Clock 2 Position  */
#define CFG_CFGPCLKGEN1_TCC12CSEL_REFO3       (CFG_CFGPCLKGEN1_TCC12CSEL_REFO3_Val << CFG_CFGPCLKGEN1_TCC12CSEL_Pos) /* (CFG_CFGPCLKGEN1) Reference Clock 3 Position  */
#define CFG_CFGPCLKGEN1_TCC12CSEL_REFO4       (CFG_CFGPCLKGEN1_TCC12CSEL_REFO4_Val << CFG_CFGPCLKGEN1_TCC12CSEL_Pos) /* (CFG_CFGPCLKGEN1) Reference Clock 4 Position  */
#define CFG_CFGPCLKGEN1_TCC12CSEL_REFO5       (CFG_CFGPCLKGEN1_TCC12CSEL_REFO5_Val << CFG_CFGPCLKGEN1_TCC12CSEL_Pos) /* (CFG_CFGPCLKGEN1) Reference Clock 5 Position  */
#define CFG_CFGPCLKGEN1_TCC12CSEL_REFO6       (CFG_CFGPCLKGEN1_TCC12CSEL_REFO6_Val << CFG_CFGPCLKGEN1_TCC12CSEL_Pos) /* (CFG_CFGPCLKGEN1) Reference Clock 6 Position  */
#define CFG_CFGPCLKGEN1_TCC12CSEL_LPCLK       (CFG_CFGPCLKGEN1_TCC12CSEL_LPCLK_Val << CFG_CFGPCLKGEN1_TCC12CSEL_Pos) /* (CFG_CFGPCLKGEN1) 32 KHz Low Power Clock Position  */
#define CFG_CFGPCLKGEN1_TCC12CD_Pos           _UINT32_(23)                                         /* (CFG_CFGPCLKGEN1) TCC1/2 Clock Disable Position */
#define CFG_CFGPCLKGEN1_TCC12CD_Msk           (_UINT32_(0x1) << CFG_CFGPCLKGEN1_TCC12CD_Pos)       /* (CFG_CFGPCLKGEN1) TCC1/2 Clock Disable Mask */
#define CFG_CFGPCLKGEN1_TCC12CD(value)        (CFG_CFGPCLKGEN1_TCC12CD_Msk & (_UINT32_(value) << CFG_CFGPCLKGEN1_TCC12CD_Pos)) /* Assigment of value for TCC12CD in the CFG_CFGPCLKGEN1 register */
#define   CFG_CFGPCLKGEN1_TCC12CD_ON_Val      _UINT32_(0x1)                                        /* (CFG_CFGPCLKGEN1) Enable PGCLK  */
#define   CFG_CFGPCLKGEN1_TCC12CD_OFF_Val     _UINT32_(0x0)                                        /* (CFG_CFGPCLKGEN1) Disable PGCLK  */
#define CFG_CFGPCLKGEN1_TCC12CD_ON            (CFG_CFGPCLKGEN1_TCC12CD_ON_Val << CFG_CFGPCLKGEN1_TCC12CD_Pos) /* (CFG_CFGPCLKGEN1) Enable PGCLK Position  */
#define CFG_CFGPCLKGEN1_TCC12CD_OFF           (CFG_CFGPCLKGEN1_TCC12CD_OFF_Val << CFG_CFGPCLKGEN1_TCC12CD_Pos) /* (CFG_CFGPCLKGEN1) Disable PGCLK Position  */
#define CFG_CFGPCLKGEN1_TC23CSEL_Pos          _UINT32_(24)                                         /* (CFG_CFGPCLKGEN1) TC2/3 Clock Selection Position */
#define CFG_CFGPCLKGEN1_TC23CSEL_Msk          (_UINT32_(0x7) << CFG_CFGPCLKGEN1_TC23CSEL_Pos)      /* (CFG_CFGPCLKGEN1) TC2/3 Clock Selection Mask */
#define CFG_CFGPCLKGEN1_TC23CSEL(value)       (CFG_CFGPCLKGEN1_TC23CSEL_Msk & (_UINT32_(value) << CFG_CFGPCLKGEN1_TC23CSEL_Pos)) /* Assigment of value for TC23CSEL in the CFG_CFGPCLKGEN1 register */
#define   CFG_CFGPCLKGEN1_TC23CSEL_NO_CLK_Val _UINT32_(0x0)                                        /* (CFG_CFGPCLKGEN1) No Clock  */
#define   CFG_CFGPCLKGEN1_TC23CSEL_REFO1_Val  _UINT32_(0x1)                                        /* (CFG_CFGPCLKGEN1) Reference Clock 1  */
#define   CFG_CFGPCLKGEN1_TC23CSEL_REFO2_Val  _UINT32_(0x2)                                        /* (CFG_CFGPCLKGEN1) Reference Clock 2  */
#define   CFG_CFGPCLKGEN1_TC23CSEL_REFO3_Val  _UINT32_(0x3)                                        /* (CFG_CFGPCLKGEN1) Reference Clock 3  */
#define   CFG_CFGPCLKGEN1_TC23CSEL_REFO4_Val  _UINT32_(0x4)                                        /* (CFG_CFGPCLKGEN1) Reference Clock 4  */
#define   CFG_CFGPCLKGEN1_TC23CSEL_REFO5_Val  _UINT32_(0x5)                                        /* (CFG_CFGPCLKGEN1) Reference Clock 5  */
#define   CFG_CFGPCLKGEN1_TC23CSEL_REFO6_Val  _UINT32_(0x6)                                        /* (CFG_CFGPCLKGEN1) Reference Clock 6  */
#define   CFG_CFGPCLKGEN1_TC23CSEL_LPCLK_Val  _UINT32_(0x7)                                        /* (CFG_CFGPCLKGEN1) 32 KHz Low Power Clock  */
#define CFG_CFGPCLKGEN1_TC23CSEL_NO_CLK       (CFG_CFGPCLKGEN1_TC23CSEL_NO_CLK_Val << CFG_CFGPCLKGEN1_TC23CSEL_Pos) /* (CFG_CFGPCLKGEN1) No Clock Position  */
#define CFG_CFGPCLKGEN1_TC23CSEL_REFO1        (CFG_CFGPCLKGEN1_TC23CSEL_REFO1_Val << CFG_CFGPCLKGEN1_TC23CSEL_Pos) /* (CFG_CFGPCLKGEN1) Reference Clock 1 Position  */
#define CFG_CFGPCLKGEN1_TC23CSEL_REFO2        (CFG_CFGPCLKGEN1_TC23CSEL_REFO2_Val << CFG_CFGPCLKGEN1_TC23CSEL_Pos) /* (CFG_CFGPCLKGEN1) Reference Clock 2 Position  */
#define CFG_CFGPCLKGEN1_TC23CSEL_REFO3        (CFG_CFGPCLKGEN1_TC23CSEL_REFO3_Val << CFG_CFGPCLKGEN1_TC23CSEL_Pos) /* (CFG_CFGPCLKGEN1) Reference Clock 3 Position  */
#define CFG_CFGPCLKGEN1_TC23CSEL_REFO4        (CFG_CFGPCLKGEN1_TC23CSEL_REFO4_Val << CFG_CFGPCLKGEN1_TC23CSEL_Pos) /* (CFG_CFGPCLKGEN1) Reference Clock 4 Position  */
#define CFG_CFGPCLKGEN1_TC23CSEL_REFO5        (CFG_CFGPCLKGEN1_TC23CSEL_REFO5_Val << CFG_CFGPCLKGEN1_TC23CSEL_Pos) /* (CFG_CFGPCLKGEN1) Reference Clock 5 Position  */
#define CFG_CFGPCLKGEN1_TC23CSEL_REFO6        (CFG_CFGPCLKGEN1_TC23CSEL_REFO6_Val << CFG_CFGPCLKGEN1_TC23CSEL_Pos) /* (CFG_CFGPCLKGEN1) Reference Clock 6 Position  */
#define CFG_CFGPCLKGEN1_TC23CSEL_LPCLK        (CFG_CFGPCLKGEN1_TC23CSEL_LPCLK_Val << CFG_CFGPCLKGEN1_TC23CSEL_Pos) /* (CFG_CFGPCLKGEN1) 32 KHz Low Power Clock Position  */
#define CFG_CFGPCLKGEN1_TC23CD_Pos            _UINT32_(27)                                         /* (CFG_CFGPCLKGEN1) TC2/3 Clock Disable Position */
#define CFG_CFGPCLKGEN1_TC23CD_Msk            (_UINT32_(0x1) << CFG_CFGPCLKGEN1_TC23CD_Pos)        /* (CFG_CFGPCLKGEN1) TC2/3 Clock Disable Mask */
#define CFG_CFGPCLKGEN1_TC23CD(value)         (CFG_CFGPCLKGEN1_TC23CD_Msk & (_UINT32_(value) << CFG_CFGPCLKGEN1_TC23CD_Pos)) /* Assigment of value for TC23CD in the CFG_CFGPCLKGEN1 register */
#define   CFG_CFGPCLKGEN1_TC23CD_ON_Val       _UINT32_(0x1)                                        /* (CFG_CFGPCLKGEN1) Enable PGCLK  */
#define   CFG_CFGPCLKGEN1_TC23CD_OFF_Val      _UINT32_(0x0)                                        /* (CFG_CFGPCLKGEN1) Disable PGCLK  */
#define CFG_CFGPCLKGEN1_TC23CD_ON             (CFG_CFGPCLKGEN1_TC23CD_ON_Val << CFG_CFGPCLKGEN1_TC23CD_Pos) /* (CFG_CFGPCLKGEN1) Enable PGCLK Position  */
#define CFG_CFGPCLKGEN1_TC23CD_OFF            (CFG_CFGPCLKGEN1_TC23CD_OFF_Val << CFG_CFGPCLKGEN1_TC23CD_Pos) /* (CFG_CFGPCLKGEN1) Disable PGCLK Position  */
#define CFG_CFGPCLKGEN1_CM4TCSEL_Pos          _UINT32_(28)                                         /* (CFG_CFGPCLKGEN1) CM4T Clock Selection Position */
#define CFG_CFGPCLKGEN1_CM4TCSEL_Msk          (_UINT32_(0x7) << CFG_CFGPCLKGEN1_CM4TCSEL_Pos)      /* (CFG_CFGPCLKGEN1) CM4T Clock Selection Mask */
#define CFG_CFGPCLKGEN1_CM4TCSEL(value)       (CFG_CFGPCLKGEN1_CM4TCSEL_Msk & (_UINT32_(value) << CFG_CFGPCLKGEN1_CM4TCSEL_Pos)) /* Assigment of value for CM4TCSEL in the CFG_CFGPCLKGEN1 register */
#define   CFG_CFGPCLKGEN1_CM4TCSEL_NO_CLK_Val _UINT32_(0x0)                                        /* (CFG_CFGPCLKGEN1) No Clock  */
#define   CFG_CFGPCLKGEN1_CM4TCSEL_REFO1_Val  _UINT32_(0x1)                                        /* (CFG_CFGPCLKGEN1) Reference Clock 1  */
#define   CFG_CFGPCLKGEN1_CM4TCSEL_REFO2_Val  _UINT32_(0x2)                                        /* (CFG_CFGPCLKGEN1) Reference Clock 2  */
#define   CFG_CFGPCLKGEN1_CM4TCSEL_REFO3_Val  _UINT32_(0x3)                                        /* (CFG_CFGPCLKGEN1) Reference Clock 3  */
#define   CFG_CFGPCLKGEN1_CM4TCSEL_REFO4_Val  _UINT32_(0x4)                                        /* (CFG_CFGPCLKGEN1) Reference Clock 4  */
#define   CFG_CFGPCLKGEN1_CM4TCSEL_REFO5_Val  _UINT32_(0x5)                                        /* (CFG_CFGPCLKGEN1) Reference Clock 5  */
#define   CFG_CFGPCLKGEN1_CM4TCSEL_REFO6_Val  _UINT32_(0x6)                                        /* (CFG_CFGPCLKGEN1) Reference Clock 6  */
#define   CFG_CFGPCLKGEN1_CM4TCSEL_LPCLK_Val  _UINT32_(0x7)                                        /* (CFG_CFGPCLKGEN1) 32 KHz Low Power Clock  */
#define CFG_CFGPCLKGEN1_CM4TCSEL_NO_CLK       (CFG_CFGPCLKGEN1_CM4TCSEL_NO_CLK_Val << CFG_CFGPCLKGEN1_CM4TCSEL_Pos) /* (CFG_CFGPCLKGEN1) No Clock Position  */
#define CFG_CFGPCLKGEN1_CM4TCSEL_REFO1        (CFG_CFGPCLKGEN1_CM4TCSEL_REFO1_Val << CFG_CFGPCLKGEN1_CM4TCSEL_Pos) /* (CFG_CFGPCLKGEN1) Reference Clock 1 Position  */
#define CFG_CFGPCLKGEN1_CM4TCSEL_REFO2        (CFG_CFGPCLKGEN1_CM4TCSEL_REFO2_Val << CFG_CFGPCLKGEN1_CM4TCSEL_Pos) /* (CFG_CFGPCLKGEN1) Reference Clock 2 Position  */
#define CFG_CFGPCLKGEN1_CM4TCSEL_REFO3        (CFG_CFGPCLKGEN1_CM4TCSEL_REFO3_Val << CFG_CFGPCLKGEN1_CM4TCSEL_Pos) /* (CFG_CFGPCLKGEN1) Reference Clock 3 Position  */
#define CFG_CFGPCLKGEN1_CM4TCSEL_REFO4        (CFG_CFGPCLKGEN1_CM4TCSEL_REFO4_Val << CFG_CFGPCLKGEN1_CM4TCSEL_Pos) /* (CFG_CFGPCLKGEN1) Reference Clock 4 Position  */
#define CFG_CFGPCLKGEN1_CM4TCSEL_REFO5        (CFG_CFGPCLKGEN1_CM4TCSEL_REFO5_Val << CFG_CFGPCLKGEN1_CM4TCSEL_Pos) /* (CFG_CFGPCLKGEN1) Reference Clock 5 Position  */
#define CFG_CFGPCLKGEN1_CM4TCSEL_REFO6        (CFG_CFGPCLKGEN1_CM4TCSEL_REFO6_Val << CFG_CFGPCLKGEN1_CM4TCSEL_Pos) /* (CFG_CFGPCLKGEN1) Reference Clock 6 Position  */
#define CFG_CFGPCLKGEN1_CM4TCSEL_LPCLK        (CFG_CFGPCLKGEN1_CM4TCSEL_LPCLK_Val << CFG_CFGPCLKGEN1_CM4TCSEL_Pos) /* (CFG_CFGPCLKGEN1) 32 KHz Low Power Clock Position  */
#define CFG_CFGPCLKGEN1_CM4TD_Pos             _UINT32_(31)                                         /* (CFG_CFGPCLKGEN1) CM4T Clock Disable Position */
#define CFG_CFGPCLKGEN1_CM4TD_Msk             (_UINT32_(0x1) << CFG_CFGPCLKGEN1_CM4TD_Pos)         /* (CFG_CFGPCLKGEN1) CM4T Clock Disable Mask */
#define CFG_CFGPCLKGEN1_CM4TD(value)          (CFG_CFGPCLKGEN1_CM4TD_Msk & (_UINT32_(value) << CFG_CFGPCLKGEN1_CM4TD_Pos)) /* Assigment of value for CM4TD in the CFG_CFGPCLKGEN1 register */
#define   CFG_CFGPCLKGEN1_CM4TD_ON_Val        _UINT32_(0x1)                                        /* (CFG_CFGPCLKGEN1) Enable PGCLK  */
#define   CFG_CFGPCLKGEN1_CM4TD_OFF_Val       _UINT32_(0x0)                                        /* (CFG_CFGPCLKGEN1) Disable PGCLK  */
#define CFG_CFGPCLKGEN1_CM4TD_ON              (CFG_CFGPCLKGEN1_CM4TD_ON_Val << CFG_CFGPCLKGEN1_CM4TD_Pos) /* (CFG_CFGPCLKGEN1) Enable PGCLK Position  */
#define CFG_CFGPCLKGEN1_CM4TD_OFF             (CFG_CFGPCLKGEN1_CM4TD_OFF_Val << CFG_CFGPCLKGEN1_CM4TD_Pos) /* (CFG_CFGPCLKGEN1) Disable PGCLK Position  */
#define CFG_CFGPCLKGEN1_Msk                   _UINT32_(0xFFFFFFFF)                                 /* (CFG_CFGPCLKGEN1) Register Mask  */


/* -------- CFG_CFGPCLKGEN1CLR : (CFG Offset: 0x64) (R/W 32) Bit clear register -------- */
#define CFG_CFGPCLKGEN1CLR_RESETVALUE         _UINT32_(0x00)                                       /*  (CFG_CFGPCLKGEN1CLR) Bit clear register  Reset Value */

#define CFG_CFGPCLKGEN1CLR_Msk                _UINT32_(0x00000000)                                 /* (CFG_CFGPCLKGEN1CLR) Register Mask  */


/* -------- CFG_CFGPCLKGEN1SET : (CFG Offset: 0x68) (R/W 32) Bit set register -------- */
#define CFG_CFGPCLKGEN1SET_RESETVALUE         _UINT32_(0x00)                                       /*  (CFG_CFGPCLKGEN1SET) Bit set register  Reset Value */

#define CFG_CFGPCLKGEN1SET_Msk                _UINT32_(0x00000000)                                 /* (CFG_CFGPCLKGEN1SET) Register Mask  */


/* -------- CFG_CFGPCLKGEN1INV : (CFG Offset: 0x6C) (R/W 32) Bit invert register -------- */
#define CFG_CFGPCLKGEN1INV_RESETVALUE         _UINT32_(0x00)                                       /*  (CFG_CFGPCLKGEN1INV) Bit invert register  Reset Value */

#define CFG_CFGPCLKGEN1INV_Msk                _UINT32_(0x00000000)                                 /* (CFG_CFGPCLKGEN1INV) Register Mask  */


/* -------- CFG_CFGPCLKGEN2 : (CFG Offset: 0x70) (R/W 32)  -------- */
#define CFG_CFGPCLKGEN2_RESETVALUE            _UINT32_(0x00)                                       /*  (CFG_CFGPCLKGEN2)   Reset Value */
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
