nsaspook/wbz451matter/src/packs/WBZ451_DFP/component/cru.h

/*
 * Component description for CRU
 *
 * Copyright (c) 2023 Microchip Technology Inc. and its subsidiaries.
 *
 * Licensed under the Apache License, Version 2.0 (the "License");
 * you may not use this file except in compliance with the License.
 * You may obtain a copy of the License at
 *
 *   http://www.apache.org/licenses/LICENSE-2.0
 *
 * Unless required by applicable law or agreed to in writing, software
 * distributed under the License is distributed on an "AS IS" BASIS,
 * WITHOUT WARRANTIES OR CONDITIONS OF ANY KIND, either express or implied.
 * See the License for the specific language governing permissions and
 * limitations under the License.
 *
 */

/* file generated from device description file (ATDF) version 2023-10-17T09:04:59Z */
#ifndef _BZ45_CRU_COMPONENT_H_
#define _BZ45_CRU_COMPONENT_H_

/* ************************************************************************** */
/*   SOFTWARE API DEFINITION FOR CRU                                          */
/* ************************************************************************** */

/* -------- CRU_OSCCON : (CRU Offset: 0x00) (R/W 32) CRU OSCILLATOR CONTROL REGISTER -------- */
#define CRU_OSCCON_RESETVALUE                 _UINT32_(0x100)                                      /*  (CRU_OSCCON) CRU OSCILLATOR CONTROL REGISTER  Reset Value */

#define CRU_OSCCON_OSWEN_Pos                  _UINT32_(0)                                          /* (CRU_OSCCON) Oscillator Switch Enable bit Position */
#define CRU_OSCCON_OSWEN_Msk                  (_UINT32_(0x1) << CRU_OSCCON_OSWEN_Pos)              /* (CRU_OSCCON) Oscillator Switch Enable bit Mask */
#define CRU_OSCCON_OSWEN(value)               (CRU_OSCCON_OSWEN_Msk & (_UINT32_(value) << CRU_OSCCON_OSWEN_Pos)) /* Assigment of value for OSWEN in the CRU_OSCCON register */
#define   CRU_OSCCON_OSWEN_SWITCH_Val         _UINT32_(0x1)                                        /* (CRU_OSCCON) Request oscillator switch to selection specified by NOSC[3:0] bits  */
#define   CRU_OSCCON_OSWEN_SWITCH_COMPLETE_Val _UINT32_(0x0)                                        /* (CRU_OSCCON) Oscillator switch is complete  */
#define CRU_OSCCON_OSWEN_SWITCH               (CRU_OSCCON_OSWEN_SWITCH_Val << CRU_OSCCON_OSWEN_Pos) /* (CRU_OSCCON) Request oscillator switch to selection specified by NOSC[3:0] bits Position  */
#define CRU_OSCCON_OSWEN_SWITCH_COMPLETE      (CRU_OSCCON_OSWEN_SWITCH_COMPLETE_Val << CRU_OSCCON_OSWEN_Pos) /* (CRU_OSCCON) Oscillator switch is complete Position  */
#define CRU_OSCCON_SOSCEN_Pos                 _UINT32_(1)                                          /* (CRU_OSCCON) 32 kHz Secondary (LP) Oscillator Enable bit Position */
#define CRU_OSCCON_SOSCEN_Msk                 (_UINT32_(0x1) << CRU_OSCCON_SOSCEN_Pos)             /* (CRU_OSCCON) 32 kHz Secondary (LP) Oscillator Enable bit Mask */
#define CRU_OSCCON_SOSCEN(value)              (CRU_OSCCON_SOSCEN_Msk & (_UINT32_(value) << CRU_OSCCON_SOSCEN_Pos)) /* Assigment of value for SOSCEN in the CRU_OSCCON register */
#define   CRU_OSCCON_SOSCEN_ON_Val            _UINT32_(0x1)                                        /* (CRU_OSCCON) Enable Secondary Oscillator  */
#define   CRU_OSCCON_SOSCEN_OFF_Val           _UINT32_(0x0)                                        /* (CRU_OSCCON) Disable Secondary Oscillator  */
#define CRU_OSCCON_SOSCEN_ON                  (CRU_OSCCON_SOSCEN_ON_Val << CRU_OSCCON_SOSCEN_Pos)  /* (CRU_OSCCON) Enable Secondary Oscillator Position  */
#define CRU_OSCCON_SOSCEN_OFF                 (CRU_OSCCON_SOSCEN_OFF_Val << CRU_OSCCON_SOSCEN_Pos) /* (CRU_OSCCON) Disable Secondary Oscillator Position  */
#define CRU_OSCCON_CF_Pos                     _UINT32_(3)                                          /* (CRU_OSCCON) Clock Fail Detect bit (Read / writable / Clearable by application) Position */
#define CRU_OSCCON_CF_Msk                     (_UINT32_(0x1) << CRU_OSCCON_CF_Pos)                 /* (CRU_OSCCON) Clock Fail Detect bit (Read / writable / Clearable by application) Mask */
#define CRU_OSCCON_CF(value)                  (CRU_OSCCON_CF_Msk & (_UINT32_(value) << CRU_OSCCON_CF_Pos)) /* Assigment of value for CF in the CRU_OSCCON register */
#define   CRU_OSCCON_CF_FAIL_DET_Val          _UINT32_(0x1)                                        /* (CRU_OSCCON) FSCM has detected clock failure  */
#define   CRU_OSCCON_CF_NO_FAILDET_Val        _UINT32_(0x0)                                        /* (CRU_OSCCON) FSCM has not detected clock failure  */
#define CRU_OSCCON_CF_FAIL_DET                (CRU_OSCCON_CF_FAIL_DET_Val << CRU_OSCCON_CF_Pos)    /* (CRU_OSCCON) FSCM has detected clock failure Position  */
#define CRU_OSCCON_CF_NO_FAILDET              (CRU_OSCCON_CF_NO_FAILDET_Val << CRU_OSCCON_CF_Pos)  /* (CRU_OSCCON) FSCM has not detected clock failure Position  */
#define CRU_OSCCON_SLPEN_Pos                  _UINT32_(4)                                          /* (CRU_OSCCON) Enable SLEEP Mode bit Position */
#define CRU_OSCCON_SLPEN_Msk                  (_UINT32_(0x1) << CRU_OSCCON_SLPEN_Pos)              /* (CRU_OSCCON) Enable SLEEP Mode bit Mask */
#define CRU_OSCCON_SLPEN(value)               (CRU_OSCCON_SLPEN_Msk & (_UINT32_(value) << CRU_OSCCON_SLPEN_Pos)) /* Assigment of value for SLPEN in the CRU_OSCCON register */
#define   CRU_OSCCON_SLPEN_SLEEP_Val          _UINT32_(0x1)                                        /* (CRU_OSCCON) When a WAIT Instruction is executed device will enter SLEEP Mode  */
#define   CRU_OSCCON_SLPEN_IDLE_Val           _UINT32_(0x0)                                        /* (CRU_OSCCON) When a WAIT instruction is executed device will enter IDLE Mode  */
#define CRU_OSCCON_SLPEN_SLEEP                (CRU_OSCCON_SLPEN_SLEEP_Val << CRU_OSCCON_SLPEN_Pos) /* (CRU_OSCCON) When a WAIT Instruction is executed device will enter SLEEP Mode Position  */
#define CRU_OSCCON_SLPEN_IDLE                 (CRU_OSCCON_SLPEN_IDLE_Val << CRU_OSCCON_SLPEN_Pos)  /* (CRU_OSCCON) When a WAIT instruction is executed device will enter IDLE Mode Position  */
#define CRU_OSCCON_CLKLOCK_Pos                _UINT32_(7)                                          /* (CRU_OSCCON) Clock Lock Enabled bit Position */
#define CRU_OSCCON_CLKLOCK_Msk                (_UINT32_(0x1) << CRU_OSCCON_CLKLOCK_Pos)            /* (CRU_OSCCON) Clock Lock Enabled bit Mask */
#define CRU_OSCCON_CLKLOCK(value)             (CRU_OSCCON_CLKLOCK_Msk & (_UINT32_(value) << CRU_OSCCON_CLKLOCK_Pos)) /* Assigment of value for CLKLOCK in the CRU_OSCCON register */
#define   CRU_OSCCON_CLKLOCK_LOCKED_Val       _UINT32_(0x1)                                        /* (CRU_OSCCON) All clock and PLL configuration registers are locked.  These include OSCCON, OSCTRIM, SPLLCON, UPLLCON, PBxDIV  */
#define   CRU_OSCCON_CLKLOCK_UNLOCKED_Val     _UINT32_(0x0)                                        /* (CRU_OSCCON) Clock and PLL selection registers are not locked, configurations may be modified  */
#define CRU_OSCCON_CLKLOCK_LOCKED             (CRU_OSCCON_CLKLOCK_LOCKED_Val << CRU_OSCCON_CLKLOCK_Pos) /* (CRU_OSCCON) All clock and PLL configuration registers are locked.  These include OSCCON, OSCTRIM, SPLLCON, UPLLCON, PBxDIV Position  */
#define CRU_OSCCON_CLKLOCK_UNLOCKED           (CRU_OSCCON_CLKLOCK_UNLOCKED_Val << CRU_OSCCON_CLKLOCK_Pos) /* (CRU_OSCCON) Clock and PLL selection registers are not locked, configurations may be modified Position  */
#define CRU_OSCCON_NOSC_Pos                   _UINT32_(8)                                          /* (CRU_OSCCON) New Oscillator Selection bits Position */
#define CRU_OSCCON_NOSC_Msk                   (_UINT32_(0xF) << CRU_OSCCON_NOSC_Pos)               /* (CRU_OSCCON) New Oscillator Selection bits Mask */
#define CRU_OSCCON_NOSC(value)                (CRU_OSCCON_NOSC_Msk & (_UINT32_(value) << CRU_OSCCON_NOSC_Pos)) /* Assigment of value for NOSC in the CRU_OSCCON register */
#define   CRU_OSCCON_NOSC_FRCDIV_Val          _UINT32_(0x0)                                        /* (CRU_OSCCON) Fast RC Oscillator (FRC) divided by OSCCON.FRCDIV ( Supports FRC/16 and FRC/1)  */
#define   CRU_OSCCON_NOSC_SPLL_Val            _UINT32_(0x1)                                        /* (CRU_OSCCON) System PLL (SPLL1 Module) (input clock and divider set by SPLLCON)  */
#define   CRU_OSCCON_NOSC_POSC_Val            _UINT32_(0x2)                                        /* (CRU_OSCCON) Primary Oscillator  */
#define   CRU_OSCCON_NOSC_SOSC_Val            _UINT32_(0x3)                                        /* (CRU_OSCCON) Secondary Oscillator (SOSC)  */
#define   CRU_OSCCON_NOSC_LPRC_Val            _UINT32_(0x4)                                        /* (CRU_OSCCON) Low Power RC Oscillator (LPRC)  */
#define CRU_OSCCON_NOSC_FRCDIV                (CRU_OSCCON_NOSC_FRCDIV_Val << CRU_OSCCON_NOSC_Pos)  /* (CRU_OSCCON) Fast RC Oscillator (FRC) divided by OSCCON.FRCDIV ( Supports FRC/16 and FRC/1) Position  */
#define CRU_OSCCON_NOSC_SPLL                  (CRU_OSCCON_NOSC_SPLL_Val << CRU_OSCCON_NOSC_Pos)    /* (CRU_OSCCON) System PLL (SPLL1 Module) (input clock and divider set by SPLLCON) Position  */
#define CRU_OSCCON_NOSC_POSC                  (CRU_OSCCON_NOSC_POSC_Val << CRU_OSCCON_NOSC_Pos)    /* (CRU_OSCCON) Primary Oscillator Position  */
#define CRU_OSCCON_NOSC_SOSC                  (CRU_OSCCON_NOSC_SOSC_Val << CRU_OSCCON_NOSC_Pos)    /* (CRU_OSCCON) Secondary Oscillator (SOSC) Position  */
#define CRU_OSCCON_NOSC_LPRC                  (CRU_OSCCON_NOSC_LPRC_Val << CRU_OSCCON_NOSC_Pos)    /* (CRU_OSCCON) Low Power RC Oscillator (LPRC) Position  */
#define CRU_OSCCON_COSC_Pos                   _UINT32_(12)                                         /* (CRU_OSCCON) Current Oscillator Selection bits (Read-only) Position */
#define CRU_OSCCON_COSC_Msk                   (_UINT32_(0xF) << CRU_OSCCON_COSC_Pos)               /* (CRU_OSCCON) Current Oscillator Selection bits (Read-only) Mask */
#define CRU_OSCCON_COSC(value)                (CRU_OSCCON_COSC_Msk & (_UINT32_(value) << CRU_OSCCON_COSC_Pos)) /* Assigment of value for COSC in the CRU_OSCCON register */
#define   CRU_OSCCON_COSC_FRCDIV_Val          _UINT32_(0x0)                                        /* (CRU_OSCCON) Fast RC Oscillator (FRC) divided by OSCCON.FRCDIV (Supports FRC/16 and FRC/1)  */
#define   CRU_OSCCON_COSC_SPLL_Val            _UINT32_(0x1)                                        /* (CRU_OSCCON) System PLL (SPLL1 Module) (input clock and divider set by SPLLCON)  */
#define   CRU_OSCCON_COSC_POSC_Val            _UINT32_(0x2)                                        /* (CRU_OSCCON) Primary Oscillator- POSC  */
#define   CRU_OSCCON_COSC_SOSC_Val            _UINT32_(0x3)                                        /* (CRU_OSCCON) Secondary Oscillator (SOSC)  */
#define   CRU_OSCCON_COSC_LPRC_Val            _UINT32_(0x4)                                        /* (CRU_OSCCON) Low Power RC Oscillator (LPRC)  */
#define CRU_OSCCON_COSC_FRCDIV                (CRU_OSCCON_COSC_FRCDIV_Val << CRU_OSCCON_COSC_Pos)  /* (CRU_OSCCON) Fast RC Oscillator (FRC) divided by OSCCON.FRCDIV (Supports FRC/16 and FRC/1) Position  */
#define CRU_OSCCON_COSC_SPLL                  (CRU_OSCCON_COSC_SPLL_Val << CRU_OSCCON_COSC_Pos)    /* (CRU_OSCCON) System PLL (SPLL1 Module) (input clock and divider set by SPLLCON) Position  */
#define CRU_OSCCON_COSC_POSC                  (CRU_OSCCON_COSC_POSC_Val << CRU_OSCCON_COSC_Pos)    /* (CRU_OSCCON) Primary Oscillator- POSC Position  */
#define CRU_OSCCON_COSC_SOSC                  (CRU_OSCCON_COSC_SOSC_Val << CRU_OSCCON_COSC_Pos)    /* (CRU_OSCCON) Secondary Oscillator (SOSC) Position  */
#define CRU_OSCCON_COSC_LPRC                  (CRU_OSCCON_COSC_LPRC_Val << CRU_OSCCON_COSC_Pos)    /* (CRU_OSCCON) Low Power RC Oscillator (LPRC) Position  */
#define CRU_OSCCON_WAKE2SPD_Pos               _UINT32_(21)                                         /* (CRU_OSCCON) 2-Speed startup enabled in Sleep mode bit Position */
#define CRU_OSCCON_WAKE2SPD_Msk               (_UINT32_(0x1) << CRU_OSCCON_WAKE2SPD_Pos)           /* (CRU_OSCCON) 2-Speed startup enabled in Sleep mode bit Mask */
#define CRU_OSCCON_WAKE2SPD(value)            (CRU_OSCCON_WAKE2SPD_Msk & (_UINT32_(value) << CRU_OSCCON_WAKE2SPD_Pos)) /* Assigment of value for WAKE2SPD in the CRU_OSCCON register */
#define   CRU_OSCCON_WAKE2SPD_FRC_Val         _UINT32_(0x1)                                        /* (CRU_OSCCON) When the device EXITS Sleep Mode, the sys_clk will be from FRC until the selected clock is ready  */
#define   CRU_OSCCON_WAKE2SPD_SELECTED_CLK_Val _UINT32_(0x0)                                        /* (CRU_OSCCON) When the device EXITS Sleep Mode, the sys_clk will be from the selected clock.  */
#define CRU_OSCCON_WAKE2SPD_FRC               (CRU_OSCCON_WAKE2SPD_FRC_Val << CRU_OSCCON_WAKE2SPD_Pos) /* (CRU_OSCCON) When the device EXITS Sleep Mode, the sys_clk will be from FRC until the selected clock is ready Position  */
#define CRU_OSCCON_WAKE2SPD_SELECTED_CLK      (CRU_OSCCON_WAKE2SPD_SELECTED_CLK_Val << CRU_OSCCON_WAKE2SPD_Pos) /* (CRU_OSCCON) When the device EXITS Sleep Mode, the sys_clk will be from the selected clock. Position  */
#define CRU_OSCCON_DRMEN_Pos                  _UINT32_(23)                                         /* (CRU_OSCCON) Enable Dream Mode bit Position */
#define CRU_OSCCON_DRMEN_Msk                  (_UINT32_(0x1) << CRU_OSCCON_DRMEN_Pos)              /* (CRU_OSCCON) Enable Dream Mode bit Mask */
#define CRU_OSCCON_DRMEN(value)               (CRU_OSCCON_DRMEN_Msk & (_UINT32_(value) << CRU_OSCCON_DRMEN_Pos)) /* Assigment of value for DRMEN in the CRU_OSCCON register */
#define   CRU_OSCCON_DRMEN_SLEEP_Val          _UINT32_(0x1)                                        /* (CRU_OSCCON) When the cpu_si_sleep input is asserted and SLPEN = 1, DMA transfer complete causes SLEEP Mode to be entered  */
#define   CRU_OSCCON_DRMEN_NO_EFFECT_Val      _UINT32_(0x0)                                        /* (CRU_OSCCON) DMA transfer has no effect  */
#define CRU_OSCCON_DRMEN_SLEEP                (CRU_OSCCON_DRMEN_SLEEP_Val << CRU_OSCCON_DRMEN_Pos) /* (CRU_OSCCON) When the cpu_si_sleep input is asserted and SLPEN = 1, DMA transfer complete causes SLEEP Mode to be entered Position  */
#define CRU_OSCCON_DRMEN_NO_EFFECT            (CRU_OSCCON_DRMEN_NO_EFFECT_Val << CRU_OSCCON_DRMEN_Pos) /* (CRU_OSCCON) DMA transfer has no effect Position  */
#define CRU_OSCCON_FRCDIV_Pos                 _UINT32_(24)                                         /* (CRU_OSCCON) Fast RC Clock Divider bits Position */
#define CRU_OSCCON_FRCDIV_Msk                 (_UINT32_(0x7) << CRU_OSCCON_FRCDIV_Pos)             /* (CRU_OSCCON) Fast RC Clock Divider bits Mask */
#define CRU_OSCCON_FRCDIV(value)              (CRU_OSCCON_FRCDIV_Msk & (_UINT32_(value) << CRU_OSCCON_FRCDIV_Pos)) /* Assigment of value for FRCDIV in the CRU_OSCCON register */
#define   CRU_OSCCON_FRCDIV_DIV_1_Val         _UINT32_(0x0)                                        /* (CRU_OSCCON) FRC Divide by 1  */
#define   CRU_OSCCON_FRCDIV_DIV_2_Val         _UINT32_(0x1)                                        /* (CRU_OSCCON) FRC Divide by 2  */
#define   CRU_OSCCON_FRCDIV_DIV_4_Val         _UINT32_(0x2)                                        /* (CRU_OSCCON) FRC Divide by 4  */
#define   CRU_OSCCON_FRCDIV_DIV_8_Val         _UINT32_(0x3)                                        /* (CRU_OSCCON) FRC Divide by 8  */
#define   CRU_OSCCON_FRCDIV_DIV_16_Val        _UINT32_(0x4)                                        /* (CRU_OSCCON) FRC Divide by 16  */
#define   CRU_OSCCON_FRCDIV_DIV_32_Val        _UINT32_(0x5)                                        /* (CRU_OSCCON) FRC Divide by 32  */
#define   CRU_OSCCON_FRCDIV_DIV_64_Val        _UINT32_(0x6)                                        /* (CRU_OSCCON) FRC Divide by 64  */
#define   CRU_OSCCON_FRCDIV_DIV_256_Val       _UINT32_(0x7)                                        /* (CRU_OSCCON) FRC Divide by 256  */
#define CRU_OSCCON_FRCDIV_DIV_1               (CRU_OSCCON_FRCDIV_DIV_1_Val << CRU_OSCCON_FRCDIV_Pos) /* (CRU_OSCCON) FRC Divide by 1 Position  */
#define CRU_OSCCON_FRCDIV_DIV_2               (CRU_OSCCON_FRCDIV_DIV_2_Val << CRU_OSCCON_FRCDIV_Pos) /* (CRU_OSCCON) FRC Divide by 2 Position  */
#define CRU_OSCCON_FRCDIV_DIV_4               (CRU_OSCCON_FRCDIV_DIV_4_Val << CRU_OSCCON_FRCDIV_Pos) /* (CRU_OSCCON) FRC Divide by 4 Position  */
#define CRU_OSCCON_FRCDIV_DIV_8               (CRU_OSCCON_FRCDIV_DIV_8_Val << CRU_OSCCON_FRCDIV_Pos) /* (CRU_OSCCON) FRC Divide by 8 Position  */
#define CRU_OSCCON_FRCDIV_DIV_16              (CRU_OSCCON_FRCDIV_DIV_16_Val << CRU_OSCCON_FRCDIV_Pos) /* (CRU_OSCCON) FRC Divide by 16 Position  */
#define CRU_OSCCON_FRCDIV_DIV_32              (CRU_OSCCON_FRCDIV_DIV_32_Val << CRU_OSCCON_FRCDIV_Pos) /* (CRU_OSCCON) FRC Divide by 32 Position  */
#define CRU_OSCCON_FRCDIV_DIV_64              (CRU_OSCCON_FRCDIV_DIV_64_Val << CRU_OSCCON_FRCDIV_Pos) /* (CRU_OSCCON) FRC Divide by 64 Position  */
#define CRU_OSCCON_FRCDIV_DIV_256             (CRU_OSCCON_FRCDIV_DIV_256_Val << CRU_OSCCON_FRCDIV_Pos) /* (CRU_OSCCON) FRC Divide by 256 Position  */
#define CRU_OSCCON_Msk                        _UINT32_(0x07A0FF9B)                                 /* (CRU_OSCCON) Register Mask  */


/* -------- CRU_OSCCONCLR : (CRU Offset: 0x04) (R/W 32)  -------- */
#define CRU_OSCCONCLR_RESETVALUE              _UINT32_(0x00)                                       /*  (CRU_OSCCONCLR)   Reset Value */

#define CRU_OSCCONCLR_Msk                     _UINT32_(0x00000000)                                 /* (CRU_OSCCONCLR) Register Mask  */


/* -------- CRU_OSCCONSET : (CRU Offset: 0x08) (R/W 32)  -------- */
#define CRU_OSCCONSET_RESETVALUE              _UINT32_(0x00)                                       /*  (CRU_OSCCONSET)   Reset Value */

#define CRU_OSCCONSET_Msk                     _UINT32_(0x00000000)                                 /* (CRU_OSCCONSET) Register Mask  */


/* -------- CRU_OSCCONINV : (CRU Offset: 0x0C) (R/W 32)  -------- */
#define CRU_OSCCONINV_RESETVALUE              _UINT32_(0x00)                                       /*  (CRU_OSCCONINV)   Reset Value */

#define CRU_OSCCONINV_Msk                     _UINT32_(0x00000000)                                 /* (CRU_OSCCONINV) Register Mask  */


/* -------- CRU_OSCTUN : (CRU Offset: 0x10) (R/W 32) CRU OSCILLATOR TRIMMING REGISTER -------- */
#define CRU_OSCTUN_RESETVALUE                 _UINT32_(0x00)                                       /*  (CRU_OSCTUN) CRU OSCILLATOR TRIMMING REGISTER  Reset Value */

#define CRU_OSCTUN_TUN_Pos                    _UINT32_(0)                                          /* (CRU_OSCTUN) Internal Fast RC (FRC) Oscillator Tuning bits Position */
#define CRU_OSCTUN_TUN_Msk                    (_UINT32_(0x3F) << CRU_OSCTUN_TUN_Pos)               /* (CRU_OSCTUN) Internal Fast RC (FRC) Oscillator Tuning bits Mask */
#define CRU_OSCTUN_TUN(value)                 (CRU_OSCTUN_TUN_Msk & (_UINT32_(value) << CRU_OSCTUN_TUN_Pos)) /* Assigment of value for TUN in the CRU_OSCTUN register */
#define   CRU_OSCTUN_TUN_Max_Val              _UINT32_(0x1F)                                       /* (CRU_OSCTUN) Maximum Frequency  */
#define   CRU_OSCTUN_TUN_Center_Val           _UINT32_(0x0)                                        /* (CRU_OSCTUN) Center Frequency, oscillator is running at calibrated frequency  */
#define   CRU_OSCTUN_TUN_Min_Val              _UINT32_(0x20)                                       /* (CRU_OSCTUN) Minimum Frequency  */
#define CRU_OSCTUN_TUN_Max                    (CRU_OSCTUN_TUN_Max_Val << CRU_OSCTUN_TUN_Pos)       /* (CRU_OSCTUN) Maximum Frequency Position  */
#define CRU_OSCTUN_TUN_Center                 (CRU_OSCTUN_TUN_Center_Val << CRU_OSCTUN_TUN_Pos)    /* (CRU_OSCTUN) Center Frequency, oscillator is running at calibrated frequency Position  */
#define CRU_OSCTUN_TUN_Min                    (CRU_OSCTUN_TUN_Min_Val << CRU_OSCTUN_TUN_Pos)       /* (CRU_OSCTUN) Minimum Frequency Position  */
#define CRU_OSCTUN_Msk                        _UINT32_(0x0000003F)                                 /* (CRU_OSCTUN) Register Mask  */


/* -------- CRU_OSCTUNCLR : (CRU Offset: 0x14) (R/W 32)  -------- */
#define CRU_OSCTUNCLR_RESETVALUE              _UINT32_(0x00)                                       /*  (CRU_OSCTUNCLR)   Reset Value */

#define CRU_OSCTUNCLR_Msk                     _UINT32_(0x00000000)                                 /* (CRU_OSCTUNCLR) Register Mask  */


/* -------- CRU_OSCTUNSET : (CRU Offset: 0x18) (R/W 32)  -------- */
#define CRU_OSCTUNSET_RESETVALUE              _UINT32_(0x00)                                       /*  (CRU_OSCTUNSET)   Reset Value */

#define CRU_OSCTUNSET_Msk                     _UINT32_(0x00000000)                                 /* (CRU_OSCTUNSET) Register Mask  */


/* -------- CRU_OSCTUNINV : (CRU Offset: 0x1C) (R/W 32)  -------- */
#define CRU_OSCTUNINV_RESETVALUE              _UINT32_(0x00)                                       /*  (CRU_OSCTUNINV)   Reset Value */

#define CRU_OSCTUNINV_Msk                     _UINT32_(0x00000000)                                 /* (CRU_OSCTUNINV) Register Mask  */


/* -------- CRU_SPLLCON : (CRU Offset: 0x20) (R/W 32) SPLL CONTROL REGISTER -------- */
#define CRU_SPLLCON_RESETVALUE                _UINT32_(0xC0000108)                                 /*  (CRU_SPLLCON) SPLL CONTROL REGISTER  Reset Value */

#define CRU_SPLLCON_SPLLPWDN_Pos              _UINT32_(3)                                          /* (CRU_SPLLCON) PLL Power Down Register bit Position */
#define CRU_SPLLCON_SPLLPWDN_Msk              (_UINT32_(0x1) << CRU_SPLLCON_SPLLPWDN_Pos)          /* (CRU_SPLLCON) PLL Power Down Register bit Mask */
#define CRU_SPLLCON_SPLLPWDN(value)           (CRU_SPLLCON_SPLLPWDN_Msk & (_UINT32_(value) << CRU_SPLLCON_SPLLPWDN_Pos)) /* Assigment of value for SPLLPWDN in the CRU_SPLLCON register */
#define   CRU_SPLLCON_SPLLPWDN_PLL_OFF_Val    _UINT32_(0x1)                                        /* (CRU_SPLLCON) PLL is powered down  */
#define   CRU_SPLLCON_SPLLPWDN_PLL_ON_Val     _UINT32_(0x0)                                        /* (CRU_SPLLCON) PLL is active  */
#define CRU_SPLLCON_SPLLPWDN_PLL_OFF          (CRU_SPLLCON_SPLLPWDN_PLL_OFF_Val << CRU_SPLLCON_SPLLPWDN_Pos) /* (CRU_SPLLCON) PLL is powered down Position  */
#define CRU_SPLLCON_SPLLPWDN_PLL_ON           (CRU_SPLLCON_SPLLPWDN_PLL_ON_Val << CRU_SPLLCON_SPLLPWDN_Pos) /* (CRU_SPLLCON) PLL is active Position  */
#define CRU_SPLLCON_SPLLFLOCK_Pos             _UINT32_(4)                                          /* (CRU_SPLLCON) System PLL Force Lock Position */
#define CRU_SPLLCON_SPLLFLOCK_Msk             (_UINT32_(0x1) << CRU_SPLLCON_SPLLFLOCK_Pos)         /* (CRU_SPLLCON) System PLL Force Lock Mask */
#define CRU_SPLLCON_SPLLFLOCK(value)          (CRU_SPLLCON_SPLLFLOCK_Msk & (_UINT32_(value) << CRU_SPLLCON_SPLLFLOCK_Pos)) /* Assigment of value for SPLLFLOCK in the CRU_SPLLCON register */
#define   CRU_SPLLCON_SPLLFLOCK_ASSERT_Val    _UINT32_(0x1)                                        /* (CRU_SPLLCON) Force the SPLL lock signal to be asserted  */
#define   CRU_SPLLCON_SPLLFLOCK_NO_ASSERT_Val _UINT32_(0x0)                                        /* (CRU_SPLLCON) Do not force the SPLL lock signal to be asserted  */
#define CRU_SPLLCON_SPLLFLOCK_ASSERT          (CRU_SPLLCON_SPLLFLOCK_ASSERT_Val << CRU_SPLLCON_SPLLFLOCK_Pos) /* (CRU_SPLLCON) Force the SPLL lock signal to be asserted Position  */
#define CRU_SPLLCON_SPLLFLOCK_NO_ASSERT       (CRU_SPLLCON_SPLLFLOCK_NO_ASSERT_Val << CRU_SPLLCON_SPLLFLOCK_Pos) /* (CRU_SPLLCON) Do not force the SPLL lock signal to be asserted Position  */
#define CRU_SPLLCON_SPLLRST_Pos               _UINT32_(5)                                          /* (CRU_SPLLCON) System PLL Reset Position */
#define CRU_SPLLCON_SPLLRST_Msk               (_UINT32_(0x1) << CRU_SPLLCON_SPLLRST_Pos)           /* (CRU_SPLLCON) System PLL Reset Mask */
#define CRU_SPLLCON_SPLLRST(value)            (CRU_SPLLCON_SPLLRST_Msk & (_UINT32_(value) << CRU_SPLLCON_SPLLRST_Pos)) /* Assigment of value for SPLLRST in the CRU_SPLLCON register */
#define   CRU_SPLLCON_SPLLRST_ASSERT_Val      _UINT32_(0x1)                                        /* (CRU_SPLLCON) Assert the reset to the SPLL  */
#define   CRU_SPLLCON_SPLLRST_NO_ASSERT_Val   _UINT32_(0x0)                                        /* (CRU_SPLLCON) De-assert the reset to the SPLL  */
#define CRU_SPLLCON_SPLLRST_ASSERT            (CRU_SPLLCON_SPLLRST_ASSERT_Val << CRU_SPLLCON_SPLLRST_Pos) /* (CRU_SPLLCON) Assert the reset to the SPLL Position  */
#define CRU_SPLLCON_SPLLRST_NO_ASSERT         (CRU_SPLLCON_SPLLRST_NO_ASSERT_Val << CRU_SPLLCON_SPLLRST_Pos) /* (CRU_SPLLCON) De-assert the reset to the SPLL Position  */
#define CRU_SPLLCON_SPLLPOSTDIV1_Pos          _UINT32_(8)                                          /* (CRU_SPLLCON) SPLL Clock 1 Divide Value, 1 to 255 Position */
#define CRU_SPLLCON_SPLLPOSTDIV1_Msk          (_UINT32_(0xFF) << CRU_SPLLCON_SPLLPOSTDIV1_Pos)     /* (CRU_SPLLCON) SPLL Clock 1 Divide Value, 1 to 255 Mask */
#define CRU_SPLLCON_SPLLPOSTDIV1(value)       (CRU_SPLLCON_SPLLPOSTDIV1_Msk & (_UINT32_(value) << CRU_SPLLCON_SPLLPOSTDIV1_Pos)) /* Assigment of value for SPLLPOSTDIV1 in the CRU_SPLLCON register */
#define CRU_SPLLCON_SPLLPOSTDIV2_Pos          _UINT32_(16)                                         /* (CRU_SPLLCON) SPLL Clock 2 Divide Value, 1 to 15 Position */
#define CRU_SPLLCON_SPLLPOSTDIV2_Msk          (_UINT32_(0xF) << CRU_SPLLCON_SPLLPOSTDIV2_Pos)      /* (CRU_SPLLCON) SPLL Clock 2 Divide Value, 1 to 15 Mask */
#define CRU_SPLLCON_SPLLPOSTDIV2(value)       (CRU_SPLLCON_SPLLPOSTDIV2_Msk & (_UINT32_(value) << CRU_SPLLCON_SPLLPOSTDIV2_Pos)) /* Assigment of value for SPLLPOSTDIV2 in the CRU_SPLLCON register */
#define   CRU_SPLLCON_SPLLPOSTDIV2_DISABLE_Val _UINT32_(0x0)                                        /* (CRU_SPLLCON) Disable  */
#define   CRU_SPLLCON_SPLLPOSTDIV2_DIV_1_Val  _UINT32_(0x1)                                        /* (CRU_SPLLCON) Second post divide by 1  */
#define   CRU_SPLLCON_SPLLPOSTDIV2_DIV_2_Val  _UINT32_(0x2)                                        /* (CRU_SPLLCON) Second post divide by 2  */
#define   CRU_SPLLCON_SPLLPOSTDIV2_DIV_3_Val  _UINT32_(0x3)                                        /* (CRU_SPLLCON) Second post divide by 3  */
#define   CRU_SPLLCON_SPLLPOSTDIV2_DIV_4_Val  _UINT32_(0x4)                                        /* (CRU_SPLLCON) Second post divide by 4  */
#define   CRU_SPLLCON_SPLLPOSTDIV2_DIV_5_Val  _UINT32_(0x5)                                        /* (CRU_SPLLCON) Second post divide by 5  */
#define   CRU_SPLLCON_SPLLPOSTDIV2_DIV_6_Val  _UINT32_(0x6)                                        /* (CRU_SPLLCON) Second post divide by 6  */
#define   CRU_SPLLCON_SPLLPOSTDIV2_DIV_7_Val  _UINT32_(0x7)                                        /* (CRU_SPLLCON) Second post divide by 7  */
#define   CRU_SPLLCON_SPLLPOSTDIV2_DIV_8_Val  _UINT32_(0x8)                                        /* (CRU_SPLLCON) Second post divide by 8  */
#define   CRU_SPLLCON_SPLLPOSTDIV2_DIV_9_Val  _UINT32_(0x9)                                        /* (CRU_SPLLCON) Second post divide by 9  */
#define   CRU_SPLLCON_SPLLPOSTDIV2_DIV_10_Val _UINT32_(0xA)                                        /* (CRU_SPLLCON) Second post divide by 10  */
#define   CRU_SPLLCON_SPLLPOSTDIV2_DIV_11_Val _UINT32_(0xB)                                        /* (CRU_SPLLCON) Second post divide by 11  */
#define   CRU_SPLLCON_SPLLPOSTDIV2_DIV_12_Val _UINT32_(0xC)                                        /* (CRU_SPLLCON) Second post divide by 12  */
#define   CRU_SPLLCON_SPLLPOSTDIV2_DIV_13_Val _UINT32_(0xD)                                        /* (CRU_SPLLCON) Second post divide by 13  */
#define   CRU_SPLLCON_SPLLPOSTDIV2_DIV_14_Val _UINT32_(0xE)                                        /* (CRU_SPLLCON) Second post divide by 14  */
#define   CRU_SPLLCON_SPLLPOSTDIV2_DIV_15_Val _UINT32_(0xF)                                        /* (CRU_SPLLCON) Second post divide by 15  */
#define CRU_SPLLCON_SPLLPOSTDIV2_DISABLE      (CRU_SPLLCON_SPLLPOSTDIV2_DISABLE_Val << CRU_SPLLCON_SPLLPOSTDIV2_Pos) /* (CRU_SPLLCON) Disable Position  */
#define CRU_SPLLCON_SPLLPOSTDIV2_DIV_1        (CRU_SPLLCON_SPLLPOSTDIV2_DIV_1_Val << CRU_SPLLCON_SPLLPOSTDIV2_Pos) /* (CRU_SPLLCON) Second post divide by 1 Position  */
#define CRU_SPLLCON_SPLLPOSTDIV2_DIV_2        (CRU_SPLLCON_SPLLPOSTDIV2_DIV_2_Val << CRU_SPLLCON_SPLLPOSTDIV2_Pos) /* (CRU_SPLLCON) Second post divide by 2 Position  */
#define CRU_SPLLCON_SPLLPOSTDIV2_DIV_3        (CRU_SPLLCON_SPLLPOSTDIV2_DIV_3_Val << CRU_SPLLCON_SPLLPOSTDIV2_Pos) /* (CRU_SPLLCON) Second post divide by 3 Position  */
#define CRU_SPLLCON_SPLLPOSTDIV2_DIV_4        (CRU_SPLLCON_SPLLPOSTDIV2_DIV_4_Val << CRU_SPLLCON_SPLLPOSTDIV2_Pos) /* (CRU_SPLLCON) Second post divide by 4 Position  */
#define CRU_SPLLCON_SPLLPOSTDIV2_DIV_5        (CRU_SPLLCON_SPLLPOSTDIV2_DIV_5_Val << CRU_SPLLCON_SPLLPOSTDIV2_Pos) /* (CRU_SPLLCON) Second post divide by 5 Position  */
#define CRU_SPLLCON_SPLLPOSTDIV2_DIV_6        (CRU_SPLLCON_SPLLPOSTDIV2_DIV_6_Val << CRU_SPLLCON_SPLLPOSTDIV2_Pos) /* (CRU_SPLLCON) Second post divide by 6 Position  */
#define CRU_SPLLCON_SPLLPOSTDIV2_DIV_7        (CRU_SPLLCON_SPLLPOSTDIV2_DIV_7_Val << CRU_SPLLCON_SPLLPOSTDIV2_Pos) /* (CRU_SPLLCON) Second post divide by 7 Position  */
#define CRU_SPLLCON_SPLLPOSTDIV2_DIV_8        (CRU_SPLLCON_SPLLPOSTDIV2_DIV_8_Val << CRU_SPLLCON_SPLLPOSTDIV2_Pos) /* (CRU_SPLLCON) Second post divide by 8 Position  */
#define CRU_SPLLCON_SPLLPOSTDIV2_DIV_9        (CRU_SPLLCON_SPLLPOSTDIV2_DIV_9_Val << CRU_SPLLCON_SPLLPOSTDIV2_Pos) /* (CRU_SPLLCON) Second post divide by 9 Position  */
#define CRU_SPLLCON_SPLLPOSTDIV2_DIV_10       (CRU_SPLLCON_SPLLPOSTDIV2_DIV_10_Val << CRU_SPLLCON_SPLLPOSTDIV2_Pos) /* (CRU_SPLLCON) Second post divide by 10 Position  */
#define CRU_SPLLCON_SPLLPOSTDIV2_DIV_11       (CRU_SPLLCON_SPLLPOSTDIV2_DIV_11_Val << CRU_SPLLCON_SPLLPOSTDIV2_Pos) /* (CRU_SPLLCON) Second post divide by 11 Position  */
#define CRU_SPLLCON_SPLLPOSTDIV2_DIV_12       (CRU_SPLLCON_SPLLPOSTDIV2_DIV_12_Val << CRU_SPLLCON_SPLLPOSTDIV2_Pos) /* (CRU_SPLLCON) Second post divide by 12 Position  */
#define CRU_SPLLCON_SPLLPOSTDIV2_DIV_13       (CRU_SPLLCON_SPLLPOSTDIV2_DIV_13_Val << CRU_SPLLCON_SPLLPOSTDIV2_Pos) /* (CRU_SPLLCON) Second post divide by 13 Position  */
#define CRU_SPLLCON_SPLLPOSTDIV2_DIV_14       (CRU_SPLLCON_SPLLPOSTDIV2_DIV_14_Val << CRU_SPLLCON_SPLLPOSTDIV2_Pos) /* (CRU_SPLLCON) Second post divide by 14 Position  */
#define CRU_SPLLCON_SPLLPOSTDIV2_DIV_15       (CRU_SPLLCON_SPLLPOSTDIV2_DIV_15_Val << CRU_SPLLCON_SPLLPOSTDIV2_Pos) /* (CRU_SPLLCON) Second post divide by 15 Position  */
#define CRU_SPLLCON_SPLL_BYP_Pos              _UINT32_(30)                                         /* (CRU_SPLLCON) SPLL Clock 2 Source Position */
#define CRU_SPLLCON_SPLL_BYP_Msk              (_UINT32_(0x3) << CRU_SPLLCON_SPLL_BYP_Pos)          /* (CRU_SPLLCON) SPLL Clock 2 Source Mask */
#define CRU_SPLLCON_SPLL_BYP(value)           (CRU_SPLLCON_SPLL_BYP_Msk & (_UINT32_(value) << CRU_SPLLCON_SPLL_BYP_Pos)) /* Assigment of value for SPLL_BYP in the CRU_SPLLCON register */
#define   CRU_SPLLCON_SPLL_BYP_SPLL3_Val      _UINT32_(0x0)                                        /* (CRU_SPLLCON) SPLL3 (RFPLL) Clock is the clock source for ADC CP Clock Generation.  */
#define   CRU_SPLLCON_SPLL_BYP_FRC_Val        _UINT32_(0x3)                                        /* (CRU_SPLLCON) FRC is used as clock source for ADC CP Clock Generation.  */
#define   CRU_SPLLCON_SPLL_BYP_POSC_Val       _UINT32_(0x2)                                        /* (CRU_SPLLCON) POSC is used as clock source for ADC CP Clock Generation.  */
#define CRU_SPLLCON_SPLL_BYP_SPLL3            (CRU_SPLLCON_SPLL_BYP_SPLL3_Val << CRU_SPLLCON_SPLL_BYP_Pos) /* (CRU_SPLLCON) SPLL3 (RFPLL) Clock is the clock source for ADC CP Clock Generation. Position  */
#define CRU_SPLLCON_SPLL_BYP_FRC              (CRU_SPLLCON_SPLL_BYP_FRC_Val << CRU_SPLLCON_SPLL_BYP_Pos) /* (CRU_SPLLCON) FRC is used as clock source for ADC CP Clock Generation. Position  */
#define CRU_SPLLCON_SPLL_BYP_POSC             (CRU_SPLLCON_SPLL_BYP_POSC_Val << CRU_SPLLCON_SPLL_BYP_Pos) /* (CRU_SPLLCON) POSC is used as clock source for ADC CP Clock Generation. Position  */
#define CRU_SPLLCON_Msk                       _UINT32_(0xC00FFF38)                                 /* (CRU_SPLLCON) Register Mask  */


/* -------- CRU_SPLLCONCLR : (CRU Offset: 0x24) (R/W 32)  -------- */
#define CRU_SPLLCONCLR_RESETVALUE             _UINT32_(0x00)                                       /*  (CRU_SPLLCONCLR)   Reset Value */

#define CRU_SPLLCONCLR_Msk                    _UINT32_(0x00000000)                                 /* (CRU_SPLLCONCLR) Register Mask  */


/* -------- CRU_SPLLCONSET : (CRU Offset: 0x28) (R/W 32)  -------- */
#define CRU_SPLLCONSET_RESETVALUE             _UINT32_(0x00)                                       /*  (CRU_SPLLCONSET)   Reset Value */

#define CRU_SPLLCONSET_Msk                    _UINT32_(0x00000000)                                 /* (CRU_SPLLCONSET) Register Mask  */


/* -------- CRU_SPLLCONINV : (CRU Offset: 0x2C) (R/W 32)  -------- */
#define CRU_SPLLCONINV_RESETVALUE             _UINT32_(0x00)                                       /*  (CRU_SPLLCONINV)   Reset Value */

#define CRU_SPLLCONINV_Msk                    _UINT32_(0x00000000)                                 /* (CRU_SPLLCONINV) Register Mask  */


/* -------- CRU_REFO1CON : (CRU Offset: 0x70) (R/W 32) REFERENCE OSCILLATOR 1 CONTROL REGISTER -------- */
#define CRU_REFO1CON_RESETVALUE               _UINT32_(0x00)                                       /*  (CRU_REFO1CON) REFERENCE OSCILLATOR 1 CONTROL REGISTER  Reset Value */

#define CRU_REFO1CON_ROSEL_Pos                _UINT32_(0)                                          /* (CRU_REFO1CON) Reference Clock Source Select bits Position */
#define CRU_REFO1CON_ROSEL_Msk                (_UINT32_(0xF) << CRU_REFO1CON_ROSEL_Pos)            /* (CRU_REFO1CON) Reference Clock Source Select bits Mask */
#define CRU_REFO1CON_ROSEL(value)             (CRU_REFO1CON_ROSEL_Msk & (_UINT32_(value) << CRU_REFO1CON_ROSEL_Pos)) /* Assigment of value for ROSEL in the CRU_REFO1CON register */
#define   CRU_REFO1CON_ROSEL_REFCLKI_Val      _UINT32_(0x8)                                        /* (CRU_REFO1CON) REFI Pin  */
#define   CRU_REFO1CON_ROSEL_SYSCLK_Val       _UINT32_(0x7)                                        /* (CRU_REFO1CON) System clock (reference clock reflects any device clock switching)  */
#define   CRU_REFO1CON_ROSEL_PBCLK1_Val       _UINT32_(0x6)                                        /* (CRU_REFO1CON) Peripheral clock 1 (reference clock reflects any peripheral clock switching)  */
#define   CRU_REFO1CON_ROSEL_SPLL3_Val        _UINT32_(0x5)                                        /* (CRU_REFO1CON) System PLL3 (Clock-3)  */
#define   CRU_REFO1CON_ROSEL_LPRC_Val         _UINT32_(0x4)                                        /* (CRU_REFO1CON) LPRC  */
#define   CRU_REFO1CON_ROSEL_SOSC_Val         _UINT32_(0x3)                                        /* (CRU_REFO1CON) SOSC  */
#define   CRU_REFO1CON_ROSEL_POSC_Val         _UINT32_(0x2)                                        /* (CRU_REFO1CON) POSC  */
#define   CRU_REFO1CON_ROSEL_SPLL1_Val        _UINT32_(0x1)                                        /* (CRU_REFO1CON) System PLL1 (Clock-1)  */
#define   CRU_REFO1CON_ROSEL_FRC_Val          _UINT32_(0x0)                                        /* (CRU_REFO1CON) FRC  */
#define CRU_REFO1CON_ROSEL_REFCLKI            (CRU_REFO1CON_ROSEL_REFCLKI_Val << CRU_REFO1CON_ROSEL_Pos) /* (CRU_REFO1CON) REFI Pin Position  */
#define CRU_REFO1CON_ROSEL_SYSCLK             (CRU_REFO1CON_ROSEL_SYSCLK_Val << CRU_REFO1CON_ROSEL_Pos) /* (CRU_REFO1CON) System clock (reference clock reflects any device clock switching) Position  */
#define CRU_REFO1CON_ROSEL_PBCLK1             (CRU_REFO1CON_ROSEL_PBCLK1_Val << CRU_REFO1CON_ROSEL_Pos) /* (CRU_REFO1CON) Peripheral clock 1 (reference clock reflects any peripheral clock switching) Position  */
#define CRU_REFO1CON_ROSEL_SPLL3              (CRU_REFO1CON_ROSEL_SPLL3_Val << CRU_REFO1CON_ROSEL_Pos) /* (CRU_REFO1CON) System PLL3 (Clock-3) Position  */
#define CRU_REFO1CON_ROSEL_LPRC               (CRU_REFO1CON_ROSEL_LPRC_Val << CRU_REFO1CON_ROSEL_Pos) /* (CRU_REFO1CON) LPRC Position  */
#define CRU_REFO1CON_ROSEL_SOSC               (CRU_REFO1CON_ROSEL_SOSC_Val << CRU_REFO1CON_ROSEL_Pos) /* (CRU_REFO1CON) SOSC Position  */
#define CRU_REFO1CON_ROSEL_POSC               (CRU_REFO1CON_ROSEL_POSC_Val << CRU_REFO1CON_ROSEL_Pos) /* (CRU_REFO1CON) POSC Position  */
#define CRU_REFO1CON_ROSEL_SPLL1              (CRU_REFO1CON_ROSEL_SPLL1_Val << CRU_REFO1CON_ROSEL_Pos) /* (CRU_REFO1CON) System PLL1 (Clock-1) Position  */
#define CRU_REFO1CON_ROSEL_FRC                (CRU_REFO1CON_ROSEL_FRC_Val << CRU_REFO1CON_ROSEL_Pos) /* (CRU_REFO1CON) FRC Position  */
#define CRU_REFO1CON_ACTIVE_Pos               _UINT32_(8)                                          /* (CRU_REFO1CON) Reference Clock Request Status bit Position */
#define CRU_REFO1CON_ACTIVE_Msk               (_UINT32_(0x1) << CRU_REFO1CON_ACTIVE_Pos)           /* (CRU_REFO1CON) Reference Clock Request Status bit Mask */
#define CRU_REFO1CON_ACTIVE(value)            (CRU_REFO1CON_ACTIVE_Msk & (_UINT32_(value) << CRU_REFO1CON_ACTIVE_Pos)) /* Assigment of value for ACTIVE in the CRU_REFO1CON register */
#define   CRU_REFO1CON_ACTIVE_ACTIVE_Val      _UINT32_(0x1)                                        /* (CRU_REFO1CON) Reference clock request is active (User should not update this REFOCON register)  */
#define   CRU_REFO1CON_ACTIVE_NOT_ACTIVE_Val  _UINT32_(0x0)                                        /* (CRU_REFO1CON) Reference clock request is not active (User can update this REFOCON register)  */
#define CRU_REFO1CON_ACTIVE_ACTIVE            (CRU_REFO1CON_ACTIVE_ACTIVE_Val << CRU_REFO1CON_ACTIVE_Pos) /* (CRU_REFO1CON) Reference clock request is active (User should not update this REFOCON register) Position  */
#define CRU_REFO1CON_ACTIVE_NOT_ACTIVE        (CRU_REFO1CON_ACTIVE_NOT_ACTIVE_Val << CRU_REFO1CON_ACTIVE_Pos) /* (CRU_REFO1CON) Reference clock request is not active (User can update this REFOCON register) Position  */
#define CRU_REFO1CON_DIVSWEN_Pos              _UINT32_(9)                                          /* (CRU_REFO1CON) Clock RODIV/ROTRIM switch enabled. Position */
#define CRU_REFO1CON_DIVSWEN_Msk              (_UINT32_(0x1) << CRU_REFO1CON_DIVSWEN_Pos)          /* (CRU_REFO1CON) Clock RODIV/ROTRIM switch enabled. Mask */
#define CRU_REFO1CON_DIVSWEN(value)           (CRU_REFO1CON_DIVSWEN_Msk & (_UINT32_(value) << CRU_REFO1CON_DIVSWEN_Pos)) /* Assigment of value for DIVSWEN in the CRU_REFO1CON register */
#define   CRU_REFO1CON_DIVSWEN_SWINPROGRESS_Val _UINT32_(0x1)                                        /* (CRU_REFO1CON) Clock Divider Switching currently in progress.  */
#define   CRU_REFO1CON_DIVSWEN_SWCOMPLETE_Val _UINT32_(0x0)                                        /* (CRU_REFO1CON) Clock Divider Switch has completed.  */
#define CRU_REFO1CON_DIVSWEN_SWINPROGRESS     (CRU_REFO1CON_DIVSWEN_SWINPROGRESS_Val << CRU_REFO1CON_DIVSWEN_Pos) /* (CRU_REFO1CON) Clock Divider Switching currently in progress. Position  */
#define CRU_REFO1CON_DIVSWEN_SWCOMPLETE       (CRU_REFO1CON_DIVSWEN_SWCOMPLETE_Val << CRU_REFO1CON_DIVSWEN_Pos) /* (CRU_REFO1CON) Clock Divider Switch has completed. Position  */
#define CRU_REFO1CON_RSLP_Pos                 _UINT32_(11)                                         /* (CRU_REFO1CON) Reference Oscillator Run in Sleep bit Position */
#define CRU_REFO1CON_RSLP_Msk                 (_UINT32_(0x1) << CRU_REFO1CON_RSLP_Pos)             /* (CRU_REFO1CON) Reference Oscillator Run in Sleep bit Mask */
#define CRU_REFO1CON_RSLP(value)              (CRU_REFO1CON_RSLP_Msk & (_UINT32_(value) << CRU_REFO1CON_RSLP_Pos)) /* Assigment of value for RSLP in the CRU_REFO1CON register */
#define   CRU_REFO1CON_RSLP_RSLP_Val          _UINT32_(0x1)                                        /* (CRU_REFO1CON) Reference Oscillator output continues to run in Sleep  */
#define   CRU_REFO1CON_RSLP_NO_RSLP_Val       _UINT32_(0x0)                                        /* (CRU_REFO1CON) Reference Oscillator output is disabled in Sleep  */
#define CRU_REFO1CON_RSLP_RSLP                (CRU_REFO1CON_RSLP_RSLP_Val << CRU_REFO1CON_RSLP_Pos) /* (CRU_REFO1CON) Reference Oscillator output continues to run in Sleep Position  */
#define CRU_REFO1CON_RSLP_NO_RSLP             (CRU_REFO1CON_RSLP_NO_RSLP_Val << CRU_REFO1CON_RSLP_Pos) /* (CRU_REFO1CON) Reference Oscillator output is disabled in Sleep Position  */
#define CRU_REFO1CON_OE_Pos                   _UINT32_(12)                                         /* (CRU_REFO1CON) Reference Clock Output Enable bit Position */
#define CRU_REFO1CON_OE_Msk                   (_UINT32_(0x1) << CRU_REFO1CON_OE_Pos)               /* (CRU_REFO1CON) Reference Clock Output Enable bit Mask */
#define CRU_REFO1CON_OE(value)                (CRU_REFO1CON_OE_Msk & (_UINT32_(value) << CRU_REFO1CON_OE_Pos)) /* Assigment of value for OE in the CRU_REFO1CON register */
#define   CRU_REFO1CON_OE_REFO1_OE_Val        _UINT32_(0x1)                                        /* (CRU_REFO1CON) Reference clock is driven out on REFO1 pin  */
#define   CRU_REFO1CON_OE_NO_REFO1_OE_Val     _UINT32_(0x0)                                        /* (CRU_REFO1CON) Reference clock is not driven out on REFO1 pin.  */
#define CRU_REFO1CON_OE_REFO1_OE              (CRU_REFO1CON_OE_REFO1_OE_Val << CRU_REFO1CON_OE_Pos) /* (CRU_REFO1CON) Reference clock is driven out on REFO1 pin Position  */
#define CRU_REFO1CON_OE_NO_REFO1_OE           (CRU_REFO1CON_OE_NO_REFO1_OE_Val << CRU_REFO1CON_OE_Pos) /* (CRU_REFO1CON) Reference clock is not driven out on REFO1 pin. Position  */
#define CRU_REFO1CON_SIDL_Pos                 _UINT32_(13)                                         /* (CRU_REFO1CON) Peripheral Stop in Idle Mode bit Position */
#define CRU_REFO1CON_SIDL_Msk                 (_UINT32_(0x1) << CRU_REFO1CON_SIDL_Pos)             /* (CRU_REFO1CON) Peripheral Stop in Idle Mode bit Mask */
#define CRU_REFO1CON_SIDL(value)              (CRU_REFO1CON_SIDL_Msk & (_UINT32_(value) << CRU_REFO1CON_SIDL_Pos)) /* Assigment of value for SIDL in the CRU_REFO1CON register */
#define   CRU_REFO1CON_SIDL_SIDL_Val          _UINT32_(0x1)                                        /* (CRU_REFO1CON) Discontinue module operation when device enters Idle mode  */
#define   CRU_REFO1CON_SIDL_NO_SIDL_Val       _UINT32_(0x0)                                        /* (CRU_REFO1CON) Continue module operation in Idle mode  */
#define CRU_REFO1CON_SIDL_SIDL                (CRU_REFO1CON_SIDL_SIDL_Val << CRU_REFO1CON_SIDL_Pos) /* (CRU_REFO1CON) Discontinue module operation when device enters Idle mode Position  */
#define CRU_REFO1CON_SIDL_NO_SIDL             (CRU_REFO1CON_SIDL_NO_SIDL_Val << CRU_REFO1CON_SIDL_Pos) /* (CRU_REFO1CON) Continue module operation in Idle mode Position  */
#define CRU_REFO1CON_FRZ_Pos                  _UINT32_(14)                                         /* (CRU_REFO1CON) Freeze in Debug mode bit Position */
#define CRU_REFO1CON_FRZ_Msk                  (_UINT32_(0x1) << CRU_REFO1CON_FRZ_Pos)              /* (CRU_REFO1CON) Freeze in Debug mode bit Mask */
#define CRU_REFO1CON_FRZ(value)               (CRU_REFO1CON_FRZ_Msk & (_UINT32_(value) << CRU_REFO1CON_FRZ_Pos)) /* Assigment of value for FRZ in the CRU_REFO1CON register */
#define   CRU_REFO1CON_FRZ_FRZ_Val            _UINT32_(0x1)                                        /* (CRU_REFO1CON) When emulator is in Debug mode, module freezes operation  */
#define   CRU_REFO1CON_FRZ_NO_FRZ_Val         _UINT32_(0x0)                                        /* (CRU_REFO1CON) When emulator is in Debug mode, module continues operation  */
#define CRU_REFO1CON_FRZ_FRZ                  (CRU_REFO1CON_FRZ_FRZ_Val << CRU_REFO1CON_FRZ_Pos)   /* (CRU_REFO1CON) When emulator is in Debug mode, module freezes operation Position  */
#define CRU_REFO1CON_FRZ_NO_FRZ               (CRU_REFO1CON_FRZ_NO_FRZ_Val << CRU_REFO1CON_FRZ_Pos) /* (CRU_REFO1CON) When emulator is in Debug mode, module continues operation Position  */
#define CRU_REFO1CON_ON_Pos                   _UINT32_(15)                                         /* (CRU_REFO1CON) Output Enable bit Position */
#define CRU_REFO1CON_ON_Msk                   (_UINT32_(0x1) << CRU_REFO1CON_ON_Pos)               /* (CRU_REFO1CON) Output Enable bit Mask */
#define CRU_REFO1CON_ON(value)                (CRU_REFO1CON_ON_Msk & (_UINT32_(value) << CRU_REFO1CON_ON_Pos)) /* Assigment of value for ON in the CRU_REFO1CON register */
#define   CRU_REFO1CON_ON_ON_Val              _UINT32_(0x1)                                        /* (CRU_REFO1CON) Reference Oscillator Module enabled  */
#define   CRU_REFO1CON_ON_OFF_Val             _UINT32_(0x0)                                        /* (CRU_REFO1CON) Reference Oscillator Module disabled  */
#define CRU_REFO1CON_ON_ON                    (CRU_REFO1CON_ON_ON_Val << CRU_REFO1CON_ON_Pos)      /* (CRU_REFO1CON) Reference Oscillator Module enabled Position  */
#define CRU_REFO1CON_ON_OFF                   (CRU_REFO1CON_ON_OFF_Val << CRU_REFO1CON_ON_Pos)     /* (CRU_REFO1CON) Reference Oscillator Module disabled Position  */
#define CRU_REFO1CON_RODIV_Pos                _UINT32_(16)                                         /* (CRU_REFO1CON) Reference Clock Divider bits Position */
#define CRU_REFO1CON_RODIV_Msk                (_UINT32_(0x7FFF) << CRU_REFO1CON_RODIV_Pos)         /* (CRU_REFO1CON) Reference Clock Divider bits Mask */
#define CRU_REFO1CON_RODIV(value)             (CRU_REFO1CON_RODIV_Msk & (_UINT32_(value) << CRU_REFO1CON_RODIV_Pos)) /* Assigment of value for RODIV in the CRU_REFO1CON register */
#define   CRU_REFO1CON_RODIV_65K_Val          _UINT32_(0x7FFF)                                     /* (CRU_REFO1CON) REFO1 clock is Base clock frequency divided by 65,534 (32,767 *2)  */
#define   CRU_REFO1CON_RODIV_4_Val            _UINT32_(0x2)                                        /* (CRU_REFO1CON) REFO1 clock is Base clock frequency divided by 4 (2*2)  */
#define   CRU_REFO1CON_RODIV_2_Val            _UINT32_(0x1)                                        /* (CRU_REFO1CON) REFO1 clock is Base clock frequency divided by 2 (1*2)  */
#define   CRU_REFO1CON_RODIV_NONE_Val         _UINT32_(0x0)                                        /* (CRU_REFO1CON) REFO1 clock is same frequency as Base clock (no divider)  */
#define CRU_REFO1CON_RODIV_65K                (CRU_REFO1CON_RODIV_65K_Val << CRU_REFO1CON_RODIV_Pos) /* (CRU_REFO1CON) REFO1 clock is Base clock frequency divided by 65,534 (32,767 *2) Position  */
#define CRU_REFO1CON_RODIV_4                  (CRU_REFO1CON_RODIV_4_Val << CRU_REFO1CON_RODIV_Pos) /* (CRU_REFO1CON) REFO1 clock is Base clock frequency divided by 4 (2*2) Position  */
#define CRU_REFO1CON_RODIV_2                  (CRU_REFO1CON_RODIV_2_Val << CRU_REFO1CON_RODIV_Pos) /* (CRU_REFO1CON) REFO1 clock is Base clock frequency divided by 2 (1*2) Position  */
#define CRU_REFO1CON_RODIV_NONE               (CRU_REFO1CON_RODIV_NONE_Val << CRU_REFO1CON_RODIV_Pos) /* (CRU_REFO1CON) REFO1 clock is same frequency as Base clock (no divider) Position  */
#define CRU_REFO1CON_Msk                      _UINT32_(0x7FFFFB0F)                                 /* (CRU_REFO1CON) Register Mask  */


/* -------- CRU_REFO1CONCLR : (CRU Offset: 0x74) (R/W 32)  -------- */
#define CRU_REFO1CONCLR_RESETVALUE            _UINT32_(0x00)                                       /*  (CRU_REFO1CONCLR)   Reset Value */

#define CRU_REFO1CONCLR_Msk                   _UINT32_(0x00000000)                                 /* (CRU_REFO1CONCLR) Register Mask  */


/* -------- CRU_REFO1CONSET : (CRU Offset: 0x78) (R/W 32)  -------- */
#define CRU_REFO1CONSET_RESETVALUE            _UINT32_(0x00)                                       /*  (CRU_REFO1CONSET)   Reset Value */

#define CRU_REFO1CONSET_Msk                   _UINT32_(0x00000000)                                 /* (CRU_REFO1CONSET) Register Mask  */


/* -------- CRU_REFO1CONINV : (CRU Offset: 0x7C) (R/W 32)  -------- */
#define CRU_REFO1CONINV_RESETVALUE            _UINT32_(0x00)                                       /*  (CRU_REFO1CONINV)   Reset Value */

#define CRU_REFO1CONINV_Msk                   _UINT32_(0x00000000)                                 /* (CRU_REFO1CONINV) Register Mask  */


/* -------- CRU_REFO1TRIM : (CRU Offset: 0x80) (R/W 32) REFERENCE OSCILLATOR 1 TRIM REGISTER -------- */
#define CRU_REFO1TRIM_RESETVALUE              _UINT32_(0x00)                                       /*  (CRU_REFO1TRIM) REFERENCE OSCILLATOR 1 TRIM REGISTER  Reset Value */

#define CRU_REFO1TRIM_ROTRIM_Pos              _UINT32_(23)                                         /* (CRU_REFO1TRIM) Trim bits - Provides fractional additive to RODIV value for 1/2 period of REFO1 clock Position */
#define CRU_REFO1TRIM_ROTRIM_Msk              (_UINT32_(0x1FF) << CRU_REFO1TRIM_ROTRIM_Pos)        /* (CRU_REFO1TRIM) Trim bits - Provides fractional additive to RODIV value for 1/2 period of REFO1 clock Mask */
#define CRU_REFO1TRIM_ROTRIM(value)           (CRU_REFO1TRIM_ROTRIM_Msk & (_UINT32_(value) << CRU_REFO1TRIM_ROTRIM_Pos)) /* Assigment of value for ROTRIM in the CRU_REFO1TRIM register */
#define   CRU_REFO1TRIM_ROTRIM_ZERO_Val       _UINT32_(0x0)                                        /* (CRU_REFO1TRIM) 0/512 (0.0) divisor added to RODIV value  */
#define   CRU_REFO1TRIM_ROTRIM_1_Val          _UINT32_(0x1)                                        /* (CRU_REFO1TRIM) 1/512 (0.001953125) divisor added to RODIV value  */
#define   CRU_REFO1TRIM_ROTRIM_2_Val          _UINT32_(0x2)                                        /* (CRU_REFO1TRIM) 2/512 (0.00390625) divisor added to RODIV value  */
#define   CRU_REFO1TRIM_ROTRIM_256_Val        _UINT32_(0x100)                                      /* (CRU_REFO1TRIM) 256/512 (0.5000) divisor added to RODIV value  */
#define   CRU_REFO1TRIM_ROTRIM_511_Val        _UINT32_(0x1FF)                                      /* (CRU_REFO1TRIM) 511/512 (0.998046875) divisor added to RODIV value  */
#define CRU_REFO1TRIM_ROTRIM_ZERO             (CRU_REFO1TRIM_ROTRIM_ZERO_Val << CRU_REFO1TRIM_ROTRIM_Pos) /* (CRU_REFO1TRIM) 0/512 (0.0) divisor added to RODIV value Position  */
#define CRU_REFO1TRIM_ROTRIM_1                (CRU_REFO1TRIM_ROTRIM_1_Val << CRU_REFO1TRIM_ROTRIM_Pos) /* (CRU_REFO1TRIM) 1/512 (0.001953125) divisor added to RODIV value Position  */
#define CRU_REFO1TRIM_ROTRIM_2                (CRU_REFO1TRIM_ROTRIM_2_Val << CRU_REFO1TRIM_ROTRIM_Pos) /* (CRU_REFO1TRIM) 2/512 (0.00390625) divisor added to RODIV value Position  */
#define CRU_REFO1TRIM_ROTRIM_256              (CRU_REFO1TRIM_ROTRIM_256_Val << CRU_REFO1TRIM_ROTRIM_Pos) /* (CRU_REFO1TRIM) 256/512 (0.5000) divisor added to RODIV value Position  */
#define CRU_REFO1TRIM_ROTRIM_511              (CRU_REFO1TRIM_ROTRIM_511_Val << CRU_REFO1TRIM_ROTRIM_Pos) /* (CRU_REFO1TRIM) 511/512 (0.998046875) divisor added to RODIV value Position  */
#define CRU_REFO1TRIM_Msk                     _UINT32_(0xFF800000)                                 /* (CRU_REFO1TRIM) Register Mask  */


/* -------- CRU_REFO1TRIMCLR : (CRU Offset: 0x84) (R/W 32)  -------- */
#define CRU_REFO1TRIMCLR_RESETVALUE           _UINT32_(0x00)                                       /*  (CRU_REFO1TRIMCLR)   Reset Value */

#define CRU_REFO1TRIMCLR_Msk                  _UINT32_(0x00000000)                                 /* (CRU_REFO1TRIMCLR) Register Mask  */


/* -------- CRU_REFO1TRIMSET : (CRU Offset: 0x88) (R/W 32)  -------- */
#define CRU_REFO1TRIMSET_RESETVALUE           _UINT32_(0x00)                                       /*  (CRU_REFO1TRIMSET)   Reset Value */

#define CRU_REFO1TRIMSET_Msk                  _UINT32_(0x00000000)                                 /* (CRU_REFO1TRIMSET) Register Mask  */


/* -------- CRU_REFO1TRIMINV : (CRU Offset: 0x8C) (R/W 32)  -------- */
#define CRU_REFO1TRIMINV_RESETVALUE           _UINT32_(0x00)                                       /*  (CRU_REFO1TRIMINV)   Reset Value */

#define CRU_REFO1TRIMINV_Msk                  _UINT32_(0x00000000)                                 /* (CRU_REFO1TRIMINV) Register Mask  */


/* -------- CRU_REFO2CON : (CRU Offset: 0x90) (R/W 32) REFERENCE OSCILLATOR 2 CONTROL REGISTER -------- */
#define CRU_REFO2CON_RESETVALUE               _UINT32_(0x00)                                       /*  (CRU_REFO2CON) REFERENCE OSCILLATOR 2 CONTROL REGISTER  Reset Value */

#define CRU_REFO2CON_ROSEL_Pos                _UINT32_(0)                                          /* (CRU_REFO2CON) Reference Clock Source Select bits Position */
#define CRU_REFO2CON_ROSEL_Msk                (_UINT32_(0xF) << CRU_REFO2CON_ROSEL_Pos)            /* (CRU_REFO2CON) Reference Clock Source Select bits Mask */
#define CRU_REFO2CON_ROSEL(value)             (CRU_REFO2CON_ROSEL_Msk & (_UINT32_(value) << CRU_REFO2CON_ROSEL_Pos)) /* Assigment of value for ROSEL in the CRU_REFO2CON register */
#define   CRU_REFO2CON_ROSEL_REFCLKI_Val      _UINT32_(0x8)                                        /* (CRU_REFO2CON) REFI Pin  */
#define   CRU_REFO2CON_ROSEL_SYSCLK_Val       _UINT32_(0x7)                                        /* (CRU_REFO2CON) System clock (reference clock reflects any device clock switching)  */
#define   CRU_REFO2CON_ROSEL_PBCLK1_Val       _UINT32_(0x6)                                        /* (CRU_REFO2CON) Peripheral clock 1 (reference clock reflects any peripheral clock switching)  */
#define   CRU_REFO2CON_ROSEL_SPLL3_Val        _UINT32_(0x5)                                        /* (CRU_REFO2CON) System PLL3 (Clock-3)  */
#define   CRU_REFO2CON_ROSEL_LPRC_Val         _UINT32_(0x4)                                        /* (CRU_REFO2CON) LPRC  */
#define   CRU_REFO2CON_ROSEL_SOSC_Val         _UINT32_(0x3)                                        /* (CRU_REFO2CON) SOSC  */
#define   CRU_REFO2CON_ROSEL_POSC_Val         _UINT32_(0x2)                                        /* (CRU_REFO2CON) POSC  */
#define   CRU_REFO2CON_ROSEL_SPLL1_Val        _UINT32_(0x1)                                        /* (CRU_REFO2CON) System PLL1 (Clock-1)  */
#define   CRU_REFO2CON_ROSEL_FRC_Val          _UINT32_(0x0)                                        /* (CRU_REFO2CON) FRC  */
#define CRU_REFO2CON_ROSEL_REFCLKI            (CRU_REFO2CON_ROSEL_REFCLKI_Val << CRU_REFO2CON_ROSEL_Pos) /* (CRU_REFO2CON) REFI Pin Position  */
#define CRU_REFO2CON_ROSEL_SYSCLK             (CRU_REFO2CON_ROSEL_SYSCLK_Val << CRU_REFO2CON_ROSEL_Pos) /* (CRU_REFO2CON) System clock (reference clock reflects any device clock switching) Position  */
#define CRU_REFO2CON_ROSEL_PBCLK1             (CRU_REFO2CON_ROSEL_PBCLK1_Val << CRU_REFO2CON_ROSEL_Pos) /* (CRU_REFO2CON) Peripheral clock 1 (reference clock reflects any peripheral clock switching) Position  */
#define CRU_REFO2CON_ROSEL_SPLL3              (CRU_REFO2CON_ROSEL_SPLL3_Val << CRU_REFO2CON_ROSEL_Pos) /* (CRU_REFO2CON) System PLL3 (Clock-3) Position  */
#define CRU_REFO2CON_ROSEL_LPRC               (CRU_REFO2CON_ROSEL_LPRC_Val << CRU_REFO2CON_ROSEL_Pos) /* (CRU_REFO2CON) LPRC Position  */
#define CRU_REFO2CON_ROSEL_SOSC               (CRU_REFO2CON_ROSEL_SOSC_Val << CRU_REFO2CON_ROSEL_Pos) /* (CRU_REFO2CON) SOSC Position  */
#define CRU_REFO2CON_ROSEL_POSC               (CRU_REFO2CON_ROSEL_POSC_Val << CRU_REFO2CON_ROSEL_Pos) /* (CRU_REFO2CON) POSC Position  */
#define CRU_REFO2CON_ROSEL_SPLL1              (CRU_REFO2CON_ROSEL_SPLL1_Val << CRU_REFO2CON_ROSEL_Pos) /* (CRU_REFO2CON) System PLL1 (Clock-1) Position  */
#define CRU_REFO2CON_ROSEL_FRC                (CRU_REFO2CON_ROSEL_FRC_Val << CRU_REFO2CON_ROSEL_Pos) /* (CRU_REFO2CON) FRC Position  */
#define CRU_REFO2CON_ACTIVE_Pos               _UINT32_(8)                                          /* (CRU_REFO2CON) Reference Clock Request Status bit Position */
#define CRU_REFO2CON_ACTIVE_Msk               (_UINT32_(0x1) << CRU_REFO2CON_ACTIVE_Pos)           /* (CRU_REFO2CON) Reference Clock Request Status bit Mask */
#define CRU_REFO2CON_ACTIVE(value)            (CRU_REFO2CON_ACTIVE_Msk & (_UINT32_(value) << CRU_REFO2CON_ACTIVE_Pos)) /* Assigment of value for ACTIVE in the CRU_REFO2CON register */
#define   CRU_REFO2CON_ACTIVE_ACTIVE_Val      _UINT32_(0x1)                                        /* (CRU_REFO2CON) Reference clock request is active (User should not update this REFOCON register)  */
#define   CRU_REFO2CON_ACTIVE_NOT_ACTIVE_Val  _UINT32_(0x0)                                        /* (CRU_REFO2CON) Reference clock request is not active (User can update this REFOCON register)  */
#define CRU_REFO2CON_ACTIVE_ACTIVE            (CRU_REFO2CON_ACTIVE_ACTIVE_Val << CRU_REFO2CON_ACTIVE_Pos) /* (CRU_REFO2CON) Reference clock request is active (User should not update this REFOCON register) Position  */
#define CRU_REFO2CON_ACTIVE_NOT_ACTIVE        (CRU_REFO2CON_ACTIVE_NOT_ACTIVE_Val << CRU_REFO2CON_ACTIVE_Pos) /* (CRU_REFO2CON) Reference clock request is not active (User can update this REFOCON register) Position  */
#define CRU_REFO2CON_DIVSWEN_Pos              _UINT32_(9)                                          /* (CRU_REFO2CON) Clock RODIV/ROTRIM switch enabled. Position */
#define CRU_REFO2CON_DIVSWEN_Msk              (_UINT32_(0x1) << CRU_REFO2CON_DIVSWEN_Pos)          /* (CRU_REFO2CON) Clock RODIV/ROTRIM switch enabled. Mask */
#define CRU_REFO2CON_DIVSWEN(value)           (CRU_REFO2CON_DIVSWEN_Msk & (_UINT32_(value) << CRU_REFO2CON_DIVSWEN_Pos)) /* Assigment of value for DIVSWEN in the CRU_REFO2CON register */
#define   CRU_REFO2CON_DIVSWEN_SWINPROGRESS_Val _UINT32_(0x1)                                        /* (CRU_REFO2CON) Clock Divider Switching currently in progress.  */
#define   CRU_REFO2CON_DIVSWEN_SWCOMPLETE_Val _UINT32_(0x0)                                        /* (CRU_REFO2CON) Clock Divider Switch has completed.  */
#define CRU_REFO2CON_DIVSWEN_SWINPROGRESS     (CRU_REFO2CON_DIVSWEN_SWINPROGRESS_Val << CRU_REFO2CON_DIVSWEN_Pos) /* (CRU_REFO2CON) Clock Divider Switching currently in progress. Position  */
#define CRU_REFO2CON_DIVSWEN_SWCOMPLETE       (CRU_REFO2CON_DIVSWEN_SWCOMPLETE_Val << CRU_REFO2CON_DIVSWEN_Pos) /* (CRU_REFO2CON) Clock Divider Switch has completed. Position  */
#define CRU_REFO2CON_RSLP_Pos                 _UINT32_(11)                                         /* (CRU_REFO2CON) Reference Oscillator Run in Sleep bit Position */
#define CRU_REFO2CON_RSLP_Msk                 (_UINT32_(0x1) << CRU_REFO2CON_RSLP_Pos)             /* (CRU_REFO2CON) Reference Oscillator Run in Sleep bit Mask */
#define CRU_REFO2CON_RSLP(value)              (CRU_REFO2CON_RSLP_Msk & (_UINT32_(value) << CRU_REFO2CON_RSLP_Pos)) /* Assigment of value for RSLP in the CRU_REFO2CON register */
#define   CRU_REFO2CON_RSLP_RSLP_Val          _UINT32_(0x1)                                        /* (CRU_REFO2CON) Reference Oscillator output continues to run in Sleep  */
#define   CRU_REFO2CON_RSLP_NO_RSLP_Val       _UINT32_(0x0)                                        /* (CRU_REFO2CON) Reference Oscillator output is disabled in Sleep  */
#define CRU_REFO2CON_RSLP_RSLP                (CRU_REFO2CON_RSLP_RSLP_Val << CRU_REFO2CON_RSLP_Pos) /* (CRU_REFO2CON) Reference Oscillator output continues to run in Sleep Position  */
#define CRU_REFO2CON_RSLP_NO_RSLP             (CRU_REFO2CON_RSLP_NO_RSLP_Val << CRU_REFO2CON_RSLP_Pos) /* (CRU_REFO2CON) Reference Oscillator output is disabled in Sleep Position  */
#define CRU_REFO2CON_OE_Pos                   _UINT32_(12)                                         /* (CRU_REFO2CON) Reference Clock Output Enable bit Position */
#define CRU_REFO2CON_OE_Msk                   (_UINT32_(0x1) << CRU_REFO2CON_OE_Pos)               /* (CRU_REFO2CON) Reference Clock Output Enable bit Mask */
#define CRU_REFO2CON_OE(value)                (CRU_REFO2CON_OE_Msk & (_UINT32_(value) << CRU_REFO2CON_OE_Pos)) /* Assigment of value for OE in the CRU_REFO2CON register */
#define   CRU_REFO2CON_OE_REFO2_OE_Val        _UINT32_(0x1)                                        /* (CRU_REFO2CON) Reference clock is driven out on REFO2 pin  */
#define   CRU_REFO2CON_OE_NO_REFO2_OE_Val     _UINT32_(0x0)                                        /* (CRU_REFO2CON) Reference clock is not driven out on REFO2 pin.  */
#define CRU_REFO2CON_OE_REFO2_OE              (CRU_REFO2CON_OE_REFO2_OE_Val << CRU_REFO2CON_OE_Pos) /* (CRU_REFO2CON) Reference clock is driven out on REFO2 pin Position  */
#define CRU_REFO2CON_OE_NO_REFO2_OE           (CRU_REFO2CON_OE_NO_REFO2_OE_Val << CRU_REFO2CON_OE_Pos) /* (CRU_REFO2CON) Reference clock is not driven out on REFO2 pin. Position  */
#define CRU_REFO2CON_SIDL_Pos                 _UINT32_(13)                                         /* (CRU_REFO2CON) Peripheral Stop in Idle Mode bit Position */
#define CRU_REFO2CON_SIDL_Msk                 (_UINT32_(0x1) << CRU_REFO2CON_SIDL_Pos)             /* (CRU_REFO2CON) Peripheral Stop in Idle Mode bit Mask */
#define CRU_REFO2CON_SIDL(value)              (CRU_REFO2CON_SIDL_Msk & (_UINT32_(value) << CRU_REFO2CON_SIDL_Pos)) /* Assigment of value for SIDL in the CRU_REFO2CON register */
#define   CRU_REFO2CON_SIDL_SIDL_Val          _UINT32_(0x1)                                        /* (CRU_REFO2CON) Discontinue module operation when device enters Idle mode  */
#define   CRU_REFO2CON_SIDL_NO_SIDL_Val       _UINT32_(0x0)                                        /* (CRU_REFO2CON) Continue module operation in Idle mode  */
#define CRU_REFO2CON_SIDL_SIDL                (CRU_REFO2CON_SIDL_SIDL_Val << CRU_REFO2CON_SIDL_Pos) /* (CRU_REFO2CON) Discontinue module operation when device enters Idle mode Position  */
#define CRU_REFO2CON_SIDL_NO_SIDL             (CRU_REFO2CON_SIDL_NO_SIDL_Val << CRU_REFO2CON_SIDL_Pos) /* (CRU_REFO2CON) Continue module operation in Idle mode Position  */
#define CRU_REFO2CON_FRZ_Pos                  _UINT32_(14)                                         /* (CRU_REFO2CON) Freeze in Debug mode bit Position */
#define CRU_REFO2CON_FRZ_Msk                  (_UINT32_(0x1) << CRU_REFO2CON_FRZ_Pos)              /* (CRU_REFO2CON) Freeze in Debug mode bit Mask */
#define CRU_REFO2CON_FRZ(value)               (CRU_REFO2CON_FRZ_Msk & (_UINT32_(value) << CRU_REFO2CON_FRZ_Pos)) /* Assigment of value for FRZ in the CRU_REFO2CON register */
#define   CRU_REFO2CON_FRZ_FRZ_Val            _UINT32_(0x1)                                        /* (CRU_REFO2CON) When emulator is in Debug mode, module freezes operation  */
#define   CRU_REFO2CON_FRZ_NO_FRZ_Val         _UINT32_(0x0)                                        /* (CRU_REFO2CON) When emulator is in Debug mode, module continues operation  */
#define CRU_REFO2CON_FRZ_FRZ                  (CRU_REFO2CON_FRZ_FRZ_Val << CRU_REFO2CON_FRZ_Pos)   /* (CRU_REFO2CON) When emulator is in Debug mode, module freezes operation Position  */
#define CRU_REFO2CON_FRZ_NO_FRZ               (CRU_REFO2CON_FRZ_NO_FRZ_Val << CRU_REFO2CON_FRZ_Pos) /* (CRU_REFO2CON) When emulator is in Debug mode, module continues operation Position  */
#define CRU_REFO2CON_ON_Pos                   _UINT32_(15)                                         /* (CRU_REFO2CON) Output Enable bit Position */
#define CRU_REFO2CON_ON_Msk                   (_UINT32_(0x1) << CRU_REFO2CON_ON_Pos)               /* (CRU_REFO2CON) Output Enable bit Mask */
#define CRU_REFO2CON_ON(value)                (CRU_REFO2CON_ON_Msk & (_UINT32_(value) << CRU_REFO2CON_ON_Pos)) /* Assigment of value for ON in the CRU_REFO2CON register */
#define   CRU_REFO2CON_ON_ON_Val              _UINT32_(0x1)                                        /* (CRU_REFO2CON) Reference Oscillator Module enabled  */
#define   CRU_REFO2CON_ON_OFF_Val             _UINT32_(0x0)                                        /* (CRU_REFO2CON) Reference Oscillator Module disabled  */
#define CRU_REFO2CON_ON_ON                    (CRU_REFO2CON_ON_ON_Val << CRU_REFO2CON_ON_Pos)      /* (CRU_REFO2CON) Reference Oscillator Module enabled Position  */
#define CRU_REFO2CON_ON_OFF                   (CRU_REFO2CON_ON_OFF_Val << CRU_REFO2CON_ON_Pos)     /* (CRU_REFO2CON) Reference Oscillator Module disabled Position  */
#define CRU_REFO2CON_RODIV_Pos                _UINT32_(16)                                         /* (CRU_REFO2CON) Reference Clock Divider bits Position */
#define CRU_REFO2CON_RODIV_Msk                (_UINT32_(0x7FFF) << CRU_REFO2CON_RODIV_Pos)         /* (CRU_REFO2CON) Reference Clock Divider bits Mask */
#define CRU_REFO2CON_RODIV(value)             (CRU_REFO2CON_RODIV_Msk & (_UINT32_(value) << CRU_REFO2CON_RODIV_Pos)) /* Assigment of value for RODIV in the CRU_REFO2CON register */
#define   CRU_REFO2CON_RODIV_65K_Val          _UINT32_(0x7FFF)                                     /* (CRU_REFO2CON) REFO2 clock is Base clock frequency divided by 65,534 (32,767 *2)  */
#define   CRU_REFO2CON_RODIV_4_Val            _UINT32_(0x2)                                        /* (CRU_REFO2CON) REFO2 clock is Base clock frequency divided by 4 (2*2)  */
#define   CRU_REFO2CON_RODIV_2_Val            _UINT32_(0x1)                                        /* (CRU_REFO2CON) REFO2 clock is Base clock frequency divided by 2 (1*2)  */
#define   CRU_REFO2CON_RODIV_NONE_Val         _UINT32_(0x0)                                        /* (CRU_REFO2CON) REFO2 clock is same frequency as Base clock (no divider)  */
#define CRU_REFO2CON_RODIV_65K                (CRU_REFO2CON_RODIV_65K_Val << CRU_REFO2CON_RODIV_Pos) /* (CRU_REFO2CON) REFO2 clock is Base clock frequency divided by 65,534 (32,767 *2) Position  */
#define CRU_REFO2CON_RODIV_4                  (CRU_REFO2CON_RODIV_4_Val << CRU_REFO2CON_RODIV_Pos) /* (CRU_REFO2CON) REFO2 clock is Base clock frequency divided by 4 (2*2) Position  */
#define CRU_REFO2CON_RODIV_2                  (CRU_REFO2CON_RODIV_2_Val << CRU_REFO2CON_RODIV_Pos) /* (CRU_REFO2CON) REFO2 clock is Base clock frequency divided by 2 (1*2) Position  */
#define CRU_REFO2CON_RODIV_NONE               (CRU_REFO2CON_RODIV_NONE_Val << CRU_REFO2CON_RODIV_Pos) /* (CRU_REFO2CON) REFO2 clock is same frequency as Base clock (no divider) Position  */
#define CRU_REFO2CON_Msk                      _UINT32_(0x7FFFFB0F)                                 /* (CRU_REFO2CON) Register Mask  */


/* -------- CRU_REFO2CONCLR : (CRU Offset: 0x94) (R/W 32)  -------- */
#define CRU_REFO2CONCLR_RESETVALUE            _UINT32_(0x00)                                       /*  (CRU_REFO2CONCLR)   Reset Value */

#define CRU_REFO2CONCLR_Msk                   _UINT32_(0x00000000)                                 /* (CRU_REFO2CONCLR) Register Mask  */


/* -------- CRU_REFO2CONSET : (CRU Offset: 0x98) (R/W 32)  -------- */
#define CRU_REFO2CONSET_RESETVALUE            _UINT32_(0x00)                                       /*  (CRU_REFO2CONSET)   Reset Value */

#define CRU_REFO2CONSET_Msk                   _UINT32_(0x00000000)                                 /* (CRU_REFO2CONSET) Register Mask  */


/* -------- CRU_REFO2CONINV : (CRU Offset: 0x9C) (R/W 32)  -------- */
#define CRU_REFO2CONINV_RESETVALUE            _UINT32_(0x00)                                       /*  (CRU_REFO2CONINV)   Reset Value */

#define CRU_REFO2CONINV_Msk                   _UINT32_(0x00000000)                                 /* (CRU_REFO2CONINV) Register Mask  */


/* -------- CRU_REFO2TRIM : (CRU Offset: 0xA0) (R/W 32) REFERENCE OSCILLATOR 2 TRIM REGISTER -------- */
#define CRU_REFO2TRIM_RESETVALUE              _UINT32_(0x00)                                       /*  (CRU_REFO2TRIM) REFERENCE OSCILLATOR 2 TRIM REGISTER  Reset Value */

#define CRU_REFO2TRIM_ROTRIM_Pos              _UINT32_(23)                                         /* (CRU_REFO2TRIM) Trim bits - Provides fractional additive to RODIV value for 1/2 period of REFO1 clock Position */
#define CRU_REFO2TRIM_ROTRIM_Msk              (_UINT32_(0x1FF) << CRU_REFO2TRIM_ROTRIM_Pos)        /* (CRU_REFO2TRIM) Trim bits - Provides fractional additive to RODIV value for 1/2 period of REFO1 clock Mask */
#define CRU_REFO2TRIM_ROTRIM(value)           (CRU_REFO2TRIM_ROTRIM_Msk & (_UINT32_(value) << CRU_REFO2TRIM_ROTRIM_Pos)) /* Assigment of value for ROTRIM in the CRU_REFO2TRIM register */
#define   CRU_REFO2TRIM_ROTRIM_ZERO_Val       _UINT32_(0x0)                                        /* (CRU_REFO2TRIM) 0/512 (0.0) divisor added to RODIV value  */
#define   CRU_REFO2TRIM_ROTRIM_1_Val          _UINT32_(0x1)                                        /* (CRU_REFO2TRIM) 1/512 (0.001953125) divisor added to RODIV value  */
#define   CRU_REFO2TRIM_ROTRIM_2_Val          _UINT32_(0x2)                                        /* (CRU_REFO2TRIM) 2/512 (0.00390625) divisor added to RODIV value  */
#define   CRU_REFO2TRIM_ROTRIM_256_Val        _UINT32_(0x100)                                      /* (CRU_REFO2TRIM) 256/512 (0.5000) divisor added to RODIV value  */
#define   CRU_REFO2TRIM_ROTRIM_511_Val        _UINT32_(0x1FF)                                      /* (CRU_REFO2TRIM) 511/512 (0.998046875) divisor added to RODIV value  */
#define CRU_REFO2TRIM_ROTRIM_ZERO             (CRU_REFO2TRIM_ROTRIM_ZERO_Val << CRU_REFO2TRIM_ROTRIM_Pos) /* (CRU_REFO2TRIM) 0/512 (0.0) divisor added to RODIV value Position  */
#define CRU_REFO2TRIM_ROTRIM_1                (CRU_REFO2TRIM_ROTRIM_1_Val << CRU_REFO2TRIM_ROTRIM_Pos) /* (CRU_REFO2TRIM) 1/512 (0.001953125) divisor added to RODIV value Position  */
#define CRU_REFO2TRIM_ROTRIM_2                (CRU_REFO2TRIM_ROTRIM_2_Val << CRU_REFO2TRIM_ROTRIM_Pos) /* (CRU_REFO2TRIM) 2/512 (0.00390625) divisor added to RODIV value Position  */
#define CRU_REFO2TRIM_ROTRIM_256              (CRU_REFO2TRIM_ROTRIM_256_Val << CRU_REFO2TRIM_ROTRIM_Pos) /* (CRU_REFO2TRIM) 256/512 (0.5000) divisor added to RODIV value Position  */
#define CRU_REFO2TRIM_ROTRIM_511              (CRU_REFO2TRIM_ROTRIM_511_Val << CRU_REFO2TRIM_ROTRIM_Pos) /* (CRU_REFO2TRIM) 511/512 (0.998046875) divisor added to RODIV value Position  */
#define CRU_REFO2TRIM_Msk                     _UINT32_(0xFF800000)                                 /* (CRU_REFO2TRIM) Register Mask  */


/* -------- CRU_REFO2TRIMCLR : (CRU Offset: 0xA4) (R/W 32)  -------- */
#define CRU_REFO2TRIMCLR_RESETVALUE           _UINT32_(0x00)                                       /*  (CRU_REFO2TRIMCLR)   Reset Value */

#define CRU_REFO2TRIMCLR_Msk                  _UINT32_(0x00000000)                                 /* (CRU_REFO2TRIMCLR) Register Mask  */


/* -------- CRU_REFO2TRIMSET : (CRU Offset: 0xA8) (R/W 32)  -------- */
#define CRU_REFO2TRIMSET_RESETVALUE           _UINT32_(0x00)                                       /*  (CRU_REFO2TRIMSET)   Reset Value */

#define CRU_REFO2TRIMSET_Msk                  _UINT32_(0x00000000)                                 /* (CRU_REFO2TRIMSET) Register Mask  */


/* -------- CRU_REFO2TRIMINV : (CRU Offset: 0xAC) (R/W 32)  -------- */
#define CRU_REFO2TRIMINV_RESETVALUE           _UINT32_(0x00)                                       /*  (CRU_REFO2TRIMINV)   Reset Value */

#define CRU_REFO2TRIMINV_Msk                  _UINT32_(0x00000000)                                 /* (CRU_REFO2TRIMINV) Register Mask  */


/* -------- CRU_REFO3CON : (CRU Offset: 0xB0) (R/W 32) REFERENCE OSCILLATOR 3 CONTROL REGISTER -------- */
#define CRU_REFO3CON_RESETVALUE               _UINT32_(0x00)                                       /*  (CRU_REFO3CON) REFERENCE OSCILLATOR 3 CONTROL REGISTER  Reset Value */

#define CRU_REFO3CON_ROSEL_Pos                _UINT32_(0)                                          /* (CRU_REFO3CON) Reference Clock Source Select bits Position */
#define CRU_REFO3CON_ROSEL_Msk                (_UINT32_(0xF) << CRU_REFO3CON_ROSEL_Pos)            /* (CRU_REFO3CON) Reference Clock Source Select bits Mask */
#define CRU_REFO3CON_ROSEL(value)             (CRU_REFO3CON_ROSEL_Msk & (_UINT32_(value) << CRU_REFO3CON_ROSEL_Pos)) /* Assigment of value for ROSEL in the CRU_REFO3CON register */
#define   CRU_REFO3CON_ROSEL_REFCLKI_Val      _UINT32_(0x8)                                        /* (CRU_REFO3CON) REFI Pin  */
#define   CRU_REFO3CON_ROSEL_SYSCLK_Val       _UINT32_(0x7)                                        /* (CRU_REFO3CON) System clock (reference clock reflects any device clock switching)  */
#define   CRU_REFO3CON_ROSEL_PBCLK1_Val       _UINT32_(0x6)                                        /* (CRU_REFO3CON) Peripheral clock 1 (reference clock reflects any peripheral clock switching)  */
#define   CRU_REFO3CON_ROSEL_SPLL3_Val        _UINT32_(0x5)                                        /* (CRU_REFO3CON) System PLL3 (Clock-3)  */
#define   CRU_REFO3CON_ROSEL_LPRC_Val         _UINT32_(0x4)                                        /* (CRU_REFO3CON) LPRC  */
#define   CRU_REFO3CON_ROSEL_SOSC_Val         _UINT32_(0x3)                                        /* (CRU_REFO3CON) SOSC  */
#define   CRU_REFO3CON_ROSEL_POSC_Val         _UINT32_(0x2)                                        /* (CRU_REFO3CON) POSC  */
#define   CRU_REFO3CON_ROSEL_SPLL1_Val        _UINT32_(0x1)                                        /* (CRU_REFO3CON) System PLL1 (Clock-1)  */
#define   CRU_REFO3CON_ROSEL_FRC_Val          _UINT32_(0x0)                                        /* (CRU_REFO3CON) FRC  */
#define CRU_REFO3CON_ROSEL_REFCLKI            (CRU_REFO3CON_ROSEL_REFCLKI_Val << CRU_REFO3CON_ROSEL_Pos) /* (CRU_REFO3CON) REFI Pin Position  */
#define CRU_REFO3CON_ROSEL_SYSCLK             (CRU_REFO3CON_ROSEL_SYSCLK_Val << CRU_REFO3CON_ROSEL_Pos) /* (CRU_REFO3CON) System clock (reference clock reflects any device clock switching) Position  */
#define CRU_REFO3CON_ROSEL_PBCLK1             (CRU_REFO3CON_ROSEL_PBCLK1_Val << CRU_REFO3CON_ROSEL_Pos) /* (CRU_REFO3CON) Peripheral clock 1 (reference clock reflects any peripheral clock switching) Position  */
#define CRU_REFO3CON_ROSEL_SPLL3              (CRU_REFO3CON_ROSEL_SPLL3_Val << CRU_REFO3CON_ROSEL_Pos) /* (CRU_REFO3CON) System PLL3 (Clock-3) Position  */
#define CRU_REFO3CON_ROSEL_LPRC               (CRU_REFO3CON_ROSEL_LPRC_Val << CRU_REFO3CON_ROSEL_Pos) /* (CRU_REFO3CON) LPRC Position  */
#define CRU_REFO3CON_ROSEL_SOSC               (CRU_REFO3CON_ROSEL_SOSC_Val << CRU_REFO3CON_ROSEL_Pos) /* (CRU_REFO3CON) SOSC Position  */
#define CRU_REFO3CON_ROSEL_POSC               (CRU_REFO3CON_ROSEL_POSC_Val << CRU_REFO3CON_ROSEL_Pos) /* (CRU_REFO3CON) POSC Position  */
#define CRU_REFO3CON_ROSEL_SPLL1              (CRU_REFO3CON_ROSEL_SPLL1_Val << CRU_REFO3CON_ROSEL_Pos) /* (CRU_REFO3CON) System PLL1 (Clock-1) Position  */
#define CRU_REFO3CON_ROSEL_FRC                (CRU_REFO3CON_ROSEL_FRC_Val << CRU_REFO3CON_ROSEL_Pos) /* (CRU_REFO3CON) FRC Position  */
#define CRU_REFO3CON_ACTIVE_Pos               _UINT32_(8)                                          /* (CRU_REFO3CON) Reference Clock Request Status bit Position */
#define CRU_REFO3CON_ACTIVE_Msk               (_UINT32_(0x1) << CRU_REFO3CON_ACTIVE_Pos)           /* (CRU_REFO3CON) Reference Clock Request Status bit Mask */
#define CRU_REFO3CON_ACTIVE(value)            (CRU_REFO3CON_ACTIVE_Msk & (_UINT32_(value) << CRU_REFO3CON_ACTIVE_Pos)) /* Assigment of value for ACTIVE in the CRU_REFO3CON register */
#define   CRU_REFO3CON_ACTIVE_ACTIVE_Val      _UINT32_(0x1)                                        /* (CRU_REFO3CON) Reference clock request is active (User should not update this REFOCON register)  */
#define   CRU_REFO3CON_ACTIVE_NOT_ACTIVE_Val  _UINT32_(0x0)                                        /* (CRU_REFO3CON) Reference clock request is not active (User can update this REFOCON register)  */
#define CRU_REFO3CON_ACTIVE_ACTIVE            (CRU_REFO3CON_ACTIVE_ACTIVE_Val << CRU_REFO3CON_ACTIVE_Pos) /* (CRU_REFO3CON) Reference clock request is active (User should not update this REFOCON register) Position  */
#define CRU_REFO3CON_ACTIVE_NOT_ACTIVE        (CRU_REFO3CON_ACTIVE_NOT_ACTIVE_Val << CRU_REFO3CON_ACTIVE_Pos) /* (CRU_REFO3CON) Reference clock request is not active (User can update this REFOCON register) Position  */
#define CRU_REFO3CON_DIVSWEN_Pos              _UINT32_(9)                                          /* (CRU_REFO3CON) Clock RODIV/ROTRIM switch enabled. Position */
#define CRU_REFO3CON_DIVSWEN_Msk              (_UINT32_(0x1) << CRU_REFO3CON_DIVSWEN_Pos)          /* (CRU_REFO3CON) Clock RODIV/ROTRIM switch enabled. Mask */
#define CRU_REFO3CON_DIVSWEN(value)           (CRU_REFO3CON_DIVSWEN_Msk & (_UINT32_(value) << CRU_REFO3CON_DIVSWEN_Pos)) /* Assigment of value for DIVSWEN in the CRU_REFO3CON register */
#define   CRU_REFO3CON_DIVSWEN_SWINPROGRESS_Val _UINT32_(0x1)                                        /* (CRU_REFO3CON) Clock Divider Switching currently in progress.  */
#define   CRU_REFO3CON_DIVSWEN_SWCOMPLETE_Val _UINT32_(0x0)                                        /* (CRU_REFO3CON) Clock Divider Switch has completed.  */
#define CRU_REFO3CON_DIVSWEN_SWINPROGRESS     (CRU_REFO3CON_DIVSWEN_SWINPROGRESS_Val << CRU_REFO3CON_DIVSWEN_Pos) /* (CRU_REFO3CON) Clock Divider Switching currently in progress. Position  */
#define CRU_REFO3CON_DIVSWEN_SWCOMPLETE       (CRU_REFO3CON_DIVSWEN_SWCOMPLETE_Val << CRU_REFO3CON_DIVSWEN_Pos) /* (CRU_REFO3CON) Clock Divider Switch has completed. Position  */
#define CRU_REFO3CON_RSLP_Pos                 _UINT32_(11)                                         /* (CRU_REFO3CON) Reference Oscillator Run in Sleep bit Position */
#define CRU_REFO3CON_RSLP_Msk                 (_UINT32_(0x1) << CRU_REFO3CON_RSLP_Pos)             /* (CRU_REFO3CON) Reference Oscillator Run in Sleep bit Mask */
#define CRU_REFO3CON_RSLP(value)              (CRU_REFO3CON_RSLP_Msk & (_UINT32_(value) << CRU_REFO3CON_RSLP_Pos)) /* Assigment of value for RSLP in the CRU_REFO3CON register */
#define   CRU_REFO3CON_RSLP_RSLP_Val          _UINT32_(0x1)                                        /* (CRU_REFO3CON) Reference Oscillator output continues to run in Sleep  */
#define   CRU_REFO3CON_RSLP_NO_RSLP_Val       _UINT32_(0x0)                                        /* (CRU_REFO3CON) Reference Oscillator output is disabled in Sleep  */
#define CRU_REFO3CON_RSLP_RSLP                (CRU_REFO3CON_RSLP_RSLP_Val << CRU_REFO3CON_RSLP_Pos) /* (CRU_REFO3CON) Reference Oscillator output continues to run in Sleep Position  */
#define CRU_REFO3CON_RSLP_NO_RSLP             (CRU_REFO3CON_RSLP_NO_RSLP_Val << CRU_REFO3CON_RSLP_Pos) /* (CRU_REFO3CON) Reference Oscillator output is disabled in Sleep Position  */
#define CRU_REFO3CON_OE_Pos                   _UINT32_(12)                                         /* (CRU_REFO3CON) Reference Clock Output Enable bit Position */
#define CRU_REFO3CON_OE_Msk                   (_UINT32_(0x1) << CRU_REFO3CON_OE_Pos)               /* (CRU_REFO3CON) Reference Clock Output Enable bit Mask */
#define CRU_REFO3CON_OE(value)                (CRU_REFO3CON_OE_Msk & (_UINT32_(value) << CRU_REFO3CON_OE_Pos)) /* Assigment of value for OE in the CRU_REFO3CON register */
#define   CRU_REFO3CON_OE_REFO3_OE_Val        _UINT32_(0x1)                                        /* (CRU_REFO3CON) Reference clock is driven out on REFO3 pin  */
#define   CRU_REFO3CON_OE_NO_REFO3_OE_Val     _UINT32_(0x0)                                        /* (CRU_REFO3CON) Reference clock is not driven out on REFO3 pin.  */
#define CRU_REFO3CON_OE_REFO3_OE              (CRU_REFO3CON_OE_REFO3_OE_Val << CRU_REFO3CON_OE_Pos) /* (CRU_REFO3CON) Reference clock is driven out on REFO3 pin Position  */
#define CRU_REFO3CON_OE_NO_REFO3_OE           (CRU_REFO3CON_OE_NO_REFO3_OE_Val << CRU_REFO3CON_OE_Pos) /* (CRU_REFO3CON) Reference clock is not driven out on REFO3 pin. Position  */
#define CRU_REFO3CON_SIDL_Pos                 _UINT32_(13)                                         /* (CRU_REFO3CON) Peripheral Stop in Idle Mode bit Position */
#define CRU_REFO3CON_SIDL_Msk                 (_UINT32_(0x1) << CRU_REFO3CON_SIDL_Pos)             /* (CRU_REFO3CON) Peripheral Stop in Idle Mode bit Mask */
#define CRU_REFO3CON_SIDL(value)              (CRU_REFO3CON_SIDL_Msk & (_UINT32_(value) << CRU_REFO3CON_SIDL_Pos)) /* Assigment of value for SIDL in the CRU_REFO3CON register */
#define   CRU_REFO3CON_SIDL_SIDL_Val          _UINT32_(0x1)                                        /* (CRU_REFO3CON) Discontinue module operation when device enters Idle mode  */
#define   CRU_REFO3CON_SIDL_NO_SIDL_Val       _UINT32_(0x0)                                        /* (CRU_REFO3CON) Continue module operation in Idle mode  */
#define CRU_REFO3CON_SIDL_SIDL                (CRU_REFO3CON_SIDL_SIDL_Val << CRU_REFO3CON_SIDL_Pos) /* (CRU_REFO3CON) Discontinue module operation when device enters Idle mode Position  */
#define CRU_REFO3CON_SIDL_NO_SIDL             (CRU_REFO3CON_SIDL_NO_SIDL_Val << CRU_REFO3CON_SIDL_Pos) /* (CRU_REFO3CON) Continue module operation in Idle mode Position  */
#define CRU_REFO3CON_FRZ_Pos                  _UINT32_(14)                                         /* (CRU_REFO3CON) Freeze in Debug mode bit Position */
#define CRU_REFO3CON_FRZ_Msk                  (_UINT32_(0x1) << CRU_REFO3CON_FRZ_Pos)              /* (CRU_REFO3CON) Freeze in Debug mode bit Mask */
#define CRU_REFO3CON_FRZ(value)               (CRU_REFO3CON_FRZ_Msk & (_UINT32_(value) << CRU_REFO3CON_FRZ_Pos)) /* Assigment of value for FRZ in the CRU_REFO3CON register */
#define   CRU_REFO3CON_FRZ_FRZ_Val            _UINT32_(0x1)                                        /* (CRU_REFO3CON) When emulator is in Debug mode, module freezes operation  */
#define   CRU_REFO3CON_FRZ_NO_FRZ_Val         _UINT32_(0x0)                                        /* (CRU_REFO3CON) When emulator is in Debug mode, module continues operation  */
#define CRU_REFO3CON_FRZ_FRZ                  (CRU_REFO3CON_FRZ_FRZ_Val << CRU_REFO3CON_FRZ_Pos)   /* (CRU_REFO3CON) When emulator is in Debug mode, module freezes operation Position  */
#define CRU_REFO3CON_FRZ_NO_FRZ               (CRU_REFO3CON_FRZ_NO_FRZ_Val << CRU_REFO3CON_FRZ_Pos) /* (CRU_REFO3CON) When emulator is in Debug mode, module continues operation Position  */
#define CRU_REFO3CON_ON_Pos                   _UINT32_(15)                                         /* (CRU_REFO3CON) Output Enable bit Position */
#define CRU_REFO3CON_ON_Msk                   (_UINT32_(0x1) << CRU_REFO3CON_ON_Pos)               /* (CRU_REFO3CON) Output Enable bit Mask */
#define CRU_REFO3CON_ON(value)                (CRU_REFO3CON_ON_Msk & (_UINT32_(value) << CRU_REFO3CON_ON_Pos)) /* Assigment of value for ON in the CRU_REFO3CON register */
#define   CRU_REFO3CON_ON_ON_Val              _UINT32_(0x1)                                        /* (CRU_REFO3CON) Reference Oscillator Module enabled  */
#define   CRU_REFO3CON_ON_OFF_Val             _UINT32_(0x0)                                        /* (CRU_REFO3CON) Reference Oscillator Module disabled  */
#define CRU_REFO3CON_ON_ON                    (CRU_REFO3CON_ON_ON_Val << CRU_REFO3CON_ON_Pos)      /* (CRU_REFO3CON) Reference Oscillator Module enabled Position  */
#define CRU_REFO3CON_ON_OFF                   (CRU_REFO3CON_ON_OFF_Val << CRU_REFO3CON_ON_Pos)     /* (CRU_REFO3CON) Reference Oscillator Module disabled Position  */
#define CRU_REFO3CON_RODIV_Pos                _UINT32_(16)                                         /* (CRU_REFO3CON) Reference Clock Divider bits Position */
#define CRU_REFO3CON_RODIV_Msk                (_UINT32_(0x7FFF) << CRU_REFO3CON_RODIV_Pos)         /* (CRU_REFO3CON) Reference Clock Divider bits Mask */
#define CRU_REFO3CON_RODIV(value)             (CRU_REFO3CON_RODIV_Msk & (_UINT32_(value) << CRU_REFO3CON_RODIV_Pos)) /* Assigment of value for RODIV in the CRU_REFO3CON register */
#define   CRU_REFO3CON_RODIV_65K_Val          _UINT32_(0x7FFF)                                     /* (CRU_REFO3CON) REFO3 clock is Base clock frequency divided by 65,534 (32,767 *2)  */
#define   CRU_REFO3CON_RODIV_4_Val            _UINT32_(0x2)                                        /* (CRU_REFO3CON) REFO3 clock is Base clock frequency divided by 4 (2*2)  */
#define   CRU_REFO3CON_RODIV_2_Val            _UINT32_(0x1)                                        /* (CRU_REFO3CON) REFO3 clock is Base clock frequency divided by 2 (1*2)  */
#define   CRU_REFO3CON_RODIV_NONE_Val         _UINT32_(0x0)                                        /* (CRU_REFO3CON) REFO3 clock is same frequency as Base clock (no divider)  */
#define CRU_REFO3CON_RODIV_65K                (CRU_REFO3CON_RODIV_65K_Val << CRU_REFO3CON_RODIV_Pos) /* (CRU_REFO3CON) REFO3 clock is Base clock frequency divided by 65,534 (32,767 *2) Position  */
#define CRU_REFO3CON_RODIV_4                  (CRU_REFO3CON_RODIV_4_Val << CRU_REFO3CON_RODIV_Pos) /* (CRU_REFO3CON) REFO3 clock is Base clock frequency divided by 4 (2*2) Position  */
#define CRU_REFO3CON_RODIV_2                  (CRU_REFO3CON_RODIV_2_Val << CRU_REFO3CON_RODIV_Pos) /* (CRU_REFO3CON) REFO3 clock is Base clock frequency divided by 2 (1*2) Position  */
#define CRU_REFO3CON_RODIV_NONE               (CRU_REFO3CON_RODIV_NONE_Val << CRU_REFO3CON_RODIV_Pos) /* (CRU_REFO3CON) REFO3 clock is same frequency as Base clock (no divider) Position  */
#define CRU_REFO3CON_Msk                      _UINT32_(0x7FFFFB0F)                                 /* (CRU_REFO3CON) Register Mask  */


/* -------- CRU_REFO3CONCLR : (CRU Offset: 0xB4) (R/W 32)  -------- */
#define CRU_REFO3CONCLR_RESETVALUE            _UINT32_(0x00)                                       /*  (CRU_REFO3CONCLR)   Reset Value */

#define CRU_REFO3CONCLR_Msk                   _UINT32_(0x00000000)                                 /* (CRU_REFO3CONCLR) Register Mask  */


/* -------- CRU_REFO3CONSET : (CRU Offset: 0xB8) (R/W 32)  -------- */
#define CRU_REFO3CONSET_RESETVALUE            _UINT32_(0x00)                                       /*  (CRU_REFO3CONSET)   Reset Value */

#define CRU_REFO3CONSET_Msk                   _UINT32_(0x00000000)                                 /* (CRU_REFO3CONSET) Register Mask  */


/* -------- CRU_REFO3CONINV : (CRU Offset: 0xBC) (R/W 32)  -------- */
#define CRU_REFO3CONINV_RESETVALUE            _UINT32_(0x00)                                       /*  (CRU_REFO3CONINV)   Reset Value */

#define CRU_REFO3CONINV_Msk                   _UINT32_(0x00000000)                                 /* (CRU_REFO3CONINV) Register Mask  */


/* -------- CRU_REFO3TRIM : (CRU Offset: 0xC0) (R/W 32) REFERENCE OSCILLATOR 3 TRIM REGISTER -------- */
#define CRU_REFO3TRIM_RESETVALUE              _UINT32_(0x00)                                       /*  (CRU_REFO3TRIM) REFERENCE OSCILLATOR 3 TRIM REGISTER  Reset Value */

#define CRU_REFO3TRIM_ROTRIM_Pos              _UINT32_(23)                                         /* (CRU_REFO3TRIM) Trim bits - Provides fractional additive to RODIV value for 1/2 period of REFO1 clock Position */
#define CRU_REFO3TRIM_ROTRIM_Msk              (_UINT32_(0x1FF) << CRU_REFO3TRIM_ROTRIM_Pos)        /* (CRU_REFO3TRIM) Trim bits - Provides fractional additive to RODIV value for 1/2 period of REFO1 clock Mask */
#define CRU_REFO3TRIM_ROTRIM(value)           (CRU_REFO3TRIM_ROTRIM_Msk & (_UINT32_(value) << CRU_REFO3TRIM_ROTRIM_Pos)) /* Assigment of value for ROTRIM in the CRU_REFO3TRIM register */
#define   CRU_REFO3TRIM_ROTRIM_ZERO_Val       _UINT32_(0x0)                                        /* (CRU_REFO3TRIM) 0/512 (0.0) divisor added to RODIV value  */
#define   CRU_REFO3TRIM_ROTRIM_1_Val          _UINT32_(0x1)                                        /* (CRU_REFO3TRIM) 1/512 (0.001953125) divisor added to RODIV value  */
#define   CRU_REFO3TRIM_ROTRIM_2_Val          _UINT32_(0x2)                                        /* (CRU_REFO3TRIM) 2/512 (0.00390625) divisor added to RODIV value  */
#define   CRU_REFO3TRIM_ROTRIM_256_Val        _UINT32_(0x100)                                      /* (CRU_REFO3TRIM) 256/512 (0.5000) divisor added to RODIV value  */
#define   CRU_REFO3TRIM_ROTRIM_511_Val        _UINT32_(0x1FF)                                      /* (CRU_REFO3TRIM) 511/512 (0.998046875) divisor added to RODIV value  */
#define CRU_REFO3TRIM_ROTRIM_ZERO             (CRU_REFO3TRIM_ROTRIM_ZERO_Val << CRU_REFO3TRIM_ROTRIM_Pos) /* (CRU_REFO3TRIM) 0/512 (0.0) divisor added to RODIV value Position  */
#define CRU_REFO3TRIM_ROTRIM_1                (CRU_REFO3TRIM_ROTRIM_1_Val << CRU_REFO3TRIM_ROTRIM_Pos) /* (CRU_REFO3TRIM) 1/512 (0.001953125) divisor added to RODIV value Position  */
#define CRU_REFO3TRIM_ROTRIM_2                (CRU_REFO3TRIM_ROTRIM_2_Val << CRU_REFO3TRIM_ROTRIM_Pos) /* (CRU_REFO3TRIM) 2/512 (0.00390625) divisor added to RODIV value Position  */
#define CRU_REFO3TRIM_ROTRIM_256              (CRU_REFO3TRIM_ROTRIM_256_Val << CRU_REFO3TRIM_ROTRIM_Pos) /* (CRU_REFO3TRIM) 256/512 (0.5000) divisor added to RODIV value Position  */
#define CRU_REFO3TRIM_ROTRIM_511              (CRU_REFO3TRIM_ROTRIM_511_Val << CRU_REFO3TRIM_ROTRIM_Pos) /* (CRU_REFO3TRIM) 511/512 (0.998046875) divisor added to RODIV value Position  */
#define CRU_REFO3TRIM_Msk                     _UINT32_(0xFF800000)                                 /* (CRU_REFO3TRIM) Register Mask  */


/* -------- CRU_REFO3TRIMCLR : (CRU Offset: 0xC4) (R/W 32)  -------- */
#define CRU_REFO3TRIMCLR_RESETVALUE           _UINT32_(0x00)                                       /*  (CRU_REFO3TRIMCLR)   Reset Value */

#define CRU_REFO3TRIMCLR_Msk                  _UINT32_(0x00000000)                                 /* (CRU_REFO3TRIMCLR) Register Mask  */


/* -------- CRU_REFO3TRIMSET : (CRU Offset: 0xC8) (R/W 32)  -------- */
#define CRU_REFO3TRIMSET_RESETVALUE           _UINT32_(0x00)                                       /*  (CRU_REFO3TRIMSET)   Reset Value */

#define CRU_REFO3TRIMSET_Msk                  _UINT32_(0x00000000)                                 /* (CRU_REFO3TRIMSET) Register Mask  */


/* -------- CRU_REFO3TRIMINV : (CRU Offset: 0xCC) (R/W 32)  -------- */
#define CRU_REFO3TRIMINV_RESETVALUE           _UINT32_(0x00)                                       /*  (CRU_REFO3TRIMINV)   Reset Value */

#define CRU_REFO3TRIMINV_Msk                  _UINT32_(0x00000000)                                 /* (CRU_REFO3TRIMINV) Register Mask  */


/* -------- CRU_REFO4CON : (CRU Offset: 0xD0) (R/W 32) REFERENCE OSCILLATOR 4 CONTROL REGISTER -------- */
#define CRU_REFO4CON_RESETVALUE               _UINT32_(0x00)                                       /*  (CRU_REFO4CON) REFERENCE OSCILLATOR 4 CONTROL REGISTER  Reset Value */

#define CRU_REFO4CON_ROSEL_Pos                _UINT32_(0)                                          /* (CRU_REFO4CON) Reference Clock Source Select bits Position */
#define CRU_REFO4CON_ROSEL_Msk                (_UINT32_(0xF) << CRU_REFO4CON_ROSEL_Pos)            /* (CRU_REFO4CON) Reference Clock Source Select bits Mask */
#define CRU_REFO4CON_ROSEL(value)             (CRU_REFO4CON_ROSEL_Msk & (_UINT32_(value) << CRU_REFO4CON_ROSEL_Pos)) /* Assigment of value for ROSEL in the CRU_REFO4CON register */
#define   CRU_REFO4CON_ROSEL_REFCLKI_Val      _UINT32_(0x8)                                        /* (CRU_REFO4CON) REFI Pin  */
#define   CRU_REFO4CON_ROSEL_SYSCLK_Val       _UINT32_(0x7)                                        /* (CRU_REFO4CON) System clock (reference clock reflects any device clock switching)  */
#define   CRU_REFO4CON_ROSEL_PBCLK1_Val       _UINT32_(0x6)                                        /* (CRU_REFO4CON) Peripheral clock 1 (reference clock reflects any peripheral clock switching)  */
#define   CRU_REFO4CON_ROSEL_SPLL3_Val        _UINT32_(0x5)                                        /* (CRU_REFO4CON) System PLL3 (Clock-3)  */
#define   CRU_REFO4CON_ROSEL_LPRC_Val         _UINT32_(0x4)                                        /* (CRU_REFO4CON) LPRC  */
#define   CRU_REFO4CON_ROSEL_SOSC_Val         _UINT32_(0x3)                                        /* (CRU_REFO4CON) SOSC  */
#define   CRU_REFO4CON_ROSEL_POSC_Val         _UINT32_(0x2)                                        /* (CRU_REFO4CON) POSC  */
#define   CRU_REFO4CON_ROSEL_SPLL1_Val        _UINT32_(0x1)                                        /* (CRU_REFO4CON) System PLL1 (Clock-1)  */
#define   CRU_REFO4CON_ROSEL_FRC_Val          _UINT32_(0x0)                                        /* (CRU_REFO4CON) FRC  */
#define CRU_REFO4CON_ROSEL_REFCLKI            (CRU_REFO4CON_ROSEL_REFCLKI_Val << CRU_REFO4CON_ROSEL_Pos) /* (CRU_REFO4CON) REFI Pin Position  */
#define CRU_REFO4CON_ROSEL_SYSCLK             (CRU_REFO4CON_ROSEL_SYSCLK_Val << CRU_REFO4CON_ROSEL_Pos) /* (CRU_REFO4CON) System clock (reference clock reflects any device clock switching) Position  */
#define CRU_REFO4CON_ROSEL_PBCLK1             (CRU_REFO4CON_ROSEL_PBCLK1_Val << CRU_REFO4CON_ROSEL_Pos) /* (CRU_REFO4CON) Peripheral clock 1 (reference clock reflects any peripheral clock switching) Position  */
#define CRU_REFO4CON_ROSEL_SPLL3              (CRU_REFO4CON_ROSEL_SPLL3_Val << CRU_REFO4CON_ROSEL_Pos) /* (CRU_REFO4CON) System PLL3 (Clock-3) Position  */
#define CRU_REFO4CON_ROSEL_LPRC               (CRU_REFO4CON_ROSEL_LPRC_Val << CRU_REFO4CON_ROSEL_Pos) /* (CRU_REFO4CON) LPRC Position  */
#define CRU_REFO4CON_ROSEL_SOSC               (CRU_REFO4CON_ROSEL_SOSC_Val << CRU_REFO4CON_ROSEL_Pos) /* (CRU_REFO4CON) SOSC Position  */
#define CRU_REFO4CON_ROSEL_POSC               (CRU_REFO4CON_ROSEL_POSC_Val << CRU_REFO4CON_ROSEL_Pos) /* (CRU_REFO4CON) POSC Position  */
#define CRU_REFO4CON_ROSEL_SPLL1              (CRU_REFO4CON_ROSEL_SPLL1_Val << CRU_REFO4CON_ROSEL_Pos) /* (CRU_REFO4CON) System PLL1 (Clock-1) Position  */
#define CRU_REFO4CON_ROSEL_FRC                (CRU_REFO4CON_ROSEL_FRC_Val << CRU_REFO4CON_ROSEL_Pos) /* (CRU_REFO4CON) FRC Position  */
#define CRU_REFO4CON_ACTIVE_Pos               _UINT32_(8)                                          /* (CRU_REFO4CON) Reference Clock Request Status bit Position */
#define CRU_REFO4CON_ACTIVE_Msk               (_UINT32_(0x1) << CRU_REFO4CON_ACTIVE_Pos)           /* (CRU_REFO4CON) Reference Clock Request Status bit Mask */
#define CRU_REFO4CON_ACTIVE(value)            (CRU_REFO4CON_ACTIVE_Msk & (_UINT32_(value) << CRU_REFO4CON_ACTIVE_Pos)) /* Assigment of value for ACTIVE in the CRU_REFO4CON register */
#define   CRU_REFO4CON_ACTIVE_ACTIVE_Val      _UINT32_(0x1)                                        /* (CRU_REFO4CON) Reference clock request is active (User should not update this REFOCON register)  */
#define   CRU_REFO4CON_ACTIVE_NOT_ACTIVE_Val  _UINT32_(0x0)                                        /* (CRU_REFO4CON) Reference clock request is not active (User can update this REFOCON register)  */
#define CRU_REFO4CON_ACTIVE_ACTIVE            (CRU_REFO4CON_ACTIVE_ACTIVE_Val << CRU_REFO4CON_ACTIVE_Pos) /* (CRU_REFO4CON) Reference clock request is active (User should not update this REFOCON register) Position  */
#define CRU_REFO4CON_ACTIVE_NOT_ACTIVE        (CRU_REFO4CON_ACTIVE_NOT_ACTIVE_Val << CRU_REFO4CON_ACTIVE_Pos) /* (CRU_REFO4CON) Reference clock request is not active (User can update this REFOCON register) Position  */
#define CRU_REFO4CON_DIVSWEN_Pos              _UINT32_(9)                                          /* (CRU_REFO4CON) Clock RODIV/ROTRIM switch enabled. Position */
#define CRU_REFO4CON_DIVSWEN_Msk              (_UINT32_(0x1) << CRU_REFO4CON_DIVSWEN_Pos)          /* (CRU_REFO4CON) Clock RODIV/ROTRIM switch enabled. Mask */
#define CRU_REFO4CON_DIVSWEN(value)           (CRU_REFO4CON_DIVSWEN_Msk & (_UINT32_(value) << CRU_REFO4CON_DIVSWEN_Pos)) /* Assigment of value for DIVSWEN in the CRU_REFO4CON register */
#define   CRU_REFO4CON_DIVSWEN_SWINPROGRESS_Val _UINT32_(0x1)                                        /* (CRU_REFO4CON) Clock Divider Switching currently in progress.  */
#define   CRU_REFO4CON_DIVSWEN_SWCOMPLETE_Val _UINT32_(0x0)                                        /* (CRU_REFO4CON) Clock Divider Switch has completed.  */
#define CRU_REFO4CON_DIVSWEN_SWINPROGRESS     (CRU_REFO4CON_DIVSWEN_SWINPROGRESS_Val << CRU_REFO4CON_DIVSWEN_Pos) /* (CRU_REFO4CON) Clock Divider Switching currently in progress. Position  */
#define CRU_REFO4CON_DIVSWEN_SWCOMPLETE       (CRU_REFO4CON_DIVSWEN_SWCOMPLETE_Val << CRU_REFO4CON_DIVSWEN_Pos) /* (CRU_REFO4CON) Clock Divider Switch has completed. Position  */
#define CRU_REFO4CON_RSLP_Pos                 _UINT32_(11)                                         /* (CRU_REFO4CON) Reference Oscillator Run in Sleep bit Position */
#define CRU_REFO4CON_RSLP_Msk                 (_UINT32_(0x1) << CRU_REFO4CON_RSLP_Pos)             /* (CRU_REFO4CON) Reference Oscillator Run in Sleep bit Mask */
#define CRU_REFO4CON_RSLP(value)              (CRU_REFO4CON_RSLP_Msk & (_UINT32_(value) << CRU_REFO4CON_RSLP_Pos)) /* Assigment of value for RSLP in the CRU_REFO4CON register */
#define   CRU_REFO4CON_RSLP_RSLP_Val          _UINT32_(0x1)                                        /* (CRU_REFO4CON) Reference Oscillator output continues to run in Sleep  */
#define   CRU_REFO4CON_RSLP_NO_RSLP_Val       _UINT32_(0x0)                                        /* (CRU_REFO4CON) Reference Oscillator output is disabled in Sleep  */
#define CRU_REFO4CON_RSLP_RSLP                (CRU_REFO4CON_RSLP_RSLP_Val << CRU_REFO4CON_RSLP_Pos) /* (CRU_REFO4CON) Reference Oscillator output continues to run in Sleep Position  */
#define CRU_REFO4CON_RSLP_NO_RSLP             (CRU_REFO4CON_RSLP_NO_RSLP_Val << CRU_REFO4CON_RSLP_Pos) /* (CRU_REFO4CON) Reference Oscillator output is disabled in Sleep Position  */
#define CRU_REFO4CON_OE_Pos                   _UINT32_(12)                                         /* (CRU_REFO4CON) Reference Clock Output Enable bit Position */
#define CRU_REFO4CON_OE_Msk                   (_UINT32_(0x1) << CRU_REFO4CON_OE_Pos)               /* (CRU_REFO4CON) Reference Clock Output Enable bit Mask */
#define CRU_REFO4CON_OE(value)                (CRU_REFO4CON_OE_Msk & (_UINT32_(value) << CRU_REFO4CON_OE_Pos)) /* Assigment of value for OE in the CRU_REFO4CON register */
#define   CRU_REFO4CON_OE_REFO4_OE_Val        _UINT32_(0x1)                                        /* (CRU_REFO4CON) Reference clock is driven out on REFO4 pin  */
#define   CRU_REFO4CON_OE_NO_REFO4_OE_Val     _UINT32_(0x0)                                        /* (CRU_REFO4CON) Reference clock is not driven out on REFO4 pin.  */
#define CRU_REFO4CON_OE_REFO4_OE              (CRU_REFO4CON_OE_REFO4_OE_Val << CRU_REFO4CON_OE_Pos) /* (CRU_REFO4CON) Reference clock is driven out on REFO4 pin Position  */
#define CRU_REFO4CON_OE_NO_REFO4_OE           (CRU_REFO4CON_OE_NO_REFO4_OE_Val << CRU_REFO4CON_OE_Pos) /* (CRU_REFO4CON) Reference clock is not driven out on REFO4 pin. Position  */
#define CRU_REFO4CON_SIDL_Pos                 _UINT32_(13)                                         /* (CRU_REFO4CON) Peripheral Stop in Idle Mode bit Position */
#define CRU_REFO4CON_SIDL_Msk                 (_UINT32_(0x1) << CRU_REFO4CON_SIDL_Pos)             /* (CRU_REFO4CON) Peripheral Stop in Idle Mode bit Mask */
#define CRU_REFO4CON_SIDL(value)              (CRU_REFO4CON_SIDL_Msk & (_UINT32_(value) << CRU_REFO4CON_SIDL_Pos)) /* Assigment of value for SIDL in the CRU_REFO4CON register */
#define   CRU_REFO4CON_SIDL_SIDL_Val          _UINT32_(0x1)                                        /* (CRU_REFO4CON) Discontinue module operation when device enters Idle mode  */
#define   CRU_REFO4CON_SIDL_NO_SIDL_Val       _UINT32_(0x0)                                        /* (CRU_REFO4CON) Continue module operation in Idle mode  */
#define CRU_REFO4CON_SIDL_SIDL                (CRU_REFO4CON_SIDL_SIDL_Val << CRU_REFO4CON_SIDL_Pos) /* (CRU_REFO4CON) Discontinue module operation when device enters Idle mode Position  */
#define CRU_REFO4CON_SIDL_NO_SIDL             (CRU_REFO4CON_SIDL_NO_SIDL_Val << CRU_REFO4CON_SIDL_Pos) /* (CRU_REFO4CON) Continue module operation in Idle mode Position  */
#define CRU_REFO4CON_FRZ_Pos                  _UINT32_(14)                                         /* (CRU_REFO4CON) Freeze in Debug mode bit Position */
#define CRU_REFO4CON_FRZ_Msk                  (_UINT32_(0x1) << CRU_REFO4CON_FRZ_Pos)              /* (CRU_REFO4CON) Freeze in Debug mode bit Mask */
#define CRU_REFO4CON_FRZ(value)               (CRU_REFO4CON_FRZ_Msk & (_UINT32_(value) << CRU_REFO4CON_FRZ_Pos)) /* Assigment of value for FRZ in the CRU_REFO4CON register */
#define   CRU_REFO4CON_FRZ_FRZ_Val            _UINT32_(0x1)                                        /* (CRU_REFO4CON) When emulator is in Debug mode, module freezes operation  */
#define   CRU_REFO4CON_FRZ_NO_FRZ_Val         _UINT32_(0x0)                                        /* (CRU_REFO4CON) When emulator is in Debug mode, module continues operation  */
#define CRU_REFO4CON_FRZ_FRZ                  (CRU_REFO4CON_FRZ_FRZ_Val << CRU_REFO4CON_FRZ_Pos)   /* (CRU_REFO4CON) When emulator is in Debug mode, module freezes operation Position  */
#define CRU_REFO4CON_FRZ_NO_FRZ               (CRU_REFO4CON_FRZ_NO_FRZ_Val << CRU_REFO4CON_FRZ_Pos) /* (CRU_REFO4CON) When emulator is in Debug mode, module continues operation Position  */
#define CRU_REFO4CON_ON_Pos                   _UINT32_(15)                                         /* (CRU_REFO4CON) Output Enable bit Position */
#define CRU_REFO4CON_ON_Msk                   (_UINT32_(0x1) << CRU_REFO4CON_ON_Pos)               /* (CRU_REFO4CON) Output Enable bit Mask */
#define CRU_REFO4CON_ON(value)                (CRU_REFO4CON_ON_Msk & (_UINT32_(value) << CRU_REFO4CON_ON_Pos)) /* Assigment of value for ON in the CRU_REFO4CON register */
#define   CRU_REFO4CON_ON_ON_Val              _UINT32_(0x1)                                        /* (CRU_REFO4CON) Reference Oscillator Module enabled  */
#define   CRU_REFO4CON_ON_OFF_Val             _UINT32_(0x0)                                        /* (CRU_REFO4CON) Reference Oscillator Module disabled  */
#define CRU_REFO4CON_ON_ON                    (CRU_REFO4CON_ON_ON_Val << CRU_REFO4CON_ON_Pos)      /* (CRU_REFO4CON) Reference Oscillator Module enabled Position  */
#define CRU_REFO4CON_ON_OFF                   (CRU_REFO4CON_ON_OFF_Val << CRU_REFO4CON_ON_Pos)     /* (CRU_REFO4CON) Reference Oscillator Module disabled Position  */
#define CRU_REFO4CON_RODIV_Pos                _UINT32_(16)                                         /* (CRU_REFO4CON) Reference Clock Divider bits Position */
#define CRU_REFO4CON_RODIV_Msk                (_UINT32_(0x7FFF) << CRU_REFO4CON_RODIV_Pos)         /* (CRU_REFO4CON) Reference Clock Divider bits Mask */
#define CRU_REFO4CON_RODIV(value)             (CRU_REFO4CON_RODIV_Msk & (_UINT32_(value) << CRU_REFO4CON_RODIV_Pos)) /* Assigment of value for RODIV in the CRU_REFO4CON register */
#define   CRU_REFO4CON_RODIV_65K_Val          _UINT32_(0x7FFF)                                     /* (CRU_REFO4CON) REFO4 clock is Base clock frequency divided by 65,534 (32,767 *2)  */
#define   CRU_REFO4CON_RODIV_4_Val            _UINT32_(0x2)                                        /* (CRU_REFO4CON) REFO4 clock is Base clock frequency divided by 4 (2*2)  */
#define   CRU_REFO4CON_RODIV_2_Val            _UINT32_(0x1)                                        /* (CRU_REFO4CON) REFO4 clock is Base clock frequency divided by 2 (1*2)  */
#define   CRU_REFO4CON_RODIV_NONE_Val         _UINT32_(0x0)                                        /* (CRU_REFO4CON) REFO4 clock is same frequency as Base clock (no divider)  */
#define CRU_REFO4CON_RODIV_65K                (CRU_REFO4CON_RODIV_65K_Val << CRU_REFO4CON_RODIV_Pos) /* (CRU_REFO4CON) REFO4 clock is Base clock frequency divided by 65,534 (32,767 *2) Position  */
#define CRU_REFO4CON_RODIV_4                  (CRU_REFO4CON_RODIV_4_Val << CRU_REFO4CON_RODIV_Pos) /* (CRU_REFO4CON) REFO4 clock is Base clock frequency divided by 4 (2*2) Position  */
#define CRU_REFO4CON_RODIV_2                  (CRU_REFO4CON_RODIV_2_Val << CRU_REFO4CON_RODIV_Pos) /* (CRU_REFO4CON) REFO4 clock is Base clock frequency divided by 2 (1*2) Position  */
#define CRU_REFO4CON_RODIV_NONE               (CRU_REFO4CON_RODIV_NONE_Val << CRU_REFO4CON_RODIV_Pos) /* (CRU_REFO4CON) REFO4 clock is same frequency as Base clock (no divider) Position  */
#define CRU_REFO4CON_Msk                      _UINT32_(0x7FFFFB0F)                                 /* (CRU_REFO4CON) Register Mask  */


/* -------- CRU_REFO4CONCLR : (CRU Offset: 0xD4) (R/W 32)  -------- */
#define CRU_REFO4CONCLR_RESETVALUE            _UINT32_(0x00)                                       /*  (CRU_REFO4CONCLR)   Reset Value */

#define CRU_REFO4CONCLR_Msk                   _UINT32_(0x00000000)                                 /* (CRU_REFO4CONCLR) Register Mask  */


/* -------- CRU_REFO4CONSET : (CRU Offset: 0xD8) (R/W 32)  -------- */
#define CRU_REFO4CONSET_RESETVALUE            _UINT32_(0x00)                                       /*  (CRU_REFO4CONSET)   Reset Value */

#define CRU_REFO4CONSET_Msk                   _UINT32_(0x00000000)                                 /* (CRU_REFO4CONSET) Register Mask  */


/* -------- CRU_REFO4CONINV : (CRU Offset: 0xDC) (R/W 32)  -------- */
#define CRU_REFO4CONINV_RESETVALUE            _UINT32_(0x00)                                       /*  (CRU_REFO4CONINV)   Reset Value */

#define CRU_REFO4CONINV_Msk                   _UINT32_(0x00000000)                                 /* (CRU_REFO4CONINV) Register Mask  */


/* -------- CRU_REFO4TRIM : (CRU Offset: 0xE0) (R/W 32) REFERENCE OSCILLATOR 4 TRIM REGISTER -------- */
#define CRU_REFO4TRIM_RESETVALUE              _UINT32_(0x00)                                       /*  (CRU_REFO4TRIM) REFERENCE OSCILLATOR 4 TRIM REGISTER  Reset Value */

#define CRU_REFO4TRIM_ROTRIM_Pos              _UINT32_(23)                                         /* (CRU_REFO4TRIM) Trim bits - Provides fractional additive to RODIV value for 1/2 period of REFO1 clock Position */
#define CRU_REFO4TRIM_ROTRIM_Msk              (_UINT32_(0x1FF) << CRU_REFO4TRIM_ROTRIM_Pos)        /* (CRU_REFO4TRIM) Trim bits - Provides fractional additive to RODIV value for 1/2 period of REFO1 clock Mask */
#define CRU_REFO4TRIM_ROTRIM(value)           (CRU_REFO4TRIM_ROTRIM_Msk & (_UINT32_(value) << CRU_REFO4TRIM_ROTRIM_Pos)) /* Assigment of value for ROTRIM in the CRU_REFO4TRIM register */
#define   CRU_REFO4TRIM_ROTRIM_ZERO_Val       _UINT32_(0x0)                                        /* (CRU_REFO4TRIM) 0/512 (0.0) divisor added to RODIV value  */
#define   CRU_REFO4TRIM_ROTRIM_1_Val          _UINT32_(0x1)                                        /* (CRU_REFO4TRIM) 1/512 (0.001953125) divisor added to RODIV value  */
#define   CRU_REFO4TRIM_ROTRIM_2_Val          _UINT32_(0x2)                                        /* (CRU_REFO4TRIM) 2/512 (0.00390625) divisor added to RODIV value  */
#define   CRU_REFO4TRIM_ROTRIM_256_Val        _UINT32_(0x100)                                      /* (CRU_REFO4TRIM) 256/512 (0.5000) divisor added to RODIV value  */
#define   CRU_REFO4TRIM_ROTRIM_511_Val        _UINT32_(0x1FF)                                      /* (CRU_REFO4TRIM) 511/512 (0.998046875) divisor added to RODIV value  */
#define CRU_REFO4TRIM_ROTRIM_ZERO             (CRU_REFO4TRIM_ROTRIM_ZERO_Val << CRU_REFO4TRIM_ROTRIM_Pos) /* (CRU_REFO4TRIM) 0/512 (0.0) divisor added to RODIV value Position  */
#define CRU_REFO4TRIM_ROTRIM_1                (CRU_REFO4TRIM_ROTRIM_1_Val << CRU_REFO4TRIM_ROTRIM_Pos) /* (CRU_REFO4TRIM) 1/512 (0.001953125) divisor added to RODIV value Position  */
#define CRU_REFO4TRIM_ROTRIM_2                (CRU_REFO4TRIM_ROTRIM_2_Val << CRU_REFO4TRIM_ROTRIM_Pos) /* (CRU_REFO4TRIM) 2/512 (0.00390625) divisor added to RODIV value Position  */
#define CRU_REFO4TRIM_ROTRIM_256              (CRU_REFO4TRIM_ROTRIM_256_Val << CRU_REFO4TRIM_ROTRIM_Pos) /* (CRU_REFO4TRIM) 256/512 (0.5000) divisor added to RODIV value Position  */
#define CRU_REFO4TRIM_ROTRIM_511              (CRU_REFO4TRIM_ROTRIM_511_Val << CRU_REFO4TRIM_ROTRIM_Pos) /* (CRU_REFO4TRIM) 511/512 (0.998046875) divisor added to RODIV value Position  */
#define CRU_REFO4TRIM_Msk                     _UINT32_(0xFF800000)                                 /* (CRU_REFO4TRIM) Register Mask  */


/* -------- CRU_REFO4TRIMCLR : (CRU Offset: 0xE4) (R/W 32)  -------- */
#define CRU_REFO4TRIMCLR_RESETVALUE           _UINT32_(0x00)                                       /*  (CRU_REFO4TRIMCLR)   Reset Value */

#define CRU_REFO4TRIMCLR_Msk                  _UINT32_(0x00000000)                                 /* (CRU_REFO4TRIMCLR) Register Mask  */


/* -------- CRU_REFO4TRIMSET : (CRU Offset: 0xE8) (R/W 32)  -------- */
#define CRU_REFO4TRIMSET_RESETVALUE           _UINT32_(0x00)                                       /*  (CRU_REFO4TRIMSET)   Reset Value */

#define CRU_REFO4TRIMSET_Msk                  _UINT32_(0x00000000)                                 /* (CRU_REFO4TRIMSET) Register Mask  */


/* -------- CRU_REFO4TRIMINV : (CRU Offset: 0xEC) (R/W 32)  -------- */
#define CRU_REFO4TRIMINV_RESETVALUE           _UINT32_(0x00)                                       /*  (CRU_REFO4TRIMINV)   Reset Value */

#define CRU_REFO4TRIMINV_Msk                  _UINT32_(0x00000000)                                 /* (CRU_REFO4TRIMINV) Register Mask  */


/* -------- CRU_REFO5CON : (CRU Offset: 0xF0) (R/W 32) REFERENCE OSCILLATOR 5 CONTROL REGISTER -------- */
#define CRU_REFO5CON_RESETVALUE               _UINT32_(0x00)                                       /*  (CRU_REFO5CON) REFERENCE OSCILLATOR 5 CONTROL REGISTER  Reset Value */
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
