nsaspook/wbz451matter/src/packs/WBZ451_DFP/component/dmac.h

/*
 * Component description for DMAC
 *
 * Copyright (c) 2023 Microchip Technology Inc. and its subsidiaries.
 *
 * Licensed under the Apache License, Version 2.0 (the "License");
 * you may not use this file except in compliance with the License.
 * You may obtain a copy of the License at
 *
 *   http://www.apache.org/licenses/LICENSE-2.0
 *
 * Unless required by applicable law or agreed to in writing, software
 * distributed under the License is distributed on an "AS IS" BASIS,
 * WITHOUT WARRANTIES OR CONDITIONS OF ANY KIND, either express or implied.
 * See the License for the specific language governing permissions and
 * limitations under the License.
 *
 */

/* file generated from device description file (ATDF) version 2023-10-17T09:04:59Z */
#ifndef _BZ45_DMAC_COMPONENT_H_
#define _BZ45_DMAC_COMPONENT_H_

/* ************************************************************************** */
/*   SOFTWARE API DEFINITION FOR DMAC                                         */
/* ************************************************************************** */

/* -------- DMAC_BTCTRL : (DMAC Offset: 0x00) (R/W 16) Block Transfer Control -------- */
#define DMAC_BTCTRL_RESETVALUE                _UINT16_(0x00)                                       /*  (DMAC_BTCTRL) Block Transfer Control  Reset Value */

#define DMAC_BTCTRL_VALID_Pos                 _UINT16_(0)                                          /* (DMAC_BTCTRL) Descriptor Valid Position */
#define DMAC_BTCTRL_VALID_Msk                 (_UINT16_(0x1) << DMAC_BTCTRL_VALID_Pos)             /* (DMAC_BTCTRL) Descriptor Valid Mask */
#define DMAC_BTCTRL_VALID(value)              (DMAC_BTCTRL_VALID_Msk & (_UINT16_(value) << DMAC_BTCTRL_VALID_Pos)) /* Assigment of value for VALID in the DMAC_BTCTRL register */
#define DMAC_BTCTRL_EVOSEL_Pos                _UINT16_(1)                                          /* (DMAC_BTCTRL) Block Event Output Selection Position */
#define DMAC_BTCTRL_EVOSEL_Msk                (_UINT16_(0x3) << DMAC_BTCTRL_EVOSEL_Pos)            /* (DMAC_BTCTRL) Block Event Output Selection Mask */
#define DMAC_BTCTRL_EVOSEL(value)             (DMAC_BTCTRL_EVOSEL_Msk & (_UINT16_(value) << DMAC_BTCTRL_EVOSEL_Pos)) /* Assigment of value for EVOSEL in the DMAC_BTCTRL register */
#define   DMAC_BTCTRL_EVOSEL_DISABLE_Val      _UINT16_(0x0)                                        /* (DMAC_BTCTRL) Event generation disabled  */
#define   DMAC_BTCTRL_EVOSEL_BLOCK_Val        _UINT16_(0x1)                                        /* (DMAC_BTCTRL) Block event strobe  */
#define   DMAC_BTCTRL_EVOSEL_BURST_Val        _UINT16_(0x3)                                        /* (DMAC_BTCTRL) Burst event strobe  */
#define DMAC_BTCTRL_EVOSEL_DISABLE            (DMAC_BTCTRL_EVOSEL_DISABLE_Val << DMAC_BTCTRL_EVOSEL_Pos) /* (DMAC_BTCTRL) Event generation disabled Position  */
#define DMAC_BTCTRL_EVOSEL_BLOCK              (DMAC_BTCTRL_EVOSEL_BLOCK_Val << DMAC_BTCTRL_EVOSEL_Pos) /* (DMAC_BTCTRL) Block event strobe Position  */
#define DMAC_BTCTRL_EVOSEL_BURST              (DMAC_BTCTRL_EVOSEL_BURST_Val << DMAC_BTCTRL_EVOSEL_Pos) /* (DMAC_BTCTRL) Burst event strobe Position  */
#define DMAC_BTCTRL_BLOCKACT_Pos              _UINT16_(3)                                          /* (DMAC_BTCTRL) Block Action Position */
#define DMAC_BTCTRL_BLOCKACT_Msk              (_UINT16_(0x3) << DMAC_BTCTRL_BLOCKACT_Pos)          /* (DMAC_BTCTRL) Block Action Mask */
#define DMAC_BTCTRL_BLOCKACT(value)           (DMAC_BTCTRL_BLOCKACT_Msk & (_UINT16_(value) << DMAC_BTCTRL_BLOCKACT_Pos)) /* Assigment of value for BLOCKACT in the DMAC_BTCTRL register */
#define   DMAC_BTCTRL_BLOCKACT_NOACT_Val      _UINT16_(0x0)                                        /* (DMAC_BTCTRL) Channel will be disabled if it is the last block transfer in the transaction  */
#define   DMAC_BTCTRL_BLOCKACT_INT_Val        _UINT16_(0x1)                                        /* (DMAC_BTCTRL) Channel will be disabled if it is the last block transfer in the transaction and block interrupt  */
#define   DMAC_BTCTRL_BLOCKACT_SUSPEND_Val    _UINT16_(0x2)                                        /* (DMAC_BTCTRL) Channel suspend operation is completed  */
#define   DMAC_BTCTRL_BLOCKACT_BOTH_Val       _UINT16_(0x3)                                        /* (DMAC_BTCTRL) Both channel suspend operation and block interrupt  */
#define DMAC_BTCTRL_BLOCKACT_NOACT            (DMAC_BTCTRL_BLOCKACT_NOACT_Val << DMAC_BTCTRL_BLOCKACT_Pos) /* (DMAC_BTCTRL) Channel will be disabled if it is the last block transfer in the transaction Position  */
#define DMAC_BTCTRL_BLOCKACT_INT              (DMAC_BTCTRL_BLOCKACT_INT_Val << DMAC_BTCTRL_BLOCKACT_Pos) /* (DMAC_BTCTRL) Channel will be disabled if it is the last block transfer in the transaction and block interrupt Position  */
#define DMAC_BTCTRL_BLOCKACT_SUSPEND          (DMAC_BTCTRL_BLOCKACT_SUSPEND_Val << DMAC_BTCTRL_BLOCKACT_Pos) /* (DMAC_BTCTRL) Channel suspend operation is completed Position  */
#define DMAC_BTCTRL_BLOCKACT_BOTH             (DMAC_BTCTRL_BLOCKACT_BOTH_Val << DMAC_BTCTRL_BLOCKACT_Pos) /* (DMAC_BTCTRL) Both channel suspend operation and block interrupt Position  */
#define DMAC_BTCTRL_BEATSIZE_Pos              _UINT16_(8)                                          /* (DMAC_BTCTRL) Beat Size Position */
#define DMAC_BTCTRL_BEATSIZE_Msk              (_UINT16_(0x3) << DMAC_BTCTRL_BEATSIZE_Pos)          /* (DMAC_BTCTRL) Beat Size Mask */
#define DMAC_BTCTRL_BEATSIZE(value)           (DMAC_BTCTRL_BEATSIZE_Msk & (_UINT16_(value) << DMAC_BTCTRL_BEATSIZE_Pos)) /* Assigment of value for BEATSIZE in the DMAC_BTCTRL register */
#define   DMAC_BTCTRL_BEATSIZE_BYTE_Val       _UINT16_(0x0)                                        /* (DMAC_BTCTRL) 8-bit bus transfer  */
#define   DMAC_BTCTRL_BEATSIZE_HWORD_Val      _UINT16_(0x1)                                        /* (DMAC_BTCTRL) 16-bit bus transfer  */
#define   DMAC_BTCTRL_BEATSIZE_WORD_Val       _UINT16_(0x2)                                        /* (DMAC_BTCTRL) 32-bit bus transfer  */
#define DMAC_BTCTRL_BEATSIZE_BYTE             (DMAC_BTCTRL_BEATSIZE_BYTE_Val << DMAC_BTCTRL_BEATSIZE_Pos) /* (DMAC_BTCTRL) 8-bit bus transfer Position  */
#define DMAC_BTCTRL_BEATSIZE_HWORD            (DMAC_BTCTRL_BEATSIZE_HWORD_Val << DMAC_BTCTRL_BEATSIZE_Pos) /* (DMAC_BTCTRL) 16-bit bus transfer Position  */
#define DMAC_BTCTRL_BEATSIZE_WORD             (DMAC_BTCTRL_BEATSIZE_WORD_Val << DMAC_BTCTRL_BEATSIZE_Pos) /* (DMAC_BTCTRL) 32-bit bus transfer Position  */
#define DMAC_BTCTRL_SRCINC_Pos                _UINT16_(10)                                         /* (DMAC_BTCTRL) Source Address Increment Enable Position */
#define DMAC_BTCTRL_SRCINC_Msk                (_UINT16_(0x1) << DMAC_BTCTRL_SRCINC_Pos)            /* (DMAC_BTCTRL) Source Address Increment Enable Mask */
#define DMAC_BTCTRL_SRCINC(value)             (DMAC_BTCTRL_SRCINC_Msk & (_UINT16_(value) << DMAC_BTCTRL_SRCINC_Pos)) /* Assigment of value for SRCINC in the DMAC_BTCTRL register */
#define DMAC_BTCTRL_DSTINC_Pos                _UINT16_(11)                                         /* (DMAC_BTCTRL) Destination Address Increment Enable Position */
#define DMAC_BTCTRL_DSTINC_Msk                (_UINT16_(0x1) << DMAC_BTCTRL_DSTINC_Pos)            /* (DMAC_BTCTRL) Destination Address Increment Enable Mask */
#define DMAC_BTCTRL_DSTINC(value)             (DMAC_BTCTRL_DSTINC_Msk & (_UINT16_(value) << DMAC_BTCTRL_DSTINC_Pos)) /* Assigment of value for DSTINC in the DMAC_BTCTRL register */
#define DMAC_BTCTRL_STEPSEL_Pos               _UINT16_(12)                                         /* (DMAC_BTCTRL) Step Selection Position */
#define DMAC_BTCTRL_STEPSEL_Msk               (_UINT16_(0x1) << DMAC_BTCTRL_STEPSEL_Pos)           /* (DMAC_BTCTRL) Step Selection Mask */
#define DMAC_BTCTRL_STEPSEL(value)            (DMAC_BTCTRL_STEPSEL_Msk & (_UINT16_(value) << DMAC_BTCTRL_STEPSEL_Pos)) /* Assigment of value for STEPSEL in the DMAC_BTCTRL register */
#define   DMAC_BTCTRL_STEPSEL_DST_Val         _UINT16_(0x0)                                        /* (DMAC_BTCTRL) Step size settings apply to the destination address  */
#define   DMAC_BTCTRL_STEPSEL_SRC_Val         _UINT16_(0x1)                                        /* (DMAC_BTCTRL) Step size settings apply to the source address  */
#define DMAC_BTCTRL_STEPSEL_DST               (DMAC_BTCTRL_STEPSEL_DST_Val << DMAC_BTCTRL_STEPSEL_Pos) /* (DMAC_BTCTRL) Step size settings apply to the destination address Position  */
#define DMAC_BTCTRL_STEPSEL_SRC               (DMAC_BTCTRL_STEPSEL_SRC_Val << DMAC_BTCTRL_STEPSEL_Pos) /* (DMAC_BTCTRL) Step size settings apply to the source address Position  */
#define DMAC_BTCTRL_STEPSIZE_Pos              _UINT16_(13)                                         /* (DMAC_BTCTRL) Address Increment Step Size Position */
#define DMAC_BTCTRL_STEPSIZE_Msk              (_UINT16_(0x7) << DMAC_BTCTRL_STEPSIZE_Pos)          /* (DMAC_BTCTRL) Address Increment Step Size Mask */
#define DMAC_BTCTRL_STEPSIZE(value)           (DMAC_BTCTRL_STEPSIZE_Msk & (_UINT16_(value) << DMAC_BTCTRL_STEPSIZE_Pos)) /* Assigment of value for STEPSIZE in the DMAC_BTCTRL register */
#define   DMAC_BTCTRL_STEPSIZE_X1_Val         _UINT16_(0x0)                                        /* (DMAC_BTCTRL) Next ADDR = ADDR + (1<<BEATSIZE) * 1  */
#define   DMAC_BTCTRL_STEPSIZE_X2_Val         _UINT16_(0x1)                                        /* (DMAC_BTCTRL) Next ADDR = ADDR + (1<<BEATSIZE) * 2  */
#define   DMAC_BTCTRL_STEPSIZE_X4_Val         _UINT16_(0x2)                                        /* (DMAC_BTCTRL) Next ADDR = ADDR + (1<<BEATSIZE) * 4  */
#define   DMAC_BTCTRL_STEPSIZE_X8_Val         _UINT16_(0x3)                                        /* (DMAC_BTCTRL) Next ADDR = ADDR + (1<<BEATSIZE) * 8  */
#define   DMAC_BTCTRL_STEPSIZE_X16_Val        _UINT16_(0x4)                                        /* (DMAC_BTCTRL) Next ADDR = ADDR + (1<<BEATSIZE) * 16  */
#define   DMAC_BTCTRL_STEPSIZE_X32_Val        _UINT16_(0x5)                                        /* (DMAC_BTCTRL) Next ADDR = ADDR + (1<<BEATSIZE) * 32  */
#define   DMAC_BTCTRL_STEPSIZE_X64_Val        _UINT16_(0x6)                                        /* (DMAC_BTCTRL) Next ADDR = ADDR + (1<<BEATSIZE) * 64  */
#define   DMAC_BTCTRL_STEPSIZE_X128_Val       _UINT16_(0x7)                                        /* (DMAC_BTCTRL) Next ADDR = ADDR + (1<<BEATSIZE) * 128  */
#define DMAC_BTCTRL_STEPSIZE_X1               (DMAC_BTCTRL_STEPSIZE_X1_Val << DMAC_BTCTRL_STEPSIZE_Pos) /* (DMAC_BTCTRL) Next ADDR = ADDR + (1<<BEATSIZE) * 1 Position  */
#define DMAC_BTCTRL_STEPSIZE_X2               (DMAC_BTCTRL_STEPSIZE_X2_Val << DMAC_BTCTRL_STEPSIZE_Pos) /* (DMAC_BTCTRL) Next ADDR = ADDR + (1<<BEATSIZE) * 2 Position  */
#define DMAC_BTCTRL_STEPSIZE_X4               (DMAC_BTCTRL_STEPSIZE_X4_Val << DMAC_BTCTRL_STEPSIZE_Pos) /* (DMAC_BTCTRL) Next ADDR = ADDR + (1<<BEATSIZE) * 4 Position  */
#define DMAC_BTCTRL_STEPSIZE_X8               (DMAC_BTCTRL_STEPSIZE_X8_Val << DMAC_BTCTRL_STEPSIZE_Pos) /* (DMAC_BTCTRL) Next ADDR = ADDR + (1<<BEATSIZE) * 8 Position  */
#define DMAC_BTCTRL_STEPSIZE_X16              (DMAC_BTCTRL_STEPSIZE_X16_Val << DMAC_BTCTRL_STEPSIZE_Pos) /* (DMAC_BTCTRL) Next ADDR = ADDR + (1<<BEATSIZE) * 16 Position  */
#define DMAC_BTCTRL_STEPSIZE_X32              (DMAC_BTCTRL_STEPSIZE_X32_Val << DMAC_BTCTRL_STEPSIZE_Pos) /* (DMAC_BTCTRL) Next ADDR = ADDR + (1<<BEATSIZE) * 32 Position  */
#define DMAC_BTCTRL_STEPSIZE_X64              (DMAC_BTCTRL_STEPSIZE_X64_Val << DMAC_BTCTRL_STEPSIZE_Pos) /* (DMAC_BTCTRL) Next ADDR = ADDR + (1<<BEATSIZE) * 64 Position  */
#define DMAC_BTCTRL_STEPSIZE_X128             (DMAC_BTCTRL_STEPSIZE_X128_Val << DMAC_BTCTRL_STEPSIZE_Pos) /* (DMAC_BTCTRL) Next ADDR = ADDR + (1<<BEATSIZE) * 128 Position  */
#define DMAC_BTCTRL_Msk                       _UINT16_(0xFF1F)                                     /* (DMAC_BTCTRL) Register Mask  */


/* -------- DMAC_BTCNT : (DMAC Offset: 0x02) (R/W 16) Block Transfer Count -------- */
#define DMAC_BTCNT_RESETVALUE                 _UINT16_(0x00)                                       /*  (DMAC_BTCNT) Block Transfer Count  Reset Value */

#define DMAC_BTCNT_BTCNT_Pos                  _UINT16_(0)                                          /* (DMAC_BTCNT) Block Transfer Count Position */
#define DMAC_BTCNT_BTCNT_Msk                  (_UINT16_(0xFFFF) << DMAC_BTCNT_BTCNT_Pos)           /* (DMAC_BTCNT) Block Transfer Count Mask */
#define DMAC_BTCNT_BTCNT(value)               (DMAC_BTCNT_BTCNT_Msk & (_UINT16_(value) << DMAC_BTCNT_BTCNT_Pos)) /* Assigment of value for BTCNT in the DMAC_BTCNT register */
#define DMAC_BTCNT_Msk                        _UINT16_(0xFFFF)                                     /* (DMAC_BTCNT) Register Mask  */


/* -------- DMAC_SRCADDR : (DMAC Offset: 0x04) (R/W 32) Block Transfer Source Address -------- */
#define DMAC_SRCADDR_RESETVALUE               _UINT32_(0x00)                                       /*  (DMAC_SRCADDR) Block Transfer Source Address  Reset Value */

#define DMAC_SRCADDR_SRCADDR_Pos              _UINT32_(0)                                          /* (DMAC_SRCADDR) Transfer Source Address Position */
#define DMAC_SRCADDR_SRCADDR_Msk              (_UINT32_(0xFFFFFFFF) << DMAC_SRCADDR_SRCADDR_Pos)   /* (DMAC_SRCADDR) Transfer Source Address Mask */
#define DMAC_SRCADDR_SRCADDR(value)           (DMAC_SRCADDR_SRCADDR_Msk & (_UINT32_(value) << DMAC_SRCADDR_SRCADDR_Pos)) /* Assigment of value for SRCADDR in the DMAC_SRCADDR register */
#define DMAC_SRCADDR_Msk                      _UINT32_(0xFFFFFFFF)                                 /* (DMAC_SRCADDR) Register Mask  */


/* -------- DMAC_DSTADDR : (DMAC Offset: 0x08) (R/W 32) Block Transfer Destination Address -------- */
#define DMAC_DSTADDR_DSTADDR_Pos              _UINT32_(0)                                          /* (DMAC_DSTADDR) Transfer Destination Address Position */
#define DMAC_DSTADDR_DSTADDR_Msk              (_UINT32_(0xFFFFFFFF) << DMAC_DSTADDR_DSTADDR_Pos)   /* (DMAC_DSTADDR) Transfer Destination Address Mask */
#define DMAC_DSTADDR_DSTADDR(value)           (DMAC_DSTADDR_DSTADDR_Msk & (_UINT32_(value) << DMAC_DSTADDR_DSTADDR_Pos)) /* Assigment of value for DSTADDR in the DMAC_DSTADDR register */
#define DMAC_DSTADDR_Msk                      _UINT32_(0xFFFFFFFF)                                 /* (DMAC_DSTADDR) Register Mask  */

/* CRC mode */
#define DMAC_DSTADDR_CRC_CHKINIT_Pos          _UINT32_(0)                                          /* (DMAC_DSTADDR) CRC Checksum Initial Value Position */
#define DMAC_DSTADDR_CRC_CHKINIT_Msk          (_UINT32_(0xFFFFFFFF) << DMAC_DSTADDR_CRC_CHKINIT_Pos) /* (DMAC_DSTADDR) CRC Checksum Initial Value Mask */
#define DMAC_DSTADDR_CRC_CHKINIT(value)       (DMAC_DSTADDR_CRC_CHKINIT_Msk & (_UINT32_(value) << DMAC_DSTADDR_CRC_CHKINIT_Pos))
#define DMAC_DSTADDR_CRC_Msk                  _UINT32_(0xFFFFFFFF)                                  /* (DMAC_DSTADDR_CRC) Register Mask  */


/* -------- DMAC_DESCADDR : (DMAC Offset: 0x0C) (R/W 32) Next Descriptor Address -------- */
#define DMAC_DESCADDR_DESCADDR_Pos            _UINT32_(0)                                          /* (DMAC_DESCADDR) Next Descriptor Address Position */
#define DMAC_DESCADDR_DESCADDR_Msk            (_UINT32_(0xFFFFFFFF) << DMAC_DESCADDR_DESCADDR_Pos) /* (DMAC_DESCADDR) Next Descriptor Address Mask */
#define DMAC_DESCADDR_DESCADDR(value)         (DMAC_DESCADDR_DESCADDR_Msk & (_UINT32_(value) << DMAC_DESCADDR_DESCADDR_Pos)) /* Assigment of value for DESCADDR in the DMAC_DESCADDR register */
#define DMAC_DESCADDR_Msk                     _UINT32_(0xFFFFFFFF)                                 /* (DMAC_DESCADDR) Register Mask  */


/* -------- DMAC_CHCTRLA : (DMAC Offset: 0x00) (R/W 32) Channel n Control A -------- */
#define DMAC_CHCTRLA_RESETVALUE               _UINT32_(0x00)                                       /*  (DMAC_CHCTRLA) Channel n Control A  Reset Value */

#define DMAC_CHCTRLA_SWRST_Pos                _UINT32_(0)                                          /* (DMAC_CHCTRLA) Channel Software Reset Position */
#define DMAC_CHCTRLA_SWRST_Msk                (_UINT32_(0x1) << DMAC_CHCTRLA_SWRST_Pos)            /* (DMAC_CHCTRLA) Channel Software Reset Mask */
#define DMAC_CHCTRLA_SWRST(value)             (DMAC_CHCTRLA_SWRST_Msk & (_UINT32_(value) << DMAC_CHCTRLA_SWRST_Pos)) /* Assigment of value for SWRST in the DMAC_CHCTRLA register */
#define DMAC_CHCTRLA_ENABLE_Pos               _UINT32_(1)                                          /* (DMAC_CHCTRLA) Channel Enable Position */
#define DMAC_CHCTRLA_ENABLE_Msk               (_UINT32_(0x1) << DMAC_CHCTRLA_ENABLE_Pos)           /* (DMAC_CHCTRLA) Channel Enable Mask */
#define DMAC_CHCTRLA_ENABLE(value)            (DMAC_CHCTRLA_ENABLE_Msk & (_UINT32_(value) << DMAC_CHCTRLA_ENABLE_Pos)) /* Assigment of value for ENABLE in the DMAC_CHCTRLA register */
#define DMAC_CHCTRLA_RUNSTDBY_Pos             _UINT32_(6)                                          /* (DMAC_CHCTRLA) Channel Run in Standby Position */
#define DMAC_CHCTRLA_RUNSTDBY_Msk             (_UINT32_(0x1) << DMAC_CHCTRLA_RUNSTDBY_Pos)         /* (DMAC_CHCTRLA) Channel Run in Standby Mask */
#define DMAC_CHCTRLA_RUNSTDBY(value)          (DMAC_CHCTRLA_RUNSTDBY_Msk & (_UINT32_(value) << DMAC_CHCTRLA_RUNSTDBY_Pos)) /* Assigment of value for RUNSTDBY in the DMAC_CHCTRLA register */
#define DMAC_CHCTRLA_TRIGSRC_Pos              _UINT32_(8)                                          /* (DMAC_CHCTRLA) Trigger Source Position */
#define DMAC_CHCTRLA_TRIGSRC_Msk              (_UINT32_(0x7F) << DMAC_CHCTRLA_TRIGSRC_Pos)         /* (DMAC_CHCTRLA) Trigger Source Mask */
#define DMAC_CHCTRLA_TRIGSRC(value)           (DMAC_CHCTRLA_TRIGSRC_Msk & (_UINT32_(value) << DMAC_CHCTRLA_TRIGSRC_Pos)) /* Assigment of value for TRIGSRC in the DMAC_CHCTRLA register */
#define   DMAC_CHCTRLA_TRIGSRC_DISABLE_Val    _UINT32_(0x0)                                        /* (DMAC_CHCTRLA) Only software/event triggers  */
#define DMAC_CHCTRLA_TRIGSRC_DISABLE          (DMAC_CHCTRLA_TRIGSRC_DISABLE_Val << DMAC_CHCTRLA_TRIGSRC_Pos) /* (DMAC_CHCTRLA) Only software/event triggers Position  */
#define DMAC_CHCTRLA_TRIGACT_Pos              _UINT32_(20)                                         /* (DMAC_CHCTRLA) Trigger Action Position */
#define DMAC_CHCTRLA_TRIGACT_Msk              (_UINT32_(0x3) << DMAC_CHCTRLA_TRIGACT_Pos)          /* (DMAC_CHCTRLA) Trigger Action Mask */
#define DMAC_CHCTRLA_TRIGACT(value)           (DMAC_CHCTRLA_TRIGACT_Msk & (_UINT32_(value) << DMAC_CHCTRLA_TRIGACT_Pos)) /* Assigment of value for TRIGACT in the DMAC_CHCTRLA register */
#define   DMAC_CHCTRLA_TRIGACT_BLOCK_Val      _UINT32_(0x0)                                        /* (DMAC_CHCTRLA) One trigger required for each block transfer  */
#define   DMAC_CHCTRLA_TRIGACT_BURST_Val      _UINT32_(0x2)                                        /* (DMAC_CHCTRLA) One trigger required for each burst transfer  */
#define   DMAC_CHCTRLA_TRIGACT_TRANSACTION_Val _UINT32_(0x3)                                        /* (DMAC_CHCTRLA) One trigger required for each transaction  */
#define DMAC_CHCTRLA_TRIGACT_BLOCK            (DMAC_CHCTRLA_TRIGACT_BLOCK_Val << DMAC_CHCTRLA_TRIGACT_Pos) /* (DMAC_CHCTRLA) One trigger required for each block transfer Position  */
#define DMAC_CHCTRLA_TRIGACT_BURST            (DMAC_CHCTRLA_TRIGACT_BURST_Val << DMAC_CHCTRLA_TRIGACT_Pos) /* (DMAC_CHCTRLA) One trigger required for each burst transfer Position  */
#define DMAC_CHCTRLA_TRIGACT_TRANSACTION      (DMAC_CHCTRLA_TRIGACT_TRANSACTION_Val << DMAC_CHCTRLA_TRIGACT_Pos) /* (DMAC_CHCTRLA) One trigger required for each transaction Position  */
#define DMAC_CHCTRLA_BURSTLEN_Pos             _UINT32_(24)                                         /* (DMAC_CHCTRLA) Burst Length Position */
#define DMAC_CHCTRLA_BURSTLEN_Msk             (_UINT32_(0xF) << DMAC_CHCTRLA_BURSTLEN_Pos)         /* (DMAC_CHCTRLA) Burst Length Mask */
#define DMAC_CHCTRLA_BURSTLEN(value)          (DMAC_CHCTRLA_BURSTLEN_Msk & (_UINT32_(value) << DMAC_CHCTRLA_BURSTLEN_Pos)) /* Assigment of value for BURSTLEN in the DMAC_CHCTRLA register */
#define   DMAC_CHCTRLA_BURSTLEN_SINGLE_Val    _UINT32_(0x0)                                        /* (DMAC_CHCTRLA) Single-beat burst length  */
#define   DMAC_CHCTRLA_BURSTLEN_2BEAT_Val     _UINT32_(0x1)                                        /* (DMAC_CHCTRLA) 2-beats burst length  */
#define   DMAC_CHCTRLA_BURSTLEN_3BEAT_Val     _UINT32_(0x2)                                        /* (DMAC_CHCTRLA) 3-beats burst length  */
#define   DMAC_CHCTRLA_BURSTLEN_4BEAT_Val     _UINT32_(0x3)                                        /* (DMAC_CHCTRLA) 4-beats burst length  */
#define   DMAC_CHCTRLA_BURSTLEN_5BEAT_Val     _UINT32_(0x4)                                        /* (DMAC_CHCTRLA) 5-beats burst length  */
#define   DMAC_CHCTRLA_BURSTLEN_6BEAT_Val     _UINT32_(0x5)                                        /* (DMAC_CHCTRLA) 6-beats burst length  */
#define   DMAC_CHCTRLA_BURSTLEN_7BEAT_Val     _UINT32_(0x6)                                        /* (DMAC_CHCTRLA) 7-beats burst length  */
#define   DMAC_CHCTRLA_BURSTLEN_8BEAT_Val     _UINT32_(0x7)                                        /* (DMAC_CHCTRLA) 8-beats burst length  */
#define   DMAC_CHCTRLA_BURSTLEN_9BEAT_Val     _UINT32_(0x8)                                        /* (DMAC_CHCTRLA) 9-beats burst length  */
#define   DMAC_CHCTRLA_BURSTLEN_10BEAT_Val    _UINT32_(0x9)                                        /* (DMAC_CHCTRLA) 10-beats burst length  */
#define   DMAC_CHCTRLA_BURSTLEN_11BEAT_Val    _UINT32_(0xA)                                        /* (DMAC_CHCTRLA) 11-beats burst length  */
#define   DMAC_CHCTRLA_BURSTLEN_12BEAT_Val    _UINT32_(0xB)                                        /* (DMAC_CHCTRLA) 12-beats burst length  */
#define   DMAC_CHCTRLA_BURSTLEN_13BEAT_Val    _UINT32_(0xC)                                        /* (DMAC_CHCTRLA) 13-beats burst length  */
#define   DMAC_CHCTRLA_BURSTLEN_14BEAT_Val    _UINT32_(0xD)                                        /* (DMAC_CHCTRLA) 14-beats burst length  */
#define   DMAC_CHCTRLA_BURSTLEN_15BEAT_Val    _UINT32_(0xE)                                        /* (DMAC_CHCTRLA) 15-beats burst length  */
#define   DMAC_CHCTRLA_BURSTLEN_16BEAT_Val    _UINT32_(0xF)                                        /* (DMAC_CHCTRLA) 16-beats burst length  */
#define DMAC_CHCTRLA_BURSTLEN_SINGLE          (DMAC_CHCTRLA_BURSTLEN_SINGLE_Val << DMAC_CHCTRLA_BURSTLEN_Pos) /* (DMAC_CHCTRLA) Single-beat burst length Position  */
#define DMAC_CHCTRLA_BURSTLEN_2BEAT           (DMAC_CHCTRLA_BURSTLEN_2BEAT_Val << DMAC_CHCTRLA_BURSTLEN_Pos) /* (DMAC_CHCTRLA) 2-beats burst length Position  */
#define DMAC_CHCTRLA_BURSTLEN_3BEAT           (DMAC_CHCTRLA_BURSTLEN_3BEAT_Val << DMAC_CHCTRLA_BURSTLEN_Pos) /* (DMAC_CHCTRLA) 3-beats burst length Position  */
#define DMAC_CHCTRLA_BURSTLEN_4BEAT           (DMAC_CHCTRLA_BURSTLEN_4BEAT_Val << DMAC_CHCTRLA_BURSTLEN_Pos) /* (DMAC_CHCTRLA) 4-beats burst length Position  */
#define DMAC_CHCTRLA_BURSTLEN_5BEAT           (DMAC_CHCTRLA_BURSTLEN_5BEAT_Val << DMAC_CHCTRLA_BURSTLEN_Pos) /* (DMAC_CHCTRLA) 5-beats burst length Position  */
#define DMAC_CHCTRLA_BURSTLEN_6BEAT           (DMAC_CHCTRLA_BURSTLEN_6BEAT_Val << DMAC_CHCTRLA_BURSTLEN_Pos) /* (DMAC_CHCTRLA) 6-beats burst length Position  */
#define DMAC_CHCTRLA_BURSTLEN_7BEAT           (DMAC_CHCTRLA_BURSTLEN_7BEAT_Val << DMAC_CHCTRLA_BURSTLEN_Pos) /* (DMAC_CHCTRLA) 7-beats burst length Position  */
#define DMAC_CHCTRLA_BURSTLEN_8BEAT           (DMAC_CHCTRLA_BURSTLEN_8BEAT_Val << DMAC_CHCTRLA_BURSTLEN_Pos) /* (DMAC_CHCTRLA) 8-beats burst length Position  */
#define DMAC_CHCTRLA_BURSTLEN_9BEAT           (DMAC_CHCTRLA_BURSTLEN_9BEAT_Val << DMAC_CHCTRLA_BURSTLEN_Pos) /* (DMAC_CHCTRLA) 9-beats burst length Position  */
#define DMAC_CHCTRLA_BURSTLEN_10BEAT          (DMAC_CHCTRLA_BURSTLEN_10BEAT_Val << DMAC_CHCTRLA_BURSTLEN_Pos) /* (DMAC_CHCTRLA) 10-beats burst length Position  */
#define DMAC_CHCTRLA_BURSTLEN_11BEAT          (DMAC_CHCTRLA_BURSTLEN_11BEAT_Val << DMAC_CHCTRLA_BURSTLEN_Pos) /* (DMAC_CHCTRLA) 11-beats burst length Position  */
#define DMAC_CHCTRLA_BURSTLEN_12BEAT          (DMAC_CHCTRLA_BURSTLEN_12BEAT_Val << DMAC_CHCTRLA_BURSTLEN_Pos) /* (DMAC_CHCTRLA) 12-beats burst length Position  */
#define DMAC_CHCTRLA_BURSTLEN_13BEAT          (DMAC_CHCTRLA_BURSTLEN_13BEAT_Val << DMAC_CHCTRLA_BURSTLEN_Pos) /* (DMAC_CHCTRLA) 13-beats burst length Position  */
#define DMAC_CHCTRLA_BURSTLEN_14BEAT          (DMAC_CHCTRLA_BURSTLEN_14BEAT_Val << DMAC_CHCTRLA_BURSTLEN_Pos) /* (DMAC_CHCTRLA) 14-beats burst length Position  */
#define DMAC_CHCTRLA_BURSTLEN_15BEAT          (DMAC_CHCTRLA_BURSTLEN_15BEAT_Val << DMAC_CHCTRLA_BURSTLEN_Pos) /* (DMAC_CHCTRLA) 15-beats burst length Position  */
#define DMAC_CHCTRLA_BURSTLEN_16BEAT          (DMAC_CHCTRLA_BURSTLEN_16BEAT_Val << DMAC_CHCTRLA_BURSTLEN_Pos) /* (DMAC_CHCTRLA) 16-beats burst length Position  */
#define DMAC_CHCTRLA_THRESHOLD_Pos            _UINT32_(28)                                         /* (DMAC_CHCTRLA) FIFO Threshold Position */
#define DMAC_CHCTRLA_THRESHOLD_Msk            (_UINT32_(0x3) << DMAC_CHCTRLA_THRESHOLD_Pos)        /* (DMAC_CHCTRLA) FIFO Threshold Mask */
#define DMAC_CHCTRLA_THRESHOLD(value)         (DMAC_CHCTRLA_THRESHOLD_Msk & (_UINT32_(value) << DMAC_CHCTRLA_THRESHOLD_Pos)) /* Assigment of value for THRESHOLD in the DMAC_CHCTRLA register */
#define   DMAC_CHCTRLA_THRESHOLD_1BEAT_Val    _UINT32_(0x0)                                        /* (DMAC_CHCTRLA) Destination write starts after each beat source address read  */
#define   DMAC_CHCTRLA_THRESHOLD_2BEATS_Val   _UINT32_(0x1)                                        /* (DMAC_CHCTRLA) Destination write starts after 2-beats source address read  */
#define   DMAC_CHCTRLA_THRESHOLD_4BEATS_Val   _UINT32_(0x2)                                        /* (DMAC_CHCTRLA) Destination write starts after 4-beats source address read  */
#define   DMAC_CHCTRLA_THRESHOLD_8BEATS_Val   _UINT32_(0x3)                                        /* (DMAC_CHCTRLA) Destination write starts after 8-beats source address read  */
#define DMAC_CHCTRLA_THRESHOLD_1BEAT          (DMAC_CHCTRLA_THRESHOLD_1BEAT_Val << DMAC_CHCTRLA_THRESHOLD_Pos) /* (DMAC_CHCTRLA) Destination write starts after each beat source address read Position  */
#define DMAC_CHCTRLA_THRESHOLD_2BEATS         (DMAC_CHCTRLA_THRESHOLD_2BEATS_Val << DMAC_CHCTRLA_THRESHOLD_Pos) /* (DMAC_CHCTRLA) Destination write starts after 2-beats source address read Position  */
#define DMAC_CHCTRLA_THRESHOLD_4BEATS         (DMAC_CHCTRLA_THRESHOLD_4BEATS_Val << DMAC_CHCTRLA_THRESHOLD_Pos) /* (DMAC_CHCTRLA) Destination write starts after 4-beats source address read Position  */
#define DMAC_CHCTRLA_THRESHOLD_8BEATS         (DMAC_CHCTRLA_THRESHOLD_8BEATS_Val << DMAC_CHCTRLA_THRESHOLD_Pos) /* (DMAC_CHCTRLA) Destination write starts after 8-beats source address read Position  */
#define DMAC_CHCTRLA_Msk                      _UINT32_(0x3F307F43)                                 /* (DMAC_CHCTRLA) Register Mask  */


/* -------- DMAC_CHCTRLB : (DMAC Offset: 0x04) (R/W 8) Channel n Control B -------- */
#define DMAC_CHCTRLB_RESETVALUE               _UINT8_(0x00)                                        /*  (DMAC_CHCTRLB) Channel n Control B  Reset Value */

#define DMAC_CHCTRLB_CMD_Pos                  _UINT8_(0)                                           /* (DMAC_CHCTRLB) Software Command Position */
#define DMAC_CHCTRLB_CMD_Msk                  (_UINT8_(0x3) << DMAC_CHCTRLB_CMD_Pos)               /* (DMAC_CHCTRLB) Software Command Mask */
#define DMAC_CHCTRLB_CMD(value)               (DMAC_CHCTRLB_CMD_Msk & (_UINT8_(value) << DMAC_CHCTRLB_CMD_Pos)) /* Assigment of value for CMD in the DMAC_CHCTRLB register */
#define   DMAC_CHCTRLB_CMD_NOACT_Val          _UINT8_(0x0)                                         /* (DMAC_CHCTRLB) No action  */
#define   DMAC_CHCTRLB_CMD_SUSPEND_Val        _UINT8_(0x1)                                         /* (DMAC_CHCTRLB) Channel suspend operation  */
#define   DMAC_CHCTRLB_CMD_RESUME_Val         _UINT8_(0x2)                                         /* (DMAC_CHCTRLB) Channel resume operation  */
#define DMAC_CHCTRLB_CMD_NOACT                (DMAC_CHCTRLB_CMD_NOACT_Val << DMAC_CHCTRLB_CMD_Pos) /* (DMAC_CHCTRLB) No action Position  */
#define DMAC_CHCTRLB_CMD_SUSPEND              (DMAC_CHCTRLB_CMD_SUSPEND_Val << DMAC_CHCTRLB_CMD_Pos) /* (DMAC_CHCTRLB) Channel suspend operation Position  */
#define DMAC_CHCTRLB_CMD_RESUME               (DMAC_CHCTRLB_CMD_RESUME_Val << DMAC_CHCTRLB_CMD_Pos) /* (DMAC_CHCTRLB) Channel resume operation Position  */
#define DMAC_CHCTRLB_Msk                      _UINT8_(0x03)                                        /* (DMAC_CHCTRLB) Register Mask  */


/* -------- DMAC_CHPRILVL : (DMAC Offset: 0x05) (R/W 8) Channel n Priority Level -------- */
#define DMAC_CHPRILVL_RESETVALUE              _UINT8_(0x00)                                        /*  (DMAC_CHPRILVL) Channel n Priority Level  Reset Value */

#define DMAC_CHPRILVL_PRILVL_Pos              _UINT8_(0)                                           /* (DMAC_CHPRILVL) Channel Priority Level Position */
#define DMAC_CHPRILVL_PRILVL_Msk              (_UINT8_(0x3) << DMAC_CHPRILVL_PRILVL_Pos)           /* (DMAC_CHPRILVL) Channel Priority Level Mask */
#define DMAC_CHPRILVL_PRILVL(value)           (DMAC_CHPRILVL_PRILVL_Msk & (_UINT8_(value) << DMAC_CHPRILVL_PRILVL_Pos)) /* Assigment of value for PRILVL in the DMAC_CHPRILVL register */
#define   DMAC_CHPRILVL_PRILVL_LVL0_Val       _UINT8_(0x0)                                         /* (DMAC_CHPRILVL) Channel Priority Level 0 (Lowest Level)  */
#define   DMAC_CHPRILVL_PRILVL_LVL1_Val       _UINT8_(0x1)                                         /* (DMAC_CHPRILVL) Channel Priority Level 1  */
#define   DMAC_CHPRILVL_PRILVL_LVL2_Val       _UINT8_(0x2)                                         /* (DMAC_CHPRILVL) Channel Priority Level 2  */
#define   DMAC_CHPRILVL_PRILVL_LVL3_Val       _UINT8_(0x3)                                         /* (DMAC_CHPRILVL) Channel Priority Level 3 (Highest Level)  */
#define DMAC_CHPRILVL_PRILVL_LVL0             (DMAC_CHPRILVL_PRILVL_LVL0_Val << DMAC_CHPRILVL_PRILVL_Pos) /* (DMAC_CHPRILVL) Channel Priority Level 0 (Lowest Level) Position  */
#define DMAC_CHPRILVL_PRILVL_LVL1             (DMAC_CHPRILVL_PRILVL_LVL1_Val << DMAC_CHPRILVL_PRILVL_Pos) /* (DMAC_CHPRILVL) Channel Priority Level 1 Position  */
#define DMAC_CHPRILVL_PRILVL_LVL2             (DMAC_CHPRILVL_PRILVL_LVL2_Val << DMAC_CHPRILVL_PRILVL_Pos) /* (DMAC_CHPRILVL) Channel Priority Level 2 Position  */
#define DMAC_CHPRILVL_PRILVL_LVL3             (DMAC_CHPRILVL_PRILVL_LVL3_Val << DMAC_CHPRILVL_PRILVL_Pos) /* (DMAC_CHPRILVL) Channel Priority Level 3 (Highest Level) Position  */
#define DMAC_CHPRILVL_Msk                     _UINT8_(0x03)                                        /* (DMAC_CHPRILVL) Register Mask  */


/* -------- DMAC_CHEVCTRL : (DMAC Offset: 0x06) (R/W 8) Channel n Event Control -------- */
#define DMAC_CHEVCTRL_RESETVALUE              _UINT8_(0x00)                                        /*  (DMAC_CHEVCTRL) Channel n Event Control  Reset Value */

#define DMAC_CHEVCTRL_EVACT_Pos               _UINT8_(0)                                           /* (DMAC_CHEVCTRL) Channel Event Input Action Position */
#define DMAC_CHEVCTRL_EVACT_Msk               (_UINT8_(0x7) << DMAC_CHEVCTRL_EVACT_Pos)            /* (DMAC_CHEVCTRL) Channel Event Input Action Mask */
#define DMAC_CHEVCTRL_EVACT(value)            (DMAC_CHEVCTRL_EVACT_Msk & (_UINT8_(value) << DMAC_CHEVCTRL_EVACT_Pos)) /* Assigment of value for EVACT in the DMAC_CHEVCTRL register */
#define   DMAC_CHEVCTRL_EVACT_NOACT_Val       _UINT8_(0x0)                                         /* (DMAC_CHEVCTRL) No action  */
#define   DMAC_CHEVCTRL_EVACT_TRIG_Val        _UINT8_(0x1)                                         /* (DMAC_CHEVCTRL) Transfer and periodic transfer trigger  */
#define   DMAC_CHEVCTRL_EVACT_CTRIG_Val       _UINT8_(0x2)                                         /* (DMAC_CHEVCTRL) Conditional transfer trigger  */
#define   DMAC_CHEVCTRL_EVACT_CBLOCK_Val      _UINT8_(0x3)                                         /* (DMAC_CHEVCTRL) Conditional block transfer  */
#define   DMAC_CHEVCTRL_EVACT_SUSPEND_Val     _UINT8_(0x4)                                         /* (DMAC_CHEVCTRL) Channel suspend operation  */
#define   DMAC_CHEVCTRL_EVACT_RESUME_Val      _UINT8_(0x5)                                         /* (DMAC_CHEVCTRL) Channel resume operation  */
#define   DMAC_CHEVCTRL_EVACT_SSKIP_Val       _UINT8_(0x6)                                         /* (DMAC_CHEVCTRL) Skip next block suspend action  */
#define   DMAC_CHEVCTRL_EVACT_INCPRI_Val      _UINT8_(0x7)                                         /* (DMAC_CHEVCTRL) Increase priority  */
#define DMAC_CHEVCTRL_EVACT_NOACT             (DMAC_CHEVCTRL_EVACT_NOACT_Val << DMAC_CHEVCTRL_EVACT_Pos) /* (DMAC_CHEVCTRL) No action Position  */
#define DMAC_CHEVCTRL_EVACT_TRIG              (DMAC_CHEVCTRL_EVACT_TRIG_Val << DMAC_CHEVCTRL_EVACT_Pos) /* (DMAC_CHEVCTRL) Transfer and periodic transfer trigger Position  */
#define DMAC_CHEVCTRL_EVACT_CTRIG             (DMAC_CHEVCTRL_EVACT_CTRIG_Val << DMAC_CHEVCTRL_EVACT_Pos) /* (DMAC_CHEVCTRL) Conditional transfer trigger Position  */
#define DMAC_CHEVCTRL_EVACT_CBLOCK            (DMAC_CHEVCTRL_EVACT_CBLOCK_Val << DMAC_CHEVCTRL_EVACT_Pos) /* (DMAC_CHEVCTRL) Conditional block transfer Position  */
#define DMAC_CHEVCTRL_EVACT_SUSPEND           (DMAC_CHEVCTRL_EVACT_SUSPEND_Val << DMAC_CHEVCTRL_EVACT_Pos) /* (DMAC_CHEVCTRL) Channel suspend operation Position  */
#define DMAC_CHEVCTRL_EVACT_RESUME            (DMAC_CHEVCTRL_EVACT_RESUME_Val << DMAC_CHEVCTRL_EVACT_Pos) /* (DMAC_CHEVCTRL) Channel resume operation Position  */
#define DMAC_CHEVCTRL_EVACT_SSKIP             (DMAC_CHEVCTRL_EVACT_SSKIP_Val << DMAC_CHEVCTRL_EVACT_Pos) /* (DMAC_CHEVCTRL) Skip next block suspend action Position  */
#define DMAC_CHEVCTRL_EVACT_INCPRI            (DMAC_CHEVCTRL_EVACT_INCPRI_Val << DMAC_CHEVCTRL_EVACT_Pos) /* (DMAC_CHEVCTRL) Increase priority Position  */
#define DMAC_CHEVCTRL_EVOMODE_Pos             _UINT8_(4)                                           /* (DMAC_CHEVCTRL) Channel Event Output Mode Position */
#define DMAC_CHEVCTRL_EVOMODE_Msk             (_UINT8_(0x3) << DMAC_CHEVCTRL_EVOMODE_Pos)          /* (DMAC_CHEVCTRL) Channel Event Output Mode Mask */
#define DMAC_CHEVCTRL_EVOMODE(value)          (DMAC_CHEVCTRL_EVOMODE_Msk & (_UINT8_(value) << DMAC_CHEVCTRL_EVOMODE_Pos)) /* Assigment of value for EVOMODE in the DMAC_CHEVCTRL register */
#define   DMAC_CHEVCTRL_EVOMODE_DEFAULT_Val   _UINT8_(0x0)                                         /* (DMAC_CHEVCTRL) Block event output selection. Refer to BTCTRL.EVOSEL for available selections.  */
#define   DMAC_CHEVCTRL_EVOMODE_TRIGACT_Val   _UINT8_(0x1)                                         /* (DMAC_CHEVCTRL) Ongoing trigger action  */
#define DMAC_CHEVCTRL_EVOMODE_DEFAULT         (DMAC_CHEVCTRL_EVOMODE_DEFAULT_Val << DMAC_CHEVCTRL_EVOMODE_Pos) /* (DMAC_CHEVCTRL) Block event output selection. Refer to BTCTRL.EVOSEL for available selections. Position  */
#define DMAC_CHEVCTRL_EVOMODE_TRIGACT         (DMAC_CHEVCTRL_EVOMODE_TRIGACT_Val << DMAC_CHEVCTRL_EVOMODE_Pos) /* (DMAC_CHEVCTRL) Ongoing trigger action Position  */
#define DMAC_CHEVCTRL_EVIE_Pos                _UINT8_(6)                                           /* (DMAC_CHEVCTRL) Channel Event Input Enable Position */
#define DMAC_CHEVCTRL_EVIE_Msk                (_UINT8_(0x1) << DMAC_CHEVCTRL_EVIE_Pos)             /* (DMAC_CHEVCTRL) Channel Event Input Enable Mask */
#define DMAC_CHEVCTRL_EVIE(value)             (DMAC_CHEVCTRL_EVIE_Msk & (_UINT8_(value) << DMAC_CHEVCTRL_EVIE_Pos)) /* Assigment of value for EVIE in the DMAC_CHEVCTRL register */
#define DMAC_CHEVCTRL_EVOE_Pos                _UINT8_(7)                                           /* (DMAC_CHEVCTRL) Channel Event Output Enable Position */
#define DMAC_CHEVCTRL_EVOE_Msk                (_UINT8_(0x1) << DMAC_CHEVCTRL_EVOE_Pos)             /* (DMAC_CHEVCTRL) Channel Event Output Enable Mask */
#define DMAC_CHEVCTRL_EVOE(value)             (DMAC_CHEVCTRL_EVOE_Msk & (_UINT8_(value) << DMAC_CHEVCTRL_EVOE_Pos)) /* Assigment of value for EVOE in the DMAC_CHEVCTRL register */
#define DMAC_CHEVCTRL_Msk                     _UINT8_(0xF7)                                        /* (DMAC_CHEVCTRL) Register Mask  */


/* -------- DMAC_CHINTENCLR : (DMAC Offset: 0x0C) (R/W 8) Channel n Interrupt Enable Clear -------- */
#define DMAC_CHINTENCLR_RESETVALUE            _UINT8_(0x00)                                        /*  (DMAC_CHINTENCLR) Channel n Interrupt Enable Clear  Reset Value */

#define DMAC_CHINTENCLR_TERR_Pos              _UINT8_(0)                                           /* (DMAC_CHINTENCLR) Channel Transfer Error Interrupt Enable Position */
#define DMAC_CHINTENCLR_TERR_Msk              (_UINT8_(0x1) << DMAC_CHINTENCLR_TERR_Pos)           /* (DMAC_CHINTENCLR) Channel Transfer Error Interrupt Enable Mask */
#define DMAC_CHINTENCLR_TERR(value)           (DMAC_CHINTENCLR_TERR_Msk & (_UINT8_(value) << DMAC_CHINTENCLR_TERR_Pos)) /* Assigment of value for TERR in the DMAC_CHINTENCLR register */
#define DMAC_CHINTENCLR_TCMPL_Pos             _UINT8_(1)                                           /* (DMAC_CHINTENCLR) Channel Transfer Complete Interrupt Enable Position */
#define DMAC_CHINTENCLR_TCMPL_Msk             (_UINT8_(0x1) << DMAC_CHINTENCLR_TCMPL_Pos)          /* (DMAC_CHINTENCLR) Channel Transfer Complete Interrupt Enable Mask */
#define DMAC_CHINTENCLR_TCMPL(value)          (DMAC_CHINTENCLR_TCMPL_Msk & (_UINT8_(value) << DMAC_CHINTENCLR_TCMPL_Pos)) /* Assigment of value for TCMPL in the DMAC_CHINTENCLR register */
#define DMAC_CHINTENCLR_SUSP_Pos              _UINT8_(2)                                           /* (DMAC_CHINTENCLR) Channel Suspend Interrupt Enable Position */
#define DMAC_CHINTENCLR_SUSP_Msk              (_UINT8_(0x1) << DMAC_CHINTENCLR_SUSP_Pos)           /* (DMAC_CHINTENCLR) Channel Suspend Interrupt Enable Mask */
#define DMAC_CHINTENCLR_SUSP(value)           (DMAC_CHINTENCLR_SUSP_Msk & (_UINT8_(value) << DMAC_CHINTENCLR_SUSP_Pos)) /* Assigment of value for SUSP in the DMAC_CHINTENCLR register */
#define DMAC_CHINTENCLR_Msk                   _UINT8_(0x07)                                        /* (DMAC_CHINTENCLR) Register Mask  */


/* -------- DMAC_CHINTENSET : (DMAC Offset: 0x0D) (R/W 8) Channel n Interrupt Enable Set -------- */
#define DMAC_CHINTENSET_RESETVALUE            _UINT8_(0x00)                                        /*  (DMAC_CHINTENSET) Channel n Interrupt Enable Set  Reset Value */

#define DMAC_CHINTENSET_TERR_Pos              _UINT8_(0)                                           /* (DMAC_CHINTENSET) Channel Transfer Error Interrupt Enable Position */
#define DMAC_CHINTENSET_TERR_Msk              (_UINT8_(0x1) << DMAC_CHINTENSET_TERR_Pos)           /* (DMAC_CHINTENSET) Channel Transfer Error Interrupt Enable Mask */
#define DMAC_CHINTENSET_TERR(value)           (DMAC_CHINTENSET_TERR_Msk & (_UINT8_(value) << DMAC_CHINTENSET_TERR_Pos)) /* Assigment of value for TERR in the DMAC_CHINTENSET register */
#define DMAC_CHINTENSET_TCMPL_Pos             _UINT8_(1)                                           /* (DMAC_CHINTENSET) Channel Transfer Complete Interrupt Enable Position */
#define DMAC_CHINTENSET_TCMPL_Msk             (_UINT8_(0x1) << DMAC_CHINTENSET_TCMPL_Pos)          /* (DMAC_CHINTENSET) Channel Transfer Complete Interrupt Enable Mask */
#define DMAC_CHINTENSET_TCMPL(value)          (DMAC_CHINTENSET_TCMPL_Msk & (_UINT8_(value) << DMAC_CHINTENSET_TCMPL_Pos)) /* Assigment of value for TCMPL in the DMAC_CHINTENSET register */
#define DMAC_CHINTENSET_SUSP_Pos              _UINT8_(2)                                           /* (DMAC_CHINTENSET) Channel Suspend Interrupt Enable Position */
#define DMAC_CHINTENSET_SUSP_Msk              (_UINT8_(0x1) << DMAC_CHINTENSET_SUSP_Pos)           /* (DMAC_CHINTENSET) Channel Suspend Interrupt Enable Mask */
#define DMAC_CHINTENSET_SUSP(value)           (DMAC_CHINTENSET_SUSP_Msk & (_UINT8_(value) << DMAC_CHINTENSET_SUSP_Pos)) /* Assigment of value for SUSP in the DMAC_CHINTENSET register */
#define DMAC_CHINTENSET_Msk                   _UINT8_(0x07)                                        /* (DMAC_CHINTENSET) Register Mask  */


/* -------- DMAC_CHINTFLAG : (DMAC Offset: 0x0E) (R/W 8) Channel n Interrupt Flag Status and Clear -------- */
#define DMAC_CHINTFLAG_RESETVALUE             _UINT8_(0x00)                                        /*  (DMAC_CHINTFLAG) Channel n Interrupt Flag Status and Clear  Reset Value */

#define DMAC_CHINTFLAG_TERR_Pos               _UINT8_(0)                                           /* (DMAC_CHINTFLAG) Channel Transfer Error Position */
#define DMAC_CHINTFLAG_TERR_Msk               (_UINT8_(0x1) << DMAC_CHINTFLAG_TERR_Pos)            /* (DMAC_CHINTFLAG) Channel Transfer Error Mask */
#define DMAC_CHINTFLAG_TERR(value)            (DMAC_CHINTFLAG_TERR_Msk & (_UINT8_(value) << DMAC_CHINTFLAG_TERR_Pos)) /* Assigment of value for TERR in the DMAC_CHINTFLAG register */
#define DMAC_CHINTFLAG_TCMPL_Pos              _UINT8_(1)                                           /* (DMAC_CHINTFLAG) Channel Transfer Complete Position */
#define DMAC_CHINTFLAG_TCMPL_Msk              (_UINT8_(0x1) << DMAC_CHINTFLAG_TCMPL_Pos)           /* (DMAC_CHINTFLAG) Channel Transfer Complete Mask */
#define DMAC_CHINTFLAG_TCMPL(value)           (DMAC_CHINTFLAG_TCMPL_Msk & (_UINT8_(value) << DMAC_CHINTFLAG_TCMPL_Pos)) /* Assigment of value for TCMPL in the DMAC_CHINTFLAG register */
#define DMAC_CHINTFLAG_SUSP_Pos               _UINT8_(2)                                           /* (DMAC_CHINTFLAG) Channel Suspend Position */
#define DMAC_CHINTFLAG_SUSP_Msk               (_UINT8_(0x1) << DMAC_CHINTFLAG_SUSP_Pos)            /* (DMAC_CHINTFLAG) Channel Suspend Mask */
#define DMAC_CHINTFLAG_SUSP(value)            (DMAC_CHINTFLAG_SUSP_Msk & (_UINT8_(value) << DMAC_CHINTFLAG_SUSP_Pos)) /* Assigment of value for SUSP in the DMAC_CHINTFLAG register */
#define DMAC_CHINTFLAG_Msk                    _UINT8_(0x07)                                        /* (DMAC_CHINTFLAG) Register Mask  */


/* -------- DMAC_CHSTATUS : (DMAC Offset: 0x0F) (R/W 8) Channel n Status -------- */
#define DMAC_CHSTATUS_RESETVALUE              _UINT8_(0x00)                                        /*  (DMAC_CHSTATUS) Channel n Status  Reset Value */

#define DMAC_CHSTATUS_PEND_Pos                _UINT8_(0)                                           /* (DMAC_CHSTATUS) Channel Pending Position */
#define DMAC_CHSTATUS_PEND_Msk                (_UINT8_(0x1) << DMAC_CHSTATUS_PEND_Pos)             /* (DMAC_CHSTATUS) Channel Pending Mask */
#define DMAC_CHSTATUS_PEND(value)             (DMAC_CHSTATUS_PEND_Msk & (_UINT8_(value) << DMAC_CHSTATUS_PEND_Pos)) /* Assigment of value for PEND in the DMAC_CHSTATUS register */
#define DMAC_CHSTATUS_BUSY_Pos                _UINT8_(1)                                           /* (DMAC_CHSTATUS) Channel Busy Position */
#define DMAC_CHSTATUS_BUSY_Msk                (_UINT8_(0x1) << DMAC_CHSTATUS_BUSY_Pos)             /* (DMAC_CHSTATUS) Channel Busy Mask */
#define DMAC_CHSTATUS_BUSY(value)             (DMAC_CHSTATUS_BUSY_Msk & (_UINT8_(value) << DMAC_CHSTATUS_BUSY_Pos)) /* Assigment of value for BUSY in the DMAC_CHSTATUS register */
#define DMAC_CHSTATUS_FERR_Pos                _UINT8_(2)                                           /* (DMAC_CHSTATUS) Channel Fetch Error Position */
#define DMAC_CHSTATUS_FERR_Msk                (_UINT8_(0x1) << DMAC_CHSTATUS_FERR_Pos)             /* (DMAC_CHSTATUS) Channel Fetch Error Mask */
#define DMAC_CHSTATUS_FERR(value)             (DMAC_CHSTATUS_FERR_Msk & (_UINT8_(value) << DMAC_CHSTATUS_FERR_Pos)) /* Assigment of value for FERR in the DMAC_CHSTATUS register */
#define DMAC_CHSTATUS_CRCERR_Pos              _UINT8_(3)                                           /* (DMAC_CHSTATUS) Channel CRC Error Position */
#define DMAC_CHSTATUS_CRCERR_Msk              (_UINT8_(0x1) << DMAC_CHSTATUS_CRCERR_Pos)           /* (DMAC_CHSTATUS) Channel CRC Error Mask */
#define DMAC_CHSTATUS_CRCERR(value)           (DMAC_CHSTATUS_CRCERR_Msk & (_UINT8_(value) << DMAC_CHSTATUS_CRCERR_Pos)) /* Assigment of value for CRCERR in the DMAC_CHSTATUS register */
#define DMAC_CHSTATUS_Msk                     _UINT8_(0x0F)                                        /* (DMAC_CHSTATUS) Register Mask  */


/* -------- DMAC_CTRL : (DMAC Offset: 0x00) (R/W 16) Control -------- */
#define DMAC_CTRL_RESETVALUE                  _UINT16_(0x00)                                       /*  (DMAC_CTRL) Control  Reset Value */

#define DMAC_CTRL_SWRST_Pos                   _UINT16_(0)                                          /* (DMAC_CTRL) Software Reset Position */
#define DMAC_CTRL_SWRST_Msk                   (_UINT16_(0x1) << DMAC_CTRL_SWRST_Pos)               /* (DMAC_CTRL) Software Reset Mask */
#define DMAC_CTRL_SWRST(value)                (DMAC_CTRL_SWRST_Msk & (_UINT16_(value) << DMAC_CTRL_SWRST_Pos)) /* Assigment of value for SWRST in the DMAC_CTRL register */
#define DMAC_CTRL_DMAENABLE_Pos               _UINT16_(1)                                          /* (DMAC_CTRL) DMA Enable Position */
#define DMAC_CTRL_DMAENABLE_Msk               (_UINT16_(0x1) << DMAC_CTRL_DMAENABLE_Pos)           /* (DMAC_CTRL) DMA Enable Mask */
#define DMAC_CTRL_DMAENABLE(value)            (DMAC_CTRL_DMAENABLE_Msk & (_UINT16_(value) << DMAC_CTRL_DMAENABLE_Pos)) /* Assigment of value for DMAENABLE in the DMAC_CTRL register */
#define DMAC_CTRL_CRCENABLE_Pos               _UINT16_(2)                                          /* (DMAC_CTRL) CRC Enable Position */
#define DMAC_CTRL_CRCENABLE_Msk               (_UINT16_(0x1) << DMAC_CTRL_CRCENABLE_Pos)           /* (DMAC_CTRL) CRC Enable Mask */
#define DMAC_CTRL_CRCENABLE(value)            (DMAC_CTRL_CRCENABLE_Msk & (_UINT16_(value) << DMAC_CTRL_CRCENABLE_Pos)) /* Assigment of value for CRCENABLE in the DMAC_CTRL register */
#define DMAC_CTRL_LVLEN0_Pos                  _UINT16_(8)                                          /* (DMAC_CTRL) Priority Level 0 Enable Position */
#define DMAC_CTRL_LVLEN0_Msk                  (_UINT16_(0x1) << DMAC_CTRL_LVLEN0_Pos)              /* (DMAC_CTRL) Priority Level 0 Enable Mask */
#define DMAC_CTRL_LVLEN0(value)               (DMAC_CTRL_LVLEN0_Msk & (_UINT16_(value) << DMAC_CTRL_LVLEN0_Pos)) /* Assigment of value for LVLEN0 in the DMAC_CTRL register */
#define DMAC_CTRL_LVLEN1_Pos                  _UINT16_(9)                                          /* (DMAC_CTRL) Priority Level 1 Enable Position */
#define DMAC_CTRL_LVLEN1_Msk                  (_UINT16_(0x1) << DMAC_CTRL_LVLEN1_Pos)              /* (DMAC_CTRL) Priority Level 1 Enable Mask */
#define DMAC_CTRL_LVLEN1(value)               (DMAC_CTRL_LVLEN1_Msk & (_UINT16_(value) << DMAC_CTRL_LVLEN1_Pos)) /* Assigment of value for LVLEN1 in the DMAC_CTRL register */
#define DMAC_CTRL_LVLEN2_Pos                  _UINT16_(10)                                         /* (DMAC_CTRL) Priority Level 2 Enable Position */
#define DMAC_CTRL_LVLEN2_Msk                  (_UINT16_(0x1) << DMAC_CTRL_LVLEN2_Pos)              /* (DMAC_CTRL) Priority Level 2 Enable Mask */
#define DMAC_CTRL_LVLEN2(value)               (DMAC_CTRL_LVLEN2_Msk & (_UINT16_(value) << DMAC_CTRL_LVLEN2_Pos)) /* Assigment of value for LVLEN2 in the DMAC_CTRL register */
#define DMAC_CTRL_LVLEN3_Pos                  _UINT16_(11)                                         /* (DMAC_CTRL) Priority Level 3 Enable Position */
#define DMAC_CTRL_LVLEN3_Msk                  (_UINT16_(0x1) << DMAC_CTRL_LVLEN3_Pos)              /* (DMAC_CTRL) Priority Level 3 Enable Mask */
#define DMAC_CTRL_LVLEN3(value)               (DMAC_CTRL_LVLEN3_Msk & (_UINT16_(value) << DMAC_CTRL_LVLEN3_Pos)) /* Assigment of value for LVLEN3 in the DMAC_CTRL register */
#define DMAC_CTRL_Msk                         _UINT16_(0x0F07)                                     /* (DMAC_CTRL) Register Mask  */

#define DMAC_CTRL_LVLEN_Pos                   _UINT16_(8)                                          /* (DMAC_CTRL Position) Priority Level 3 Enable */
#define DMAC_CTRL_LVLEN_Msk                   (_UINT16_(0xF) << DMAC_CTRL_LVLEN_Pos)               /* (DMAC_CTRL Mask) LVLEN */
#define DMAC_CTRL_LVLEN(value)                (DMAC_CTRL_LVLEN_Msk & (_UINT16_(value) << DMAC_CTRL_LVLEN_Pos)) 

/* -------- DMAC_CRCCTRL : (DMAC Offset: 0x02) (R/W 16) CRC Control -------- */
#define DMAC_CRCCTRL_RESETVALUE               _UINT16_(0x00)                                       /*  (DMAC_CRCCTRL) CRC Control  Reset Value */

#define DMAC_CRCCTRL_CRCBEATSIZE_Pos          _UINT16_(0)                                          /* (DMAC_CRCCTRL) CRC Beat Size Position */
#define DMAC_CRCCTRL_CRCBEATSIZE_Msk          (_UINT16_(0x3) << DMAC_CRCCTRL_CRCBEATSIZE_Pos)      /* (DMAC_CRCCTRL) CRC Beat Size Mask */
#define DMAC_CRCCTRL_CRCBEATSIZE(value)       (DMAC_CRCCTRL_CRCBEATSIZE_Msk & (_UINT16_(value) << DMAC_CRCCTRL_CRCBEATSIZE_Pos)) /* Assigment of value for CRCBEATSIZE in the DMAC_CRCCTRL register */
#define   DMAC_CRCCTRL_CRCBEATSIZE_BYTE_Val   _UINT16_(0x0)                                        /* (DMAC_CRCCTRL) 8-bit bus transfer  */
#define   DMAC_CRCCTRL_CRCBEATSIZE_HWORD_Val  _UINT16_(0x1)                                        /* (DMAC_CRCCTRL) 16-bit bus transfer  */
#define   DMAC_CRCCTRL_CRCBEATSIZE_WORD_Val   _UINT16_(0x2)                                        /* (DMAC_CRCCTRL) 32-bit bus transfer  */
#define DMAC_CRCCTRL_CRCBEATSIZE_BYTE         (DMAC_CRCCTRL_CRCBEATSIZE_BYTE_Val << DMAC_CRCCTRL_CRCBEATSIZE_Pos) /* (DMAC_CRCCTRL) 8-bit bus transfer Position  */
#define DMAC_CRCCTRL_CRCBEATSIZE_HWORD        (DMAC_CRCCTRL_CRCBEATSIZE_HWORD_Val << DMAC_CRCCTRL_CRCBEATSIZE_Pos) /* (DMAC_CRCCTRL) 16-bit bus transfer Position  */
#define DMAC_CRCCTRL_CRCBEATSIZE_WORD         (DMAC_CRCCTRL_CRCBEATSIZE_WORD_Val << DMAC_CRCCTRL_CRCBEATSIZE_Pos) /* (DMAC_CRCCTRL) 32-bit bus transfer Position  */
#define DMAC_CRCCTRL_CRCPOLY_Pos              _UINT16_(2)                                          /* (DMAC_CRCCTRL) CRC Polynomial Type Position */
#define DMAC_CRCCTRL_CRCPOLY_Msk              (_UINT16_(0x3) << DMAC_CRCCTRL_CRCPOLY_Pos)          /* (DMAC_CRCCTRL) CRC Polynomial Type Mask */
#define DMAC_CRCCTRL_CRCPOLY(value)           (DMAC_CRCCTRL_CRCPOLY_Msk & (_UINT16_(value) << DMAC_CRCCTRL_CRCPOLY_Pos)) /* Assigment of value for CRCPOLY in the DMAC_CRCCTRL register */
#define   DMAC_CRCCTRL_CRCPOLY_CRC16_Val      _UINT16_(0x0)                                        /* (DMAC_CRCCTRL) CRC-16 (CRC-CCITT)  */
#define   DMAC_CRCCTRL_CRCPOLY_CRC32_Val      _UINT16_(0x1)                                        /* (DMAC_CRCCTRL) CRC32 (IEEE 802.3)  */
#define DMAC_CRCCTRL_CRCPOLY_CRC16            (DMAC_CRCCTRL_CRCPOLY_CRC16_Val << DMAC_CRCCTRL_CRCPOLY_Pos) /* (DMAC_CRCCTRL) CRC-16 (CRC-CCITT) Position  */
#define DMAC_CRCCTRL_CRCPOLY_CRC32            (DMAC_CRCCTRL_CRCPOLY_CRC32_Val << DMAC_CRCCTRL_CRCPOLY_Pos) /* (DMAC_CRCCTRL) CRC32 (IEEE 802.3) Position  */
#define DMAC_CRCCTRL_CRCSRC_Pos               _UINT16_(8)                                          /* (DMAC_CRCCTRL) CRC Input Source Position */
#define DMAC_CRCCTRL_CRCSRC_Msk               (_UINT16_(0x3F) << DMAC_CRCCTRL_CRCSRC_Pos)          /* (DMAC_CRCCTRL) CRC Input Source Mask */
#define DMAC_CRCCTRL_CRCSRC(value)            (DMAC_CRCCTRL_CRCSRC_Msk & (_UINT16_(value) << DMAC_CRCCTRL_CRCSRC_Pos)) /* Assigment of value for CRCSRC in the DMAC_CRCCTRL register */
#define   DMAC_CRCCTRL_CRCSRC_DISABLE_Val     _UINT16_(0x0)                                        /* (DMAC_CRCCTRL) CRC Disabled  */
#define   DMAC_CRCCTRL_CRCSRC_IO_Val          _UINT16_(0x1)                                        /* (DMAC_CRCCTRL) I/O interface  */
#define DMAC_CRCCTRL_CRCSRC_DISABLE           (DMAC_CRCCTRL_CRCSRC_DISABLE_Val << DMAC_CRCCTRL_CRCSRC_Pos) /* (DMAC_CRCCTRL) CRC Disabled Position  */
#define DMAC_CRCCTRL_CRCSRC_IO                (DMAC_CRCCTRL_CRCSRC_IO_Val << DMAC_CRCCTRL_CRCSRC_Pos) /* (DMAC_CRCCTRL) I/O interface Position  */
#define DMAC_CRCCTRL_CRCMODE_Pos              _UINT16_(14)                                         /* (DMAC_CRCCTRL) CRC Operating Mode Position */
#define DMAC_CRCCTRL_CRCMODE_Msk              (_UINT16_(0x3) << DMAC_CRCCTRL_CRCMODE_Pos)          /* (DMAC_CRCCTRL) CRC Operating Mode Mask */
#define DMAC_CRCCTRL_CRCMODE(value)           (DMAC_CRCCTRL_CRCMODE_Msk & (_UINT16_(value) << DMAC_CRCCTRL_CRCMODE_Pos)) /* Assigment of value for CRCMODE in the DMAC_CRCCTRL register */
#define   DMAC_CRCCTRL_CRCMODE_DEFAULT_Val    _UINT16_(0x0)                                        /* (DMAC_CRCCTRL) Default operating mode  */
#define   DMAC_CRCCTRL_CRCMODE_CRCMON_Val     _UINT16_(0x2)                                        /* (DMAC_CRCCTRL) Memory CRC monitor operating mode  */
#define   DMAC_CRCCTRL_CRCMODE_CRCGEN_Val     _UINT16_(0x3)                                        /* (DMAC_CRCCTRL) Memory CRC generation operating mode  */
#define DMAC_CRCCTRL_CRCMODE_DEFAULT          (DMAC_CRCCTRL_CRCMODE_DEFAULT_Val << DMAC_CRCCTRL_CRCMODE_Pos) /* (DMAC_CRCCTRL) Default operating mode Position  */
#define DMAC_CRCCTRL_CRCMODE_CRCMON           (DMAC_CRCCTRL_CRCMODE_CRCMON_Val << DMAC_CRCCTRL_CRCMODE_Pos) /* (DMAC_CRCCTRL) Memory CRC monitor operating mode Position  */
#define DMAC_CRCCTRL_CRCMODE_CRCGEN           (DMAC_CRCCTRL_CRCMODE_CRCGEN_Val << DMAC_CRCCTRL_CRCMODE_Pos) /* (DMAC_CRCCTRL) Memory CRC generation operating mode Position  */
#define DMAC_CRCCTRL_Msk                      _UINT16_(0xFF0F)                                     /* (DMAC_CRCCTRL) Register Mask  */


/* -------- DMAC_CRCDATAIN : (DMAC Offset: 0x04) (R/W 32) CRC Data Input -------- */
#define DMAC_CRCDATAIN_RESETVALUE             _UINT32_(0x00)                                       /*  (DMAC_CRCDATAIN) CRC Data Input  Reset Value */

#define DMAC_CRCDATAIN_CRCDATAIN_Pos          _UINT32_(0)                                          /* (DMAC_CRCDATAIN) CRC Data Input Position */
#define DMAC_CRCDATAIN_CRCDATAIN_Msk          (_UINT32_(0xFFFFFFFF) << DMAC_CRCDATAIN_CRCDATAIN_Pos) /* (DMAC_CRCDATAIN) CRC Data Input Mask */
#define DMAC_CRCDATAIN_CRCDATAIN(value)       (DMAC_CRCDATAIN_CRCDATAIN_Msk & (_UINT32_(value) << DMAC_CRCDATAIN_CRCDATAIN_Pos)) /* Assigment of value for CRCDATAIN in the DMAC_CRCDATAIN register */
#define DMAC_CRCDATAIN_Msk                    _UINT32_(0xFFFFFFFF)                                 /* (DMAC_CRCDATAIN) Register Mask  */


/* -------- DMAC_CRCCHKSUM : (DMAC Offset: 0x08) (R/W 32) CRC Checksum -------- */
#define DMAC_CRCCHKSUM_RESETVALUE             _UINT32_(0x00)                                       /*  (DMAC_CRCCHKSUM) CRC Checksum  Reset Value */

#define DMAC_CRCCHKSUM_CRCCHKSUM_Pos          _UINT32_(0)                                          /* (DMAC_CRCCHKSUM) CRC Checksum Position */
#define DMAC_CRCCHKSUM_CRCCHKSUM_Msk          (_UINT32_(0xFFFFFFFF) << DMAC_CRCCHKSUM_CRCCHKSUM_Pos) /* (DMAC_CRCCHKSUM) CRC Checksum Mask */
#define DMAC_CRCCHKSUM_CRCCHKSUM(value)       (DMAC_CRCCHKSUM_CRCCHKSUM_Msk & (_UINT32_(value) << DMAC_CRCCHKSUM_CRCCHKSUM_Pos)) /* Assigment of value for CRCCHKSUM in the DMAC_CRCCHKSUM register */
#define DMAC_CRCCHKSUM_Msk                    _UINT32_(0xFFFFFFFF)                                 /* (DMAC_CRCCHKSUM) Register Mask  */


/* -------- DMAC_CRCSTATUS : (DMAC Offset: 0x0C) (R/W 8) CRC Status -------- */
#define DMAC_CRCSTATUS_RESETVALUE             _UINT8_(0x00)                                        /*  (DMAC_CRCSTATUS) CRC Status  Reset Value */

#define DMAC_CRCSTATUS_CRCBUSY_Pos            _UINT8_(0)                                           /* (DMAC_CRCSTATUS) CRC Module Busy Position */
#define DMAC_CRCSTATUS_CRCBUSY_Msk            (_UINT8_(0x1) << DMAC_CRCSTATUS_CRCBUSY_Pos)         /* (DMAC_CRCSTATUS) CRC Module Busy Mask */
#define DMAC_CRCSTATUS_CRCBUSY(value)         (DMAC_CRCSTATUS_CRCBUSY_Msk & (_UINT8_(value) << DMAC_CRCSTATUS_CRCBUSY_Pos)) /* Assigment of value for CRCBUSY in the DMAC_CRCSTATUS register */
#define DMAC_CRCSTATUS_CRCZERO_Pos            _UINT8_(1)                                           /* (DMAC_CRCSTATUS) CRC Zero Position */
#define DMAC_CRCSTATUS_CRCZERO_Msk            (_UINT8_(0x1) << DMAC_CRCSTATUS_CRCZERO_Pos)         /* (DMAC_CRCSTATUS) CRC Zero Mask */
#define DMAC_CRCSTATUS_CRCZERO(value)         (DMAC_CRCSTATUS_CRCZERO_Msk & (_UINT8_(value) << DMAC_CRCSTATUS_CRCZERO_Pos)) /* Assigment of value for CRCZERO in the DMAC_CRCSTATUS register */
#define DMAC_CRCSTATUS_CRCERR_Pos             _UINT8_(2)                                           /* (DMAC_CRCSTATUS) CRC Error Position */
#define DMAC_CRCSTATUS_CRCERR_Msk             (_UINT8_(0x1) << DMAC_CRCSTATUS_CRCERR_Pos)          /* (DMAC_CRCSTATUS) CRC Error Mask */
#define DMAC_CRCSTATUS_CRCERR(value)          (DMAC_CRCSTATUS_CRCERR_Msk & (_UINT8_(value) << DMAC_CRCSTATUS_CRCERR_Pos)) /* Assigment of value for CRCERR in the DMAC_CRCSTATUS register */
#define DMAC_CRCSTATUS_Msk                    _UINT8_(0x07)                                        /* (DMAC_CRCSTATUS) Register Mask  */


/* -------- DMAC_DBGCTRL : (DMAC Offset: 0x0D) (R/W 8) Debug Control -------- */
#define DMAC_DBGCTRL_RESETVALUE               _UINT8_(0x00)                                        /*  (DMAC_DBGCTRL) Debug Control  Reset Value */

#define DMAC_DBGCTRL_DBGRUN_Pos               _UINT8_(0)                                           /* (DMAC_DBGCTRL) Debug Run Position */
#define DMAC_DBGCTRL_DBGRUN_Msk               (_UINT8_(0x1) << DMAC_DBGCTRL_DBGRUN_Pos)            /* (DMAC_DBGCTRL) Debug Run Mask */
#define DMAC_DBGCTRL_DBGRUN(value)            (DMAC_DBGCTRL_DBGRUN_Msk & (_UINT8_(value) << DMAC_DBGCTRL_DBGRUN_Pos)) /* Assigment of value for DBGRUN in the DMAC_DBGCTRL register */
#define DMAC_DBGCTRL_Msk                      _UINT8_(0x01)                                        /* (DMAC_DBGCTRL) Register Mask  */


/* -------- DMAC_SWTRIGCTRL : (DMAC Offset: 0x10) (R/W 32) Software Trigger Control -------- */
#define DMAC_SWTRIGCTRL_RESETVALUE            _UINT32_(0x00)                                       /*  (DMAC_SWTRIGCTRL) Software Trigger Control  Reset Value */

#define DMAC_SWTRIGCTRL_SWTRIG0_Pos           _UINT32_(0)                                          /* (DMAC_SWTRIGCTRL) Channel 0 Software Trigger Position */
#define DMAC_SWTRIGCTRL_SWTRIG0_Msk           (_UINT32_(0x1) << DMAC_SWTRIGCTRL_SWTRIG0_Pos)       /* (DMAC_SWTRIGCTRL) Channel 0 Software Trigger Mask */
#define DMAC_SWTRIGCTRL_SWTRIG0(value)        (DMAC_SWTRIGCTRL_SWTRIG0_Msk & (_UINT32_(value) << DMAC_SWTRIGCTRL_SWTRIG0_Pos)) /* Assigment of value for SWTRIG0 in the DMAC_SWTRIGCTRL register */
#define DMAC_SWTRIGCTRL_SWTRIG1_Pos           _UINT32_(1)                                          /* (DMAC_SWTRIGCTRL) Channel 1 Software Trigger Position */
#define DMAC_SWTRIGCTRL_SWTRIG1_Msk           (_UINT32_(0x1) << DMAC_SWTRIGCTRL_SWTRIG1_Pos)       /* (DMAC_SWTRIGCTRL) Channel 1 Software Trigger Mask */
#define DMAC_SWTRIGCTRL_SWTRIG1(value)        (DMAC_SWTRIGCTRL_SWTRIG1_Msk & (_UINT32_(value) << DMAC_SWTRIGCTRL_SWTRIG1_Pos)) /* Assigment of value for SWTRIG1 in the DMAC_SWTRIGCTRL register */
#define DMAC_SWTRIGCTRL_SWTRIG2_Pos           _UINT32_(2)                                          /* (DMAC_SWTRIGCTRL) Channel 2 Software Trigger Position */
#define DMAC_SWTRIGCTRL_SWTRIG2_Msk           (_UINT32_(0x1) << DMAC_SWTRIGCTRL_SWTRIG2_Pos)       /* (DMAC_SWTRIGCTRL) Channel 2 Software Trigger Mask */
#define DMAC_SWTRIGCTRL_SWTRIG2(value)        (DMAC_SWTRIGCTRL_SWTRIG2_Msk & (_UINT32_(value) << DMAC_SWTRIGCTRL_SWTRIG2_Pos)) /* Assigment of value for SWTRIG2 in the DMAC_SWTRIGCTRL register */
#define DMAC_SWTRIGCTRL_SWTRIG3_Pos           _UINT32_(3)                                          /* (DMAC_SWTRIGCTRL) Channel 3 Software Trigger Position */
#define DMAC_SWTRIGCTRL_SWTRIG3_Msk           (_UINT32_(0x1) << DMAC_SWTRIGCTRL_SWTRIG3_Pos)       /* (DMAC_SWTRIGCTRL) Channel 3 Software Trigger Mask */
#define DMAC_SWTRIGCTRL_SWTRIG3(value)        (DMAC_SWTRIGCTRL_SWTRIG3_Msk & (_UINT32_(value) << DMAC_SWTRIGCTRL_SWTRIG3_Pos)) /* Assigment of value for SWTRIG3 in the DMAC_SWTRIGCTRL register */
#define DMAC_SWTRIGCTRL_SWTRIG4_Pos           _UINT32_(4)                                          /* (DMAC_SWTRIGCTRL) Channel 4 Software Trigger Position */
#define DMAC_SWTRIGCTRL_SWTRIG4_Msk           (_UINT32_(0x1) << DMAC_SWTRIGCTRL_SWTRIG4_Pos)       /* (DMAC_SWTRIGCTRL) Channel 4 Software Trigger Mask */
#define DMAC_SWTRIGCTRL_SWTRIG4(value)        (DMAC_SWTRIGCTRL_SWTRIG4_Msk & (_UINT32_(value) << DMAC_SWTRIGCTRL_SWTRIG4_Pos)) /* Assigment of value for SWTRIG4 in the DMAC_SWTRIGCTRL register */
#define DMAC_SWTRIGCTRL_SWTRIG5_Pos           _UINT32_(5)                                          /* (DMAC_SWTRIGCTRL) Channel 5 Software Trigger Position */
#define DMAC_SWTRIGCTRL_SWTRIG5_Msk           (_UINT32_(0x1) << DMAC_SWTRIGCTRL_SWTRIG5_Pos)       /* (DMAC_SWTRIGCTRL) Channel 5 Software Trigger Mask */
#define DMAC_SWTRIGCTRL_SWTRIG5(value)        (DMAC_SWTRIGCTRL_SWTRIG5_Msk & (_UINT32_(value) << DMAC_SWTRIGCTRL_SWTRIG5_Pos)) /* Assigment of value for SWTRIG5 in the DMAC_SWTRIGCTRL register */
#define DMAC_SWTRIGCTRL_SWTRIG6_Pos           _UINT32_(6)                                          /* (DMAC_SWTRIGCTRL) Channel 6 Software Trigger Position */
#define DMAC_SWTRIGCTRL_SWTRIG6_Msk           (_UINT32_(0x1) << DMAC_SWTRIGCTRL_SWTRIG6_Pos)       /* (DMAC_SWTRIGCTRL) Channel 6 Software Trigger Mask */
#define DMAC_SWTRIGCTRL_SWTRIG6(value)        (DMAC_SWTRIGCTRL_SWTRIG6_Msk & (_UINT32_(value) << DMAC_SWTRIGCTRL_SWTRIG6_Pos)) /* Assigment of value for SWTRIG6 in the DMAC_SWTRIGCTRL register */
#define DMAC_SWTRIGCTRL_SWTRIG7_Pos           _UINT32_(7)                                          /* (DMAC_SWTRIGCTRL) Channel 7 Software Trigger Position */
#define DMAC_SWTRIGCTRL_SWTRIG7_Msk           (_UINT32_(0x1) << DMAC_SWTRIGCTRL_SWTRIG7_Pos)       /* (DMAC_SWTRIGCTRL) Channel 7 Software Trigger Mask */
#define DMAC_SWTRIGCTRL_SWTRIG7(value)        (DMAC_SWTRIGCTRL_SWTRIG7_Msk & (_UINT32_(value) << DMAC_SWTRIGCTRL_SWTRIG7_Pos)) /* Assigment of value for SWTRIG7 in the DMAC_SWTRIGCTRL register */
#define DMAC_SWTRIGCTRL_SWTRIG8_Pos           _UINT32_(8)                                          /* (DMAC_SWTRIGCTRL) Channel 8 Software Trigger Position */
#define DMAC_SWTRIGCTRL_SWTRIG8_Msk           (_UINT32_(0x1) << DMAC_SWTRIGCTRL_SWTRIG8_Pos)       /* (DMAC_SWTRIGCTRL) Channel 8 Software Trigger Mask */
#define DMAC_SWTRIGCTRL_SWTRIG8(value)        (DMAC_SWTRIGCTRL_SWTRIG8_Msk & (_UINT32_(value) << DMAC_SWTRIGCTRL_SWTRIG8_Pos)) /* Assigment of value for SWTRIG8 in the DMAC_SWTRIGCTRL register */
#define DMAC_SWTRIGCTRL_SWTRIG9_Pos           _UINT32_(9)                                          /* (DMAC_SWTRIGCTRL) Channel 9 Software Trigger Position */
#define DMAC_SWTRIGCTRL_SWTRIG9_Msk           (_UINT32_(0x1) << DMAC_SWTRIGCTRL_SWTRIG9_Pos)       /* (DMAC_SWTRIGCTRL) Channel 9 Software Trigger Mask */
#define DMAC_SWTRIGCTRL_SWTRIG9(value)        (DMAC_SWTRIGCTRL_SWTRIG9_Msk & (_UINT32_(value) << DMAC_SWTRIGCTRL_SWTRIG9_Pos)) /* Assigment of value for SWTRIG9 in the DMAC_SWTRIGCTRL register */
#define DMAC_SWTRIGCTRL_SWTRIG10_Pos          _UINT32_(10)                                         /* (DMAC_SWTRIGCTRL) Channel 10 Software Trigger Position */
#define DMAC_SWTRIGCTRL_SWTRIG10_Msk          (_UINT32_(0x1) << DMAC_SWTRIGCTRL_SWTRIG10_Pos)      /* (DMAC_SWTRIGCTRL) Channel 10 Software Trigger Mask */
#define DMAC_SWTRIGCTRL_SWTRIG10(value)       (DMAC_SWTRIGCTRL_SWTRIG10_Msk & (_UINT32_(value) << DMAC_SWTRIGCTRL_SWTRIG10_Pos)) /* Assigment of value for SWTRIG10 in the DMAC_SWTRIGCTRL register */
#define DMAC_SWTRIGCTRL_SWTRIG11_Pos          _UINT32_(11)                                         /* (DMAC_SWTRIGCTRL) Channel 11 Software Trigger Position */
#define DMAC_SWTRIGCTRL_SWTRIG11_Msk          (_UINT32_(0x1) << DMAC_SWTRIGCTRL_SWTRIG11_Pos)      /* (DMAC_SWTRIGCTRL) Channel 11 Software Trigger Mask */
#define DMAC_SWTRIGCTRL_SWTRIG11(value)       (DMAC_SWTRIGCTRL_SWTRIG11_Msk & (_UINT32_(value) << DMAC_SWTRIGCTRL_SWTRIG11_Pos)) /* Assigment of value for SWTRIG11 in the DMAC_SWTRIGCTRL register */
#define DMAC_SWTRIGCTRL_SWTRIG12_Pos          _UINT32_(12)                                         /* (DMAC_SWTRIGCTRL) Channel 12 Software Trigger Position */
#define DMAC_SWTRIGCTRL_SWTRIG12_Msk          (_UINT32_(0x1) << DMAC_SWTRIGCTRL_SWTRIG12_Pos)      /* (DMAC_SWTRIGCTRL) Channel 12 Software Trigger Mask */
#define DMAC_SWTRIGCTRL_SWTRIG12(value)       (DMAC_SWTRIGCTRL_SWTRIG12_Msk & (_UINT32_(value) << DMAC_SWTRIGCTRL_SWTRIG12_Pos)) /* Assigment of value for SWTRIG12 in the DMAC_SWTRIGCTRL register */
#define DMAC_SWTRIGCTRL_SWTRIG13_Pos          _UINT32_(13)                                         /* (DMAC_SWTRIGCTRL) Channel 13 Software Trigger Position */
#define DMAC_SWTRIGCTRL_SWTRIG13_Msk          (_UINT32_(0x1) << DMAC_SWTRIGCTRL_SWTRIG13_Pos)      /* (DMAC_SWTRIGCTRL) Channel 13 Software Trigger Mask */
#define DMAC_SWTRIGCTRL_SWTRIG13(value)       (DMAC_SWTRIGCTRL_SWTRIG13_Msk & (_UINT32_(value) << DMAC_SWTRIGCTRL_SWTRIG13_Pos)) /* Assigment of value for SWTRIG13 in the DMAC_SWTRIGCTRL register */
#define DMAC_SWTRIGCTRL_SWTRIG14_Pos          _UINT32_(14)                                         /* (DMAC_SWTRIGCTRL) Channel 14 Software Trigger Position */
#define DMAC_SWTRIGCTRL_SWTRIG14_Msk          (_UINT32_(0x1) << DMAC_SWTRIGCTRL_SWTRIG14_Pos)      /* (DMAC_SWTRIGCTRL) Channel 14 Software Trigger Mask */
#define DMAC_SWTRIGCTRL_SWTRIG14(value)       (DMAC_SWTRIGCTRL_SWTRIG14_Msk & (_UINT32_(value) << DMAC_SWTRIGCTRL_SWTRIG14_Pos)) /* Assigment of value for SWTRIG14 in the DMAC_SWTRIGCTRL register */
#define DMAC_SWTRIGCTRL_SWTRIG15_Pos          _UINT32_(15)                                         /* (DMAC_SWTRIGCTRL) Channel 15 Software Trigger Position */
#define DMAC_SWTRIGCTRL_SWTRIG15_Msk          (_UINT32_(0x1) << DMAC_SWTRIGCTRL_SWTRIG15_Pos)      /* (DMAC_SWTRIGCTRL) Channel 15 Software Trigger Mask */
#define DMAC_SWTRIGCTRL_SWTRIG15(value)       (DMAC_SWTRIGCTRL_SWTRIG15_Msk & (_UINT32_(value) << DMAC_SWTRIGCTRL_SWTRIG15_Pos)) /* Assigment of value for SWTRIG15 in the DMAC_SWTRIGCTRL register */
#define DMAC_SWTRIGCTRL_Msk                   _UINT32_(0x0000FFFF)                                 /* (DMAC_SWTRIGCTRL) Register Mask  */

#define DMAC_SWTRIGCTRL_SWTRIG_Pos            _UINT32_(0)                                          /* (DMAC_SWTRIGCTRL Position) Channel x5 Software Trigger */
#define DMAC_SWTRIGCTRL_SWTRIG_Msk            (_UINT32_(0xFFFF) << DMAC_SWTRIGCTRL_SWTRIG_Pos)     /* (DMAC_SWTRIGCTRL Mask) SWTRIG */
#define DMAC_SWTRIGCTRL_SWTRIG(value)         (DMAC_SWTRIGCTRL_SWTRIG_Msk & (_UINT32_(value) << DMAC_SWTRIGCTRL_SWTRIG_Pos)) 

/* -------- DMAC_PRICTRL0 : (DMAC Offset: 0x14) (R/W 32) Priority Control 0 -------- */
#define DMAC_PRICTRL0_RESETVALUE              _UINT32_(0x40404040)                                 /*  (DMAC_PRICTRL0) Priority Control 0  Reset Value */
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
