nsaspook/wbz451matter/src/packs/WBZ451_DFP/component/dsu.h

/*
 * Component description for DSU
 *
 * Copyright (c) 2023 Microchip Technology Inc. and its subsidiaries.
 *
 * Licensed under the Apache License, Version 2.0 (the "License");
 * you may not use this file except in compliance with the License.
 * You may obtain a copy of the License at
 *
 *   http://www.apache.org/licenses/LICENSE-2.0
 *
 * Unless required by applicable law or agreed to in writing, software
 * distributed under the License is distributed on an "AS IS" BASIS,
 * WITHOUT WARRANTIES OR CONDITIONS OF ANY KIND, either express or implied.
 * See the License for the specific language governing permissions and
 * limitations under the License.
 *
 */

/* file generated from device description file (ATDF) version 2023-10-17T09:04:59Z */
#ifndef _BZ45_DSU_COMPONENT_H_
#define _BZ45_DSU_COMPONENT_H_

/* ************************************************************************** */
/*   SOFTWARE API DEFINITION FOR DSU                                          */
/* ************************************************************************** */

/* -------- DSU_CTRL : (DSU Offset: 0x00) ( /W 8) Control -------- */
#define DSU_CTRL_RESETVALUE                   _UINT8_(0x00)                                        /*  (DSU_CTRL) Control  Reset Value */

#define DSU_CTRL_SWRST_Pos                    _UINT8_(0)                                           /* (DSU_CTRL) Software Reset Position */
#define DSU_CTRL_SWRST_Msk                    (_UINT8_(0x1) << DSU_CTRL_SWRST_Pos)                 /* (DSU_CTRL) Software Reset Mask */
#define DSU_CTRL_SWRST(value)                 (DSU_CTRL_SWRST_Msk & (_UINT8_(value) << DSU_CTRL_SWRST_Pos)) /* Assigment of value for SWRST in the DSU_CTRL register */
#define DSU_CTRL_CRC_Pos                      _UINT8_(2)                                           /* (DSU_CTRL) 32-bit Cyclic Redundancy Code Position */
#define DSU_CTRL_CRC_Msk                      (_UINT8_(0x1) << DSU_CTRL_CRC_Pos)                   /* (DSU_CTRL) 32-bit Cyclic Redundancy Code Mask */
#define DSU_CTRL_CRC(value)                   (DSU_CTRL_CRC_Msk & (_UINT8_(value) << DSU_CTRL_CRC_Pos)) /* Assigment of value for CRC in the DSU_CTRL register */
#define DSU_CTRL_MBIST_Pos                    _UINT8_(3)                                           /* (DSU_CTRL) Memory built-in self-test Position */
#define DSU_CTRL_MBIST_Msk                    (_UINT8_(0x1) << DSU_CTRL_MBIST_Pos)                 /* (DSU_CTRL) Memory built-in self-test Mask */
#define DSU_CTRL_MBIST(value)                 (DSU_CTRL_MBIST_Msk & (_UINT8_(value) << DSU_CTRL_MBIST_Pos)) /* Assigment of value for MBIST in the DSU_CTRL register */
#define DSU_CTRL_CE_Pos                       _UINT8_(4)                                           /* (DSU_CTRL) Chip-Erase Position */
#define DSU_CTRL_CE_Msk                       (_UINT8_(0x1) << DSU_CTRL_CE_Pos)                    /* (DSU_CTRL) Chip-Erase Mask */
#define DSU_CTRL_CE(value)                    (DSU_CTRL_CE_Msk & (_UINT8_(value) << DSU_CTRL_CE_Pos)) /* Assigment of value for CE in the DSU_CTRL register */
#define DSU_CTRL_ARR_Pos                      _UINT8_(6)                                           /* (DSU_CTRL) Auxiliary Row Read Position */
#define DSU_CTRL_ARR_Msk                      (_UINT8_(0x1) << DSU_CTRL_ARR_Pos)                   /* (DSU_CTRL) Auxiliary Row Read Mask */
#define DSU_CTRL_ARR(value)                   (DSU_CTRL_ARR_Msk & (_UINT8_(value) << DSU_CTRL_ARR_Pos)) /* Assigment of value for ARR in the DSU_CTRL register */
#define DSU_CTRL_SMSA_Pos                     _UINT8_(7)                                           /* (DSU_CTRL) Start Memory Stream Access Position */
#define DSU_CTRL_SMSA_Msk                     (_UINT8_(0x1) << DSU_CTRL_SMSA_Pos)                  /* (DSU_CTRL) Start Memory Stream Access Mask */
#define DSU_CTRL_SMSA(value)                  (DSU_CTRL_SMSA_Msk & (_UINT8_(value) << DSU_CTRL_SMSA_Pos)) /* Assigment of value for SMSA in the DSU_CTRL register */
#define DSU_CTRL_Msk                          _UINT8_(0xDD)                                        /* (DSU_CTRL) Register Mask  */


/* -------- DSU_STATUSA : (DSU Offset: 0x01) (R/W 8) Status A -------- */
#define DSU_STATUSA_RESETVALUE                _UINT8_(0x00)                                        /*  (DSU_STATUSA) Status A  Reset Value */
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
