nsaspook/wbz451matter/src/packs/WBZ451_DFP/wbz451.h

/*
 * Header file for WBZ451
 *
 * Copyright (c) 2023 Microchip Technology Inc. and its subsidiaries.
 *
 * Licensed under the Apache License, Version 2.0 (the "License");
 * you may not use this file except in compliance with the License.
 * You may obtain a copy of the License at
 *
 *   http://www.apache.org/licenses/LICENSE-2.0
 *
 * Unless required by applicable law or agreed to in writing, software
 * distributed under the License is distributed on an "AS IS" BASIS,
 * WITHOUT WARRANTIES OR CONDITIONS OF ANY KIND, either express or implied.
 * See the License for the specific language governing permissions and
 * limitations under the License.
 *
 */

/* File generated from device description file (ATDF) version 2023-10-17T09:04:59Z */
#ifndef _WBZ451_H_
#define _WBZ451_H_

/* Header version uses Semantic Versioning 2.0.0 (https://semver.org/) */
#define HEADER_FORMAT_VERSION "2.1.1"

#define HEADER_FORMAT_VERSION_MAJOR (2)
#define HEADER_FORMAT_VERSION_MINOR (1)
#define HEADER_FORMAT_VERSION_PATCH (1)

/* WBZ451 definitions
  This file defines all structures and symbols for WBZ451:
    - registers and bitfields
    - peripheral base address
    - peripheral ID
    - PIO definitions
*/

#ifdef __cplusplus
 extern "C" {
#endif

#if !(defined(__ASSEMBLER__) || defined(__IAR_SYSTEMS_ASM__))
#  include <stdint.h>
#endif /* !(defined(__ASSEMBLER__) || defined(__IAR_SYSTEMS_ASM__)) */

#if !defined(SKIP_INTEGER_LITERALS)
#  if defined(_UINT8_) || defined(_UINT16_) || defined(_UINT32_)
#    error "Integer constant value macros already defined elsewhere"
#  endif

#if !(defined(__ASSEMBLER__) || defined(__IAR_SYSTEMS_ASM__))
/* Macros that deal with sizes of integer constants for C/C++ */
#  define _UINT8_(x)   ((uint8_t)(x))    /* C code: 8-bits unsigned integer constant value */
#  define _UINT16_(x)  ((uint16_t)(x))   /* C code: 16-bits unsigned integer constant value */
#  define _UINT32_(x)  ((uint32_t)(x))   /* C code: 32-bits unsigned integer constant value */

#else /* Assembler */
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
