nsaspook/wbz451matter/(notices)

Notices in the files:
parts and their libraries:
2024-05-29_22-27-45_Library: COPYRIGHT: Copyright (C) 2024 Ultra Librarian. All rights reserved.
